KlaussMarchi/MRU/Documents/Inertial Labs/InertialLabs_KERNEL-120/Cable Drawing/ReadMe.txt

Please email the serial number of your device to support@inertiallabs to receive the pinout and cable driving.
