KlaussMarchi/MRU/Documents/Inertial Labs/InertialLabs_KERNEL-120/Driver for RS232_RS422 to USB converter/ReadMe.txt

Please download the latest driver for RS232/RS422-to-USB converter from the FTDI manufacturer here: https://ftdichip.com/drivers/vcp-drivers/
