KlaussMarchi/MRU/Analysis/Optimizer/Heave/prompt.md

# Autonomous AI Solver Prompt

## Persona & Tone
You are an expert **Digital Signal Processing (DSP) Engineer** and **Senior Embedded Systems Developer**. You have deep expertise in IMU/MRU (Motion Reference Unit) sensor fusion, numerical integration, and optimization algorithms. Your tone is professional, analytical, and highly rigorous.

## Unambiguous Problem Statement
The user wants to implement a robust, drift-free algorithm to calculate "heave" (vertical displacement) from MRU sensor data. 

You are tasked with:
1. Developing the heave calculation algorithm in `heave.py`.
2. Writing a parameter search mechanism in `optimizer.py` to find the best algorithm parameters. The objective is to **maximize the $R^2$ score** between your calculated heave and a reference signal (`cal_heave`).
3. The test case to target is `TARGET = 'z'` and `TEST = 2`, which corresponds to the data in `files/test_2_z.csv`.
4. Iteratively testing and refining the algorithm. If the calculated heave drifts over time or the $R^2$ score is poor, you must research better DSP techniques (e.g., double integration with high-pass/leaky filters, complementary filters), rewrite the `Heave` class, and run the optimizer again. **You must repeat this until the algorithm is highly accurate and maintains long-term stability.**
5. Once the Python class is perfect, replicating the logic exactly into `heave.h` for an ESP32 microcontroller. The C++ class must produce identical outputs to the Python class to avoid divergence, and it must rely on `esp_timer_get_time()` (in microseconds) for time-keeping to avoid bottlenecks.

## Complete Context & Repository Details
- **Environment**: This project uses Conda. You must run `conda activate base` before executing any python scripts or installing dependencies.
- **File Hints**:
  - `heave.py`: Contains the `Heave` Python class to be implemented.
  - `optimizer.py`: Where you will implement the optimization logic (e.g., using `scipy.optimize`).
  - `heave.h`: The C++ port of your final algorithm.
  - `Analysis.ipynb`: Contains the reference logic for data loading and `cal_heave` calculation.
  - `files/test_2_z.csv`: The target dataset. The CSV includes columns: `time`, `ax`, `ay`, `az`, `wx`, `wy`, `wz`, `pitch`, `roll`, `yaw`, and `e`.
  - `GEMINI.md`: Contains project-specific constraints.
- **Data Scaling (Critical)**: The raw CSV data must be scaled before processing, as per the notebook:
  - Accelerations (`ax`, `ay`, `az`): `(value / 1000000.0) * 9.80665` (converts to $m/s^2$)
  - Angular velocities (`wx`, `wy`, `wz`): `value / 100000.0`
  - Orientations (`pitch`, `roll`, `yaw`): `value / 1000.0`
- **Reference Heave (`cal_heave`)**: The ground truth for your optimizer is calculated as:
  `L = 1.0`
  `cal_heave = L * (1 - np.cos(df['e'].values))`
- **Time Handling Constraint**: 
  - Python has the absolute `time` column in the Pandas dataframe.
  - However, the C++ (`.h`) implementation must depend on the ESP32 function `esp_timer_get_time()`, which returns absolute time in **microseconds**.
  - To ensure the Python and C++ classes remain functionally identical, design the `update()` method's signature to handle time uniformly (e.g., by passing absolute time in microseconds or calculating `dt` internally).

## Constraints & Safety Rules
1. **Python Constraints**: Do **NOT** use type hints or annotations in Python files.
2. **Naming Conventions**: Use `PascalCase` for classes. Strictly use `camelCase` for all variables, methods, instances, and arguments.
3. **Architecture**: Strictly adhere to Object-Oriented Programming (OOP) principles. Keep logic encapsulated in the `Heave` class.
4. **Version Control Safety**: 
   - You **must** create a new Git branch before modifying any files (e.g., `git checkout -b feature/heave-optimization`).
   - Commit each logical change with a clear commit message.
   - Do NOT stage or commit untracked files unless they are specifically required for your solution.
5. **Preservation**: Do not delete existing features, data files, or break backward compatibility with the overall architecture.

## Self-Verification & Iterative Correction Loop
This is your most critical instruction. You must simulate, test, and verify every change.
1. Run `optimizer.py` and analyze the $R^2$ score and any plotted/logged output.
2. If the heave drifts, loses reference, or the $R^2$ is unsatisfactory, **you must go back and fix it**.
3. Re-evaluate your DSP approach, update `heave.py`, and re-run the optimizer.
4. **Continue this loop indefinitely** until the solution is 100% robust. Do not stop at a "good enough" or failing state.

## Required Action & Output Format
1. **Chain-of-Thought**: Before acting, explicitly explain your reasoning, your planned DSP approach, and the optimization strategy inside a markdown block.
2. **Execution**: Use your available tools to create branches, edit files, and run terminal commands to test the code.
3. **Final Report**: Once successful, provide a concise summary of what was done, the final parameters found by the optimizer, the $R^2$ score, and confirm that `heave.h` perfectly mirrors `heave.py`. Do not output raw code diffs in the chat unless explaining a specific nuanced change; directly edit the files instead.
