KlaussMarchi/MRU/Hardware/Embedded/Main/README.html

Ir para o conteúdo

M MRU Documentação técnica

Navegar pelas seções

Neste documento

Continue a leituraPipeline de calibração ↗

Firmware · processamento embarcado

# Firmware do MRU · ESP32-S3

Este firmware recebe as medições do Kernel-120, aplica os ajustes produzidos pela calibração e transmite orientação, aceleração, giro e movimento vertical por USB, RS232 ou RS422. O ponto de entrada é Main.ino, que identifica a versão atual como v1.0.7.

Imprimir / salvar PDF Abrir Markdown Pipeline de calibração ↗

O pipeline de calibração escolhe filtros e ajusta modelos no computador. Aqui, o ESP32 executa esses modelos sobre as novas amostras, usando os parâmetros compilados em config.h.

## Visão geral

Kernel-120 → UART1 → decodificação → escala → filtros → correção → atitude → heave → braço
                                                                                     │
                                                                                     ▼
                                                                          JSON · LIST · NMEA
                                                                                     │
                                                                                     ▼
                                                                            USB · RS232 · RS422

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

## Estrutura de arquivos

Main/
├── Main.ino                         ← setup() e loop() do Arduino
├── device/
│   ├── index.h                     ← reúne e inicializa os módulos
│   ├── settings/index.h            ← configurações persistentes
│   └── tasks/index.h               ← laços de processamento e comunicação
├── globals/
│   ├── constants.h                 ← números que identificam modos e protocolos
│   └── functions.h                 ← função de exemplo, sem papel na cadeia de medição
├── objects/
│   ├── sensors/
│   │   ├── index.h                 ← gerencia o sensor
│   │   └── Kernel/
│   │       ├── index.h             ← conexão, configuração e recepção do Kernel
│   │       ├── HR/index.h          ← pacote de alta resolução
│   │       ├── quat/index.h        ← pacote de quaternion
│   │       └── orient/index.h      ← pacote de orientação
│   ├── processing/
│   │   ├── index.h                 ← executa a sequência de cálculo
│   │   ├── filters/                ← passa-baixa de cada eixo
│   │   ├── correction/             ← matriz, viés e temperatura
│   │   ├── align/                  ← adapta a correção ao align atual
│   │   ├── attitude/
│   │   │   ├── config.h            ← seleciona o modelo compilado
│   │   │   ├── kalman/             ← fusão de acelerômetro e giroscópio
│   │   │   ├── linear/             ← correção linear dos ângulos do Kernel
│   │   │   └── machine/            ← regressão sobre uma janela de sensores
│   │   ├── heave/                  ← movimento vertical do sensor
│   │   └── lever/                  ← movimento vertical no ponto de interesse
│   ├── telemetry/
│   │   ├── index.h                 ← coordena comandos, respostas e transmissão
│   │   ├── serial/index.h          ← portas USB, RS232 e RS422
│   │   ├── protocol/index.h        ← interpretação dos comandos
│   │   └── streamer/index.h        ← formato e cadência das amostras transmitidas
│   ├── components/                 ← LEDs e encoder
│   └── updater/index.h             ← atualização do firmware pela serial
├── utils/                          ← texto, JSON, relógios e estruturas auxiliares
└── build/                          ← artefatos de compilação, quando gerados

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

## O que acontece ao ligar

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

## Como uma amostra atravessa o firmware

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

### 1 · Kernel — conexão, pacote e escala

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

O firmware também lê os três ângulos de Alignment_Angles. Para aplicar mudanças persistentes do Kernel, siga o procedimento de desligar e ligar o MRU descrito no guia geral; reiniciar somente o ESP32 não corta a alimentação do sensor.

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

### 2 · Filters — aplicar os filtros escolhidos na calibração

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

### 3 · Correction e Align — corrigir a leitura no referencial certo

correction/index.h aplica, separadamente ao acelerômetro e ao giroscópio:

x_corrigido = M·x + c + k·(T−T0)

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

### 4 · Attitude — o modelo escolhido em tempo de compilação

objects/processing/attitude/config.h inclui um modelo e define o apelido AttitudeModel. Na configuração atual, ele seleciona KalmanModel. Para trocar de estratégia, exporte a desejada no pipeline de calibração e recompile.

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

### 5 · Heave — aceleração vertical para deslocamento

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

### 6 · Lever — movimento no ponto de interesse

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

### 7 · Telemetria — origem, formato e frequência

Há três seleções independentes:

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

## Campos transmitidos

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

O formato chamado NMEA no código contém quatro campos:

$GPPASHR,pitch,roll,yaw,heave*checksum

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

## Portas, comandos e configurações

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

Comando | Efeito
$stream_start! / $stream_stop! | Inicia ou interrompe a transmissão.
$settings! | Mostra as configurações persistidas.
ID:chave$ | Consulta um valor salvo; resposta no formato $valor!.
CF:chave$valor! | Salva uma configuração e reinicia o ESP32.
$calibrate! | Informa o processamento ativo; não executa uma nova calibração.
$check_sensor! | Informa OK ou NOT WORKING, conforme o estado do driver.
$firmware! | Informa a versão.
$align:N! | Grava no Kernel o preset de montagem N e reinicia os estados do processamento.
MICRS | Reinicia o ESP32.
$ERASE! | Restaura configurações padrão e reinicia.
updt | Entra no recebimento de uma atualização de firmware.

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

O exemplo escolhe LIST a 10 Hz. Os comandos CF: alteram a operação; os coeficientes de calibração continuam vindo dos config.h.

## Montagem e presets de align

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

Escolha o preset correspondente à montagem física, desligue e ligue o MRU e confira a linha Kernel Align no boot. O guia de instalação descreve as posições e os sentidos dos eixos. A referência do ensaio deve estar registrada em Calibration/Dataset/testN/info.json antes de exportar Correction.

## Parâmetros que vêm da calibração

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

Uma nova exportação substitui esses arquivos. Recompile e grave o firmware para usar os novos parâmetros. Na instalação, confira principalmente HEAVE_PERIOD, KALMAN_LEVER e LEVER_POINT: os valores ajustados na mesa descrevem aquele ensaio e sua geometria.

## Compilação e gravação

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

No boot, confira modo do dispositivo, baud e modo do Kernel, align, modelo de processamento e modo do Streamer. O README geral reúne a configuração de placa e o procedimento operacional do projeto.

## Componentes, utilitários e atualização

Arquivo/pasta | Papel
components/leds/index.h | Controla os tempos ligado/desligado dos LEDs. LED 1 alterna a cada 0,5 s com Kernel funcionando; LED 2 alterna a cada 0,2 s com stream ativo.
components/encoder/ | Conta pulsos por interrupção e converte para ângulo. Está desabilitado no Main.ino; seus pinos 10/11 são usados pelo RS232.
utils/time/ e utils/listener/ | Fornecem relógios e verificações periódicas sem usar um atraso fixo em cada iteração.
utils/text/ | Buffers de texto usados na leitura e interpretação dos comandos.
utils/json/ | Serialização com ArduinoJson e persistência com Preferences.
utils/array/ | Vetor circular, estatísticas e persistência auxiliares. Não executa a filtragem principal.
utils/notes/ | Utilitário de arquivos em LittleFS, sem integração na cadeia ativa de Device.
objects/updater/index.h | Recebe o binário codificado em base64 pela porta ativa e o grava com a biblioteca Update.

O atualizador começa com updt, responde __STARTING_UPDATE__ e espera blocos no formato $base64!. Cada escrita produz __WRITTEN__; dez segundos sem dados encerram a recepção, e uma finalização bem-sucedida reinicia o ESP32. É uma transferência serial, sem etapa de download pela rede.

## Comportamentos importantes para interpretar os resultados

- As tarefas compartilham o estado mais recente. A implementação não possui uma fila de amostras entre recepção, processamento e transmissão. Se várias amostras chegarem antes do consumo, estados intermediários podem não ser processados ou enviados; aquisição não constitui garantia de gravação sem perdas.
- As lacunas recebem tratamentos diferentes. O Kalman limita o passo de propagação e aumenta a incerteza de inclinação quando o intervalo supera três períodos nominais; Heave e Lever reiniciam suas seções acima de 0,5 s.
- O estado working não é um teste de atualização contínua. O driver o altera ao decodificar pacotes, mas o silêncio da UART não o limpa por tempo de inatividade. $check_sensor! e LED 1 devem ser interpretados junto com a chegada de novas amostras.
- O código atual não inclui a etapa de relatório NORMAM do diagrama antigo. A cadeia entrega medições e movimento no ponto de interesse; a avaliação e o certificado descritos no pipeline ficam no computador.

MRU / Hardware/Embedded/Main Voltar ao início ↑
