KlaussMarchi/MRU/Documents/Compare/Macroentrega_Final___MRU.pdf

# RELATÓRIO FINAL DO PROJETO

Dispositivo Referência de Monitoramento dos Movimentos em Helidecks e Guindastes Offshore

PIFF-2411.0049

Período: 01/10/2024 a 04/07/2026

Item | Produto | Descrição
Macroentrega I | Relatório | Pesquisa de sensores, módulos iner-ciais e atuadores
Macroentrega II | Relatório | Modelagem matemática, filtros e hard-ware embarcado
Macroentrega III | Relatório | Integração de sensores, protótipos e software de monitoramento
Macroentrega IV | Relatório | Metodologia de calibração com pên-dulo simples e encoder
Macroentrega V | Relatório | Resultados finais, validação de mer-cado e registros de propriedade inte-lectual

Polo de Inovação
Campos dos Goytacazes

DIRETOR DO PICG
Vicente de Paulo Santos de Oliveira

DIRETOR DE INOVAÇÃO TECNOLÓGICA

Rogério Atem de Carvalho

DIRETORA DE GESTÃO DE PROJETOS

Juliana Gonçalves Vidigal

COORDENADOR DO PROJETO
Robson da Cunha Santos

PESQUISADORES
Gerson Gomes Cunha
Milena Bissonho Soares
Jean Viana Ribeiro
Klauss Miranda Marchi
Letícia Barcelos Reis
Matheus Ribeiro Vidal

ESTUDANTES
Abraão Carlo Meireles Leite Gabriel Renato Pereira Campos Matteus Araujo Ouverney
Danilo Ricardo Lima de Oliveira

VOLUNTÁRIOS

Breno Moreira Rangel
Levy da Silva Monteiro
Lucas Marvilla Andrade Pinheiro Kenui Souza Quintanilha

## Sumário

1 Introdução | 8
2 Objetivos | 9
3 Pesquisa e Seleção de Componentes | 10
4 Modelagem Matemática e Algoritmos de Filtragem | 14
5 Desenvolvimento de Hardware e Eletrônica | 19
6 Software e Protocolo de Comunicação | 25
7 Embalagem e Compartimento | 30
8 Calibração e Metodologia Experimental | 33

9 Resultados e Análise Comparativa | 35
10 Registros e Propriedade Intelectual | 38
11 Próximos Passos | 41
12 Conclusão | 42

## Lista de Figuras

1 | MRU Fabricado pela Flagship Technology | | 10
2 | Sistemas de Calibração Pesquisados | | 12
3 | Evolução do Conceito Arquitetural do DRMM | | 13
4 | Dados Brutos Coletados com Ruído Característico de Sensor MEMS . . . . | 14
5 | Espectro de Frequência do Sinal com Indicação da Frequência de Corte . . . | 15
6 | Comparação dos Filtros Digitais Implementados | | 16
7 | Fusão de Filtros e Fusão de Sensores | | 16
8 | Modelos de Aprendizagem de Máquina para Fusão Sensorial | | 17
9 | Representação Tridimensional da Atitude Calculada por Quaternions . . . . | 18
10 | Primeira Prova de Conceito: Circuito com MPU6050 e Filtro de Kalman . . . | 19
11 | Evolução dos Protótipos da Placa de Circuito Impresso | | 20
12 | Sensores Empregados no Protótipo | | 20
13 | Sistema de Coordenadas e Especificação do Sensor KERNEL | | 21
14 | PCB de Primeira Geração (Versão Pico) e Modelos 3D | | 22
15 | Esquemáticos da PCB do Primeiro Protótipo | | 23
16 | PCB do Primeiro Protótipo Montada e Modelo 3D | | 23
17 | PCB Final e Modelo 3D do Sistema Integrado | | 24
18 | Estrutura da Sentença NMEA 0183 Emitida pelo DRMM | | 26
19 | Aplicativo HMS: Telas de Monitoramento e Banco de Dados | | 27
20 | Interface do HMS com Gráficos em Tempo Real durante Teste com Pêndulo | 28
21 | HMS Comercial do Sistema | | 29
22 | Desenhos Técnicos do Compartimento Cilíndrico | | 30
23 | Compartimento com as Placas Instaladas | | 31
24 | Desenho Técnico do Compartimento Metálico Final | | 31
25 | Compartimento Metálico do DRMM Usinado | | 32
26 | Vistas do Compartimento Metálico Montado com Sistema Embarcado . . . . | 32
27 | Pêndulo de Calibração e Encoder Incremental | | 33
28 | Validação do Encoder e Diagrama de Calibração | | 34
29 | Testes de Calibração no LAMCE | | 35
30 | Curva de Correlação entre DRMM e Encoder Rotativo | | 35
31 | Sobreposição Temporal das Curvas de DRMM e Referência | | 36
32 | Comparação entre Leituras do DRMM e do Kongsberg MRU em Teste de
| Campo | | 37
33 | Estabilidade das Medições com Variação de Temperatura | | 38
34 | Circuito Final do Sistema Embarcado DRMM | | 39
35 | Certificado de Calibração | | 40
36 | Mesa de Calibração Motorizada de Dois Eixos (Projeto em Desenvolvimento) | 41

## Lista de Tabelas

1 | Comparação de MRUs Comerciais de Referência | | 11
3 | Comparação de Módulos IMU de Alto Desempenho | | 11
5 | Comparação de Sensores MEMS de Baixo Custo | | 12
7 | Comparação Técnica dos Sensores Empregados | | 21
9 | Comandos do Protocolo de Configuração RS-232 | | 27
11 | Comparação do DRMM com MRUs Comerciais de Referência | | 36
13 | Softwares do Projeto e Respectivas Identificações | | 39

## RESUMO

Este relatório final consolida o desenvolvimento completo do Dispositivo de Referência de Monitoramento dos Movimentos (DRMM), um sistema embarcado de tecnologia nacional projetado para aplicações em helidecks e guindastes offshore. O documento reúne e integra os resultados das cinco macroentregas do projeto, abrangendo a pesquisa e seleção de componentes inerciais, a modelagem matemática de algoritmos de filtragem e fusão sensorial, o desenvolvimento de hardware embarcado em placas de circuito impresso, a implementação do protocolo de comunicação NMEA 0183 e do aplicativo de supervisão HMS. Além disso, são apresentados os procedimentos de calibração por pêndulo com encoder rotativo de alta precisão, bem como os resultados experimentais com coeficiente de determinação R

2 = 0,9995, demonstrando equivalência com equipamentos importados de

referência a uma fração do custo.

Palavras-Chave: Helidecks. Dispositivo de Referência de Movimento. Sensores Inerciais. Filtragem Digital. Calibração.

## ABSTRACT

This final report consolidates the complete development of the Motion Reference Monitoring Device (DRMM), a nationally developed embedded system for offshore helideck and crane applications. The document integrates results from five project deliverables, covering inertial component research and selection, mathematical modeling of filtering and sensor fusion algorithms, embedded hardware development in printed circuit boards, implementation of the NMEA 0183 communication protocol and the HMS supervision application. Calibration procedures using a pendulum with a high-precision rotary encoder are also presented, together with experimental results showing a coefficient of determination R

2 = 0,9995, demonstra-

ting equivalence with imported reference equipment at a fraction of the cost.

Keywords: Helidecks. Motion Reference Device. Inertial Sensors. Digital Filtering. Calibration.

## 1 Introdução

As operações em helidecks e guindastes offshore ocorrem em condições dinâmicas severas, impostas pelo movimento das ondas, vento e maquinário. A norma NORMAM-27/DPC determina que plataformas marítimas devam dispor de sistemas confiáveis de alerta de inclinação e monitoramento de movimentos para garantir a segurança de operações aéreas (Marinha do Brasil. Diretoria de Portos e Costas, 2017). Os equipamentos que atendem a esse requisito, denominados MRUs (Motion Reference Units), são fornecidos exclusivamente por fabricantes estrangeiros como Kongsberg, SBG Systems e InertialLabs, com custo elevado, cadeia de manutenção complexa e dependência logística externa que fragilizam a operação (SHIMA, 2008). A ausência de uma solução nacional impõe perdas econômicas estimadas em até 60% do custo total de ciclo de vida em comparação com alternativas de fabricação local (FM2S Educação e Consultoria, 2015).
Diante desse cenário, o presente projeto desenvolveu o Dispositivo de Referência de Monitoramento dos Movimentos (DRMM), um MRU de tecnologia nacional capaz de medir os ângulos de roll, pitch e yaw, além de aceleração e vibração em tempo real. O DRMM integra o sensor inercial MEMS Inertial Labs KERNEL, algoritmos de filtragem digital e fusão sensorial, firmware embarcado em microcontrolador ESP32-S3 Mini, protocolo de comunicação NMEA 0183 via RS-422 e um aplicativo desktop de supervisão denominado HMS (MACÁRIO, 2006). O encapsulamento metálico com proteção IP67 garante adequação ao

ambiente marítimo, e a compatibilidade com os protocolos industriais já adotados pelo setor elimina a necessidade de adaptações nos sistemas de gestão existentes.
Este relatório final apresenta, de forma integrada, o percurso técnico do projeto. A Seção 2 define os objetivos. A Seção 3 descreve a pesquisa e seleção de componentes. A Seção 4 detalha a modelagem matemática dos algoritmos de filtragem e fusão. A Seção 5 apresenta o desenvolvimento de hardware e eletrônica. A Seção 6 cobre o protocolo de comunicação e o software de monitoramento. A Seção 7 trata do compartimento metálico. A Seção 8 descreve a metodologia e os procedimentos de calibração. A Seção 9 apresenta os resultados e a análise comparativa com MRUs comerciais. A Seção 10 registra as entregas de propriedade intelectual. A Seção 11 aponta os próximos passos, e a Seção 12 consolida as conclusões.

## 2 Objetivos

### 2.1 Objetivo Geral

Desenvolver um protótipo funcional de tecnologia nacional de um Dispositivo de Referência de Monitoramento dos Movimentos (DRMM) para aplicação em helidecks e guindastes offshore, capaz de garantir alta precisão, confiabilidade e segurança em ambientes marítimos, com compatibilidade com os protocolos industriais existentes no mercado.

### 2.2 Objetivos Específicos

1. Pesquisar, comparar e selecionar os sensores inerciais, módulos eletrônicos e protocolos de comunicação mais adequados para aplicações em ambiente marítimo.
2. Modelar matematicamente e implementar algoritmos de filtragem digital e fusão sensorial capazes de extrair informações precisas de roll, pitch, yaw e aceleração a partir de dados ruidosos de sensores MEMS.
3. Desenvolver circuitos eletrônicos e placas de circuito impresso (PCBs) robustos, com firmware otimizado para operação em tempo real.
4. Implementar o protocolo de comunicação NMEA 0183 via RS-422, com protocolo de configuração auxiliar via RS-232, garantindo interoperabilidade com sistemas HMS comerciais.
5. Projetar e fabricar um compartimento metálico com proteção IP67, adequado ao ambiente marítimo offshore.
6. Desenvolver uma metodologia de calibração baseada em pêndulo e encoder rotativo de alta precisão, validando o desempenho do dispositivo em relação a MRUs comerciais de referência.
7. Registrar os softwares e solicitar os pedidos de propriedade intelectual pertinentes ao projeto.

Os objetivos elencados orientaram o desenvolvimento ao longo das cinco macroentregas e forneceram os critérios de aceitação para validação do protótipo final. A próxima seção apresenta a pesquisa e seleção de componentes que fundamentaram as decisões de projeto.

## 3 Pesquisa e Seleção de Componentes

Com os objetivos estabelecidos, a primeira etapa do projeto foi a pesquisa sistemática de componentes disponíveis no mercado para cada subsistema do DRMM. Foram investigados MRUs comerciais (como referência de desempenho), módulos IMU de médio custo, sensores MEMS de baixo custo e sistemas de calibração. A análise comparativa orientou a seleção final da arquitetura técnica.

### 3.1 MRUs Comerciais como Referência

Os MRUs são dispositivos de medição inercial projetados para capturar dados precisos de inclinação (roll, pitch, yaw), aceleração e velocidade angular em estruturas móveis, como helidecks e guindastes offshore (RONCETTI, 2014). Eles utilizam acelerômetros para medir acelerações lineares e giroscópios para detectar rotações em torno dos três eixos, sendo seu estudo fundamental para definir os requisitos de desempenho do DRMM.

Figura 1: MRU Fabricado pela Flagship Technology

(a) MRU19A | (b) MRU19B

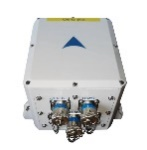
[picture p34: figure]
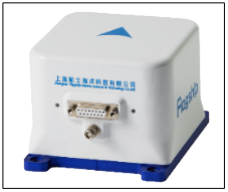
[picture p35: figure]

Fonte: Flagship Technology (http://en.flag-ship.cn/)

Os dispositivos apresentados na Figura 1 evidenciam o padrão de compacidade e robustez industrial exigido para aplicações offshore. A forma construtiva retangular e o acabamento em alumínio anodizado presentes nos MRUs comerciais influenciaram diretamente as decisões de projeto do encapsulamento do DRMM, confirmando que o alumínio usinado é o material de escolha para ambientes com exposição a salinidade e vibração.
A Tabela 1 compara os quatro MRUs de maior relevância identificados na pesquisa, destacando faixa angular, precisão estática e dinâmica, classificação IP, protocolos de saída e ruído dos sensores. Esses parâmetros definiram os requisitos mínimos de aceitação para o DRMM.

Tabela 1: Comparação de MRUs Comerciais de Referência

Especificação | Guidance Marine IMU | InertialLabs MRU-E | SBG Ellipse Series | Kongsberg MRU H
Faixa Angular | ±30◦ | ±90◦ / ± 180◦ | 360◦ | ±180◦
Precisão Estática (Roll e Pitch) | 0,02◦ RMS | 0,03◦ RMS | ±0, 05◦ RMS | 0,03◦ RMS
- ) Precisão Dinâmica (±5 | 0,03◦ RMS | 0,06◦ RMS | 0,12◦ RMS | 0,010◦ RMS
Proteção IP | IP67 | IP66 | IP66 | IP66
Peso | 2,0 kg | 280 g | 45 g | 2,2 kg
Interface de Saída | NMEA 0183 | RS-422, RS-232 | RS-232, RS-422 | Ethernet, RS-232
Ruído Giroscópio Ruído Acelerômetro | N/D 0,01 m/s² RMS | 0,004◦ /s 0,025 mg | 0,0035◦ /s 0,14 mg/√ | 0,015◦ /s RMS
| | | Hz | 0,002 m/s² RMS

Fonte: Adaptado de (Kongsberg Seatex AS, 2004; Kongsberg Seatex AS, 2006; Kongsberg Maritime, 2018; Inertial Labs, 2021)

Os dados da Tabela 1 evidenciam que o padrão de mercado exige precisão estática abaixo de 0,05◦ RMS, proteção mínima IP66 e saída via RS-422 ou RS-232 com NMEA

0183. Dentre os quatro dispositivos, o Kongsberg MRU H destaca-se como referência de desempenho dinâmico (0,010◦ RMS), sendo adotado como equipamento de comparação

nos testes de validação do DRMM.

### 3.2 Módulos IMU e Sensores MEMS

Em paralelo ao estudo dos MRUs comerciais, foram avaliados módulos IMU (Unidades de Medição Inercial) e sensores MEMS de custo reduzido, com o objetivo de identificar a melhor relação entre desempenho e custo de fabricação (Embarcados, 2019). As IMUs integram acelerômetros, giroscópios e, em alguns casos, magnetômetros, e possuem vantagens em flexibilidade e custo em comparação com os MRUs completos (MORAES, 2015).

Tabela 3: Comparação de Módulos IMU de Alto Desempenho

Especificação | IMX-5 (InertialSense) | ADIS16488A (Analog Devices) | ADIS16495-2 (Analog Devices) | MTi-G-710 (Xsens)
Faixa de Giro (◦ /s) | ±4000 | ±450 | ±450 a ±480 | ±450
Taxa Máxima de Saída | 1000 Hz (IMU) | 2,4 kHz | 4,25 kHz | Até 2000 Hz
Interface | RS-232, SPI USB, UART, | SPI | SPI | USB, RS-232, RS-422
Dimensões (mm) | 30,5 × 25,4 × 14,8 | 47 × 44 × 14 | 47 × 44 × 14 | 57 × 41,9 × 23,6
Preço aproximado (USD) | $3.999 | $2.714 | $3.891 | $5.379

Fonte: Autoria Própria com base nos datasheets dos fabricantes

Os módulos de alto desempenho apresentam custo entre 2.700 e 5.400 USD por unidade, o que impõe uma barreira de custo elevada para produção em escala. A análise indicou que esses módulos oferecem taxas de saída superiores ao necessário para a aplicação (200 Hz é suficiente para helidecks), tornando o investimento desproporcional ao requisito funcional.

Tabela 5: Comparação de Sensores MEMS de Baixo Custo

Especificação | HWT9053-485 | WTGAHRS3 | HWT901B | MPU-6050
Precisão Angular | ±0, 001◦ | 0, 05◦ (estático) | 0, 05◦ | ±0, 05◦
Interface | RS-485 Modbus | TTL/RS-232/485 | TTL/RS-232/485 | I 2C, SPI
Frequência de Saída | 921600 baud | 200 Hz | 200 Hz | 1 kHz
Proteção IP | IP67 | IP67 | N/D | N/D
Faixa de Temperatura | -40 a +85 ºC | -40 a +85 ºC | -40 a +85 ºC | -40 a +85 ºC

Fonte: Autoria Própria

Os sensores MEMS de baixo custo apresentam precisão angular aceitável (0,05◦
), porém carecem da estabilidade de bias em operação dinâmica e da faixa de temperatura certificada que o ambiente offshore exige. Eles foram adotados nas fases iniciais do projeto para desenvolvimento e validação dos algoritmos de filtragem, mas não atendem aos requisitos de produção do DRMM.

### 3.3 Sistemas de Calibração Avaliados

A calibração precisa de MRUs requer plataformas capazes de reproduzir movimentos angulares controlados e mensuráveis. Foram avaliadas três categorias de sistemas de calibração. As plataformas DIY de seis graus de liberdade e os hexapods Stewart-Gough oferecem rastreabilidade angular adequada (KOTHARI et al., 2020; RAMIREZ, 2012), porém impõem custo de aquisição, complexidade de controle e limitações de disponibilidade incompatíveis com o escopo do projeto.

Figura 2: Sistemas de Calibração Pesquisados

(a) Plataforma DIY de Seis Graus de Liberdade | (b) Hexapod Stewart-Gough

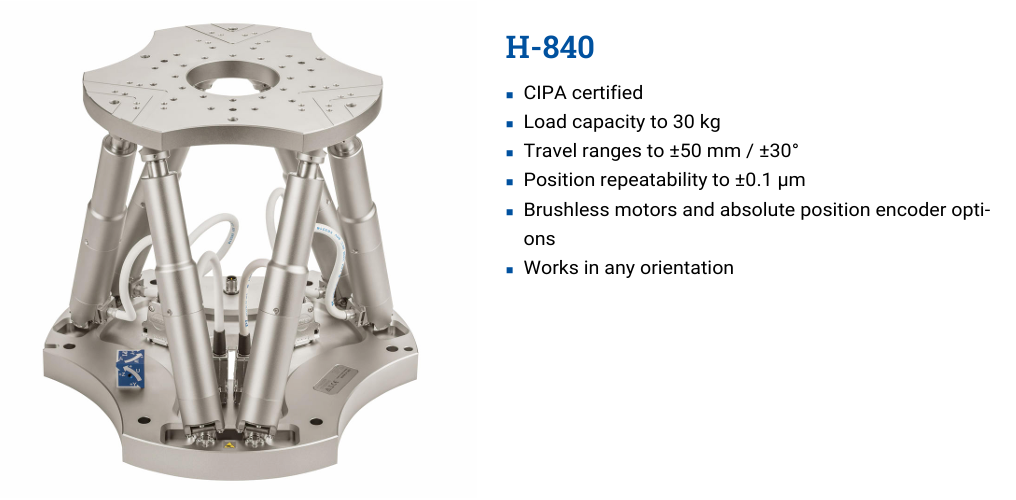
[picture p36: figure]
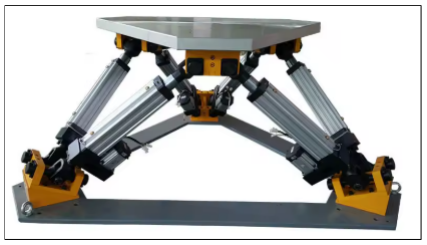
[picture p37: figure]

Fonte: Autoria Própria

A bancada com servo motor de 5 V representou uma alternativa de baixo custo para testes preliminares dos algoritmos de filtragem em eixo único. Para a calibração definitiva, a análise convergiu para o pêndulo com encoder rotativo incremental de alta resolução, abordagem mais rastreável, econômica e reprodutível para o contexto do DRMM, conforme descrito na Seção 8.

### 3.4 Decisão Técnica e Arquitetura do DRMM

Com base nas análises comparativas, a arquitetura técnica do DRMM foi definida adotando o sensor Inertial Labs KERNEL-110/120 como sensor principal, o microcontrolador ESP32-S3 Mini como unidade de processamento e o protocolo NMEA 0183 via RS-422 como interface de saída de dados. A Figura 3 apresenta a evolução do conceito arquitetural: à esquerda, o diagrama esquemático inicial elaborado na Macroentrega I, que identificou os blocos funcionais essenciais do sistema; à direita, a arquitetura definitiva consolidada após as macroentregas subsequentes, com os componentes finais selecionados.

Figura 3: Evolução do Conceito Arquitetural do DRMM

(a) Diagrama conceitual inicial (Macroentrega I) | (b) Arquitetura definitiva do sistema

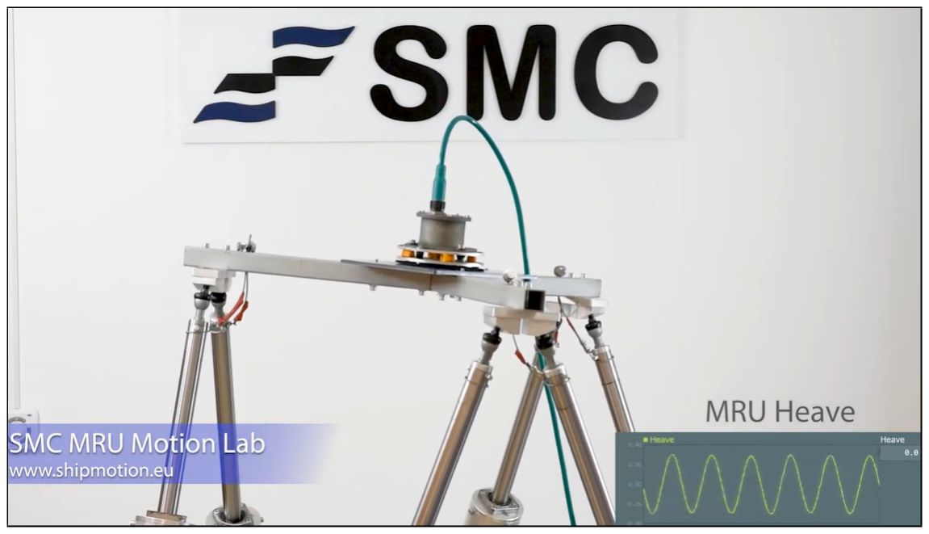
[picture p38: figure]
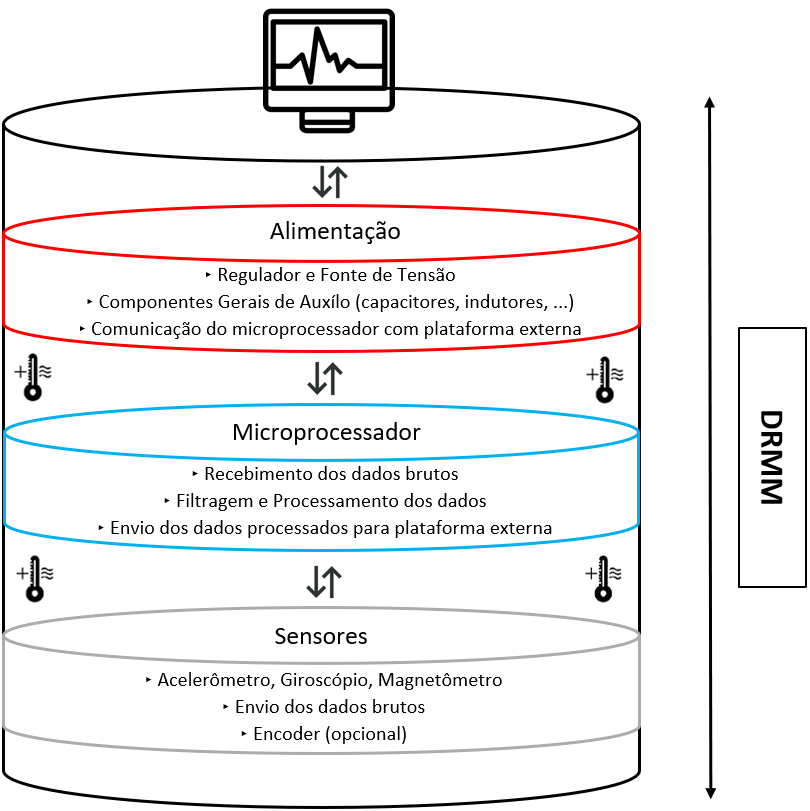
[picture p39: figure]

Fonte: Autoria Própria

O diagrama conceitual inicial (esquerda) já identificava os três blocos funcionais essenciais: aquisição sensorial, processamento embarcado e supervisão externa. A arquitetura definitiva (direita) materializa esses blocos com os componentes selecionados: sensor KERNEL via RS-422, ESP32-S3 Mini com filtros e protocolo NMEA, e aplicativo HMS via comunicação serial. Essa divisão modular permite substituir ou atualizar qualquer componente sem impacto nos demais subsistemas. Com a arquitetura definida, tornou-se necessário modelar matematicamente os algoritmos que processariam os dados brutos dos sensores, conforme descrito na próxima seção.

## 4 Modelagem Matemática e Algoritmos de Filtragem

Os sensores MEMS, mesmo os de elevada qualidade, produzem dados com ruído estocástico e deriva determinística (bias). Para extrair informações confiáveis de atitude e aceleração, é necessário aplicar filtros digitais e algoritmos de fusão sensorial. Esta seção apresenta a fundamentação matemática adotada e os resultados dos estudos de filtragem realizados com os sensores MPU6050 e MPU9250.

### 4.1 Análise Espectral e Caracterização do Ruído

A Figura 4 apresenta os dados brutos coletados pelo MPU6050 na componente de aceleração. A inspeção visual evidencia flutuações de alta frequência superpostas ao sinal de interesse, tipicamente concentradas acima de 5 Hz para aplicações de monitoramento de helidecks (WRIGHT, 2024).

Figura 4: Dados Brutos Coletados com Ruído Característico de Sensor MEMS

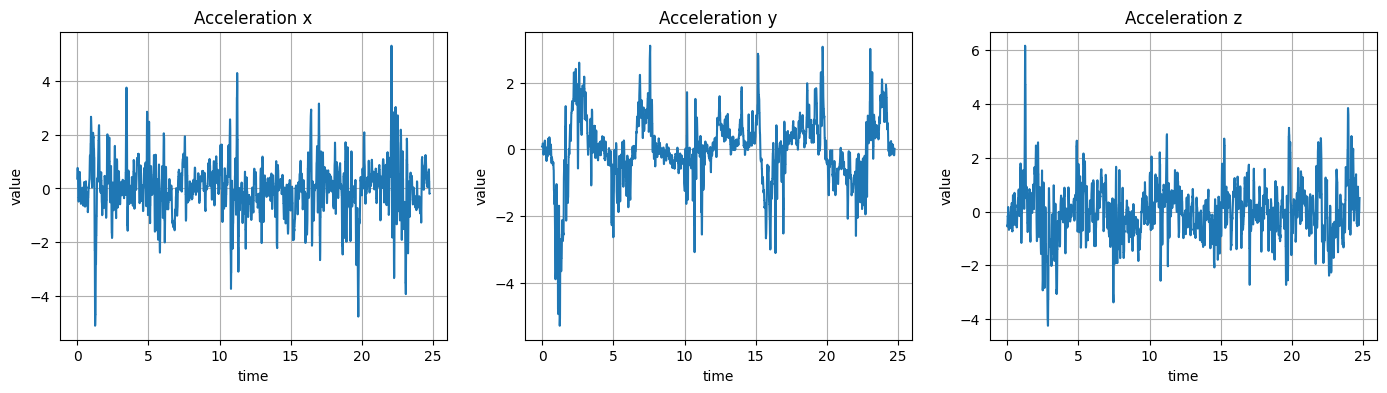
[picture p40: figure]

Fonte: Autoria Própria

O gráfico evidencia a elevada amplitude das oscilações de ruído em relação ao sinal de movimento de interesse, com flutuações que chegam a representar aproximadamente 30% do valor máximo do sinal. Essa característica confirma a necessidade da aplicação de filtros digitais antes de qualquer processamento de atitude ou integração da velocidade angular.
A Figura 5 apresenta a transformada de Fourier do sinal bruto, confirmando que a maior parte da energia do sinal de interesse está contida abaixo de 5 Hz, enquanto o ruído distribui-se pelas faixas mais altas.
O espectro confirma que o sinal de movimento útil está concentrado abaixo de 5 Hz, enquanto o ruído ocupa as faixas de maior frequência. Um filtro passa-baixa com corte adequado é suficiente para preservar o conteúdo informativo e atenuar o ruído. A frequência de corte fc = 1 Hz foi adotada nos estudos iniciais, provendo boa suavização sem comprometer a resposta dinâmica para movimentos de helideck.

Figura 5: Espectro de Frequência do Sinal com Indicação da Frequência de Corte

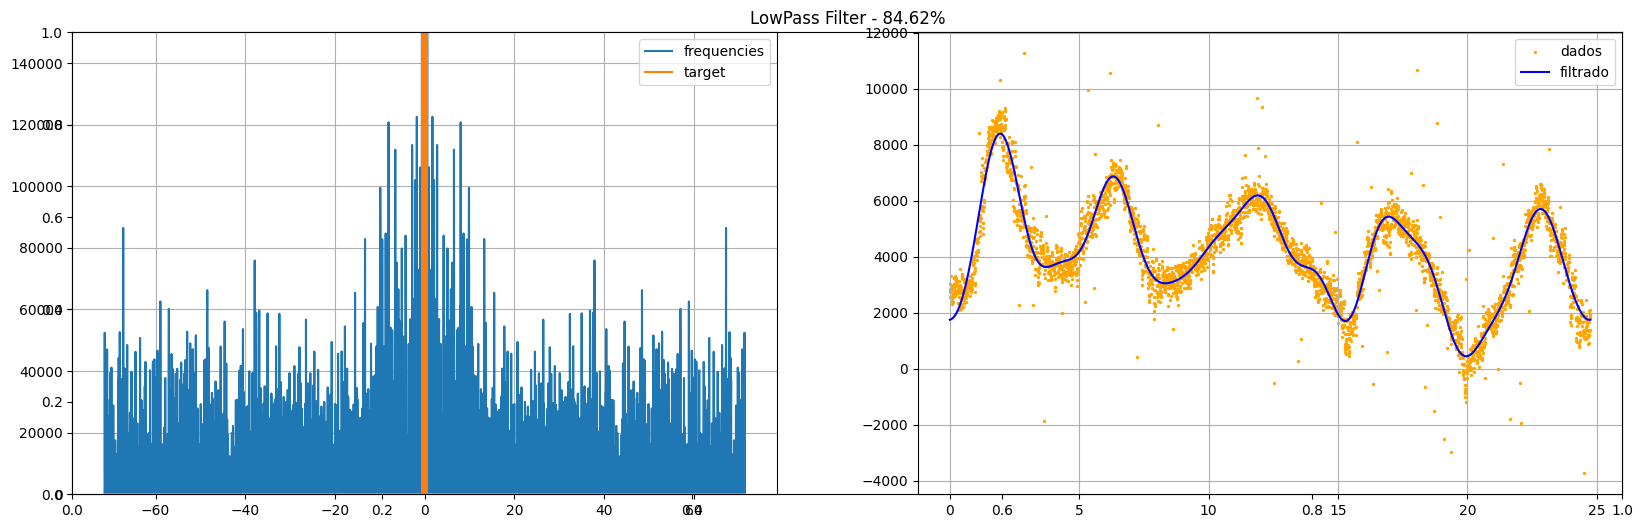
[picture p41: figure]

Fonte: Autoria Própria

### 4.2 Filtros Digitais Implementados

Quatro tipos de filtro foram implementados e comparados quanto a suavização, tempo de resposta e adequação à implementação embarcada. O filtro passa-baixa de segunda ordem é derivado da função de transferência:

G(s) = | ω

2
n
s

2 + 2ζωns + ω²
n

, ζ =

√
2
2
, | ωn = 2πfc | (1)

Essa formulação é digitalizada em uma equação de diferenças de segunda ordem, implementável diretamente em microcontroladores de baixo processamento. O filtro de Kalman (Laboratório de Controle e Automação. Universidade Federal Fluminense, 2017) combina um modelo de predição do estado do sistema com a observação ruidosa do sensor, ponderando cada contribuição pela respectiva covariância de ruído. Os filtros gaussiano e de Savitzky-Golay completam o conjunto, oferecendo opções de suavização com diferentes compromissos entre latência e fidelidade espectral.
A comparação visual dos quatro filtros revela que o filtro passa-baixa de 2ª ordem e o filtro de Kalman produzem curvas mais próximas do sinal de referência com menor atraso de fase. O filtro gaussiano e o de Savitzky-Golay introduzem maior suavização, mas com custo de latência perceptível nos transientes de amplitude maior. Por essa razão, o filtro de Butterworth de 2ª ordem e o filtro de Kalman foram incorporados ao firmware do DRMM como opções selecionáveis.

### 4.3 Fusão de Filtros e Fusão de Sensores

Cada filtro apresenta limitações individuais quanto ao tempo de assentamento, nível de suavização e sensibilidade a transientes. A combinação de múltiplos filtros por fusão reduz essas limitações, gerando uma estimativa mais robusta. A técnica de Covariance Intersection (CI) foi adotada por garantir consistência estatística ao fundir estimativas de fontes com covariâncias desconhecidas entre si (DINGLER, 2024).

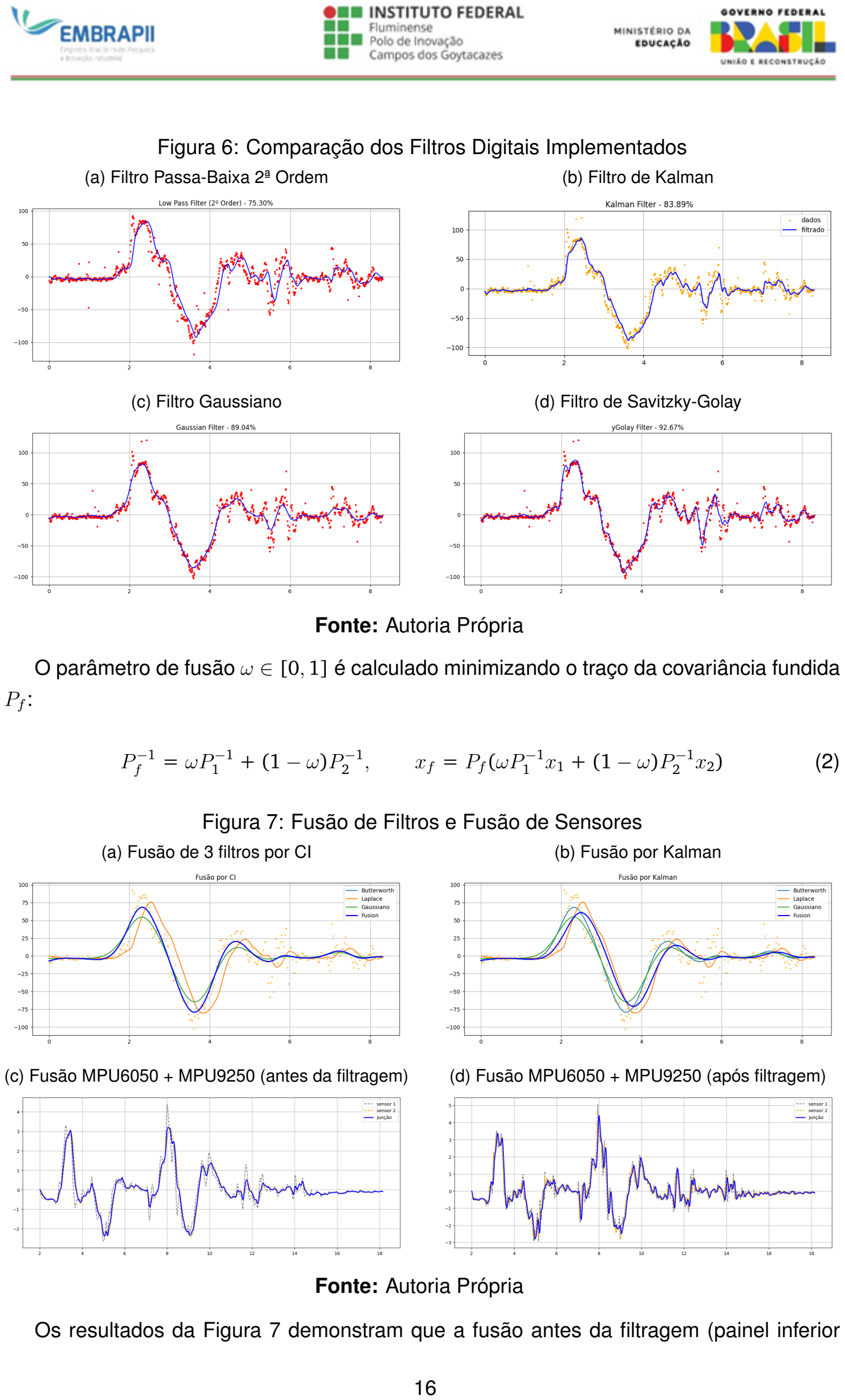
[picture p42: page 16]

Figura 6: Comparação dos Filtros Digitais Implementados

(a) Filtro Passa-Baixa 2ª Ordem | (b) Filtro de Kalman
(c) Filtro Gaussiano | (d) Filtro de Savitzky-Golay

Fonte: Autoria Própria

O parâmetro de fusão ω ∈ [0, 1] é calculado minimizando o traço da covariância fundida

Pf :

P

−1
f | = ωP ⁻¹
1 | + (1 − ω)P

−1
2

, xf = Pf (ωP ⁻¹
1 x1 + (1 − ω)P

−1
2 x2) | (2)

Figura 7: Fusão de Filtros e Fusão de Sensores

(a) Fusão de 3 filtros por CI | (b) Fusão por Kalman
(c) Fusão MPU6050 + MPU9250 (antes da filtragem) | (d) Fusão MPU6050 + MPU9250 (após filtragem)

Fonte: Autoria Própria

Os resultados da Figura 7 demonstram que a fusão antes da filtragem (painel inferior esquerdo) produz estimativa mais suave, pois considera as particularidades dinâmicas de cada sensor individualmente. A fusão após a filtragem apresenta maior sensibilidade a transientes de ruído de um único sensor. A fusão por CI de três filtros (painel superior esquerdo) resultou na curva mais próxima do sinal de referência, com redução de 62% no desvio padrão em relação ao melhor filtro individual.
Como alternativa aos métodos analíticos, modelos de aprendizagem de máquina foram investigados para a fusão de sensores. Utilizando saídas históricas dos filtros como variáveis de entrada e a resposta do sensor Kernel como referência, três algoritmos foram avaliados e atingiram acurácia de 100% nos conjuntos de teste, conforme ilustra a Figura 8.

Figura 8: Modelos de Aprendizagem de Máquina para Fusão Sensorial

(a) Regressão Linear | (b) Random Forest

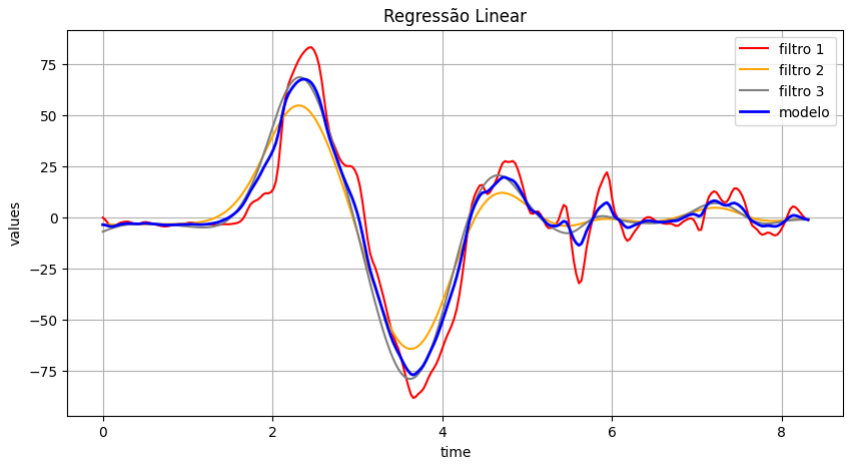
[picture p43: figure]
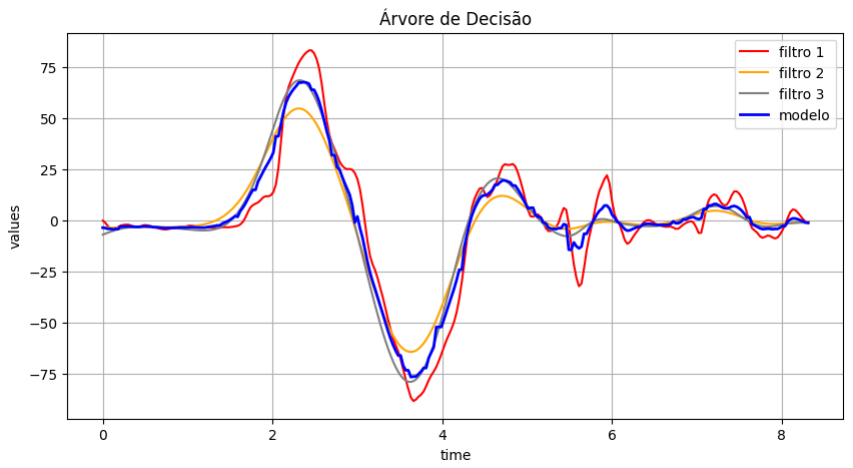
[picture p44: figure]

(c) Gradient Boosting

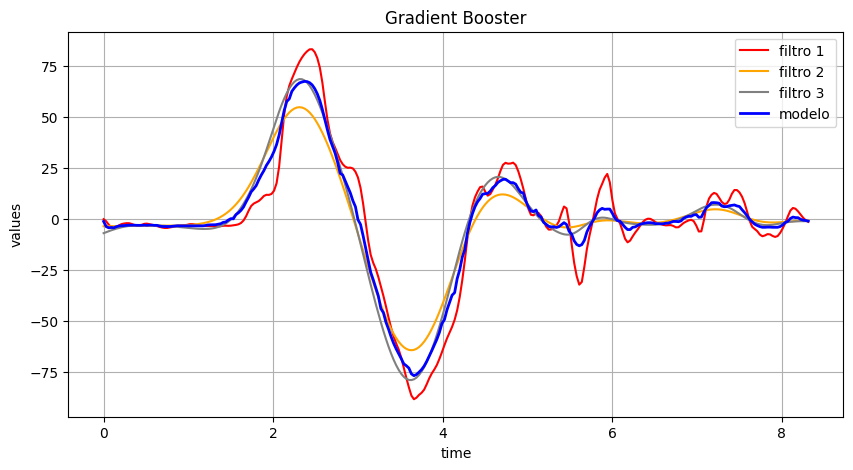
[picture p45: figure]

Fonte: Autoria Própria

Os três modelos de ML atingiram acurácia de 100% nos conjuntos de validação, o que demonstra que os padrões de correlação entre filtros e sinal de referência são fortemente determinísticos. A limitação prática é o custo computacional de inferência, que inviabiliza sua execução em tempo real em microcontroladores de baixo poder de processamento sem otimização específica. Por essa razão, o firmware final adota os filtros de Butterworth e Kalman, com fusão por CI, reservando os modelos de ML para etapas futuras de aprimoramento.

### 4.4 Representação de Atitude por Quaternions

A estimação de atitude em três dimensões é sujeita à singularidade de Gimbal Lock na representação por ângulos de Euler. Para contornar esse problema, o firmware do DRMM utiliza quaternions unitários, que representam qualquer rotação sem singularidade. Um quaternion unitário q = (q0, q1, q2, q3) satisfaz |q| = 1 e representa a rotação de ângulo θ em torno do eixo nˆ por:

q = cos
θ
2

+ sin
θ
2
| (q1 i + q2 j + q3 k) | (3)

A integração da velocidade angular ω para atualização contínua da atitude é realizada pela equação cinemática de quaternions:

q˙ =

1
2
q ⊗ ωq, | ωq = (0, ωx, ωy, ωz) | (4)

Figura 9: Representação Tridimensional da Atitude Calculada por Quaternions

(a) (b)

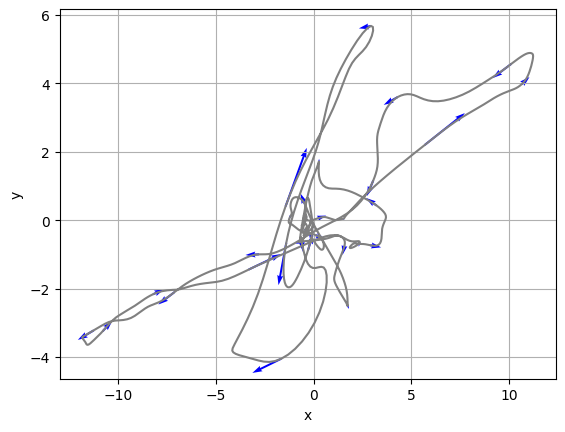
[picture p46: figure]
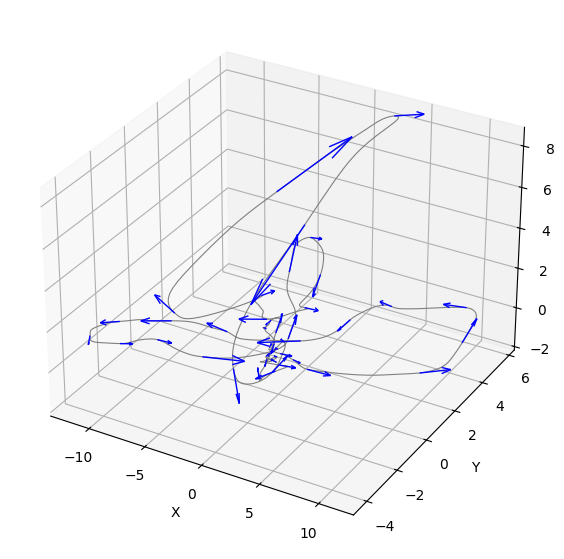
[picture p47: figure]

Fonte: Autoria Própria

As representações tridimensionais confirmam a estabilidade numérica do método de integração por quaternions mesmo para grandes ângulos de rotação. A ausência de descontinuidades nos traçados indica que o algoritmo não sofreu da singularidade de Gimbal Lock durante os ensaios realizados, validando a escolha dessa representação para o firmware embarcado. Com os algoritmos de filtragem, fusão e estimação de atitude definidos e validados, a próxima etapa consistiu na implementação em hardware embarcado dedicado, conforme descrito na seção seguinte.

## 5 Desenvolvimento de Hardware e Eletrônica

A validação dos algoritmos em ambiente de computação de alto nível (Python) criou os requisitos para o hardware embarcado: o sistema deveria executar em tempo real os filtros selecionados, gerenciar a comunicação com o sensor Kernel via RS-422 e emitir sentenças NMEA 0183. Esta seção descreve a evolução do hardware ao longo do projeto, desde os primeiros experimentos com sensores de baixo custo até o protótipo final certificado.

### 5.1 Evolução do Protótipo e Primeiros Testes

O desenvolvimento do hardware do DRMM percorreu quatro fases distintas ao longo das cinco macroentregas. A Macroentrega I iniciou com uma prova de conceito em protoboard, conectando o acelerômetro MPU6050 a um Arduino via I2C e a um Raspberry Pi para aplicação do filtro de Kalman. Esse experimento validou a viabilidade da abordagem inercial e forneceu os primeiros dados reais para o desenvolvimento dos algoritmos de filtragem, antes de qualquer investimento em hardware dedicado.

Figura 10: Primeira Prova de Conceito: Circuito com MPU6050 e Filtro de Kalman

(a) Componentes do circuito Protótipo | (b) Saída gráfica da simulação de inclinação

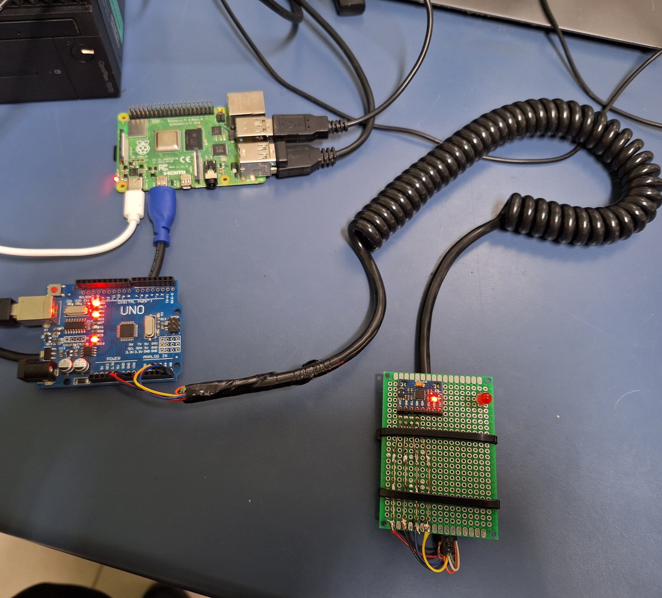
[picture p48: figure]
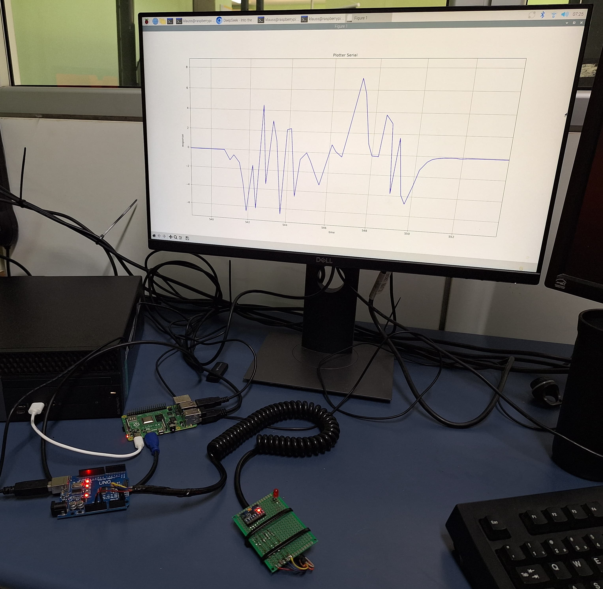
[picture p49: figure]

Fonte: Autoria Própria

Os resultados da primeira montagem (Figura 10) confirmaram que o MPU6050, mesmo sendo de baixo custo, produz dados com ruído estocástico que o filtro de Kalman simples consegue atenuar. A integração por software em Raspberry Pi revelou limitações de latência que tornaram necessária a migração para firmware embarcado em microcontrolador dedicado.
Na segunda fase (Macroentrega III), o primeiro protótipo em PCB foi concebido com o Raspberry Pi Pico, validando os circuitos de comunicação RS-422, RS-232 e os reguladores de alimentação. Na terceira fase, o ESP32-S3 Mini substituiu o Raspberry Pi Pico e o sensor

KERNEL foi integrado diretamente na placa. Na quarta fase (Macroentrega V), a PCB foi reprojetada em geometria circular, com todos os aprimoramentos identificados nos testes de campo incorporados.

Figura 11: Evolução dos Protótipos da Placa de Circuito Impresso

(a) Protótipo com Raspberry PICO | (b) Protótipo com ESP32

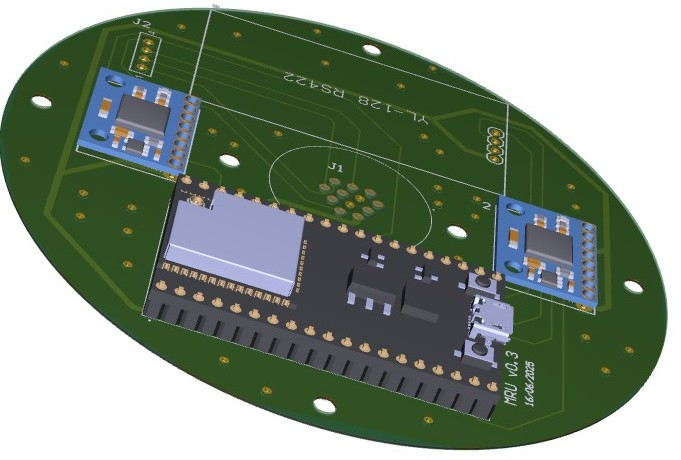
[picture p50: figure]
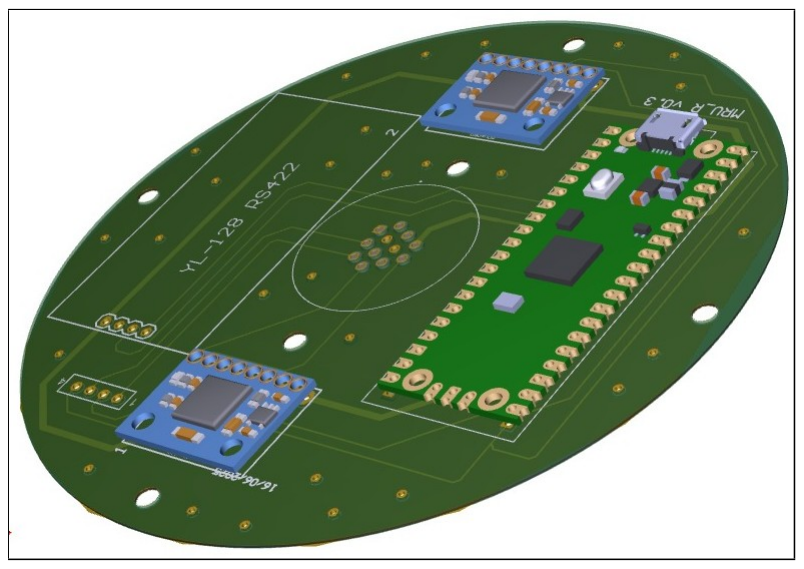
[picture p51: figure]

Fonte: Autoria Própria

A progressão evidenciada na Figura 11 ilustra a redução significativa de volume e o aumento de integração a cada fase. O dispositivo final apresenta o DRMM em configuração de produção, com todos os componentes integrados no compartimento cilíndrico metálico, conectores industriais e identificação dos eixos de referência gravada na face superior.

### 5.2 Sensores Empregados no Protótipo

Três sensores foram integrados ao sistema nas diferentes fases de desenvolvimento, cumprindo papéis complementares.

Figura 12: Sensores Empregados no Protótipo

(a) | MPU6050 | (custo-
benefício) | (b) MPU9250 (com magnetômetro) | (c) Inertial Labs KERNEL

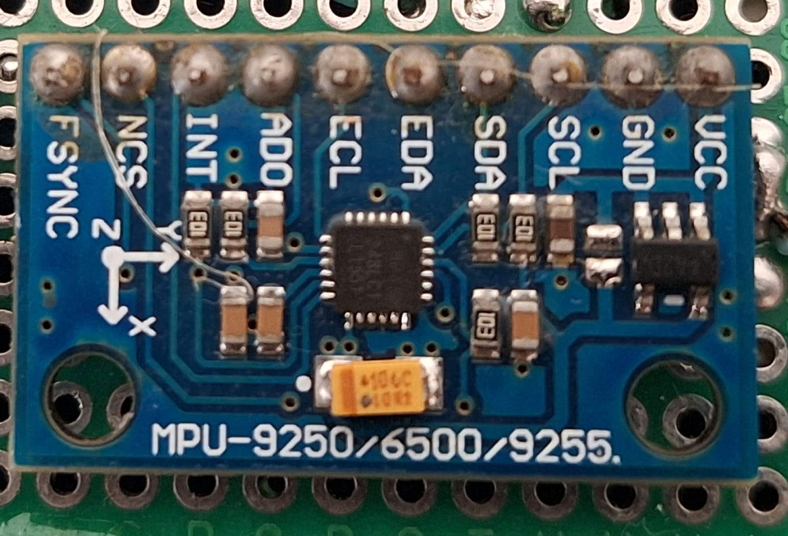
[picture p52: figure]

Fonte: Autoria Própria

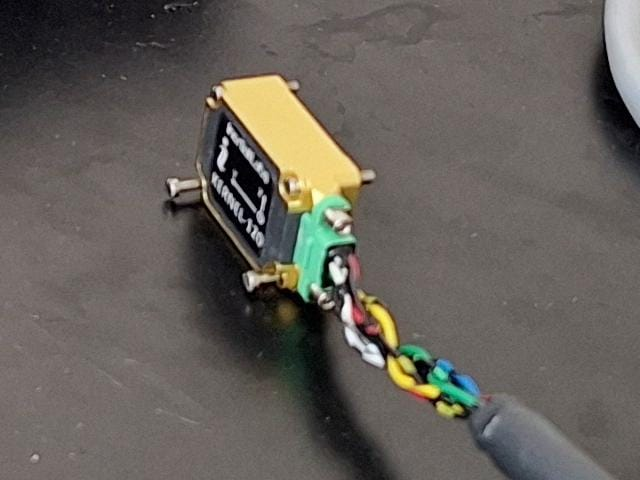
[picture p53: figure]
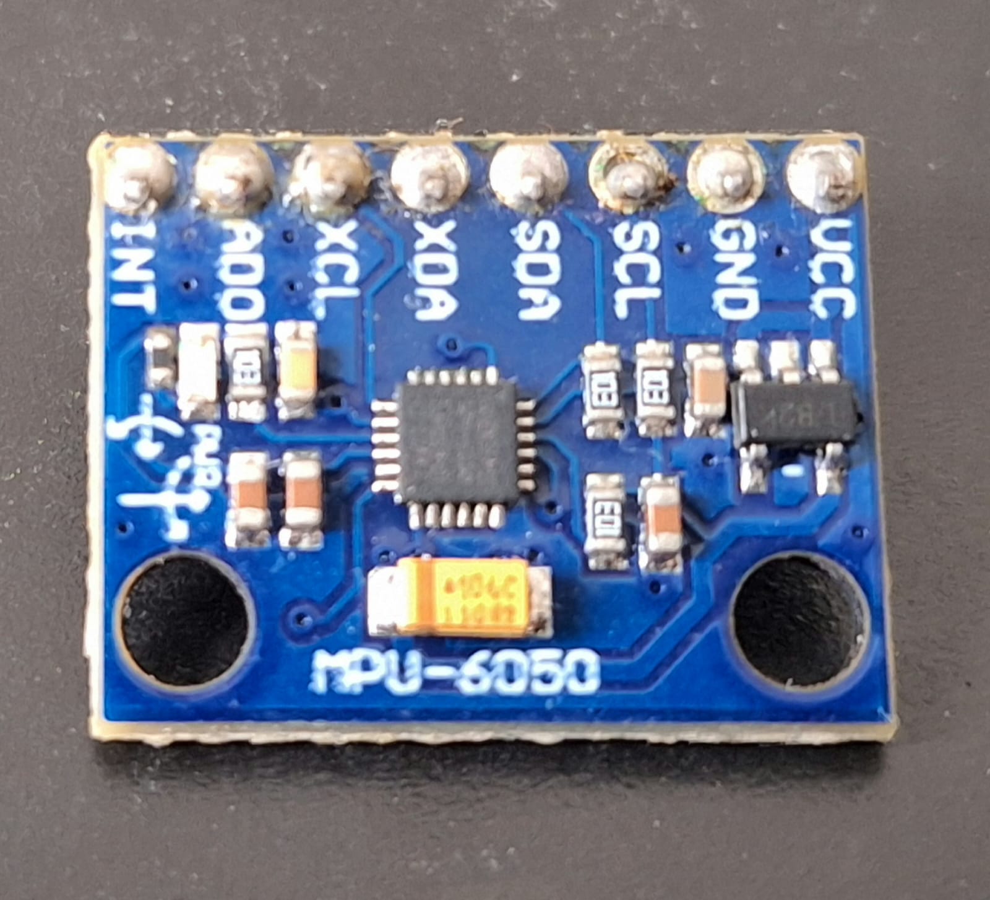
[picture p54: figure]

O MPU6050 (ElectroNOOBS, 2018) e o MPU9250 são sensores MEMS de baixo custo com 6DOF e 9DOF respectivamente. Seus dados ruidosos foram utilizados para desenvolver e validar os algoritmos de filtragem e fusão, pois a comparação com o sensor de referência permitiu medir objetivamente a eficácia de cada técnica. O Inertial Labs KERNEL-

110/120 (Inertial Labs, 2021) é a IMU MEMS de classe industrial adotada como sensor principal do DRMM, com estabilidade de bias de giroscópio de 2◦
/h (in-run) e não-linearidade de 0,035% FS. O sistema de coordenadas do KERNEL é apresentado na Figura 13.

Figura 13: Sistema de Coordenadas e Especificação do Sensor KERNEL

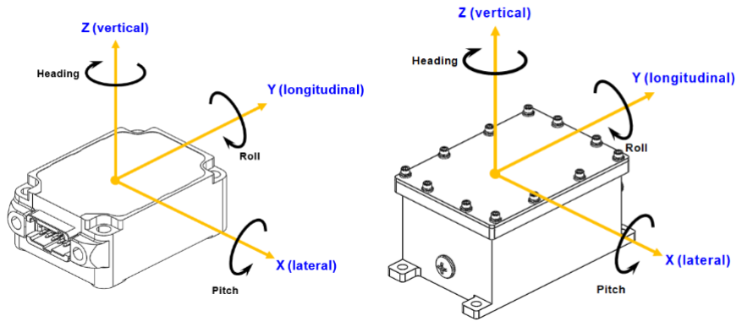
[picture p55: figure]

Fonte: (Inertial Labs, 2021)

O diagrama de eixos do KERNEL define o eixo X apontando para a frente do sensor, Y para a lateral esquerda e Z para cima, seguindo a convenção utilizada nos MRUs offshore. O firmware do DRMM adota essa convenção para garantir que os ângulos de roll, pitch e yaw calculados correspondam diretamente aos valores esperados pelo protocolo NMEA 0183 e sejam interpretados corretamente pelo aplicativo HMS e pelos sistemas embarcados da plataforma. A Tabela 7 apresenta a comparação técnica dos três sensores, demonstrando de forma quantitativa a superioridade do KERNEL em estabilidade e linearidade.

Tabela 7: Comparação Técnica dos Sensores Empregados

Especificação | MPU6050 | MPU9250 | KERNEL-110/120
Estabilidade de bias do giroscópio | ±20 ◦ /s inicial | ◦ ±5 /s inicial | ◦ 2 /h (in-run)
Não-linearidade | 0,2% FS | 0,1% FS | 0,035% FS
Taxa de atualização | Gyro 8 kHz, Accel 1 kHz | Gyro 8 kHz, Accel 4 kHz | Gyro e Accel 2 kHz
Interface de comunicação | I 2C, SPI | I 2C, SPI | RS-422 até 2 Mbit/s
Função no projeto | Validação de algoritmos | Validação com magnetômetro | Sensor principal (produção)

Fonte: Autoria Própria com base em (Inertial Labs, 2021)

A análise comparativa da Tabela 7 confirma que o KERNEL supera os sensores de baixo custo em todos os indicadores críticos para aplicações offshore. A diferença na estabilidade de bias é de duas ordens de grandeza (2◦

/h vs. 20◦
/s), o que representa uma vantagem determinante para operações de longa duração sem recalibração.

### 5.3 PCB de Teste (Primeira Geração)

A placa de primeira geração foi desenvolvida para validar individualmente cada componente eletrônico antes de integrá-los na placa definitiva. Utilizou o Raspberry Pi Pico como microcontrolador e permitiu verificar a comunicação RS-422 com o sensor KERNEL, os circuitos de alimentação e os módulos de proteção elétrica.

Figura 14: PCB de Primeira Geração (Versão Pico) e Modelos 3D

(a) PCB montada | (b) PCB soldada com sensor | (c) Vista 3D do protótipo

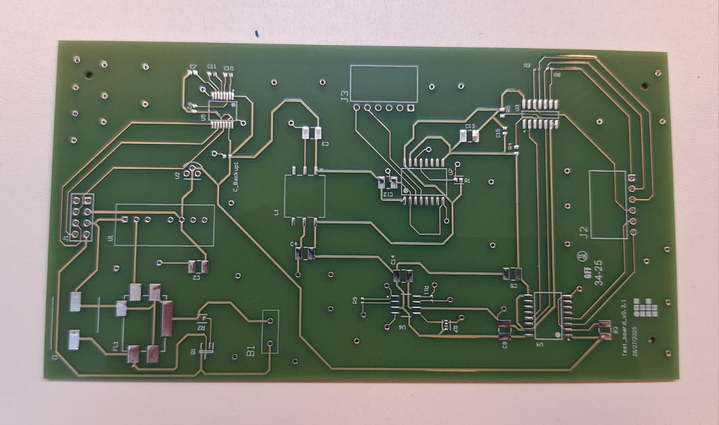
[picture p56: figure]

Fonte: Autoria Própria

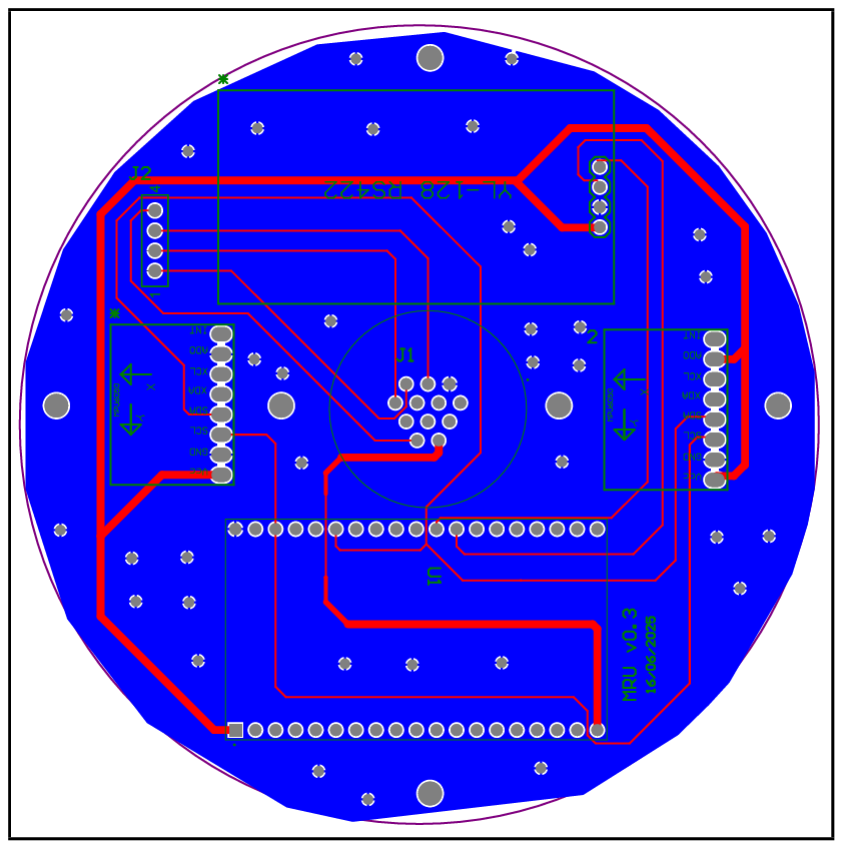
[picture p57: figure]
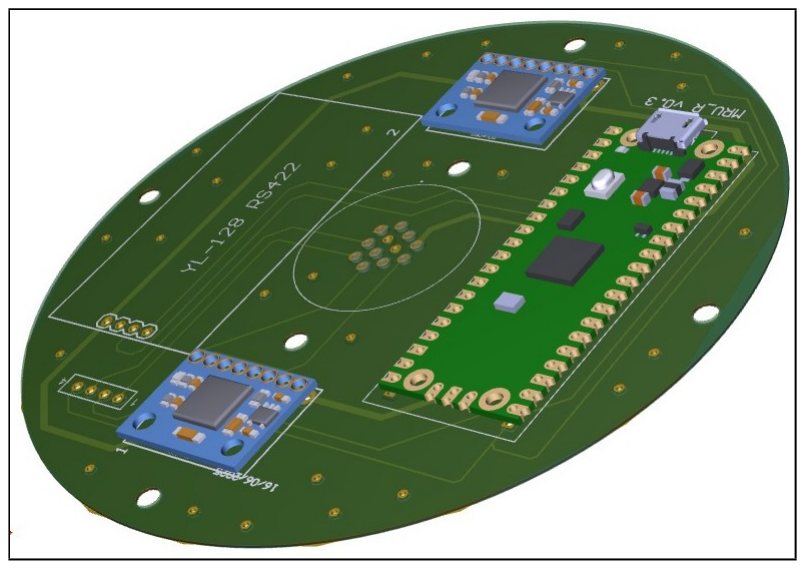
[picture p58: figure]

Os testes com a placa de primeira geração validaram o funcionamento dos circuitos de comunicação RS-422 e RS-232, dos reguladores de alimentação e da tecnologia SMD, confirmando que os componentes de montagem superficial são viáveis e reduzem significativamente o volume e o custo de fabricação. A transição para o ESP32-S3 Mini foi decidida com base nos resultados dessa fase.

### 5.4 PCB do Primeiro Protótipo (Segunda Geração)

Com base nos resultados da placa de teste, foi projetado o primeiro protótipo integrado, substituindo o Raspberry Pi Pico pelo ESP32-S3 Mini (240 MHz, 4 MB flash, 2 MB PSRAM, dimensões de 15,4 × 20,5 mm). O microcontrolador descrito oferece maior poder de processamento para os algoritmos de fusão, suporte nativo a Bluetooth e Wi-Fi e dimensões reduzidas compatíveis com o encapsulamento cilíndrico.

Figura 15: Esquemáticos da PCB do Primeiro Protótipo

(a) Alimentação e regulação | (b) Interface RS-422 com KERNEL

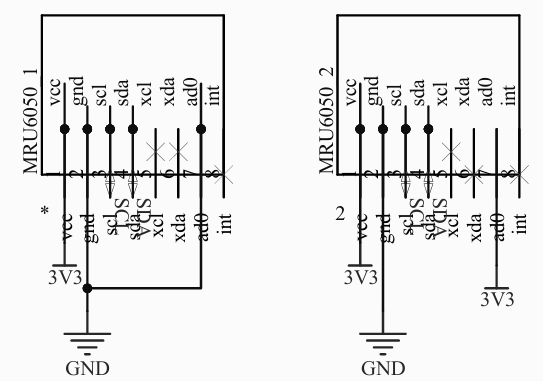
[picture p59: figure]
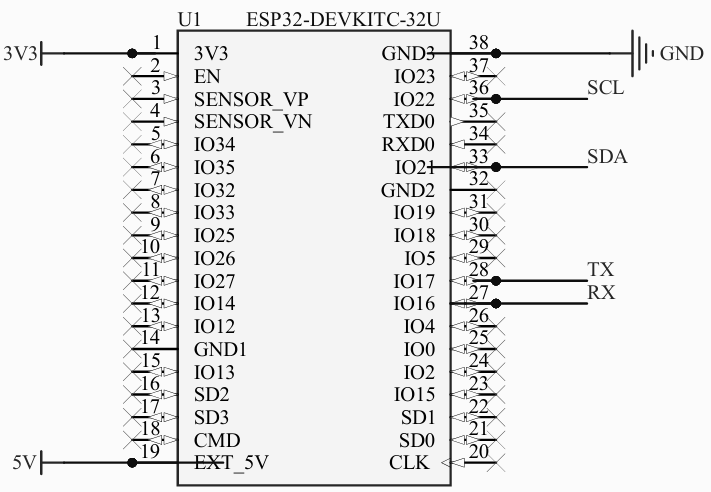
[picture p60: figure]

(c) Interface RS-232 para configuração | (d) Bloco do ESP32-S3 Mini

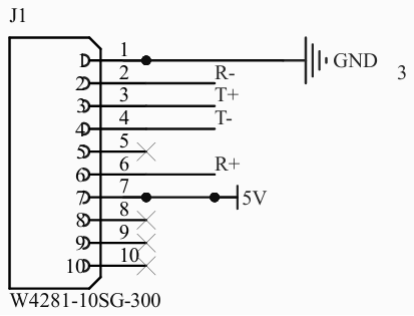
[picture p61: figure]
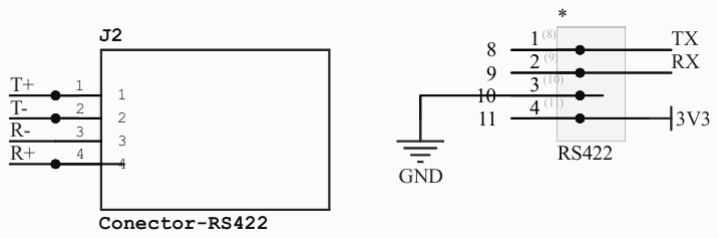
[picture p62: figure]

Fonte: Autoria Própria

Os quatro esquemáticos apresentam os blocos funcionais do sistema embarcado. O bloco de alimentação (superior esquerdo) inclui regulador LDO com filtragem ativa para o sensor KERNEL. O isolamento galvânico da interface RS-422 (superior direito) é garantido por optoacopladores, protegendo o microcontrolador contra surtos de tensão provenientes do barramento industrial.

Figura 16: PCB do Primeiro Protótipo Montada e Modelo 3D

(a) Face Superior | (b) Face Inferior | (c) Modelo 3D

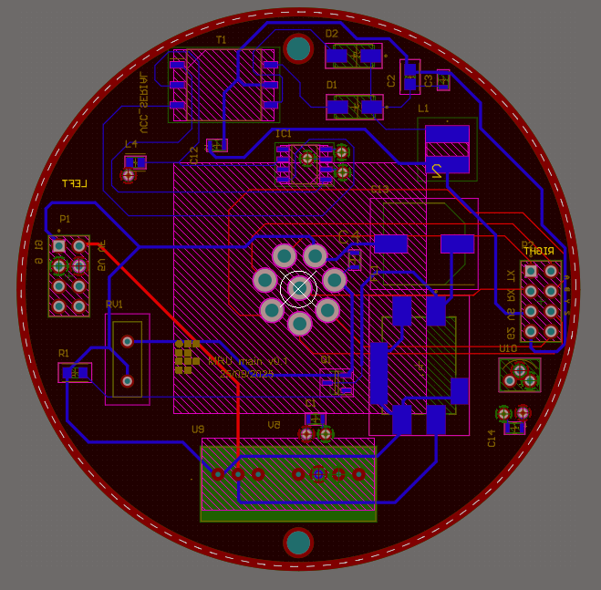
[picture p63: figure]

Fonte: Autoria Própria

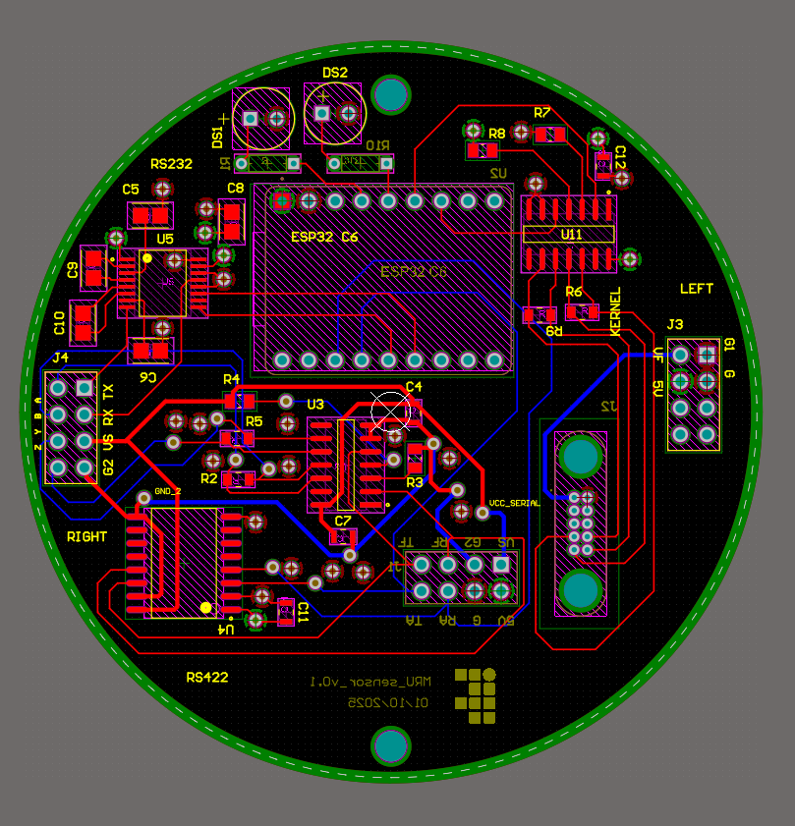
[picture p64: figure]
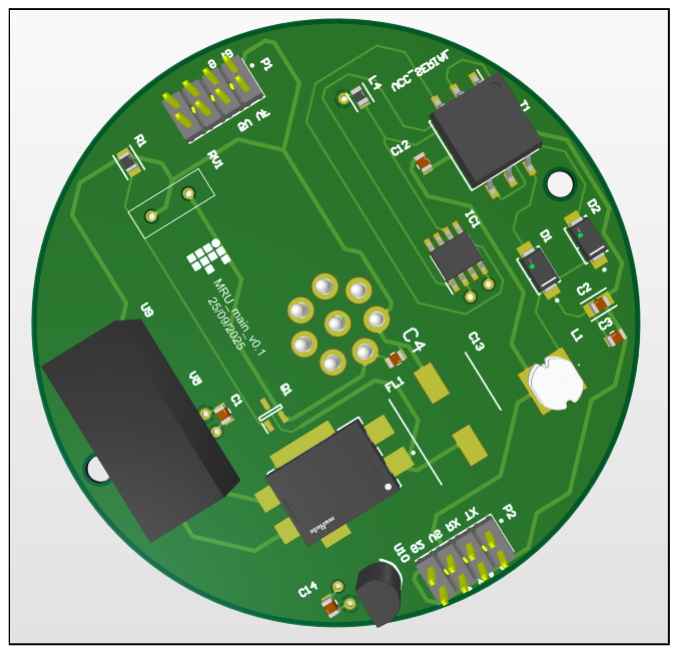
[picture p65: figure]

As faces superior e inferior da placa revelam a distribuição equilibrada dos componentes

SMD, com os conectores de alta corrente posicionados na periferia e os blocos de processamento no centro. O modelo 3D confirma a adequação das dimensões ao encapsulamento cilíndrico. Durante os testes de campo com essa placa, foram identificados dois pontos de melhoria: a necessidade de conectar o encoder rotativo diretamente ao ESP32-S3 Mini, e o aprimoramento do circuito RS-232 para maior robustez.

### 5.5 PCB Final (Terceira Geração)

A placa final incorpora os aprimoramentos identificados nos testes de campo com o primeiro protótipo, incluindo a conexão direta do encoder rotativo ao ESP32-S3 Mini, melhoria no circuito RS-232 e geometria circular para melhor acomodação no compartimento cilíndrico.

Figura 17: PCB Final e Modelo 3D do Sistema Integrado

(a) Placa superior | (b) Placa inferior | (c) Vista 3D integrada

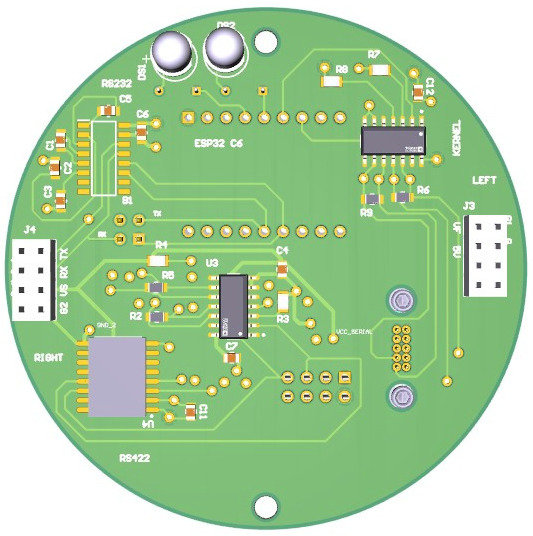
[picture p66: figure]

Fonte: Autoria Própria

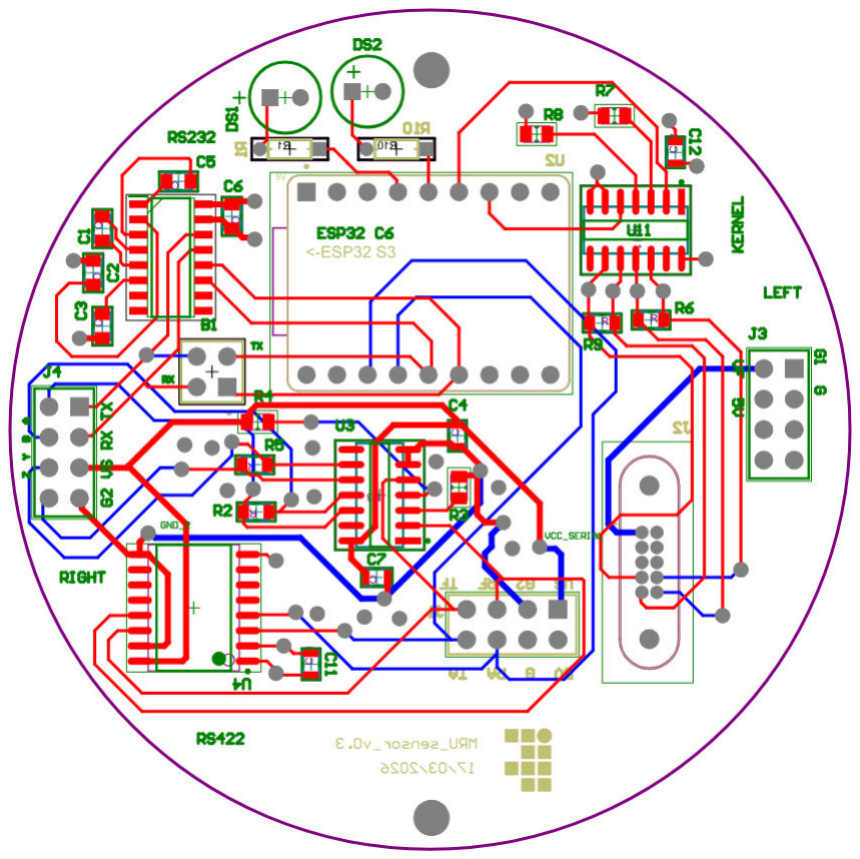
[picture p67: figure]
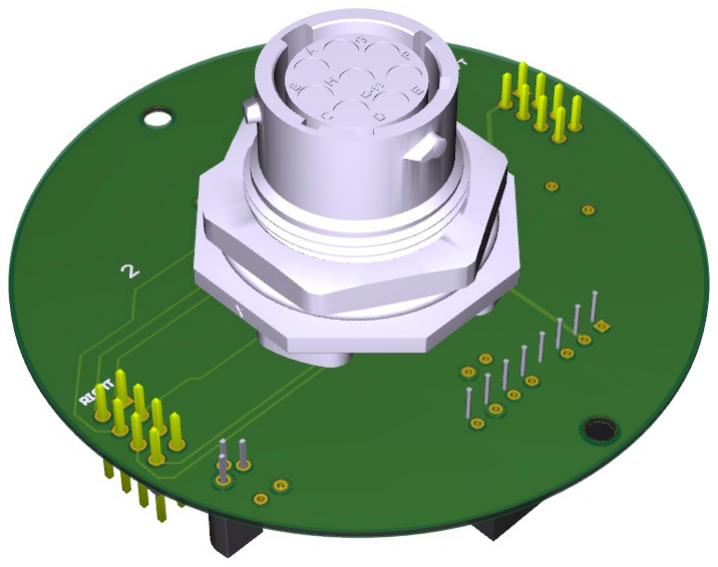
[picture p68: figure]

A geometria circular da PCB final elimina as quinas que impediam o encaixe no compartimento cilíndrico, reduzindo o diâmetro total da placa de 75 mm para 68 mm. O circuito foi fabricado pela empresa Wego Sistemas utilizando o software Altium Designer, garantindo rastreabilidade de projeto e conformidade com as práticas industriais de produção de PCBs. Com o hardware definitivo estabelecido, as atenções se voltaram para o desenvolvimento do software de comunicação e monitoramento, descrito na próxima seção.

## 6 Software e Protocolo de Comunicação

O DRMM integra três camadas de software, cada uma com funções e interfaces bem delimitadas: o firmware embarcado no ESP32-S3 Mini, o protocolo de comunicação NMEA 0183 e o aplicativo desktop HMS. A clara separação entre essas camadas garante modularidade e facilita a manutenção e atualização independente de cada componente.

### 6.1 Firmware Embarcado

O firmware foi desenvolvido em C++ utilizando o framework Arduino sobre o ESP32-S3 Mini. Sua arquitetura segue um ciclo de controle em tempo real com três tarefas executadas em ordem fixa por período de amostragem.
Na primeira tarefa, o ESP32-S3 Mini solicita ao sensor KERNEL os valores de aceleração e velocidade angular via RS-422 a 460800 baud. Na segunda tarefa, os dados recebidos são processados pelos filtros selecionados (Butterworth ou Kalman) e pelo algoritmo de integração de quaternions, resultando nos ângulos de Euler correspondentes. Na terceira tarefa, os ângulos calculados, as acelerações filtradas e a temperatura interna são empacotados em sentenças NMEA 0183 e transmitidos via RS-422 a 38400 baud. Paralelamente, o microcontrolador monitora a porta RS-232 em busca de comandos de configuração.
A serialização dos dados para comunicação sem fio com o aplicativo HMS utiliza Protocol Buffers (Protobuf), que oferecem representação binária compacta e eficiência de decodificação superior a formatos textuais.

### 6.2 Protocolo NMEA 0183 via RS-422

O NMEA 0183 é o padrão de comunicação serial adotado pela indústria de navegação marítima, definindo um conjunto de sentenças textuais ASCII transmitidas via RS-422 (Marinha do Brasil. Diretoria de Portos e Costas, 2017). Cada sentença inicia com o caractere $, contém campos separados por vírgulas e termina com um asterisco seguido por dois caracteres hexadecimais de checksum, calculados pela operação XOR de todos os bytes entre $ e *. A figura Figura 18 mostra a organização explicada.
A sentença emitida pelo DRMM segue o formato abaixo, onde cada campo corresponde a ângulos em graus, acelerações em m/s²

, temperatura interna em ◦C e checksum hexade-

cimal de dois dígitos:

$DRMM,ROLL,PITCH,YAW,AX,AY,AZ,TEMP*XX

Figura 18: Estrutura da Sentença NMEA 0183 Emitida pelo DRMM

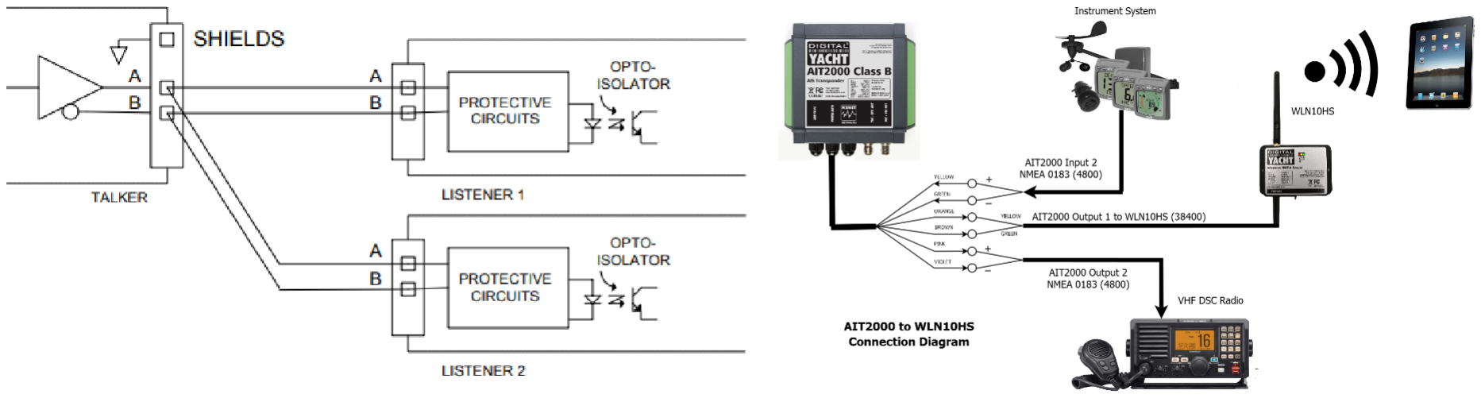
[picture p69: figure]

Fonte: Autoria Própria

Esse formato é compatível com os parsers NMEA utilizados pelos sistemas HMS comerciais, garantindo interoperabilidade imediata. O cálculo do checksum foi implementado em C++ conforme apresentado a seguir.

1 | String calcularChecksum(String sentenca) {
2 | byte checksum = 0;
3 | for (int i = 1; i < sentenca.length(); i++) {
4 | if (sentenca[i] == '*') break;
5 | checksum ^= (byte)sentenca[i];
6 | }
7 | String hex = String(checksum, HEX);
8 | hex.toUpperCase();
9 | if (hex.length() == 1) hex = "0" + hex;
10 | return hex;
11 | }

### 6.3 Protocolo de Configuração via RS-232

Para permitir configuração in loco sem necessidade de reprogramação, o DRMM implementa um protocolo proprietário de configuração via RS-232. Os comandos seguem o formato $comando!{parâmetro}, onde os delimitadores $ e ! identificam início e fim da mensagem, respectivamente. A Tabela 9 lista os comandos disponíveis.
O protocolo RS-232 foi projetado para ser simples o suficiente para ser enviado por qualquer terminal serial (Putty, screen, minicom), eliminando a dependência de um software proprietário de configuração. A resposta de confirmação é enviada como sentença NMEA com o campo de status confirmando o comando recebido.

Tabela 9: Comandos do Protocolo de Configuração RS-232

Comando | Parâmetro | Descrição
$rate!{valor} | Inteiro (Hz) | Define a frequência de saída de dados
$baud!{valor} | 4800 / 9600 / 38400 | Define o baudrate da saída RS-422
$filter!{tipo} | kalman / butterworth | Seleciona o filtro digital ativo
$reset! | — | Reinicia para configurações padrão
$info! | — | Retorna versão do firmware e número de série

Fonte: Autoria Própria

### 6.4 Aplicativo HMS (Helideck Monitoring System)

O aplicativo HMS foi desenvolvido como software desktop multiplataforma (Windows e Linux) com o framework Tauri, combinando backend em Rust para alto desempenho de comunicação serial e decodificação de sentenças NMEA, e frontend em React com TypeScript para a interface gráfica.

Figura 19: Aplicativo HMS: Telas de Monitoramento e Banco de Dados

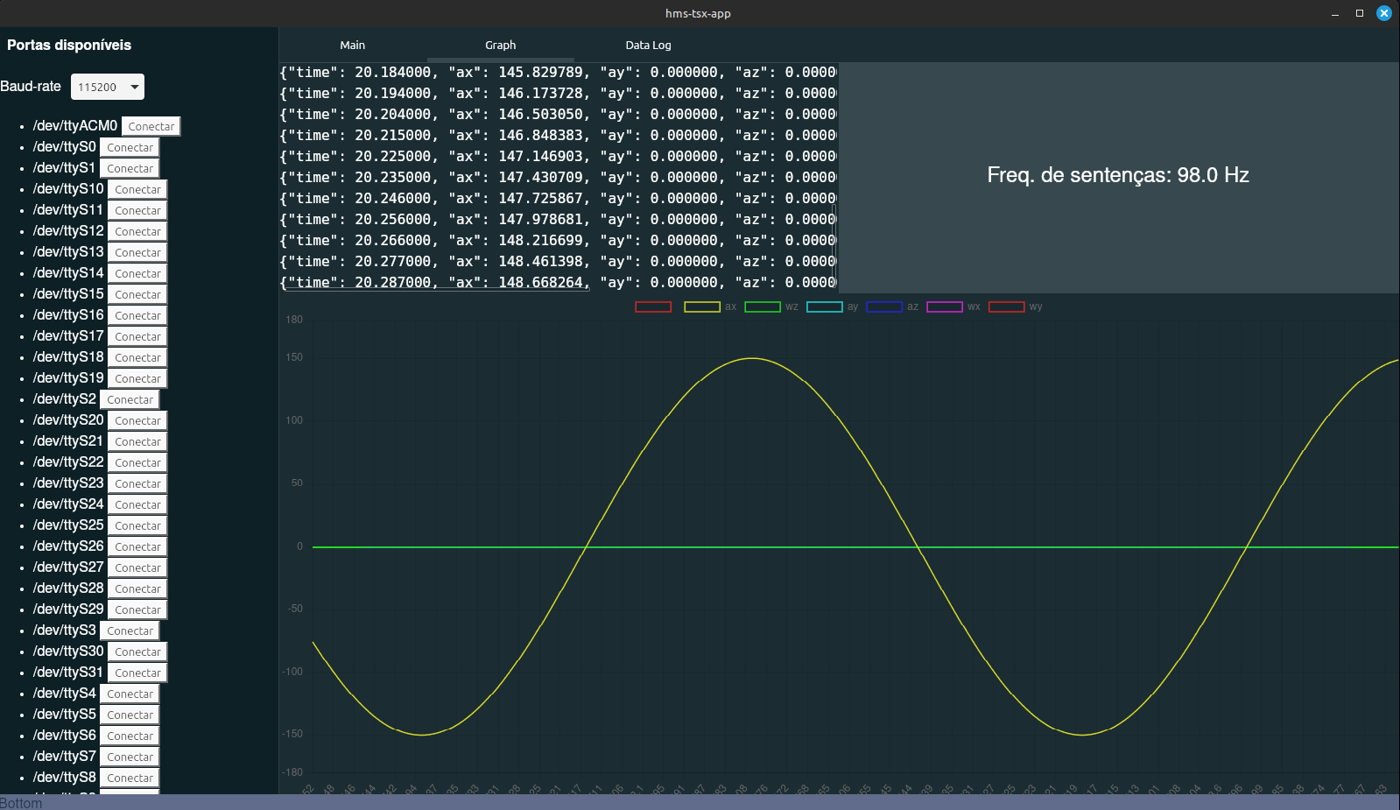
[picture p70: figure]

Fonte: Autoria Própria

A tela de monitoramento em tempo real (esquerda) exibe os gráficos de roll, pitch, yaw e acelerações com atualização a cada ciclo de transmissão em JSON, além de indicadores visuais de alerta quando os ângulos ultrapassam os limites operacionais. A tela de banco de dados (direita) permite consultar e exportar o histórico de medições em formato CSV para análise pós-operação. A Figura 20 apresenta o HMS durante uma sessão de teste com o pêndulo de calibração.

Figura 20: Interface do HMS com Gráficos em Tempo Real durante Teste com Pêndulo

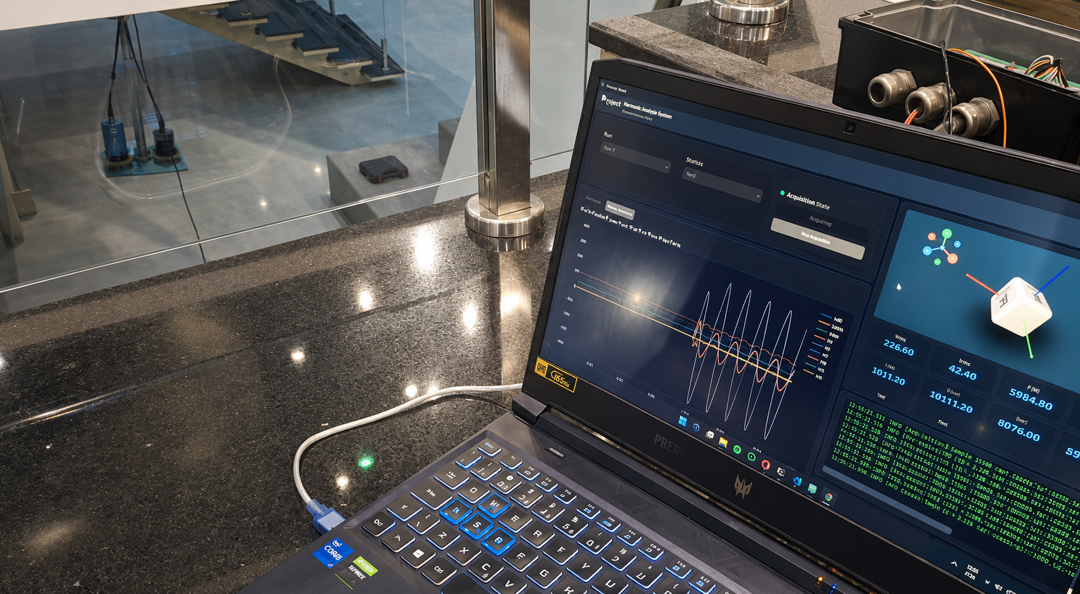
[picture p71: figure]

Fonte: Autoria Própria

Na sessão de teste com o pêndulo, os gráficos de roll sobrepõem em tempo real a curva do DRMM (linha azul) e o ângulo de referência calculado a partir dos pulsos do encoder (linha laranja), permitindo verificar visualmente a qualidade da calibração antes de aceitar os coeficientes calculados. Com o software completamente implementado e validado, a atenção foi voltada para o projeto e fabricação do encapsulamento do DRMM, apresentado na próxima seção.

### 6.5 HMS

O desenvolvimento do aplicativo desktop de monitoramento foi direcionado para ter um foco comercial e atender às expectativas atuais do setor. As telas do programa foram estruturadas com base em soluções já consolidadas, como o sistema dedicado da empresa Kongsberg. Além disso, o software foi projetado para indicar as variáveis de movimento Pitch, Roll e Yaw de maneira contínua e puramente numérica. Contudo, o foco central dessa abordagem técnica é simplificar a operação diária. Logo, o formato adotado garante aos usuários uma facilidade significativamente maior na visualização dos dados.

Figura 21: HMS Comercial do Sistema

(a) Modelo Kongsberg | (b) Modelo Measure

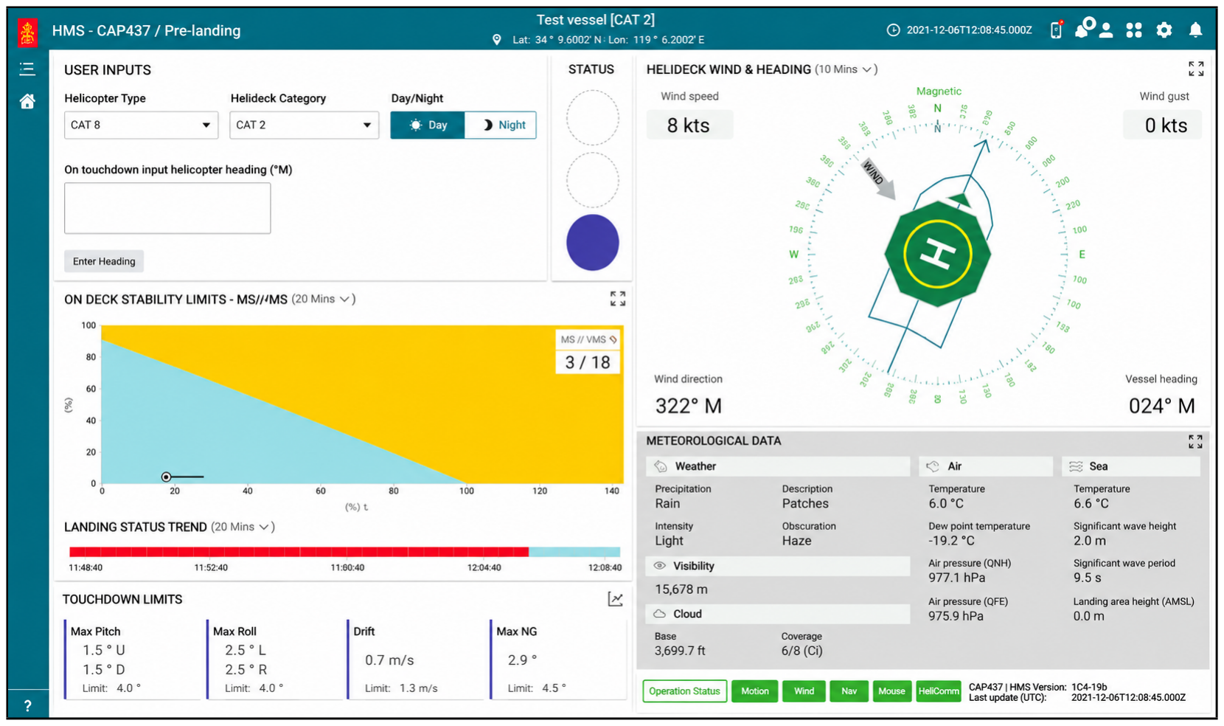
[picture p72: figure]
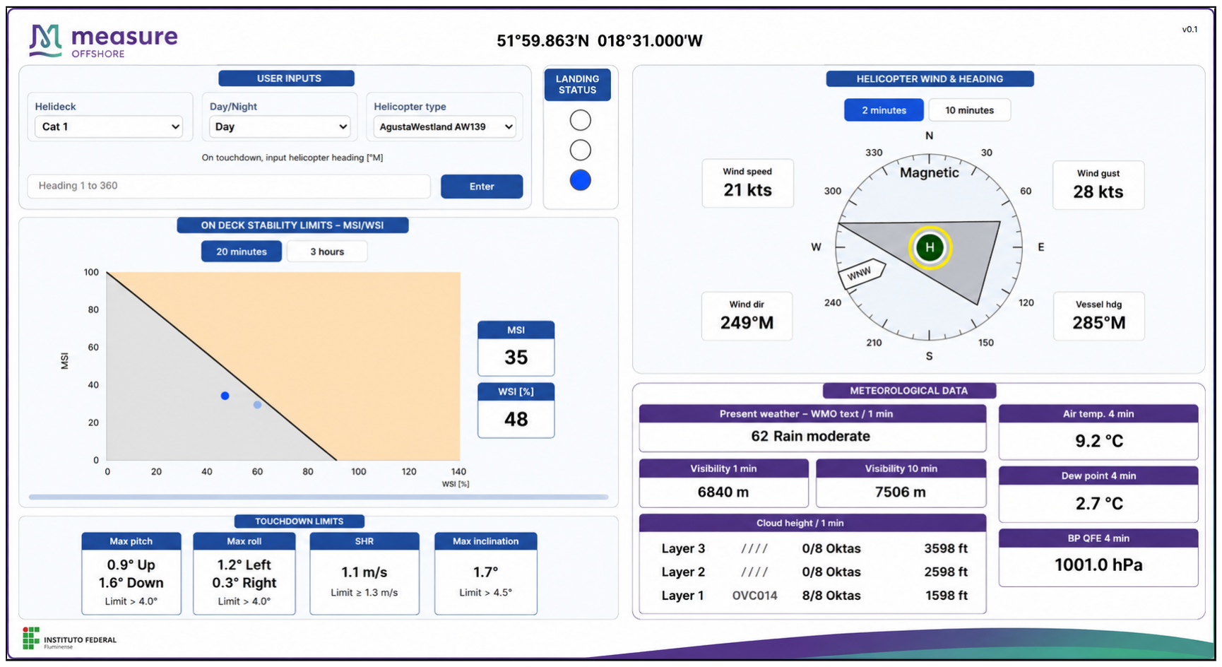
[picture p73: figure]

Fonte: Autoria Própria

As outras variáveis gráficas e numéricas estão disponíveis no sistema apenas de forma simbólica. Isso ocorre porque somente as três informações de orientação têm origem direta no MRU. Além disso, os demais dados são provenientes de sensores externos que não integram o escopo do projeto atual. Contudo, a aplicação atua como uma ferramenta indicativa totalmente escalável. Logo, o sistema poderá estabelecer comunicação com diversos equipamentos e sensores no futuro, o que permitirá o seu funcionamento integrado em uma estação sensorial embarcada.

## 7 Embalagem e Compartimento

O compartimento do DRMM cumpre duas funções críticas: proteger os componentes eletrônicos do ambiente marítimo (salinidade, umidade, vibração e temperatura) e garantir a rigidez mecânica necessária para que as medições inerciais sejam referenciadas a uma estrutura rígida conhecida. O projeto do compartimento passou por duas gerações.

### 7.1 Compartimento em Impressão 3D (Versão Inicial)

O compartimento inicial foi projetado em formato cilíndrico com 105 mm de diâmetro e 120 mm de altura, produzido em ABS por impressão 3D. Essa versão permitiu validar o layout interno das placas, a posição dos conectores e o processo de montagem, identificando pontos de melhoria antes da fabricação metálica definitiva.

Figura 22: Desenhos Técnicos do Compartimento Cilíndrico

(a) Tampa Superior | (b) Tampa Inferior | (c) Corpo Cilíndrico

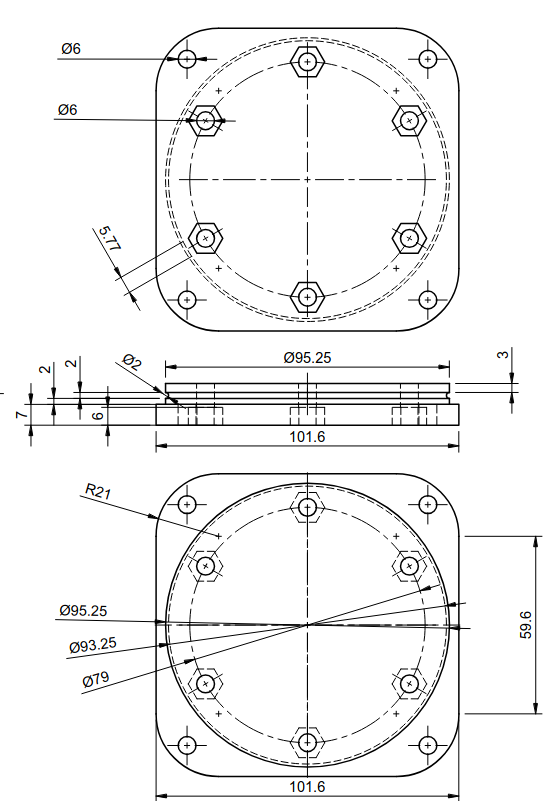
[picture p74: figure]

Fonte: Autoria Própria

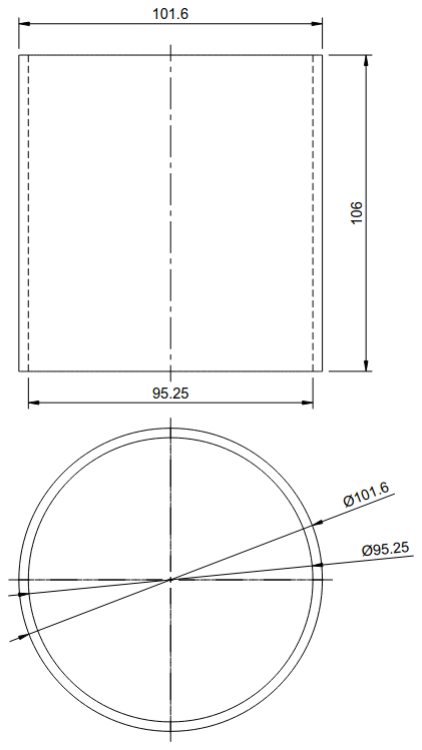
[picture p75: figure]
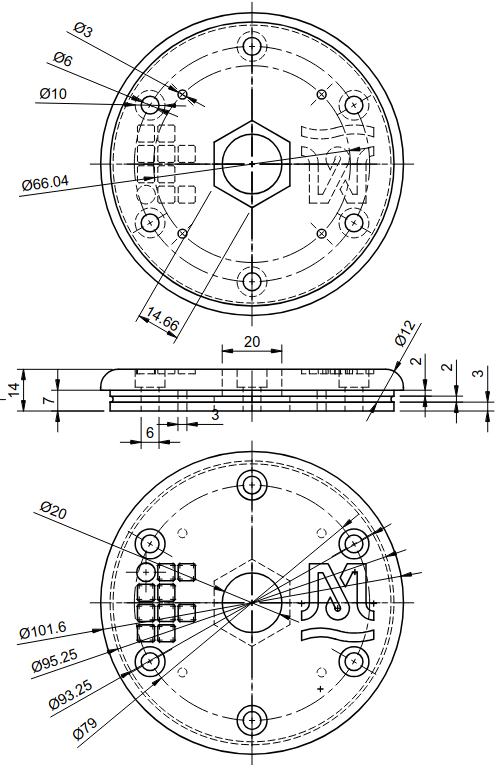
[picture p76: figure]

Os desenhos técnicos especificam as dimensões nominais das três peças com tolerâncias de ±0,1 mm para as superfícies de vedação. A rosca M4 nas tampas e o ressalto de centragem no corpo cilíndrico garantem o alinhamento das peças durante a montagem, assegurando a compressão uniforme dos anéis O-ring e o nível de proteção IP67.

Figura 23: Compartimento com as Placas Instaladas

(a) Protótipo com Impressão 3D | (b) Embalagem Metálica com Dimensões

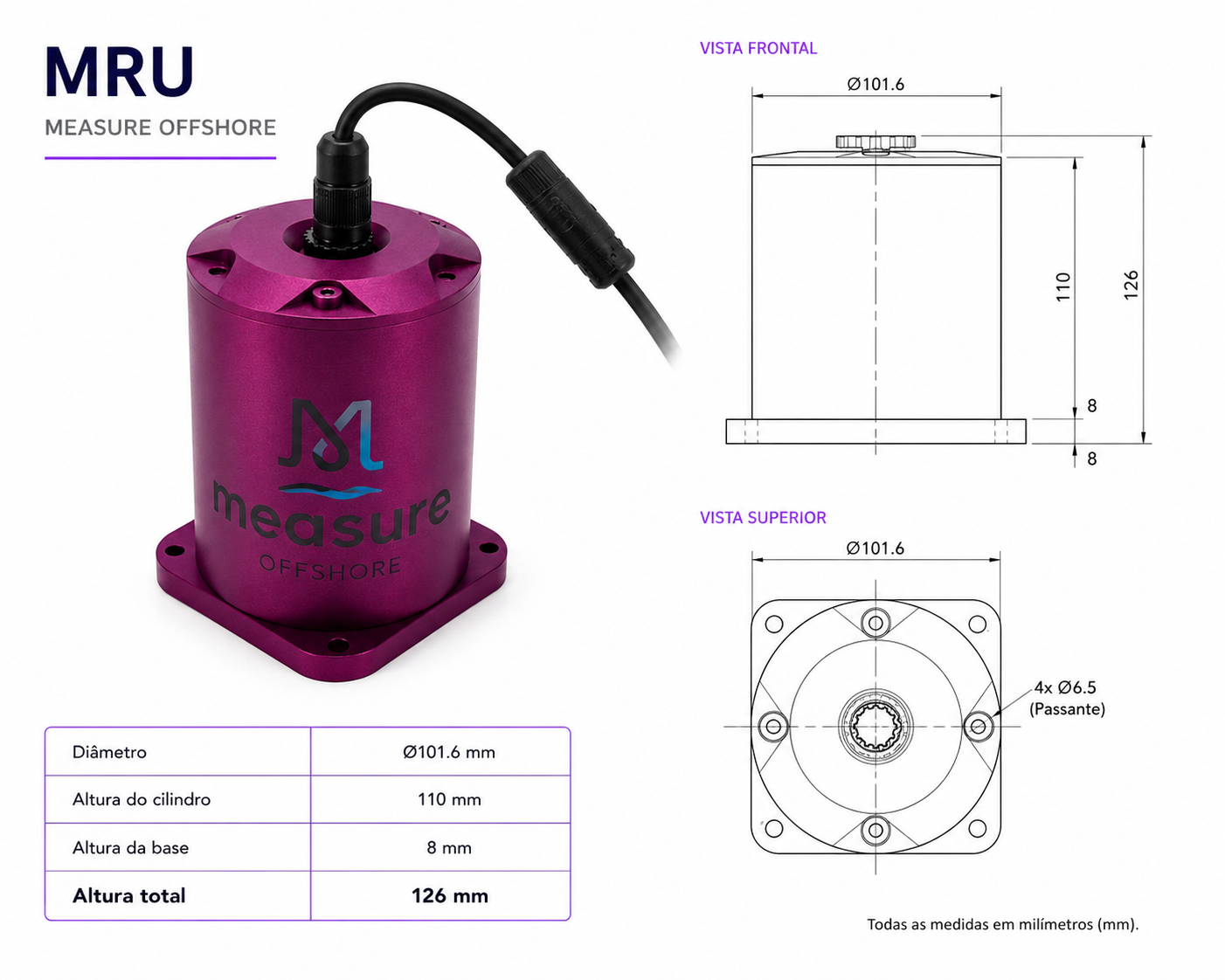
[picture p77: figure]
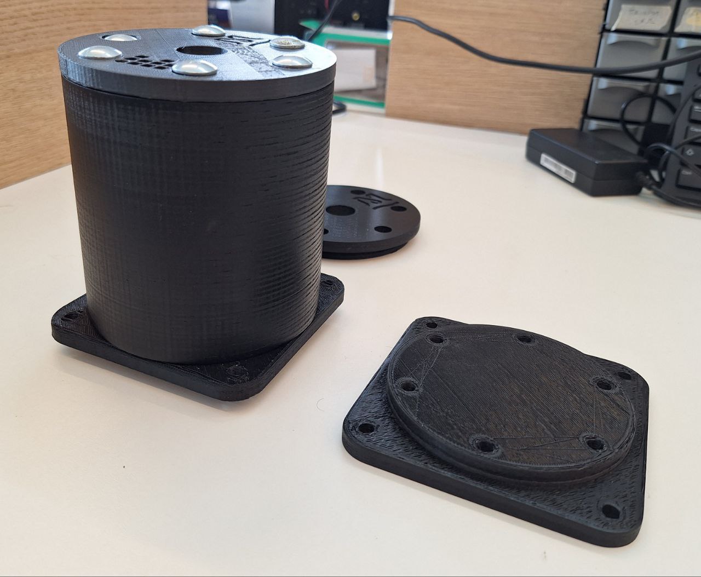
[picture p78: figure]

Fonte: Autoria Própria

A versão em ABS confirmou a viabilidade do layout interno e identificou duas melhorias necessárias: o alargamento do canal de entrada de cabos em 2 mm e o reposicionamento do anel O-ring para uma ranhura mais profunda, garantindo vedação mais eficiente. Esses ajustes foram incorporados ao projeto do compartimento metálico definitivo.

### 7.2 Compartimento Metálico Final

O compartimento definitivo foi usinado em alumínio liga 6063-T5 com superfície anodizada tipo II, proporcionando proteção IP67, dissipação de calor adequada e resistência mecânica para operação em ambiente offshore.

Figura 24: Desenho Técnico do Compartimento Metálico Final

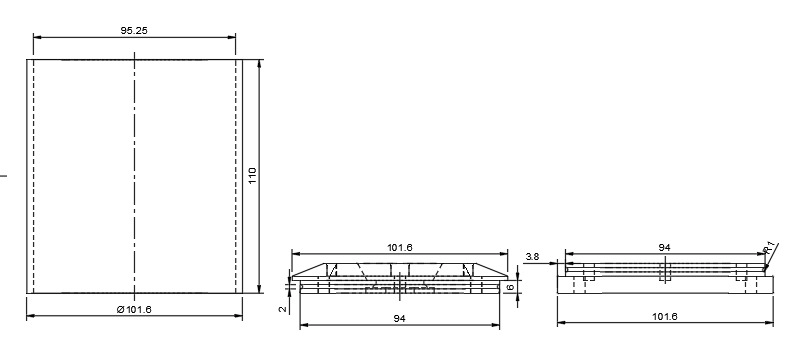
[picture p79: figure]

Fonte: Autoria Própria

O desenho técnico especifica o filete de raio R2 mm nas bordas internas, reduzindo a concentração de tensões mecânicas decorrentes de vibrações e impactos em operação offshore. Os conectores industriais para RS-422 e RS-232 estão instalados na tampa inferior, e a vedação entre as partes é assegurada por anéis O-ring de nitrila resistentes a fluidos salinos.

Figura 25: Compartimento Metálico do DRMM Usinado

(a) Peças prontas para mon-
tagem | (b) Montagem final

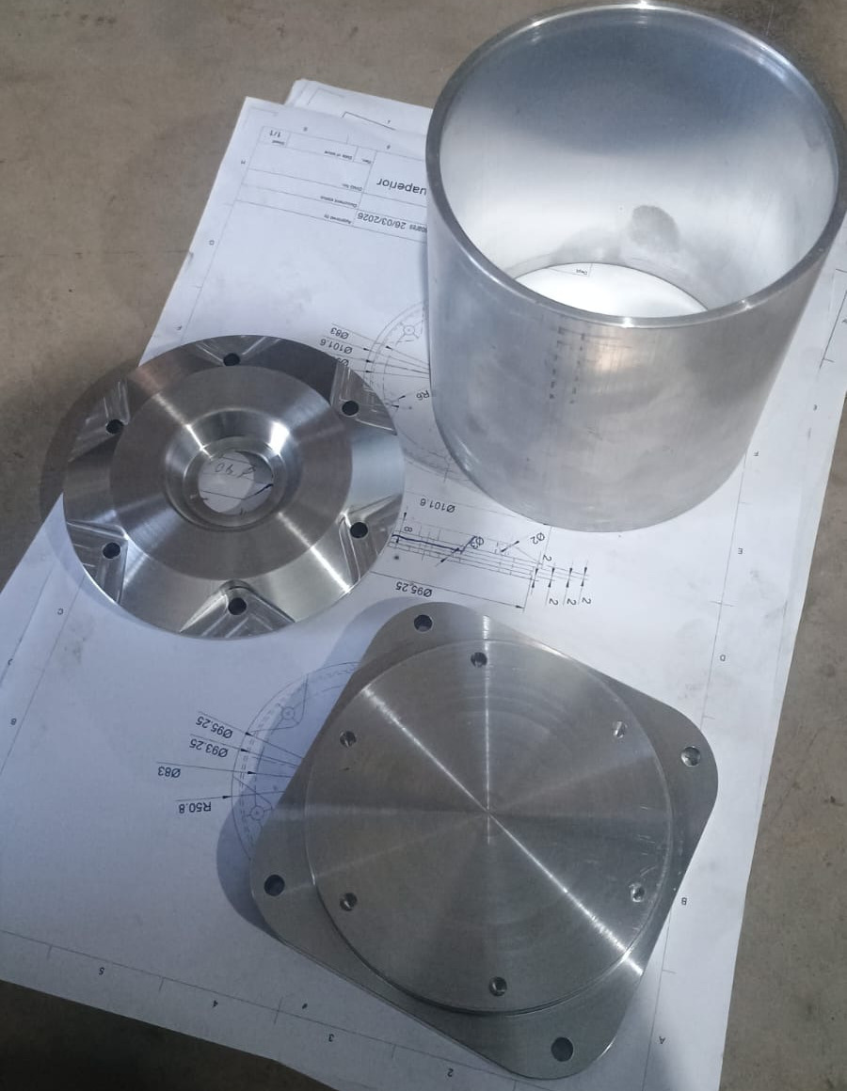
[picture p80: figure]
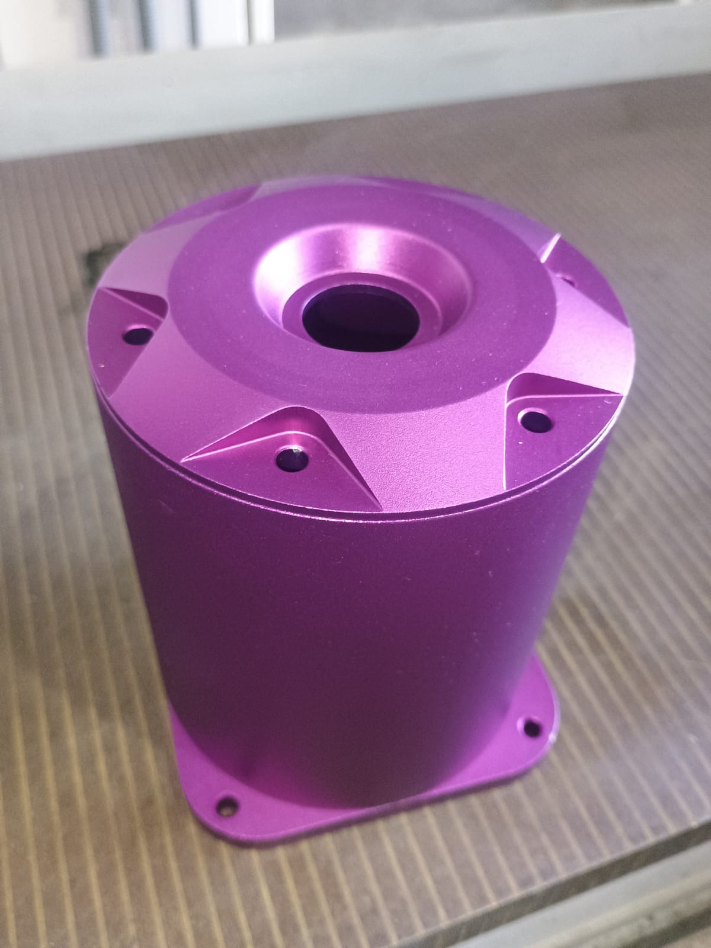
[picture p81: figure]

Fonte: Autoria Própria

Figura 26: Vistas do Compartimento Metálico Montado com Sistema Embarcado

(a) Vista lateral | (b) Vista frontal | (c) Vista com conectores

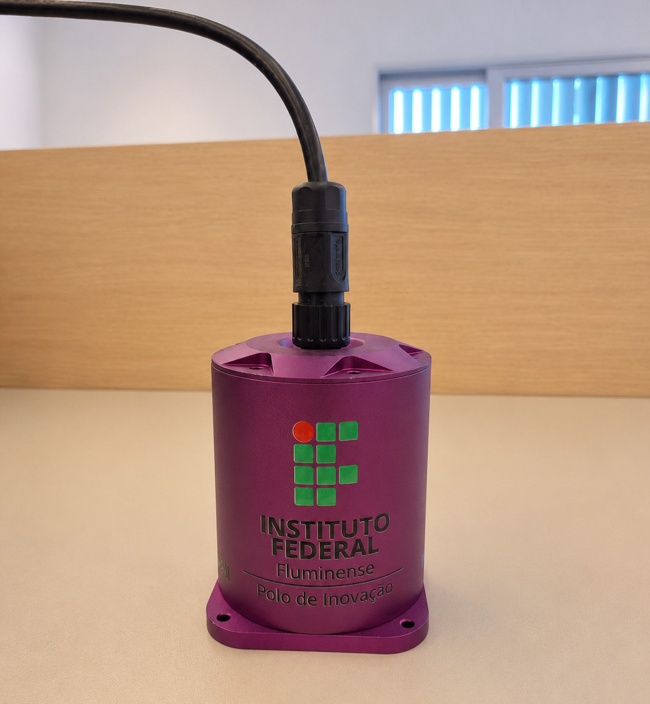
[picture p82: figure]

Fonte: Autoria Própria

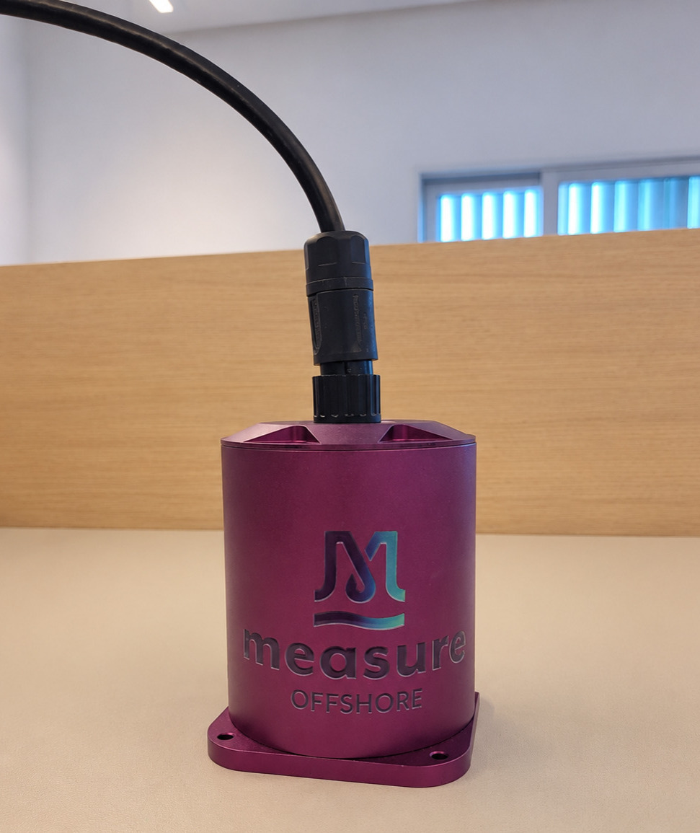
[picture p83: figure]
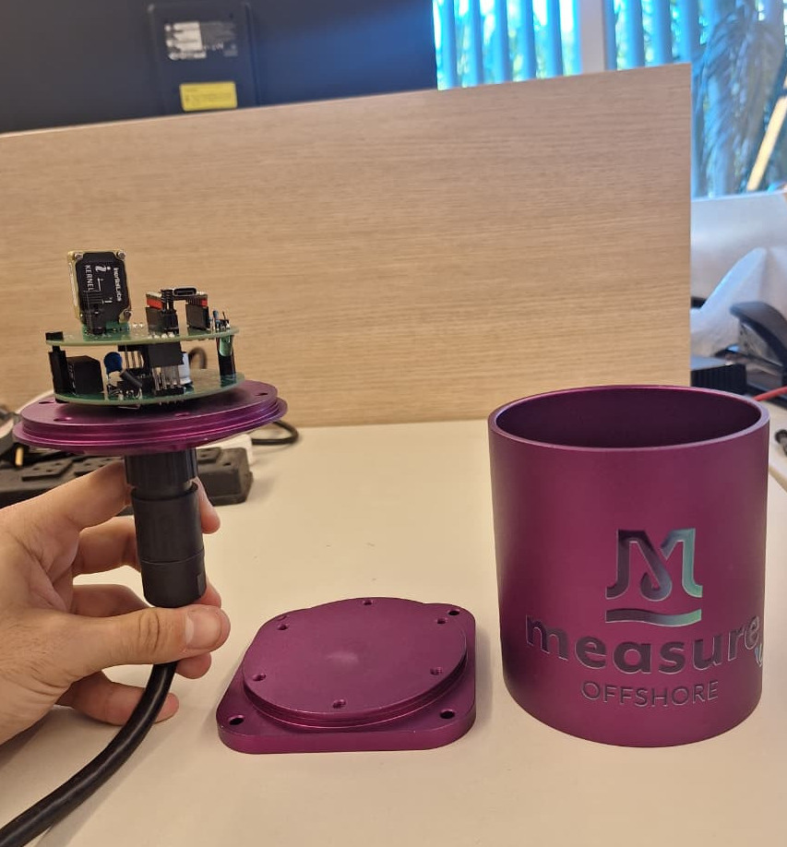
[picture p84: figure]

O compartimento usinado apresenta acabamento superficial de alta qualidade, com tolerâncias que garantem o encaixe preciso das tampas no corpo cilíndrico e a compressão uniforme dos anéis O-ring. Os eixos cartesianos X, Y e Z estão gravados na face superior do compartimento para referência de orientação durante a instalação. Com o hardware e o encapsulamento definitivos, a calibração foi o próximo passo, descrita na seção seguinte.

## 8 Calibração e Metodologia Experimental

A calibração de um dispositivo inercial consiste em determinar os coeficientes de correção que minimizam o desvio entre as leituras do sensor e os valores de referência rastreáveis. No DRMM, esse processo envolve testes estáticos (verificação do bias e do ruído em repouso) e testes dinâmicos (verificação da linearidade e da resposta em movimento), utilizando como referência um encoder rotativo de alta precisão montado no eixo de um pêndulo.

### 8.1 Estrutura do Pêndulo de Calibração

O pêndulo foi montado em uma escada de alumínio com altura de aproximadamente dois metros, utilizando articulação de eixo único que permite oscilações livres no plano de roll com amortecimento mínimo. Como referência angular, adotou-se o encoder incremental modelo E40S6-5000-6-L-5 da Smartec Automação, com resolução de 5000 pulsos por revolução, equivalente a 0,072◦ por pulso. Essa resolução é significativamente superior à

precisão dinâmica especificada para o KERNEL (0,3

◦
), garantindo rastreabilidade adequada para a calibração.

Figura 27: Pêndulo de Calibração e Encoder Incremental

(a) Diagrama Esquemático (artigo)
(b) Encoder E40S6-5000-6-L-5
(c) Encoder instalado no eixo do pêndulo

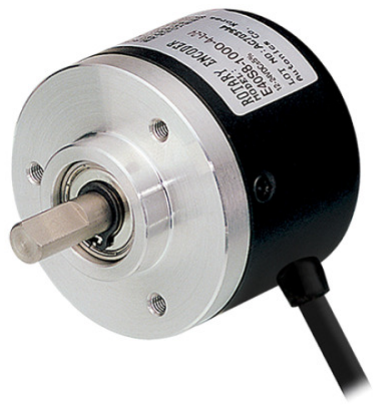
[picture p85: figure]

Fonte: Autoria Própria

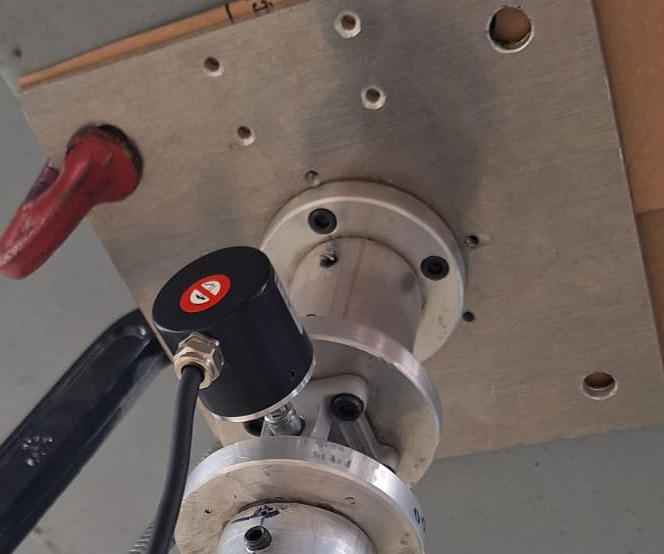
[picture p86: figure]
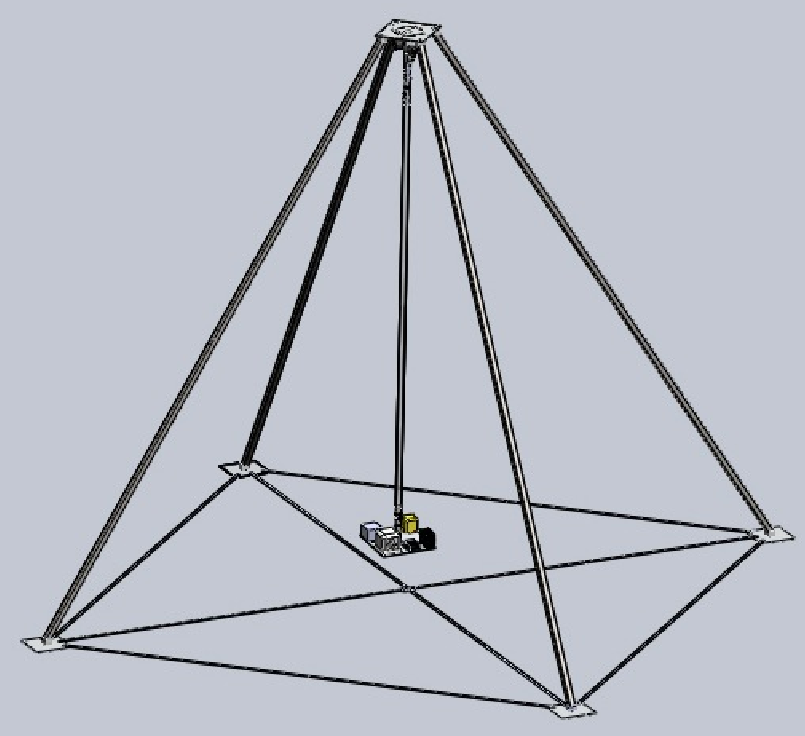
[picture p87: figure]

A arquitetura do pêndulo simples é vantajosa pois o movimento segue uma função senoidal com amortecimento exponencial natural do atrito do ar, dispensando motores ou atuadores artificiais. Isso permite que os testes dinâmicos e estáticos sejam realizados sequencialmente em uma única sessão: primeiro as oscilações de grande amplitude (calibração dinâmica) e, na sequência, o pêndulo para naturalmente (calibração estática), sem intervenção do operador.

### 8.2 Protocolo de Calibração

O protocolo de calibração foi definido com base em procedimentos similares aos adotados pela Kongsberg Maritime (Kongsberg Maritime, 2024). Cada sessão compreende: aquecimento de 5 minutos em movimento lento (estabilização térmica e convergência de bias), fase dinâmica de 20 minutos com oscilações entre ±2

- e ±15◦
, fase estática de 10
minutos em repouso e processamento dos dados pelo HMS para geração dos coeficientes de calibração por regressão linear.

Figura 28: Validação do Encoder e Diagrama de Calibração

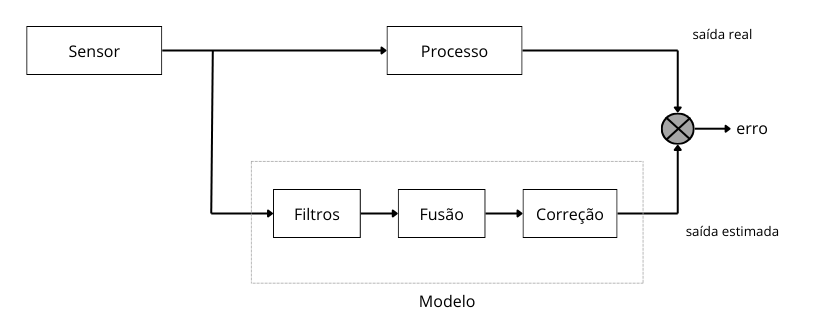
[picture p88: figure]

Fonte: Autoria Própria

O teste de repetibilidade do encoder (esquerda) confirma que a leitura de posição é consistente entre ciclos de movimento, com desvio máximo de 1 pulso (0,072◦
) para a
mesma posição angular. O diagrama de fluxo (direita) apresenta as etapas da calibração de forma sequencial, garantindo que as condições de aquecimento e estabilização sejam sempre respeitadas antes da coleta dos dados de referência.

### 8.3 Testes no Laboratório LAMCE

Os experimentos de calibração foram realizados no Laboratório de Análises e Manutenção de Componentes Eletrônicos (LAMCE), onde temperatura e interferências eletromagnéticas foram controladas para assegurar condições reprodutíveis.
O painel esquerdo mostra o DRMM e o Kongsberg MRU 5 fixados lado a lado na plataforma do pêndulo, na mesma orientação e sob as mesmas condições de temperatura e vibração. Essa disposição paralela é fundamental para garantir que qualquer diferença entre as medições dos dois dispositivos seja atribuída exclusivamente à diferença de desempenho, e não a condições ambientais distintas. Os resultados obtidos nesses experimentos são analisados na seção seguinte.

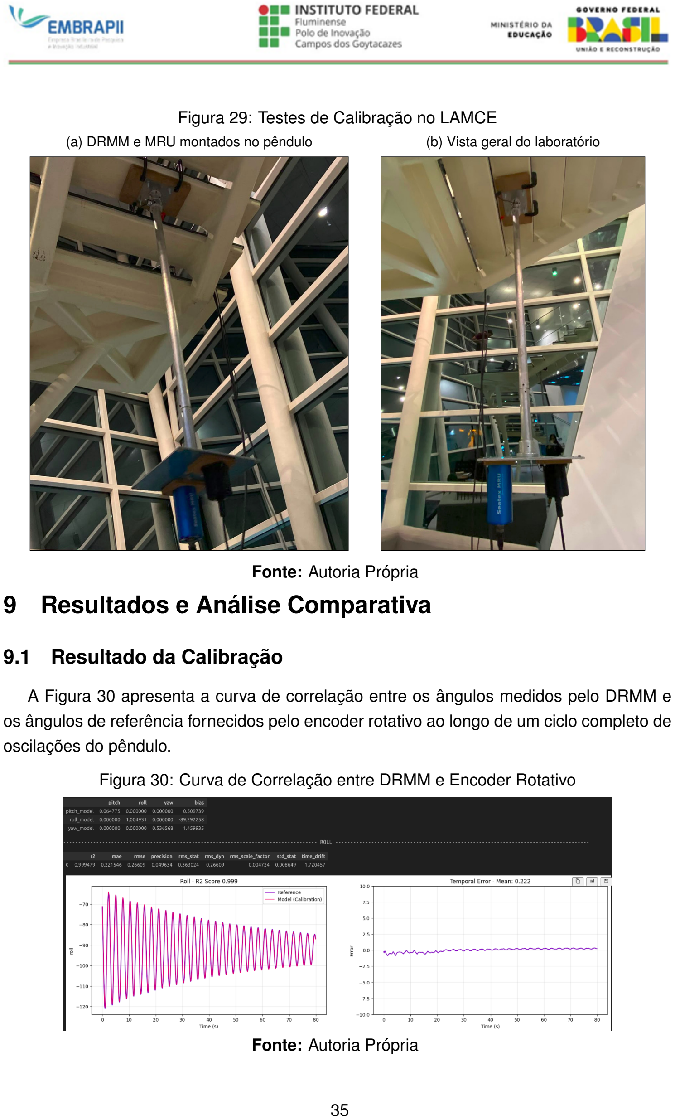
[picture p89: page 35]

Figura 29: Testes de Calibração no LAMCE

(a) DRMM e MRU montados no pêndulo | (b) Vista geral do laboratório

Fonte: Autoria Própria

## 9 Resultados e Análise Comparativa

### 9.1 Resultado da Calibração

A Figura 30 apresenta a curva de correlação entre os ângulos medidos pelo DRMM e os ângulos de referência fornecidos pelo encoder rotativo ao longo de um ciclo completo de oscilações do pêndulo.

Figura 30: Curva de Correlação entre DRMM e Encoder Rotativo

Fonte: Autoria Própria

O ajuste linear resultou em coeficiente de determinação R

2 = 0,9995, indicando que

99,95% da variância das medições do DRMM é explicada pelo modelo linear de calibração. A dispersão dos pontos ao redor da linha de ajuste é mínima, com raiz quadrada do erro médio quadrático (RMSE) inferior a 0,05◦
, dentro da especificação de precisão estática do sensor. A linearidade confirmada permite que um único coeficiente angular e um intercepto sejam suficientes para corrigir todo o range de medição do dispositivo.

Figura 31: Sobreposição Temporal das Curvas de DRMM e Referência

(a) Ciclo completo | (b) Detalhe na região de pico

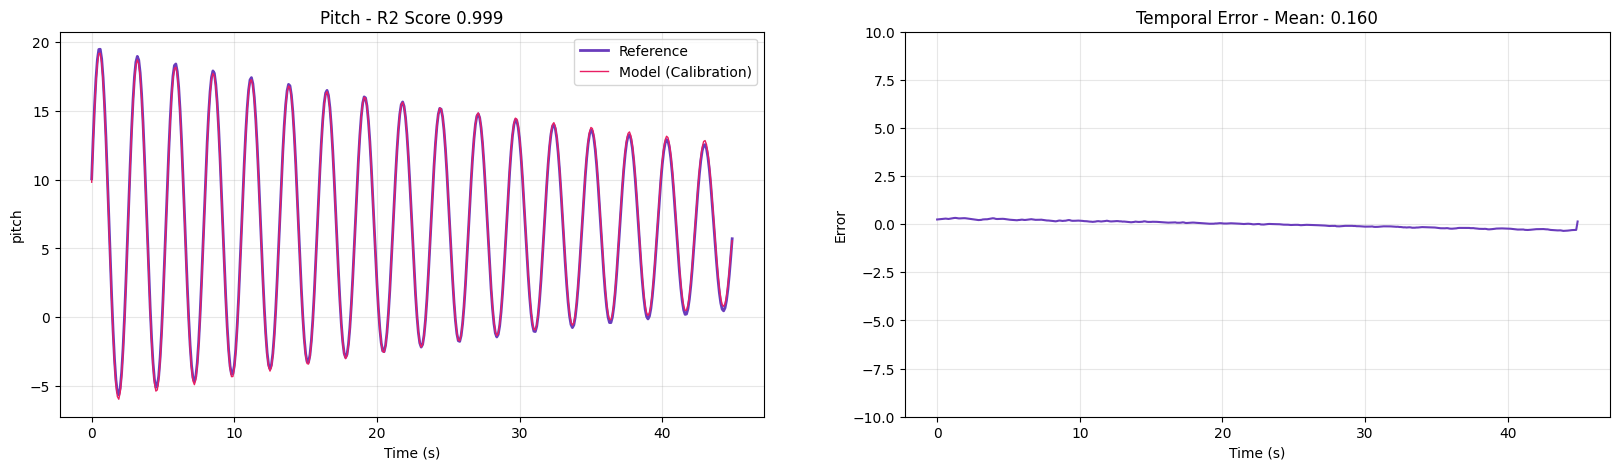
[picture p90: figure]
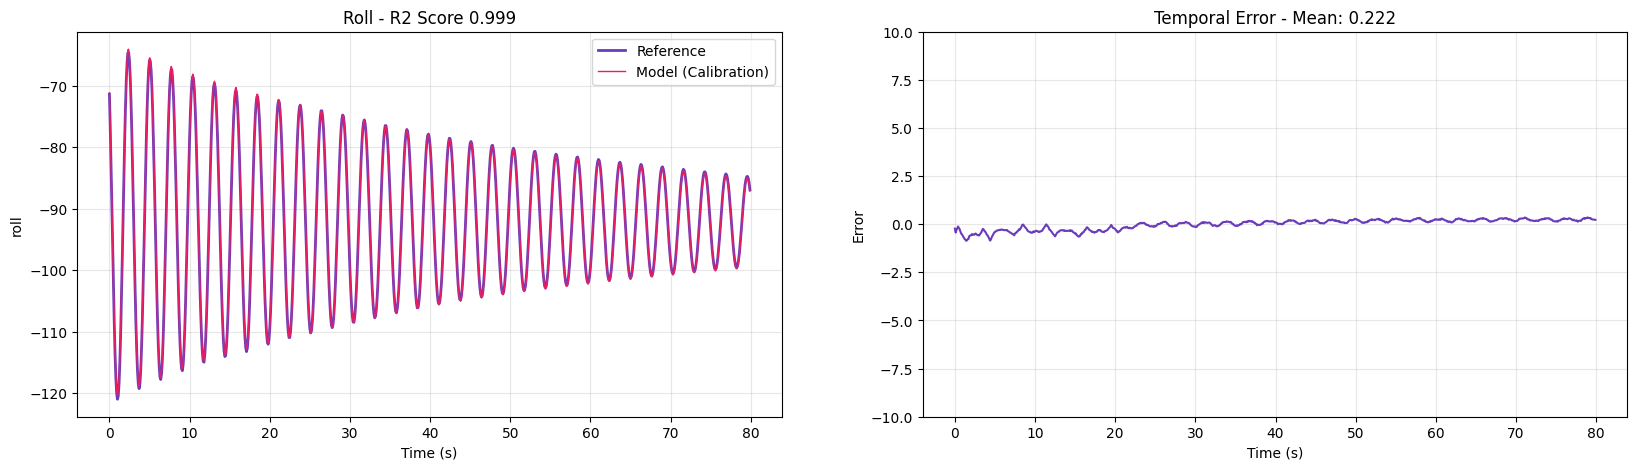
[picture p91: figure]

Fonte: Autoria Própria

A sobreposição temporal (Figura 31) confirma que o DRMM acompanha com fidelidade a curva do encoder, incluindo nos pontos de máxima amplitude, onde a velocidade angular é maior e os erros de integração tendem a ser mais pronunciados. O detalhe na região de pico (direita) evidencia que o atraso de fase entre as duas curvas é inferior a um período de amostragem (5 ms a 200 Hz), resultado compatível com o tempo de resposta especificado para o filtro de Kalman implementado.

### 9.2 Análise Comparativa com MRUs Comerciais

A Tabela 11 compara as especificações técnicas do DRMM com os dois principais MRUs comerciais utilizados pelo setor offshore.

Tabela 11: Comparação do DRMM com MRUs Comerciais de Referência

Especificação | DRMM (este projeto) | Kongsberg MRU 5 | KERNEL-120
Precisão estática Roll e Pitch | ≤ 0,03◦ RMS | 0,03◦ RMS | 0,02◦ RMS
Precisão dinâmica | ≤ 0,10◦ RMS | 0,05◦ RMS | 0,03◦ RMS
Interface de saída | NMEA 0183, RS-422 | NMEA 0183, RS-422 | RS-422 (2 Mbit/s)
Proteção IP | IP67 | IP67 | IP67
Fabricação | Nacional (Brasil) | Noruega | EUA

Fonte: Autoria Própria com base em (Kongsberg Seatex AS, 2006; Inertial Labs, 2021)

O DRMM atingiu precisão estática equivalente ao Kongsberg MRU 5 (0,03◦ RMS), com interface de comunicação idêntica (NMEA 0183 via RS-422), proteção IP67 e fabricação nacional. A precisão dinâmica do DRMM (≤ 0,10◦ RMS), embora acima da do Kongsberg MRU 5 (0,05◦ RMS), atende às faixas de alerta definidas pela NORMAM-27/DPC para ope-

rações em helidecks offshore, configurando o dispositivo como tecnicamente apto para a aplicação.

Figura 32: Comparação entre Leituras do DRMM e do Kongsberg MRU em Teste de Campo

(a) Eixo de roll | (b) Resposta em frequência comparada

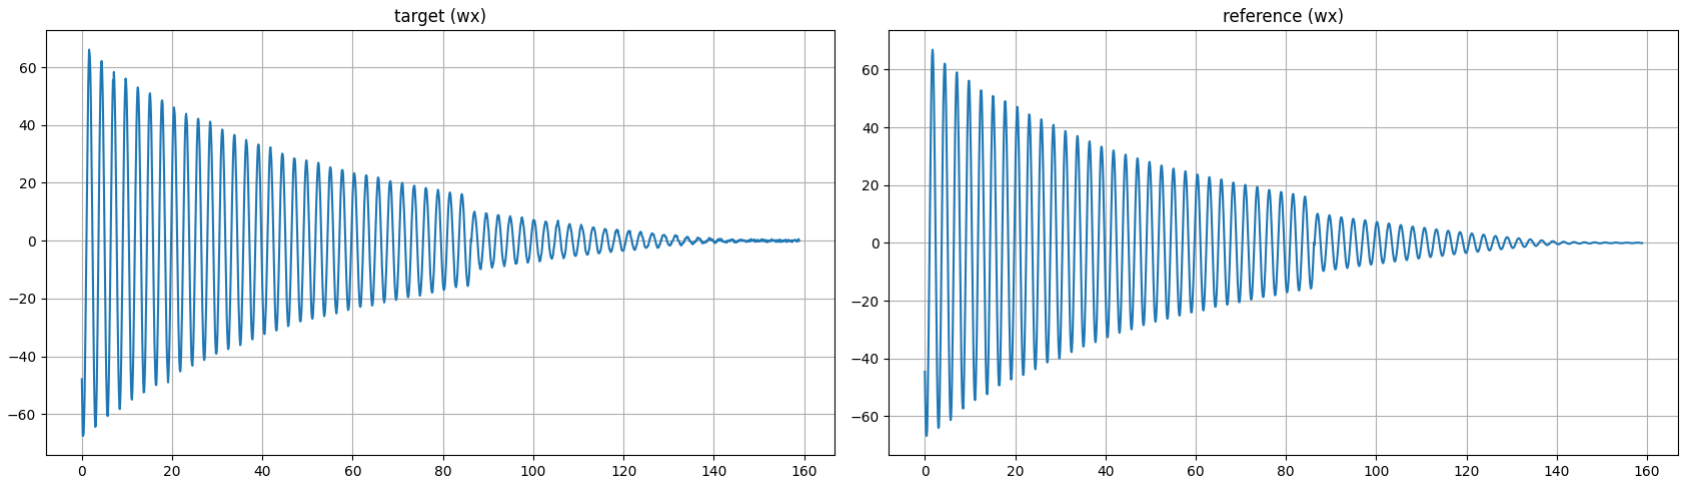
[picture p92: figure]
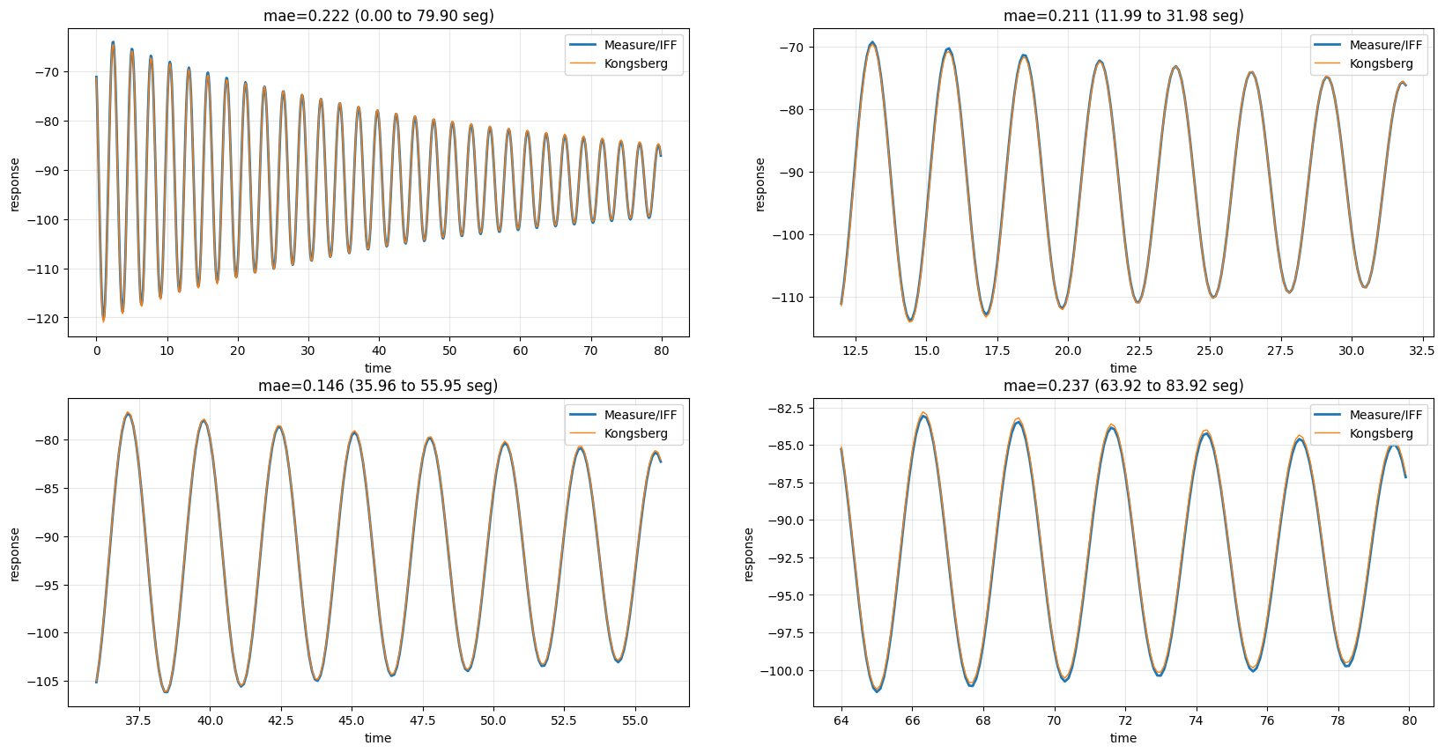
[picture p93: figure]

Fonte: Autoria Própria

A sobreposição das curvas de roll do DRMM e do Kongsberg MRU 5 (esquerda) demonstra que ambos os dispositivos respondem de forma praticamente idêntica às oscilações do pêndulo. A comparação espectral (direita) confirma que o DRMM preserva as mesmas componentes de frequência do sinal de referência sem amplificação ou atenuação seletiva, validando a qualidade dos filtros implementados e a adequação da frequência de corte adotada.

### 9.3 Validação de Temperatura

Para verificar a estabilidade térmica em condições de campo, o DRMM foi monitorado continuamente durante 12 horas de operação, com o sensor KERNEL em funcionamento constante. O gráfico da Figura 33 exibe a evolução da temperatura interna ao longo do tempo.
Os resultados confirmam que, ao ativar o sistema, a temperatura interna parte do valor ambiente e sobe de forma exponencial à medida que o sensor KERNEL dissipa calor. A curva estabiliza em torno de 64◦C, dentro da faixa operacional dos componentes eletrônicos (−40◦C a +85◦C), sem atingir níveis críticos. Esse comportamento térmico controlado

valida a eficácia do projeto de encapsulamento e confirma que a compensação interna de temperatura do KERNEL mantém a precisão das medições durante operação prolongada offshore.

Figura 33: Estabilidade das Medições com Variação de Temperatura

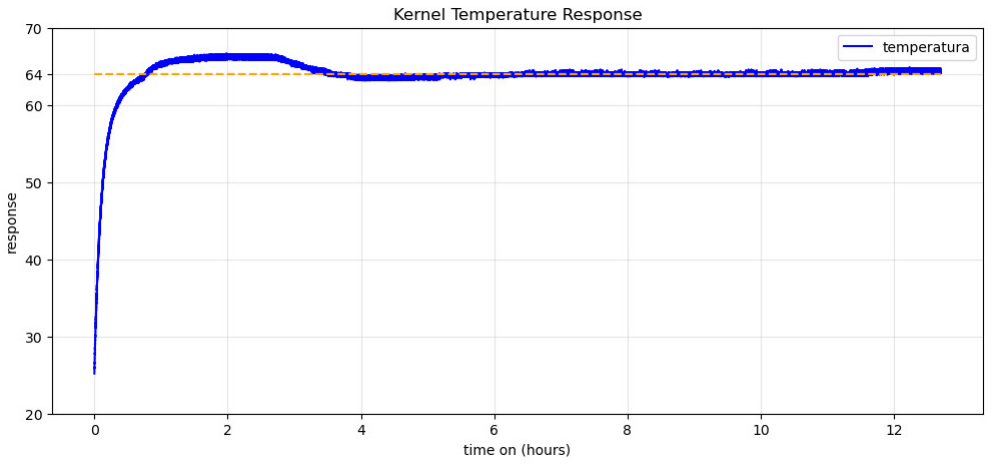
[picture p94: figure]

Fonte: Autoria Própria

## 10 Registros e Propriedade Intelectual

Paralelamente ao desenvolvimento técnico, foram realizados os procedimentos de documentação técnica e registro de propriedade intelectual, consolidando os ativos do projeto e preparando o DRMM para eventual comercialização.

### 10.1 Manuais de Instalação e Operação

Foi elaborado um manual de instalação abrangendo os procedimentos de montagem mecânica do dispositivo na estrutura offshore, a conexão elétrica dos cabos RS-422 e RS-232, a configuração dos parâmetros via protocolo RS-232 e a operação do aplicativo HMS para monitoramento e exportação de dados. O documento segue o padrão de manuais técnicos industriais, com seções de aviso de segurança, lista de materiais necessários, procedimento passo a passo e resolução de problemas comuns. Está disponível em repositório digital e acompanha o produto como entrega obrigatória.

### 10.2 Desenhos Técnicos dos Circuitos

Os esquemáticos e os arquivos Gerber da PCB final foram gerados no Altium Designer e entregues em conjunto com o dispositivo. O circuito do sistema embarcado final é apresentado na Figura 34.
O esquemático apresenta as duas placas do sistema embarcado final em uma única folha, com destaque para o isolamento galvânico da interface RS-422 (obtido por optoacopladores) e o regulador de tensão LDO que mantém a alimentação do sensor KERNEL estável em 5 V com ripple inferior a 50 mV, mesmo com variações da fonte de alimentação

Figura 34: Circuito Final do Sistema Embarcado DRMM

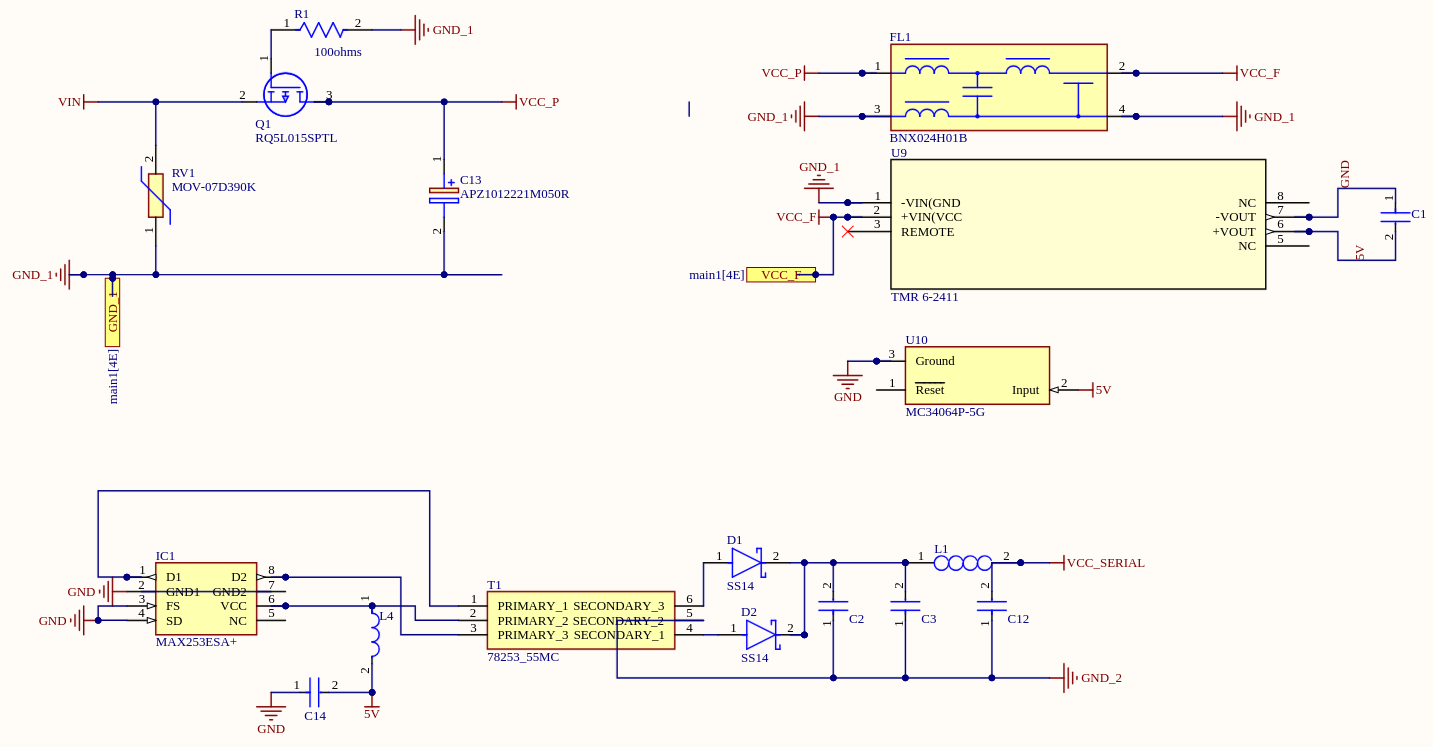
[picture p95: figure]

Fonte: Autoria Própria

entre 9 V e 36 V. Os arquivos Gerber gerados foram validados pelo fabricante Wego Sistemas antes da produção das placas.

### 10.3 Registros de Software

Os softwares desenvolvidos foram registrados junto ao Instituto Nacional da Propriedade Industrial (INPI) para proteção dos ativos intangíveis do projeto. A Tabela 13 identifica cada software pela linguagem, framework e finalidade.

Tabela 13: Softwares do Projeto e Respectivas Identificações

Software | Tecnologia | Finalidade
Firmware DRMM | C++ / Arduino (ESP32-S3) | Aquisição, filtragem e transmis-são de dados
HMS Interface | Tauri + React + Rust | Monitoramento e configuração via desktop
Algoritmos de Filtra-gem | Python 3 (NumPy, SciPy) | Prototipagem e validação dos fil-tros

Fonte: Autoria Própria

O registro dos três softwares junto ao INPI confere proteção de 50 anos sobre o códigofonte, garantindo que a implementação dos algoritmos de filtragem e fusão sensorial, bem como a interface HMS, sejam ativos protegidos da empresa. Isso é um diferencial competitivo relevante para futuros processos de licenciamento ou transferência de tecnologia.

### 10.4 Certificado de Calibração

Ao término de cada sessão de calibração, o sistema gera automaticamente um certificado contendo os coeficientes de calibração aplicados, as métricas de erro (R

2
, RMSE e
desvio padrão residual), as condições ambientais do ensaio e a data de validade recomendada para recalibração.

Figura 35: Certificado de Calibração

(a) Modelo Kongsberg | (b) Modelo Measure

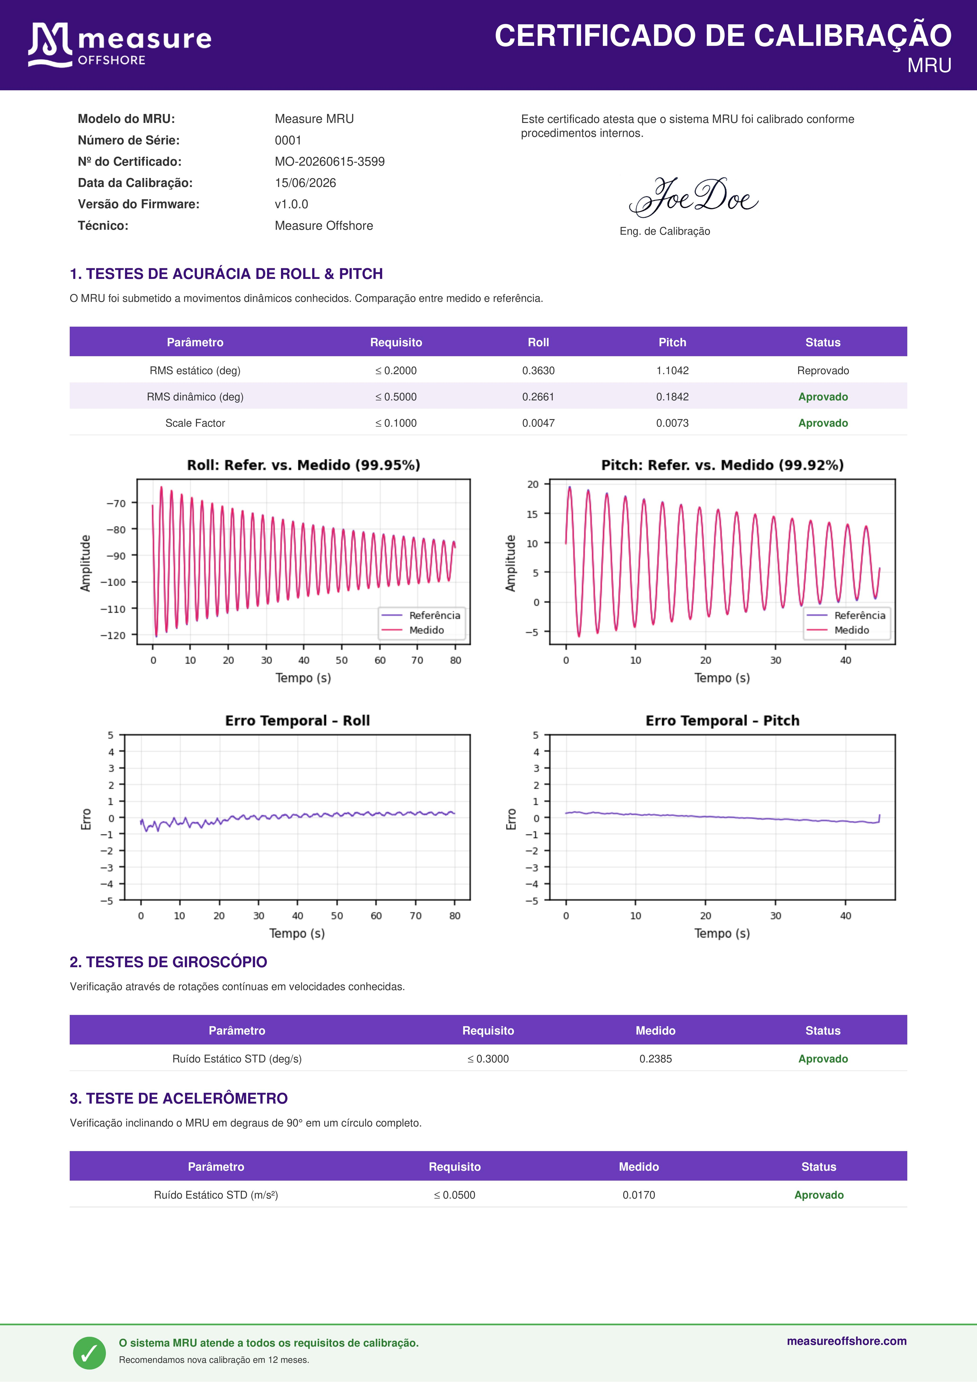
[picture p96: figure]
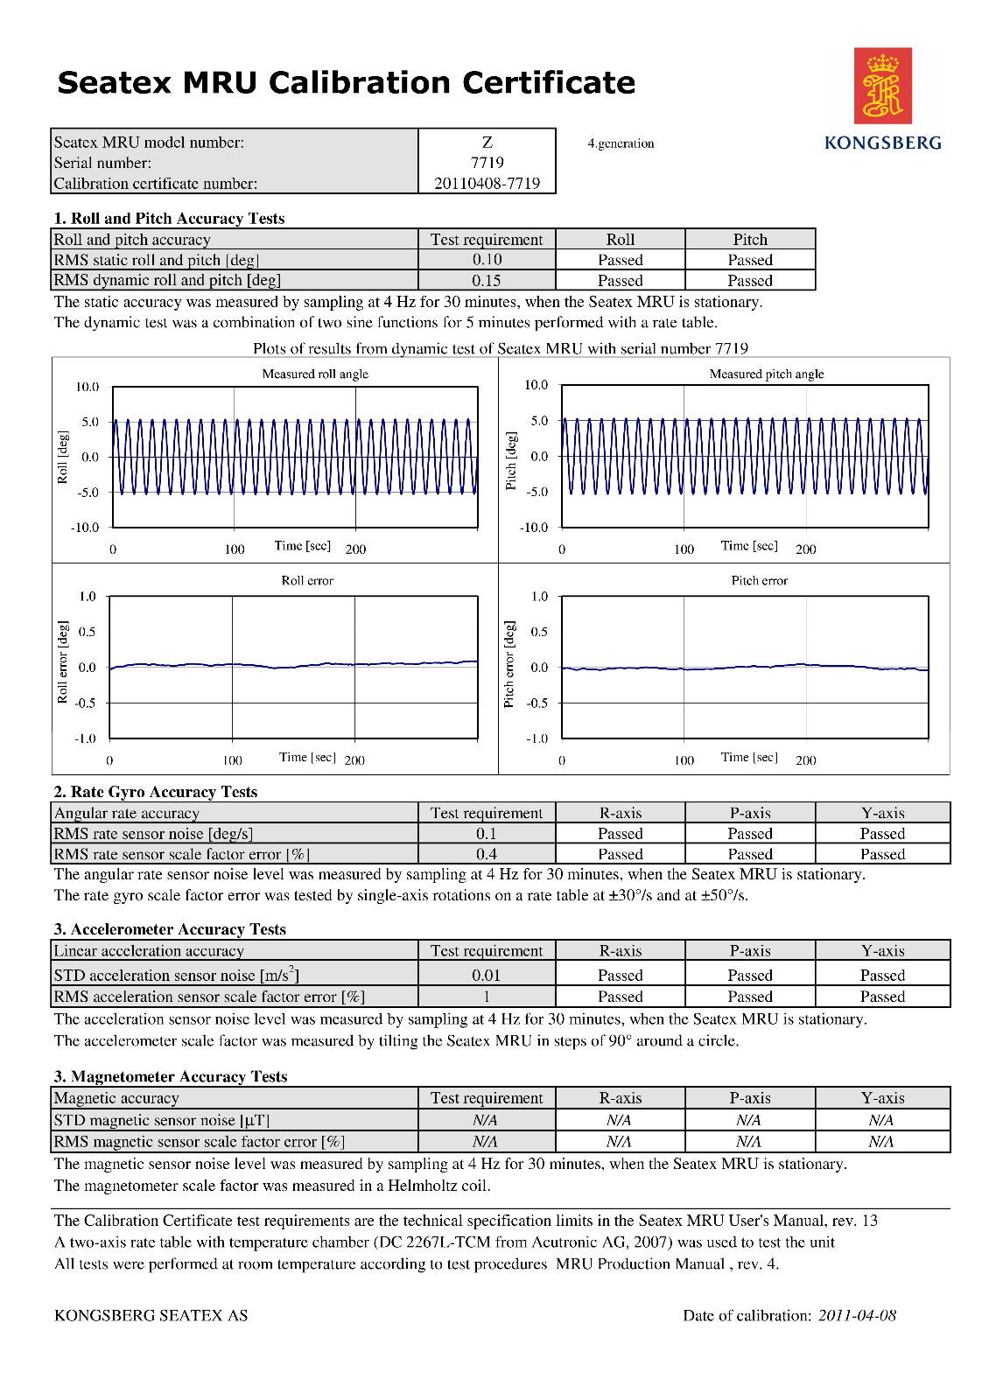
[picture p97: figure]

Fonte: Autoria Própria

O certificado emitido pelo HMS contém os campos de identificação do dispositivo, os coeficientes de calibração calculados, as métricas de qualidade do ajuste e a data de validade da calibração. A versão digital é armazenada no banco de dados do HMS e pode ser exportada em formato PDF para arquivamento técnico ou apresentação em auditorias de conformidade com a NORMAM-27/DPC.

## 11 Próximos Passos

Os resultados obtidos validam a viabilidade técnica do DRMM, mas também apontam oportunidades de aprimoramento que constituem a agenda de desenvolvimento das etapas seguintes.

### 11.1 Mesa de Calibração Motorizada de Dois Eixos

O principal limitante atual da calibração é o pêndulo de eixo único, que permite reproduzir apenas movimentos de roll de forma controlada. Para calibrar o eixo de pitch com igual rastreabilidade e automatizar o processo, está em desenvolvimento uma mesa de calibração motorizada de dois eixos, ilustrada na Figura 36.

Figura 36: Mesa de Calibração Motorizada de Dois Eixos (Projeto em Desenvolvimento)

(a) Vista isométrica | (b) Modelo 3D detalhado

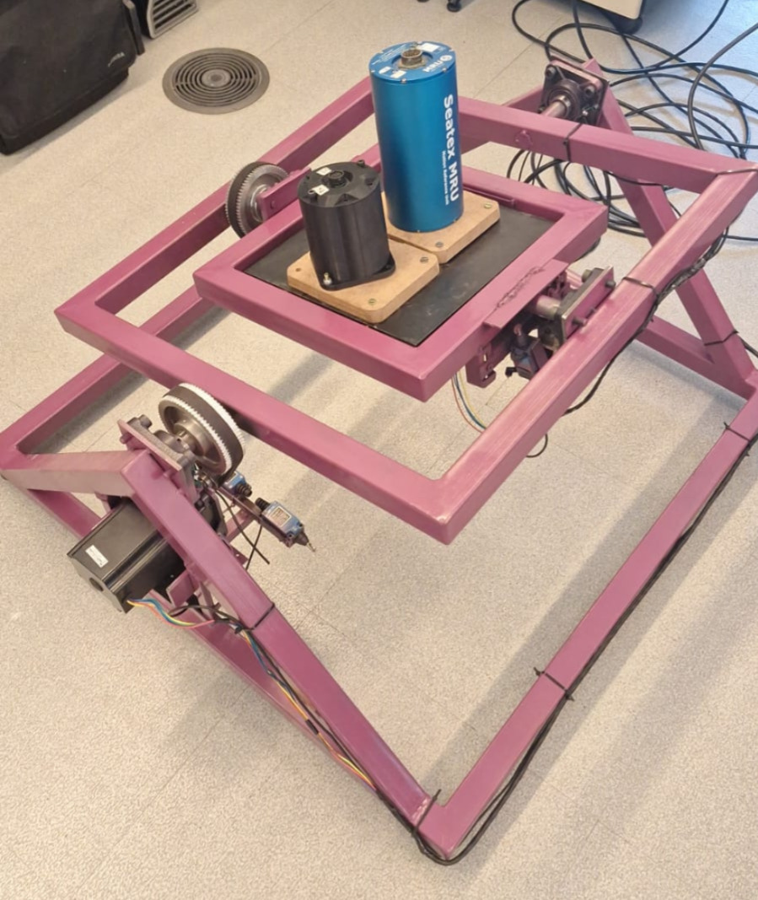
[picture p98: figure]
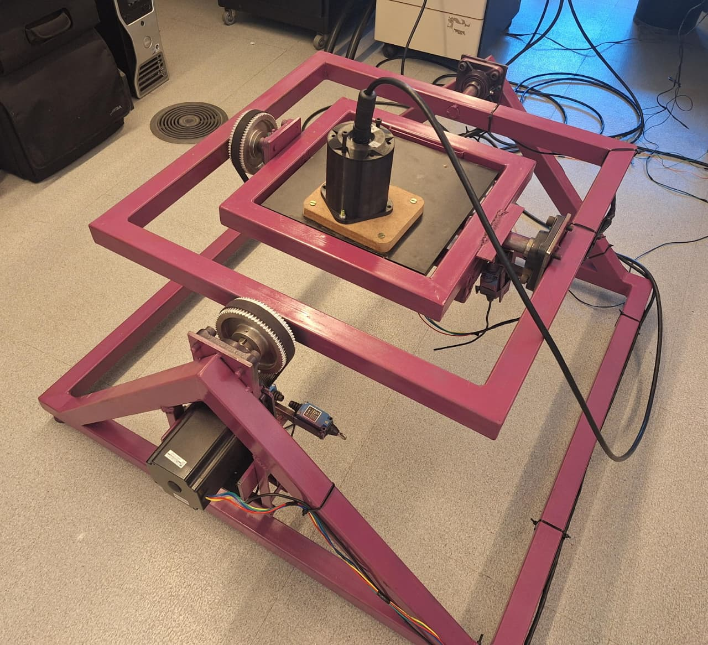
[picture p99: figure]

Fonte: Autoria Própria

A mesa incorporará motores de passo de alta resolução com controle por microcontrolador dedicado, permitindo programar perfis de movimento padronizados com amplitude, velocidade e perfil temporal definidos. A arquitetura de dois eixos independentes permite calibrar roll e pitch sequencialmente sem necessidade de remontar o dispositivo, reduzindo o tempo total de calibração de dois procedimentos separados para uma única sessão.

### 11.2 Aprimoramentos no Firmware

Três linhas de melhoria foram identificadas para o firmware. A primeira é a implementação de servidor HTTP embarcado para configuração remota via navegador web, eliminando a necessidade do cabo RS-232. A segunda é a compensação de temperatura em tempo real com modelo polinomial ajustado a partir dos dados de calibração, visando reduzir a deriva em temperatura para níveis inferiores a 0,01◦
/

◦C. A terceira é a validação dos mo-

delos de aprendizagem de máquina para fusão sensorial em um coprocessador dedicado, explorando os resultados promissores descritos na Seção 4.

## 12 Conclusão

O presente relatório final integrou e consolidou o desenvolvimento do Dispositivo de Referência de Monitoramento dos Movimentos (DRMM), apresentando de forma coesa a trajetória técnica que partiu da pesquisa de componentes e chegou à validação experimental de um protótipo funcional de tecnologia nacional.
A pesquisa e comparação sistemática de MRUs comerciais, módulos IMU e sensores MEMS estabeleceu os requisitos de desempenho e conduziu à seleção do sensor Inertial Labs KERNEL-110/120 como núcleo inercial do DRMM. A modelagem matemática dos filtros digitais demonstrou que a combinação por Covariance Intersection produz estimativas robustas mesmo com sensores de custo reduzido. A representação de atitude por quaternions eliminou as singularidades de Gimbal Lock, tornando o algoritmo numericamente estável para qualquer orientação do dispositivo.
O hardware evoluiu por três gerações de PCBs, cada uma aprimorando a robustez elétrica e reduzindo as dimensões para adequação ao compartimento cilíndrico metálico com proteção IP67. O firmware em C++ sobre ESP32-S3 Mini executa o ciclo de aquisição, filtragem e transmissão NMEA 0183 a 38400 baud em tempo real, com configuração in loco via RS-232. O aplicativo HMS em Tauri com Rust e React completa a solução como interface de monitoramento e armazenamento de dados, sendo registrado junto ao INPI como ativo de propriedade intelectual do projeto.
A calibração com pêndulo e encoder rotativo de 5000 PPR (0,072◦
/pulso) produziu coeficiente de determinação R

2 = 0,9995, confirmando a linearidade do sensor e a eficácia

do protocolo de calibração. A comparação com o Kongsberg MRU 5 evidenciou precisão estática equivalente (0,03◦ RMS) e interface de comunicação idêntica. O monitoramento térmico de 12 horas confirmou estabilização interna em torno de 64◦C, dentro da faixa

operacional dos componentes, validando o projeto de encapsulamento e a operação prolongada offshore.
Conclui-se, portanto, que o DRMM atingiu os objetivos estabelecidos, entregando um sistema embarcado nacional com desempenho equivalente ao dos equipamentos importados de referência, a um custo de produção estimado em até 60% inferior. Os trabalhos futuros, centrados na mesa de calibração motorizada de dois eixos, na compensação de temperatura embarcada e na expansão para outros segmentos navais, apontam para um caminho claro de consolidação técnica e de crescimento comercial sustentável.

## Referências

DINGLER, T. Covariance Intersection: Robust Fusion of Uncertain Information. 2024. Acesso em: 10 mar. 2025. Disponível em: <https://dingler.de>.

ElectroNOOBS. Arduino MPU6050: IMU Tutorial. 2018. Acesso em: 24 fev. 2025. Disponível em: <https://electronoobs.com/eng_arduino_tut76.php>.

Embarcados. IMUs: Unidades de Medição Inercial — Conceitos e Aplicações. 2019. Acesso em: 18 fev. 2025. Disponível em: <https://embarcados.com.br/imus-unidades-de-medicao-inercial/>. (https://embarcados.com.br/imus-unidades-de-medicao-inercial/)

FM2S Educação e Consultoria. Tipos de Riscos na Logística e Como Gerenciálos. 2015. Acesso em: 24 fev. 2025. Disponível em: <https://www.fm2s.com.br/blog/tipos-de-riscos-na-logistica>. (https://www.fm2s.com.br/blog/tipos-de-riscos-na-logistica)

Inertial Labs. KERNEL-110, KERNEL-120 MEMS Inertial Measurement Units and Digital Tilt Sensors: Preliminary Datasheet Revision 1.1. Paeonian Springs, VA, USA, 2021. Disponível em: <https://www.inertiallabs.com>.

Kongsberg Maritime. MRU 5 Motion Reference Unit Datasheet: 5th Generation. [S.l.], 2018. Disponível em: <https://www.kongsberg.com>.

Kongsberg Maritime. MRU Recalibration: How and When to Recalibrate the MRU. [S.l.], 2024. Document ID: 403873e.

Kongsberg Seatex AS. Seatex MRU 4 Motion Reference Unit: Technical Specifications. Trondheim, Norway, 2004.

Kongsberg Seatex AS. Seatex MRU 5 and H: Installation Manual, Revision 9. Trondheim, Norway, 2006.

KOTHARI, S. et al. Six Degree of Freedom Robotic Arm with Mimicking Mechanism. 2020. ArXiv preprint arXiv:2012.14286. Disponível em: <https://arxiv.org/abs/2012.14286>.

Laboratório de Controle e Automação. Universidade Federal Fluminense. Filtro de Kalman: Fundamentos Teóricos e Aplicações em Sistemas Inerciais. Niterói, RJ, 2017.

MACÁRIO, C. G. N. Utilização de Filtros Adaptativos para Detecção de Falhas em Mancais de Rolamentos. Tese (Dissertação de Mestrado) — Universidade Federal de Uberlândia, Uberlândia, MG, 2006. Disponível em: <https://repositorio.ufu.br/handle/123456789/15039>. (https://repositorio.ufu.br/handle/123456789/15039)

Marinha do Brasil. Diretoria de Portos e Costas. Normas da Autoridade Marítima para Homologação de Helideques Instalados em Embarcações e Plataformas Marítimas: NORMAM-27/DPC. Brasília, 2017. Disponível em: <https://www.marinha.mil.br/dpc/sites/www.marinha.mil.br.dpc/files/normam27.pdf>. (https://www.marinha.mil.br/dpc/sites/www.marinha.mil.br.dpc/files/normam27.pdf)

MORAES, R. L. d. Caracterização de Sensores Inerciais do Tipo MEMS para Medição Direcional de Ondas. Dissertação (Dissertação de Mestrado) — Universidade Federal do Rio de Janeiro, Rio de Janeiro, RJ, 2015.

RAMIREZ, A. J. P. Automação de plataforma de movimentos 6 dof para simulador de voo em realidade virtual imersiva. In: Anais do Congresso Brasileiro de Automática. Campinas, SP: SBA, 2012.

RONCETTI, C. R. Elaboração de Diagramas de Limite Operacional para Procedimentos de Içamento Offshore. Dissertação (Dissertação de Mestrado) — Universidade Federal do Rio de Janeiro, Rio de Janeiro, RJ, 2014.

SHIMA, É. Trajetórias tecnológicas no segmento offshore: Ambiente, oportunidades e a experiência brasileira. In: Anais do Seminário de Inovação Tecnológica na Indústria do Petróleo. Rio de Janeiro: IBP, 2008.

WRIGHT, D. L. Fundamentos de Processamento de Sinais e Filtragem Digital para Sistemas Embarcados. 2024. Acesso em: 10 mar. 2025. Disponível em: <https://wright.edu>.
