KlaussMarchi/MRU/KalmanFusion/Documents/Method and apparatus for active heave compensation.pdf

Note: Within nine months of the publication of the mention of the grant of the European patent in the European Patent Bulletin, any person may give notice to the European Patent Office of opposition to that patent, in accordance with the Implementing Regulations. Notice of opposition shall not be deemed to have been filed until the opposition fee has been paid. (Art. 99(1) European Patent Convention).

Printed by Jouve, 75001 PARIS (FR)

(19)

# EP 2 092 402 B1

# TEPZZ Z9 4Z B_T

# (11) EP 2 092 402 B1

## (12) EUROPEAN PATENT SPECIFICATION

(45) Date of publication and mention
of the grant of the patent:
05.08.2015 Bulletin 2015/32
(21) Application number: 06820656.4
(22) Date of filing: 06.12.2006
(51) Int Cl.:
E21B 19/09 ⁽²⁰⁰⁶.01) G05D 1/02 ⁽²⁰⁰⁶.01)
(86) International application number: PCT/GB2006/050430
(87) International publication number:
WO 2008/068445 (12.06.2008 Gazette 2008/24)
(54) METHOD AND APPARATUS FOR ACTIVE HEAVE COMPENSATION
VERFAHREN UND VORRICHTUNG FÜR AKTIVE SEEBEWEGUNGSKOMPENSATION PROCÉDÉ ET APPAREIL POUR LA COMPENSATION ACTIVE DU TANGAGE
(84) Designated Contracting States:
AT BE BG CH CY CZ DE DK EE ES FI FR GB GR
HU IE IS IT LI LT LU LV MC NL PL PT RO SE SI SK TR
(43) Date of publication of application:
26.08.2009 Bulletin 2009/35
(73) Proprietor: National Oilwell Varco, L.P. Houston, Texas 77036 (US)
(72) Inventor: KYLLINGSTAD, Age
4330 Algard (NO)
(74) Representative: Lucas, Brian Ronald Lucas & Co.
135 Westhall Road
Warlingham, Surrey CR6 9HJ (GB)
(56) References cited:
EP-A2- 0 261 731 | WO-A-2005/005874
GB-A- 2 215 468 | US-A- 4 104 608

EP 2 092 402 B1

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
Description

FIELD OF THE INVENTION

[0001] The present invention relates to methods and apparatus for actively compensating heave of a vessel, to a method of starting and stopping active heave compensation, to a measurement device for measuring heave of a vessel, to an apparatus for controlling the method, to a method of installing and configuring such apparatus, and to a computer program comprising computer executable instructions for performing the method.

BACKGROUND TO THE INVENTION

[0002] The operations of many floating vessels (e.g. semi-submersible drilling rigs, drill ships and pipe-laying ships) are impeded by sea swell. Sea waves impart an up and down motion to the vessel (known as ’heave’), the period of which can range from a few seconds to 25s or so, and can be of a few centimetres to 15m or more in amplitude. This up and down motion is imparted to a load attached to the vessel. In many circumstances the motion of the load is highly undesirable and even dangerous to equipment and personnel. For example when attempting to drill a wellbore in the sea bed, the motion can cause a corresponding motion of the drill string. The up and down movement of the drill bit is highly undesirable and severely restricts the operating window of the rig. For example, it is estimated that in the North Sea as much as 20% of rig operating time is lost ’waiting on weather’ i.e. waiting for better weather when the sea is calmer:
[0003] Heave compensation is concerned with reducing the effect of this up and down motion on a load attached to the vessel. So-called ’passive’ heave compensation methods are known which rely on the load being fixed at some other point (e.g. to the sea bed). Sea swell causes the vessel to move relative to the load and a passive compensator uses compressed air to provide a low frequency damping effect between the load and the vessel. There are several disad-vantages with passive heave compensation methods and apparatus, including that the weight (typically 100-150 tons) of the passive compensator must be suspended tens of metres above the rig floor, which affects the centre of gravity of the vessel, and that the use of passive compensation is limited to loads that are attached to some other point.
[0004] So-called active heave compensation methods have been deployed in the field in recent years. An active heave compensation method involves measuring the movement of the vessel using a measuring device (for example a Motion Reference Unit or MRU) and using a signal representing the motion of the vessel to control a drive for moving the connection device (e.g. travelling block, crane hook) relative to the vessel. In principle, if the connection device is moved in a manner equal but opposite to the motion of the vessel the heave can be substantially cancelled. A major advantage of active heave compensation is that it does not rely on movement of the load itself relative to the vessel before compensation can be applied.
[0005] The drive controlling motion of the connection device may comprise an AC drawworks for example. A drawworks is a powerful (e.g. 6MW) winch that is connected to the connection device by a cable that passes through a block and tackle arrangement. Reeling in and out of the cable causes the connection device to be raised and lowered relative to the vessel. An operator command (e.g. to raise or lower the load) is superimposed onto the heave compensation so that the desired motion of the load is achieved irrespective of the motion of the vessel.
[0006] However, it has been observed in the field that such active heave compensation has an error of about 10-20% of the heave amplitude. Thus for a heave amplitude of 1m, the load can be out of position by about 0.1-0.2m. Such an error is not acceptable, particularly if lowering a string of tubulars from the surface for connection to wellhead on the sea bed for example.
[0007] Another problem of active heave compensation is that as the amplitude of the motion of the vessel due to heave increases, the demands on the drive to achieve complete compensation increases accordingly. Sooner or later each parameter of the drive will reach its limitation: force limitations, power limitations, speed limitations, and/or acceleration limitations. In this situation it can be dangerous to keep the active heave compensation in operation since some part may fail and damage equipment and/or personnel; yet at the same time it is dangerous to switch off active heave compensation since the heave of the vessel may cause similar problems. The usual method for dealing with this problem has been to set a constant threshold for each of the parameters; if one of parameters exceeds the constant threshold active heave compensation is switched off. However, this does not really address the aforementioned problem.
[0008] A yet further problem of active heave compensation is caused in activating and de-activating the compensation. In particular, large torque fluctuations can result in the motors controlling the load when heave compensation is switched on or off.
[0009] Document US 4 104 608 discloses relevant prior art.

SUMMARY OF THE INVENTION

[0010] The invention is defined by claim 1.

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
[0011] A first aspect of the present invention is based on the discovery that there are errors introduced by the apparatus that performs active heave compensation, and that these errors can be substantially corrected whereby the accuracy of the heave compensation is greatly improved (in some cases the aforementioned error is reduced to approximately 1-2%). The errors can be broken down into three main areas:
(a) errors introduced by the vessel motion measurement device;
(b) errors introduced by the drive; and
(c) errors introduced by friction in the apparatus responsible for moving the connection device.
[0012] Correcting or reducing the errors of any one, or any combination, of (a) - (c) can improve the accuracy of the active heave compensation.
[0013] One of the errors in (a) is a lead phase distortion of a heave signal output from the measurement device. In one aspect the heave signal is a signal representing velocity of the heave, whereby the measured velocity is some time in front of the real velocity of the vessel. Surprisingly it was discovered that without any corrections for (a) the heave compensation can actually become unstable. The instabilities caused the amplitude of motion of the vessel relative to a load stiffly coupled to a fixed point (e.g. the sea bed) to actually increase exponentially with time. The applicant has discovered that such observed instabilities are caused by a combination of the lead phase shift errors from the vessel motion measurement device, a high mechanical stiffness of the coupling load (e.g. a marine riser which is fixed to the sea bed) and a high vessel mobility (which is explained in greater detail below). The lead phase shift introduces a negative damping mechanism that feeds energy into the oscillator system comprising the vessel and its hydrodynamic stiffness (which is proportional to the water plane area). The instability problem is most severe for semi-submersible rigs because they have a low hydrodynamic damping and a correspondingly high mobility at their natural period (typically around 20s). When the negative damping exceeds the natural hydrodynamic damping of the vessel, the instability will appear as a resonance rig oscillation with growing amplitude. Accordingly correction of (a) should be done carefully to ensure that the lead phase error at the natural heave period is substantially (and ideally completely) cancelled.
[0014] According to one aspect of the present invention there is provided a method of actively compensating heave of a vessel to which a load is attached, there being a connection device connecting said load to said vessel, which method comprises the steps of:
(a) measuring with a measurement device the heave of said vessel and outputting a heave signal representative thereof;
(b) using said heave signal to compensate for said heave by moving said connection device relative to said vessel as a function of said heave signal, whereby movement of said load due to said heave is reduced;

said heave signal comprising errors induced by said measurement device whereby accuracy of said compensation is reduced, characterised by the steps of:

(c) processing said heave signal so as to reduce said errors and outputting an adjusted heave signal; and
(d) using said adjusted heave signal to move said connection device to compensate for said heave.
[0015] Further steps of the method are set out in claims to 2 to 53 to which attention is hereby directed.

Drive Correction

[0016] According to another aspect of the present invention there is provided a method of actively compensating heave of a vessel to which a load is attached, there being a connection device connecting said load to said vessel, which method comprises the steps of:
(a) measuring with a measurement device the heave of said vessel and outputting a heave signal representative thereof;
(b) using said heave signal to control a drive apparatus for moving said connection device relative to said vessel whereby movement of said load due to said heave is reduced;

said drive apparatus introducing errors in said movement of said connection device whereby accuracy of said compensation is reduced, characterised by the steps of:

(c) adjusting the said heave signal so as to reduce errors introduced by said drive apparatus in effecting movement of said connection device; and

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
(d) using said adjusted heave signal to move said connection device to compensate for said heave.

Dynamic Friction Correction

[0017] According to yet another aspect of the present invention there is provided a method of actively compensating heave of a vessel to which a load is attached, there being a connection device connecting said load to said vessel, which method comprises the steps of:
(a) measuring with a measurement device the heave of said vessel and outputting a heave signal representative thereof;
(b) using said heave signal to control a drive apparatus for moving said connection device relative to said vessel whereby movement of said load due to said heave is reduced;

said drive apparatus introducing errors in said movement of said connection device whereby accuracy of said compensation is reduced, characterised by the steps of:

(c) adjusting the said heave signal to compensate for dynamic friction in said drive apparatus; and
(d) using said adjusted heave signal to move said connection device to compensate for said heave.

Delay Correction

[0018] A method of actively compensating heave of a vessel to which a load is attached, there being a connection device connecting said load to said vessel, which method comprises the steps of:
(a) measuring with a measurement device the heave of said vessel and outputting a heave signal representative thereof;
(b) using said heave signal to control a drive apparatus for moving said connection device relative to said vessel whereby movement of said load due to said heave is reduced;

said drive apparatus introducing a time delay in said movement of said connection device whereby accuracy of said compensation is reduced, characterised by the steps of:

(c) adjusting the said heave signal so as to reduce errors introduced by said time delay; and
(d) using said adjusted heave signal to move said connection device to compensate for said heave.

Soft Switch

[0019] According to another aspect of the present invention there is provided a method of starting or stopping active heave compensation on a vessel, which method comprises the steps of gradually increasing or decreasing over a predetermined time the amount of heave compensation applied following receipt of a signal to switch said active heave compensation on or off respectively.

Dynamic Limitation

[0020] According to yet another aspect of the present invention there is provided a method of actively compensating heave of a vessel to which a load is attached, there being a connection device connecting said load to said vessel, which method comprises the steps of:
(a) measuring with a measurement device the heave of said vessel and outputting a heave signal representative thereof;
(b) using said heave signal to compensate for said heave by moving said connection device relative to said vessel as a function of said heave signal, whereby movement of said load due to said heave is reduced; and
(c) applying a dynamic limit to the magnitude of said compensation.

Measurement Device

[0021] According to another aspect of the present invention there is provided a measurement device for measuring heave of a vessel, which measurement device comprises a memory storing computer executable instructions for per-

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
forming any of the heave signal adjustment steps as set out above or herein. The measurement device may be a Motion Reference Unit comprising sensor(s) for measuring motion (e.g. acceleration) of the vessel. The output from the or each sensor may be processed by the MRU and sent to an electronic controller of a drawworks for example.
[0022] According to another aspect of the present invention there is provided an apparatus for controlling active heave compensation, which apparatus comprises a memory storing computer executable instructions for performing the any of the method steps above. The apparatus may comprise a computing device, such as a PLC, for installation on a vessel to control the drive apparatus (e.g. drawworks) to implement the invention. The apparatus may further comprise one or more measurement device for, in use, measuring the motion of the vessel. According to another aspect of the invention there is also provided a method of installing on a vessel the aforesaid apparatus. This method may also comprise the step of configuring the apparatus for that particular vessel.
[0023] Certain embodiments of this invention are not limited to any particular individual feature disclosed here, but include combinations of them distinguished from the prior art in their structures; functions, and/or results achieved. Features of the invention have been broadly described so that the detailed descriptions that follow may be better un-derstood, and in order that the contributions of this invention to the arts may be better appreciated. There are, of course, additional aspects of the invention described below and which may be included in the subject matter of the claims to this invention. Those skilled in the art who have the benefit of this invention, its teachings, and suggestions will appreciate that the conceptions of this disclosure may be used as a creative basis for designing other structures, methods and systems for carrying out and practicing the present invention. The claims of this invention are to be read to include any legally equivalent devices or methods which do not depart from the spirit and scope of the present invention.
[0024] The present invention recognizes and addresses the previously mentioned problems and long felt needs and provides a solution to those problems and a satisfactory meeting of those needs in its various possible embodiments and equivalents thereof. To one of skill in this art who has the benefits of this invention’s realizations, teachings, disclo-sures, and suggestions, other purposes and advantages will be appreciated from the following description of certain preferred embodiments, given for the purpose of disclosure, when taken in conjunction with the accompanying drawings.

BRIEF DESCRIPTION OF THE FIGURES

[0025] A more particular description of embodiments of the invention briefly summarized above may be had by reference to the embodiments which are shown in the drawings which form a part of this specification. These drawings illustrate certain preferred embodiments and are not to be used to improperly limit the scope of the invention which may have other equally effective or legally equivalent embodiments. Accordingly for a better understanding of the present invention reference will now be made by way of example only to accompanying drawings, in which:

Fig. 1 is a schematic side view of a drill ship according to the present invention;
Fig. 2 is a schematic block diagram of a drawworks according to the present invention in use with the derrick of the drilling rig of Fig. 1;
Fig. 3 is a schematic block diagram of the control apparatus of the drawworks in Fig. 2;
Fig. 4a is graph of the probability density of function and wave height as a function of wave period;
Fig. 4b is a graph showing rig response versus wave period;
Fig. 5 is a schematic control diagram for controlling a drive apparatus to provide heave compensation;
Fig. 6 is a schematic control diagram of the drive apparatus of Fig. 5;
Fig. 7 is a set of graphs showing the frequency response of the drive apparatus of Fig. 6 for different heave periods; Fig. 8 is a graph showing the step response of the drive apparatus of Fig. 5;
Fig. 9 is a graph of heave period versus phase and magnitude respectively for the velocity and position signals output from a measurement device;
Fig. 10 is a graph of magnitude and phase versus heave period for the transfer functions of the measurement device, drive and error;
Fig. 11 is a control diagram of an active heave compensation method according to the present invention;
Fig. 12 is a graph of heave period versus magnitude of the error function showing with compensation according to the invention and without compensation;
Fig. 12a is a graph of set speed and block position versus time showing how clipping of the set speed results in a gradual translation of the travelling block;
Fig. 13 is a set of graphs showing the magnitude of the rig heave and acceleration versus time, and the frequency spectrum of the acceleration of a drill ship;
Fig. 14 is a set of graphs showing rig heave and rig velocity signals from two different measurement devices; Figs. 15 to 24 show simulation results of implementing different corrections according to the invention;
Fig. 25 is a schematic side view of an apparatus employing a second embodiment of a method according to the invention; and

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
Fig, 26 is a schematic control diagram for controlling the apparatus of Fig. 26 in accordance with the second embodiment.

DETAILED DECRIPTION OF THE PREFERRED EMBODIMENTS

[0026] Referring to Fig. 1 a floating drilling rig generally identified by reference numeral 10 comprises a drill ship having a rig floor 12 supported on a hull 14. In this way the drilling rig floats at the surface with the rig floor supported some 15-30m thereabove. The floating drilling rig 10 may be any type of vessel or floating rig, including a semi-submersible. The drill floor of a semi-submersible is supported on columns that in turn are supported by pontoons. The pontoons are flooded with sea water such that the pontoons are submerged to a predetermined depth below the surface of the sea.
[0027] The rig floor 12 supports a derrick 16 that comprises a crown block 18 (fixed relative to the derrick), and a travelling block 20 (moveable up and down the height of the derrick). A hook 22 is suspended from the travelling block 20 for picking up loads such as a drill string 24 via a top drive 25. The travelling block 20 and hook 22 perform the function of a connection device for connecting the load to the drill ship 10. Each of the crown block 18 and travelling block 20 comprise a number of sheaves (not shown) through which is threaded a steel rope 26 (sometimes known in the art as a drill line) of 25-50mm diameter to provide a block and tackle type function. To one side of the derrick 16 the steel rope 26 is fixed to an anchor 28 on the rig floor 12, whereas to the other side of the derrick 16 the steel rope 26 is stored on a drum 29 (see Fig. 2) in a drawworks 30 located on the rig floor 12. The drawworks 30 has dimensions of about 9.22m width by 3.91m depth by 4.65m high, weighs about 84,285kg (84.3 metric tons), and can provide about 6MW of power.
[0028] In use electrical motors 31 (see Fig. 2) in the drawworks 30 turn the drum 29 so as to reel the steel rope 26 in or out. Assuming that the drilling rig 10 is not in motion itself, reeling the steel rope 26 out results in lowering of the travelling block (and anything attached thereto) toward the rig floor 12, whereas reeling the steel rope 26 in results in raising of the travelling block 20 away from the rig floor 12. In this way the drawworks 30 can be used to move objects into and out of the wellbore, and to perform other functions. The electrical motors 31 may be of any type including AC motors, DC motors or permanent magnet motors for example.
[0029] Referring to Fig. 2 the drawworks 30 comprises an electric drive 32 controlling a number (e.g. four or six) electrical motors 31 for turning the drum 29 via a gear and pinion arrangement 34. All of the electrical motors 31 are permanently engaged with the drum 29, although the number that are in operation at any one time is controlled by the electric drive 32 according to speed and braking requirements. Hydraulic disc brakes 36 provide a "parking" function, emergency braking and load lowering in the event of a power cut.
[0030] Referring also to Fig. 3 a drawworks controller 38 comprising a programmable logic controller (PLC) provides speed commands via a speed controller 39 to the electric drive 32 based inter alia on motor speed and torque data fed back to the controller 38 from a pulse encoder (not shown) on each electrical motor 31 , and on inputs from a driller control apparatus 40. The driller control apparatus 40 may comprise a joystick (not shown) in a driller’s cabin on the drilling rig 10; the driller’s cabin comprises equipment for computer control of operations on the drilling rig 10. Movement of the joystick by the driller provides an output signal that causes the travelling block 22, via the drawworks 30, to raise or lower the load on the hook 22 at a speed (also controllable via the joystick).
[0031] The drawworks controller 38 also receives inputs from three Motion Reference Units (MRU) 44, each mounted in a cabinet 45. The output from each MRU 44 is input to the drawworks controller 38 that processes the signals to provide one output representing the heave acceleration, velocity and position of the drilling rig 10 as a result of ocean swell or heave.
[0032] The drilling rig 10 will oscillate in response to sea swell or waves with a complex motion comprising three translation modes (known as surge, sway and heave) and three angular modes (known as roll, pitch and yaw). Referring to Fig. 4a the typical range of frequencies of heave (i.e. vertical motion) is usually about 0.06Hz to 0.2Hz corresponding to a wave period of between about 16s and 5s respectively. The significant wave height (peak-to-peak) can vary from zero to several meters, even exceeding 10m during severe storm conditions. The sea state can vary much from time to time, from season to season and from location to location around the world. Fig. 4b shows how a semi-submersible drilling rig responds to the different sea states. It will be noted that the relative rig heave response drops steeply as the period decreases from 18s, and therefore the rig acts as an effective smoothing or low pass filter. As sea swell is a function of bad weather, many floating drilling vessels must wait on the weather. In the North Sea for example, waiting on weather can account for over 20% of the total time the rig is deployed.
[0033] In contrast to the angular motion, the magnitudes of the translation modes vary with position on the vessel. Often they are given for or measured at the centre of gravity of the vessel where they have minimum amplitudes, but they can also be measured in a location away from the centre of gravity. In many floating drilling rigs the well centre is not located at the centre of gravity, and it is the motion of the well centre that requires compensation. Because of the difficult access and moving parts near the well centre, devices for measuring heave of the vessel are often positioned some distance from the well centre. When the MRU is located off well centre, the effective heave at the well centre can be extrapolated from the MRU position by adding the heave components from roll and pitch motions. This extrapolation,

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
which is called "lever arm" compensation, is normally performed by processing electronics inside the MRU but it can also be performed externally of the MRU in the control software (e.g. in the drawworks controller 38).
[0034] Measuring movement of the drilling rig 10 can be accomplished with a measurement device known as a Motion Reference Unit (MRU). An MRU is a device comprising linear motion sensors and gyroscopes for measuring rotational motion. The MRU used in this particular embodiment is an MRU-5 available from Kongsberg Maritime AS that measures and outputs inter alia signals representing roll, pitch, yaw and heave (any one or combination of which is herein called a ’heave signal’). The MRU-5 comprises three linear accelerometers and three Coriolis gyros for measuring linear accelerations and angular rates respectively about the three spatial axes. Other MRUs could be used however, such as the Tritech Intelligent Gyro Compass. It is also possible to construct a purpose built sensor that would measure heave acceleration, speed and acceleration only. Thus it is not essential to use an MRU-5 or similar. However, the additional sensors of such measurement devices do help improve accuracy, make for straightforward installation (the MRU-5 finds the vertical direction automatically even the MRU axis is not perfectly aligned to the vessel heave axis), and lever arm compensation.
[0035] The signals from the linear accelerometers are time integrated in the MRU to provide a velocity signal and then time integrated again in the MRU to provide a position signal. The signals from the gyros are used to make lever arm corrections if the MRU is placed some distance from the measurement point (MP). On a drilling rig it is normally desirable to measure the movement of the rig at the well centre since this most accurately reflects how the motion of the rig will affect the drill string 24 or other equipment attached to the rig 10. However, it is impractical to position the MRU at or near the well centre and therefore it is usually positioned some distance away. MRUs are usually configurable with: dimensions of the rig and its centre of gravity; X, Y and Z co-ordinates of the lever arms of the MRU and the measurement point; and with the mounting angles of the MRU in terms of roll, pitch and yaw. Appendix A to this specification shows an example of an MRU configuration report from which these configuration parameters can be seen under the headings of "VESSEL" and "SENSOR". By using these parameters and the signals from the gyroscopes the MRU can translate the outputs from the linear accelerometers into signals representing motion of the measurement point e.g. the well centre. However, it is possible to eliminate or reduce the need for lever arm compensation by using interpolation of two or more vertical accelerometers placed on different sides of the well centre or other point where the motion is desired to be measured.
[0036] Referring again to Fig. 3 three MRUs 44 are mounted in a cabinet 45 with the aforementioned MRU controller 42 that comprises a PLC with access to a memory 43 for processing the outputs from the MRUs 44 as described in more detail below.
[0037] Although advanced MRUs (such as the MRU-5 mentioned above) are able to extrapolate heave motion at the well centre from any vessel position, the relatively high noise from the gyro sensors and the lever arm compensations favours MRU locations as close to the well centre as possible in practice.
[0038] There are one hundred and eighty nine data output variables from each MRU-5. The final output signals used from the MRUs are as follows (first word is name presently given in MRU-5 manual):
(1) AccMruGY; acceleration of the rig at the measurement point in the vertical (y-axis), with positive acceleration in a downward sense;
(2) LA PosMonD; position of the rig at the measurement point, with distance increasing in a downward sense; and
(3) LA VelMonD; velocity of the rig at the measurement point, with positive velocity indicating a downward speed.
[0039] Referring to Fig. 5 a control diagram 50 shows how the signals from the MRUs 44 are used to provide active heave compensation when the rig moves with sea swell. Input signal 51 is the true rig vertical velocity vrig which is input to each MRU 44 (only one shown in Fig. 5). This is measured by the MRU 44 that provides an output vmru which is the true velocity vrig multiplied by a linear but frequency dependent transfer function G. It is to be noted that as used herein vmru and vrig are defined positive upwards while the MRU-5 defines motion positive downwards. Input signal 52 is the desired operator velocity vop which is the speed that the driller wishes to move travelling block 20 (and attached load e.g. drill string 24) up or down the derrick 16. The output vmru is subtracted in the drawworks controller 38 from the input vop to generate a set velocity vset of the travelling block 20. The set velocity vset may either be higher or lower than the desired operator velocity vop depending on whether the operator velocity vop is in the same direction as vrig at that point in time.
[0040] The set velocity vset signal is input to speed controller in the drawworks controller 38. The function of the speed controller 39 is to control the drawworks 30 to produce a travelling block motion that is close to the set velocity vset. In applying the set velocity vset it necessary to rely on the entire electrical and mechanical systems of the drawworks 30, including the speed controller, motor power electronics, electrical motors 31, gears, drum 29 and steel rope 26, as well as the crown block 18 and travelling block 20. In Fig. 4 all of these items are referred to collectively as drive 54 which has a transfer function H. Ideally the transfer function H would be close to unity, but because of limitations in the speed controller 39 and mechanical inertia, the drive transfer function H often differs substantially from unity.

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
[0041] The output from the drive 54 is an actual travelling block velocity v measured relative to the derrick 16 by sensors (not shown). If both of the transfer functions G and H are unity, v would either be zero or vop independent of vrig.
[0042] The true rig velocity vrig and the actual travelling block velocity v are summed to produce a global velocity vglobal which indicates the travelling block velocity in a fixed frame of reference, for example the sea bed. If the operator velocity vop is zero then the global velocity vglobal represents the compensation error verr in the actual travelling block velocity v introduced by the transfer functions G and H. From Fig. 4 it is possible to express verr as:

and therefore the relative compensation error E when vop is zero as:

[0043] The relative compensation error will only reduce to zero when the product GH is unity. Since neither the drive response H nor the MRU response G are perfectly equal to unity, there will always be a finite compensation error meaning that the vertical motion of the drilling rig 16 will not be completely cancelled by the movement of the travelling block 20.
[0044] It is possible to feedback a signal that is a function of the actual travelling block velocity v, position or hook load although in the applicant’s experience this does not reduce the compensation error sufficiently. In particular, one problem with such feedback is that there is no simple way to measure the error or the global motion of the travelling block 20 accurately. If the string is fixed to bottom the variable hook load represents an indirect measurement of the global travelling block position. This can be used in a slow outer feedback loop, but will not help to improve short time compensation error significantly.
[0045] In tackling the problem of further reducing this compensation error the applicant realised that it is possible to compensate for the imperfect transfer functions of the MRU 53 and drive 54, despite the complexity of this problem. A brief summary of the applicant’s analysis of the drive response and MRU response is given below.

Drive Response

[0046] Referring to Fig. 6 a control diagram 60 shows how the transfer function H of the drive 54 can be analysed. The speed controller 39 represents the electronic parts of the drive (motor speed regulator, axis conversions from the linear block axis to the angular motor axis, and the motor power electronics with current and torque controllers) and the other components represent the mechanical parts. As mentioned above the set velocity vset is input to the speed controller 39; the actual travelling block speed v is fed back to the speed controller 39. On the basis of these two inputs the speed controller 39 determines a pulling force Fpull required to implement the set velocity vset. Forces acting against Fpull include friction forces Ff
(in all mechanical parts) and external forces Fext due to the inertia of all of the moving parts, but particularly the load on the hook 22, motor inertia, drum inertia, and inertia of the steel rope 26 and sheaves. Accordingly the summation circle represents the subtraction of Fext and Ff
from Fpull yielding a resultant force applied to the load under the travelling block 20. By dividing the resultant force by the sum of inertial mass M of the motor, drum 29, steel rope 26, sheaves, travelling block 20 and load 24, the travelling block acceleration and speed v is set
[0047] Before presenting the equation of motion in rotation axis coordinates it is worth mentioning that transformation from the motor axis to the linear load axis (and vice versa) is straightforward when using the transmission radius r

Here rdrum is the radius of drum 29, nlines is the number of lines and ngear is the motor to drum gear ratio (usually >>1). Linear load velocity v to angular motor speed Ω conversion is calculated by v = r · Ω, pull force F to motor torque conversion T by T = r · F and inertia mass M to moment of inertia Jm conversion by J = r² · M. The torque and inertia moment represent all synchronously running motors. The transmission radius is dynamic and changes in small steps when the steel rope 26 shifts from one drum layer to another.
[0048] The equation of motion for each electrical motor 31 of the drawworks 30 is:

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
[0049] where Jm is the effective moment of inertia of the motor (including gear, drum, lines, sheaves and load, Ω is the motor speed (in rad/s) and the Tm and Text denote motor torque and motor load respectively. The speed controller 39 is assumed to be a standard PI controller. The motor torque can be modelled as:

where P is the PI controller gain, Ωset is the set point angular speed of the motor speed, and ti is the integral time of the PI controller. The Laplace transformed equation of motion is

[0050] By substituting a motor time constant t m = Jm / P the drive transfer function can be written as
[0051] Recalling that E = 1-GH, this expression for H implies that if the relative compensation error E is to be as small as possible, the integration time constant t
i

should be as low as possible, whereas the gain P of the PI controller should be as high as possible. In practice however, such speed control can lead to large torque fluctuations and even instabilities in the drawworks 30.
[0052] It is important for effective heave compensation correction that the drive constants tm and t
i

are determined
accurately. The latter can either found directly from the drive configuration file or it can be found experimentally, for instance by locking the motors while sending a small step speed command Ωstep to the speed controller. According to the equation of motion above torque response will be a linearly increasing torque represented by
[0053] The integration time constant is the time after which the resultant torque has reached twice the initial step value, that is T(t
i

) = 2PΩstep and the P-factor of the controller is simply the ratio of the torque step to the speed step: P = T(0)/Ωstep. Finally, the controller or motor time constant can be found from t
m = P/M where the denominator represents the total effective inertia mass of the travelling block 20 with line, sheaves, drum and motors. The mass is normally dynamic and varies with travelling block position and the amount of steel rope 26 reeled onto the drum 29. If one or more inertia terms are uncertain a test can be run to tune the inertia model. Such a test aims at measuring the ratio of motor torque to angular acceleration. This ratio is by definition equal to the effective motor inertia, which can be transformed to effective linear inertia, as explained above.
[0054] Fig. 7 shows graphs of the effect of the transfer function H on the amplitude, phase and delay of the set velocity signal vset against heave (or wave) period. Two cases are illustrated: firstly when ti
= 2s and tm = 0.73s, and secondly when ti

= 1s and tm = 0.25s. The first case represents relatively "soft" speed control i.e. where the speed controller responds comparatively slowly to the relative compensation error E. The second case represents relatively "stiff" speed control i.e. where the speed controller responds comparatively quickly to the relative compensation error E. It will be seen in the first case that for the typical range of heave period i.e. between about 5s and 16s, soft speed control results in large delay and phase shift in vset at low heave periods. The stiff speed control results in a reduced delay and phase shift for longer heave periods, but at the expense of greater amplitude change and phase shift at shorter heave periods.
[0055] Fig. 8 shows the response of the drive 54 to an input unit step function. In both cases of soft and stiff speed control, there is an overshoot 71 and 72 in the response function, although the stiffer speed control returns to the correct level nearly three times more quickly than the soft control.

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
Measurement Device Response

[0056] As described above the MRU has between one and three accelerometers for measuring the vertical acceleration of the drilling rig 10. Optionally, angular gyros and magnetometers can be used to measure pitch, roll and yaw motion of the vessel. Electronics in each MRU subtracts the static acceleration of gravity, following which the dynamic vertical acceleration is integrated once and twice to obtain dynamic velocity and position respectively of the drilling rig 10. However, because of imperfections in the raw accelerometer signal, such as offset errors and low frequency noise, each integration step must be combined with a high pass filter for removing or damping the low frequency components. Accordingly a second order tuneable high pass filter is applied at each integration step. The MRU-5 supplied by Kongsberg-Seatex uses a standard second order Butterworth filter (called General Purpose (GP) filter) for the first integration step. For the second step (from velocity to position) there are two options: the GP filter and a so-called Hydrographic Survey (HS) filter. The Laplace representation of the two filters is:

and

where ωc = 2π/(10Th) represents the selectable cut-off frequency of the filter and ε is the damping factor. The so-called heave period Th is a configuration parameter that can be selected and set by the user to between 2s and 25s. This is adjusted according to the dominant heave period either measured or expected for a particular rig in a particular location. Referring to Fig. 9 the transfer functions (magnitude and phase) for the velocity filter (G) and the combined position filter (GGPGHS) are shown versus the wave period (T = 2πi/s, where i=√-1) for the case when Th=10s and ε=0.7. From this figure it is seen that the GP filter has very small amplitude distortion but a significant lead phase shift for medium-long heave periods (one to three times the filter setting period). In contrast, the HS option of the position filter has a very small phase shift but a significant amplitude distortion in the same frequency band.
[0057] The main drawbacks of this lead phase error of the velocity signal are poor compensation accuracy and risk of instabilities. Instability means that the vessel starts to oscillate with growing amplitude at one of its natural frequencies. This phenomenon has been observed with a semi-submersible rig having the derrick and well centre between the aft rig legs, thus some distance from the centre of gravity. Growing oscillations have been observed both in the heave mode (natural period ∼19s) and in the pitch mode (natural period ∼45s). The applicant has discovered that the observed instabilities are caused by a combination of a significant lead phase error in the MRU velocity signal, high mechanical stiffness of the coupling load (e.g. a heavy fixed-to-bottom riser) and high vessel mobility. The lead phase error introduces a negative damping mechanism that feeds energy into the oscillator system comprising the vessel and its hydrodynamic stiffness. When the negative damping exceeds the natural hydrodynamic damping of the vessel, a small amplitude will start to grow exponentially. Semi-submersible rigs are more susceptible to this problem than drill ships because of the relatively small water plane area, the low hydrodynamic damping and the correspondingly high mobility at the natural periods. Pitch or roll instabilities can occur only on rigs having the well centre far away from the centre of gravity.
[0058] It is to be noted that the observed instabilities were substantially reduced when the lead phase errors were corrected as described below. Accordingly correction of errors introduced by the vessel motion measurement device should be done carefully to ensure that the lead phase error at the natural rig period is substantially (and ideally completely) cancelled.
[0059] In addition to the high-pass filters, the MRU-5 applies various types of low-pass filters for reducing high frequency noise in the signals (e.g. from vessel structure vibration, etc.). One of these filters is a tuneable vibration filter, which is a second order Butterworth low-pass filter. It is applied to the acceleration signals and to the angular gyroscope signals and the same kind of filter is applied to both. The upper cut-off frequency f
vib is 3Hz for the acceleration signal filter, while it is 10Hz for the gyroscope signal filter. The vibration filter is not applied to the velocity signal, which is processed from the raw acceleration signal.
[0060] Independently of the vibration filter settings, the angular rate signals from the gyros are also by filtered by a moving average filter over a fixed window. This filter represents a delay time of typically 0.05s and a correspondingly small lag phase distortion of the velocity components derived from the roll and pitch signals. Unless the MRU is placed

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
far away from the well centre, these components are relatively small; consequently, the vibration filters will not have any practical influence on stability.

Error Function

[0061] Knowing the two transfer functions H and G, it is possible evaluate the relative compensation error E = 1-HG as a function of heave period. Reference is made to Fig. 10 showing magnitude and phase versus heave period for all three functions. In this particular case the drive time constants are set as t
i

= 0.5s and tm = 0.25s (i.e. a relatively stiff speed controller), and ε = 0.7 and Th = 10s for the MRU filter. The magnitude of the error function has a minimum of -18 dB at a period of 8s and it increases as the period diverges from this value. Even at the minimum value, which corresponds to an error of 13%, the compensation is not particularly good. The correction methods described below will dramatically improve the compensation accuracy.

Corrected Heave Compensation

[0062] Referring to Fig. 11 a control diagram 130 shows how a correction transfer function C can be applied at correction block 131 to compensate for the errors introduced by the MRU 53 and drive 54. Applying the correction transfer function results in the relative compensation error becoming:

and therefore that E = 0 when

[0063] Substituting the expressions for G and H derived above leads to a very complicated function that can be difficult to implement in practice. However, the function can be simplified as explained below.

MR U Filter Correction

[0064] Assuming that G is equal to the second order Butterworth high pass filter discussed above, the MRU correction filter can be approximated as:
[0065] This approximation is valid when ωc <<|s|, that is when the actual heave period of the vessel is much lower than the filter cut-off period 2π/ωc. Since the inverse Laplace variable 1 / s represents integration from velocity to position in the time domain, the velocity correction term vG required to reduce the lead phase error of the MRU signal is:

where pmru is the position signal. The position signal to be used in this correction formula should preferably be the hydrographic survey signal estimated within the MRU-5, but it could also be calculated from the speed signal. In the latter case the time integration must be combined with a high pass filter.

Drive Correction

[0066] Regarding the transfer function for the drive 54 and making the assumptions above, its inverse can be written as:

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
where the term, t
i

s /(1 + t
i
s) represents a first order high pass filter with time constant t
i

or, equivalently, with an angular cut-off frequency equal to 1/t
i

. Because the s factor represents differentiation in the time domain, the speed correction term vH needed to eliminate the effect of a non-perfect drive response is:

where Fhp{amru} denotes the first order high-pass filtered value of the acceleration measured by the MRU. In contrast to the relative magnitude of vG which increases proportionally to the heave period (T=2π/|s|), the drive correction term vH decreases rapidly with increasing heave period. The latter is therefore most important for short heave periods (typically T<<10s) when the inertia forces are high and the drive fails to follow the set speed accurately. The importance of the drive correction vH is also greater for soft speed controllers (having long time constant ti
) than for stiff ones.
[0067] The effect of applying both MRU and drive corrections is shown in Fig. 12. In this case the combined compensation function is approximately

This formula represents an approximation of the ideal correction function, because both the second order MRU correction term and the cross terms arising when multiplying out the product of 1/G and 1/H have been neglected. However, the omitted terms are much smaller than the leading correction terms and can therefore be neglected. The MRU position filter function Gp= GGPGHS and the vibration filter Hvib (with 3Hz cut-off frequency) are included in the respective correction terms to account for the fact that MRU position and acceleration signal are filtered versions of the true variables. As already mentioned, the MRU-5 acceleration signal is a low pass filtered version of the raw acceleration. Hvib here represents a 2nd order Butterworth filter with damping ε=0.7 and a selectable cut-off frequency. An explicit expression for the transfer function of this vibration filter is Hvib = 1/(1+1.4· s/(2πfvib) + s²/(2πfvib)²) where the cut-off vibration frequency f
vib = 3Hz. The same parameters as used above are used in this example. It is to be noted that the error function is very much reduced over a wide range of wave periods, meaning that the proposed compensation methods have excellent potential for improving heave compensation accuracy.

Friction

[0068] So far friction has been neglected. In practice there are substantial friction losses, especially in the gear and in the sheaves. This friction is not purely linear and it can therefore not be accurately represented as an extra term in the drive response function.
[0069] A fairly simple but general model for the total friction force Ff
consists of a Coulomb friction term (that is constant but changes sign on change in direction of travelling block 20) and a linear term being proportional to the travelling block speed. The mathematical formulation for such a friction model is:

where η is the total efficiency including losses in gear transmission and in the reeving system (sheaves), Fhl is the hook load force and d is a damping coefficient (with a default value of zero) and sign(v) is the signum function (1 for positive arguments, 0 if the argument is zero and -1 for negative arguments). These friction parameters can be determined theoretically or experimentally from dedicated tests (see below).
[0070] By substituting friction acceleration af
= Ff

/M, where M is the total mass of the parts producing the friction force, the friction correction speed vF for reducing errors due to friction is:

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
where Fhp{af
} is a first order high-pass filter with filter time constant equal to the speed controller integration time constant ti
in order to produce a motor pull force matching the extra load from friction losses.
[0071] As mentioned above the drawworks efficiency η can be determined experimentally by hoisting and lowering a hook load and measuring the corresponding motor torque values. The efficiency can then be found from

where Tm↓ and Tm↑ represent the motor torque measured during slack-off and hoisting, respectively.
[0072] The expected value for the drawworks efficiency depends on the number of lines 26 and also on the line to sheave diameter ratio. A typical value with 14 lines is η = 0.89 (from a single sheave efficiency of 0.99 and a gear efficiency of 0.97). However, the measured efficiency tends to be lower at low hook loads because some of the friction losses are constant and independent of load. Therefore, the test should be carried out with some weight in the hook, typically about 100 tons.
[0073] Alternatively the drawworks efficiency can be calculated theoretically from gear efficiency ηgear, single sheave efficiency ηs and the number of lines n, by
[0074] This efficiency is relatively insensitive to the number of lines, meaning that the error by using the same drawworks efficiency for twelve and fourteen lines is roughly 1%, and therefore not a great concern.
[0075] The drive and friction corrections presented above represent an indirect method where the set value for the speed controller 39 is adjusted to compensate for the expected motion these forces (Ma + Ff
) will impose on the travelling block 20. An alternative method is to calculate the equivalent motor torque components of the forces and add these components directly to the normal output (torque) of the speed controller 39. However, this feed-forward method is only possible for speed controllers prepared for this kind of additional torque control (which are commercially available). The advantage of this feed-forward is that it does not rely on accurate estimation of the drive constants. The main disadvantage is complexity through sending an extra signal to the speed controller.

Delay

[0076] Although the delay τ had been assumed to be zero for the purposes of the drive and MRU corrections, exper-imentation by the applicant has revealed that there is a significant time delay (∼0.1s) in drive response due to signal transfer time delay rather than from softness of the speed controller 39. To correct for this delay a delay velocity correction vdelay should be added to the MRU signal, determined as follows

where t

delay is the transfer time delay of signals in the drive (default value is 0.1s) and HP{arig} is a first order high pass filter. The high pass filter has two functions: firstly it removes any residual DC component in the acceleration signal, and secondly it creates a desirable phase shift that substantially removes the phase lag from the MRU vibration filter. As mentioned above the vibration filter is a second order low pass Butterworth filter with a damping factor of ε=0.7. Therefore the optimal time constant for the high pass filter is:

where Tc is the most dominant rig heave period in the deployment location of the vessel 10 (a typical value is Th=10s).
[0077] In summary, the correction block 131 adjusts the original MRU speed signal vmru to generate a corrected version vmruCorr as follows:

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
[0078] The corrected velocity vmruCorr is then integrated in the MRU controller 42 to output a motion control signal for the travelling block 20 that substantially compensates for the actual vessel heave and makes the true global travelling block position follow the speed command from the operator more closely.

Position Correction

[0079] When the corrected MRU velocity signal (plus optional corrections) is integrated numerically in the MRU controller 42, the resulting position signal pcorr can be subtracted from the raw position signal pmru from the MRUs 44 in a feedback loop. Experience has shown that this difference will generally not go to zero but drift slowly or approach an arbitrary position. It is believed that this is caused by rounding errors and finite computing accuracies, both in the MRU and in the PLC. This means that when the drilling rig 10 returns to a previous position, the travelling block 20 may not be in the same position on the derrick 16 as it was when the rig was at that position previously. To avoid this problem, the raw velocity signal from the MRUs 44 can be corrected by a position velocity correction signal vpos which is the low pass filtered value of the difference between the velocity of the rig determined from the position signal, i.e. pmru and the corrected velocity vmruCorr as determined above, i.e.
[0080] Here the low pass filter is very slow with a time constant of several minutes, because
[0081] This correction will inhibit drift and cause the position of the travelling block 20 to oscillate around the mean value of the MRU position. It is recommended to use the output "LAPosMonD" (i.e. the lever arm corrected position signal in the vertical axis) for the rig position signal, because this contains that static component of roll and pitch.
[0082] The position correction velocity vpos is added to vmruCorr, although it is important that this correction is applied after all the preceding corrections as the drift problem can arise from the correction terms themselves.

Switch Module

[0083] Referring again to Fig. 11 a software switch 132 is used to switch heave compensation on and off, preferably in a smooth fashion to avoid abrupt transient motions. The applicant has tried a method of multiplying the MRU speed signal by a factor varying linearly from zero to unity (fade-in) or vice versa (fade-out). The drawback with this method is that the mean position of the travelling block 20 on the derrick 16 will not remain constant but be shifted by an amount depending on the start time (relative to the maximum heave position of the vessel) and on fade-in time interval. This is undesirable as is can result in a translation of the entire drill string 24 for example.
[0084] The aim is to fade-in or fade-out the heave compensation so that the travelling block position hahc follows the MRU heave position signal in a gradually increasing amount, that is

where S is a time dependent soft switch function varying between zero (no compensation) to unity (full compensation), and pmru is the position signal output from the MRU. The general active heave compensation signal to be added to the operator speed during fade-in and fade-out is, in terms of velocity

where S denotes the time derivative of S. One advantage of providing a velocity correction in this way is that there will be substantially no translation of the travelling block 20 away from its mean position during fade-in and fade-out. One example of a suitable soft switch function is

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
where x is a linearly varying coupling parameter limited between zero and unity. Explicitly,

where t

fade is the fade-in and fade-out time and σ = 1 for fade-in and σ = -1 for fade-out. This soft switch function has the following features: 1) it varies continuously, 2) its time derivative also varies continuously without steps and 3) the time derivative vanishes at the end points, that is when x approaches zero or unity.
[0085] There are many soft switch functions satisfying the above features. Another example is S = 1/2 + (2x - 1)·(1 -|x -1/2|) where x is as defined above. Such soft-switch functions are valid not only during fade-in and fade out, but also whilst the active heave compensation is fully on or off. Therefore the function can be applied continuously.

Limiting Module

[0086] Referring to Fig. 11 a limiting module 133 follows the subtraction of the active heave compensation signal vahc from the operator set velocity vop. As the motion of the drilling rig 10 due to heave increases, the demands on the drive 54 to achieve complete compensation increases accordingly. Sooner or later the drive 54 will reach one of its limitations: force, power, speed, and/or acceleration.
[0087] The most common force limitation is brake margin limitation. Brake margin is defined as the difference between maximum motor pull force and external load. If this margin becomes too small the drawworks 30 cannot stop a downwards motion within the maximum allowable stopping distance (e.g. 3m), for example when lowering a load toward the seabed, or lowering a drill string into a well bore. For safety reasons, it is therefore important to limit the downwards speed to safe level.
[0088] Electrical power limitations, be it in the drive 54 or externally in the drilling rig generators or grid system, also causes limitations in the mechanical power available i.e. the product of force and velocity. Power limitations can be positive or negative. The latter, which denotes limitations in the generative power flowing from the electrical motors 31 back to the drive controller, affects safety because it causes the brake margin to drop quickly with increasing downwards speeds. Power limitations can therefore be regarded as a dynamic speed or force limitation because the force limit drops with increasing speed. If the downward velocity exceeds the critical value at which motor pull capacity balances the external load (zero brake margin) the power limitation will make the brake margin negative and cause an unstable, free fall situation, which is extremely dangerous.
[0089] The speed limitation means that the travelling block speed cannot exceed speed limits defined by the rated motor speed (typically 2300rpm for electrical motors) or other external speed limitations, such as drum speed limitation or load velocity limitation. For example, if the load is a drill string in an open well, too high a string speed can cause dynamic pressures that can cause damage to the well bore.
[0090] Both mechanical force and electrical power limitations indirectly limit the maximum or minimum acceleration of the drive 54. In addition, slack in steel rope 26 can impose a negative acceleration limit (i.e. downwards acceleration or deceleration of upward motion) which can cause the line near the drum 29 to lose tension resulting in tangling of the spooled line. This phenomenon, which is often called "bird nesting", must be avoided because it can block further spooling and cause serious damage to the drill string 24. The line slack acceleration limit is proportional to the external hook load and can be expressed by aslack = -Fext /Msl where Msl represents the inertia mass of the lines and sheave. It can either be calculated theoretically or (more easily) experimentally as the ratio -Fext /aslack for which the fast line almost looses tension. The theoretical inertia mass can be found from the energy equation 0.5Mslv² = Σj
0.5Ji

Ωi

2 + Σj
0.5mlj

vj

2 where
Ji

, Ωi
and 0.5Ji

Ωi
2 are respectively inertia moment, angular speed and rotation energy of the ith sheave; and m, l
j

, vj
a
nd 0.5mlj

vj

2 represent mass per unit length, length, speed and translation energy of the jth segment of the drill line 26, respectively. The entire effective inertia mass M can then be found by adding also the rotational energy for the drum and motors and using the transmission radius defined above: M = Msl + (Jmotors + Jdrum/ngear

2)/r².
[0091] These acceleration limits impose restrictions in two ways. Firstly, they limit the speed indirectly so that the load or travelling block 20 can stop safely within constant or dynamic position limits. Secondly, they place limits on the speed increments of the signal sent to the drive controller.
[0092] The torque, power and acceleration limitations above can be treated as a common speed limitation ensuring that the stop length does not exceed the available or specified maximum value. Because the motor pull force varies with speed, it is not possible to give explicit expression for this speed limit. Instead, the limits (both negative and positive can

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
be calculated as described in the algorithm described in appendix D. For simplicity, the algorithm is written for the case when the block/load is moving downwards. A similar but slightly different algorithm applies when the block is hoisted; the main differences are that 1) the speed is stepped in positive direction to find the stopping length upwards and 2) the external load acts in the opposite direction to the block motion. SI units are assumed for all variables in the algorithm.
[0093] It is important to apply the limiting module 133 after summation of the operator and active heave compensation speeds, because it is the resulting set speed vset that must be limited to avoid the aforementioned hazardous situations. When the limiting module 133 is active, the speed signal vset is reduced or clipped some portion of time. Very often it clips the signal asymmetrically. For instance, high loads and/or low regenerative power limits will causes the negative speed peaks to be clipped, not the positive ones. However, this asymmetric clipping causes the mean position of the travelling block 20 to move upwards along the derrick 16 by a distance proportional to the amount of clipping. This motion is normally very undesirable. To overcome this problem the limiting module 133 has a clipping compensation function. It has been found that a simple but effective function is able to solve this problem. In particular, the following position error feed-back function is used to determine a corrective speed vp to be added to the input speed (vset) of the limiting module 133:

where ωpf is a small feed-back constant (typically 0.1s⁻¹ or less), vset is the input set speed and vout is the clipped output value from the limitation module. As an example, if the downwards speed is clipped, the integrand and vp become negative, meaning that the net upwards motion due to clipping is stopped and stabilized. Figure 12a shows a simulation example where the downwards acceleration is actively limited. This limitation causes the sinusoidal speed to be clipped, mostly on the negative side of the speed curve. If this clipping error is not compensated for, the travelling block 20 will start to move upwards as visualised by the dashed position curve in the lower graph. With a clipping compensation this motion is limited.
[0094] A major advantage of the limiting module 133 is that it does not turn off the active heave compensation as some prior systems do if one or more of the limitations are reached or exceeded. Heave compensation is often applied when the string is attached to a fixed point to the sea bed. It is therefore much better to temporarily skip the accuracy goals and obtain a partial compensation, than turning off the heave compensation completely.

Algorithms

[0095] Referring to Appendices B, C and D algorithms are shown for implementing the various corrections described above. The algorithms are designed to be implemented entirely in software and stored as a set of computer executable instructions in the memory 43 accessible by the PLC of the drawworks controller 38. In this way the PLC may act on the input signals from the MRUs 44 and from the operator to provide the final corrected velocity vset for the drive 54 that will achieve the desired travelling block velocity v. It is to be noted that the symbol " = " used in the formulae in Appendices B, C and D means assignment. When the same variable appears on both sides of an assignment, the right hand parameter represents the previous value while the left hand parameter represents the updated one.

Correction Module

[0096] At step BS1 the drawworks controller 38 reads, sets or calculates the list parameters and variables shown and holds them in memory. At step BS2 the speed correction term vG is determined using the heave signal from the MRU 44 and the result stored in memory. As explained above three MRUs are used to provide redundancy and to check for errors. Each raw signal from each MRU (acceleration, velocity and position) is sampled by the PLC every clock cycle (time Δt). The values are compared and are averaged if within an acceptable tolerance (typically 60.05 m/s for the velocity signal). If one of the signals is outside the tolerance it is discarded and not used in the average calculation.
[0097] At step BS3 the corrections for the drive response are applied to the raw signals from the MRUs.
[0098] The raw acceleration signal amru is passed through a low-pass filter with a time constant of t
i

i.e. the speed
controller integration time constant. In order to obtain the high-pass filtered value of the acceleration signal as required by vH = t
mFhp{amru} the low-pass filtered signal is subtracted from the raw acceleration signal representing movement of the drilling rig 10. The speed correction term vH is then calculated by multiplication with the motor time constant tm of the speed controller 39 and the result stored in memory.
[0099] At step BS4 the friction correction speed vF is determined using the formula described above. The friction acceleration is then determined:

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
where M is the total inertial mass in kilograms of the drive 54. The function af
therefore varies with measured travelling block speed v and measured hook load Fext. If the drilling rig 10 is in motion as a result of sea swell, the acceleration function af
is an oscillatory function similar to a square wave.
[0100] The acceleration function value is passed through a low pass filter with a time constant t
i

i.e. the integration
time constant of the PI controller. The filtered value is then subtracted from the original value to provide a high pass filtered value af,hp which is used to determine the friction correction speed vf

and the result stored in memory.
[0101] At step BS5 the delay correction speed vdelay is determined by filtering the raw acceleration value from the MRUs 44 with a low-pass filter with time constant of t
hp,
delay and the resulting value subtracted from the raw acceleration value to generate a high-pass filtered acceleration value ahp. This value is then used to determine the delay correction speed vdelay
[0102] Having calculated all of the velocity corrections, the PLC is able to apply them to the average of the raw velocity signals vmru from the MRUs at step BS6. Firstly the AHC velocity vahc is set in memory to the vmru value. The operator is able to select which of the various corrections for the MRUs, drive, friction and delay are applied (although usually all corrections are applied). Accordingly a check is made by the PLC before applying each velocity correction value calculated above. Assuming all are applied the new corrected velocity vmruCorr is calculated as

and the result stored in memory. Optional position correction at step BS7 ensures that the integral of corrected heave compensation speed vmruCorr matches the mean value of the MRU position signal, as explained above.

Soft Switch Module

[0103] Referring to Appendix C the algorithm for the soft switch module is shown. At step CS1 the drawworks controller 38 reads, sets or calculates the list parameters and variables shown and holds them in memory.
[0104] At step CS2 the switch module 132 determines if active heave compensation (AHC) is on or off. There are four possibilities:
(1) AHC is on and is past the fade-in period;
(2) AHC is on and in the fade-in period;
(3) AHC is off and past the fade-out period; or
(4) AHC is off and in the fade-out period.
[0105] Whether or not AHC is on or off is determined by a signal from the operator. If AHC is on a direction parameter s is set s = 1, whereas if AHC is off s is set s = -1. The direction parameter determines which of the four states above is current. A soft switch parameter x is set initially as x =0 and is subsequently determined as:

where Δt is the PLC clock frequency (usually between about 20ms and 50ms) and t fade is the desired fade-in/out time (default is 10s). Thus x either increases or decreases in increments of Δt/t
fade depending on the value of s. The clipping

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
function x = max(0, min(x,1)) means that if x goes below 0 it is reset to 0, whilst if it goes above 1 it is reset to 1.
[0106] The suggested trigonometric soft switch factor S = (1- cos πx)/2 is then determined and its time derivative Sdot is determined from numerical time differentiation of S.
[0107] The resulting active heave speed signal is then determined as:
[0108] The soft switch function is always applied to the velocity signal for the travelling block 20. One advantage of this is that full, partial (fade-in or fade-out) or zero active heave compensation is achieved simply by controlling the direction parameter s.
[0109] The algorithm above is repeated every clock cycle of the PLC (usually about every 20-50ms) so that vset is substantially continuously adjusted while active heave compensation is on.

Limiting Module

[0110] Referring to Appendix D the algorithm for the limiting module 133 is shown. It will be recalled that this algorithm applies to downwards motion of the travelling block 20 only (remembering that downwards motion is defined as negative herein). At step DS1 the drawworks controller 38 reads, sets or calculates the parameters and variables shown and holds them in memory. The input parameters are determined as follows:
- aramp = Ωmax*r/tramp where Ωmax is maximum motor speed (in rad/s), r is the transmission radius (defined earlier) and tramp is the ramp time, typically 2s or longer.
- FmMax = nm*TmMax/r where nm is the number of active motors and TmMax is maximum torque per motor.
- hmin = max(hmin0, h-Lstop) where hmin0 is an absolute minimum block position (typical 0.5m) and Lstop is a maximum stop length (typically 3m).
- M and Msl are either constants determined experimentally or they are calculated theoretically as explained earlier.
- Pmin and Pmax are either constants (matching the setup of the drives) or they are read externally from the vessel power management system
- vmMin = -Ωmax*r.
- Δvstd is set to a constant, typically 0.1m/s or lower. Low values favour accuracy but increase computing time.
- Δt is the cycle time of the PLC program, dependent on the total computing load of the PLC. Typical values are in the range of 0.01 to 0.1 s.
- ωclip is a constant typically set to 0.1s⁻¹.
[0111] At step DS2 three integration variables are initialised as shown: speed vold, accumulated stop length Lacc and speed increment Δv (typically 0.1ms⁻¹).
[0112] The purpose of steps DS3 and DS4 is to determine a minimum speed (i.e. maximum in a downwards sense) for the travelling block 20 at which the pull force available from the drawworks exceeds the force Fext exerted by the hook load. At step DS3 the minimum speed limit vmin is set as Vold - Δv. At step DS4 the maximum motor pull Fmax is selected as the minimum of the motor pull force limit FmMax and the force available from the regenerative power limit Pmin and the current minimum speed limit vmin. If the net pull margin (defined as Fmax - Fext) is less than zero the speed increment is halved and the algorithm returns to step DS3. In this way minimum speed is gradually increased toward zero (i.e. downward velocity is reduced) until the net pull margin is greater than zero to ensure that there is some margin for stopping movement of the load. Only when the pull margin is greater than zero does the algorithm proceed to the next step.
[0113] At step DS5 the acceleration capacity of the motors is calculated and the maximum acceleration amax set to the minimum of the motor capacity and the acceleration limit aramp imposed by the operator or set by the drive. At step DS6 the incremental change ΔL in the stop length caused by the change in vmin is determined. The total stop length is then adjusted by adding ΔL to the stop length Lacc and the new value compared to the distance between the travelling block 20 and a lower stop position. If the total stop length is not greater than this distance then the velocity vold is set to vmin and the algorithm returns to step DS3 where vmin is incremented by Δv and the algorithm repeated until the total available stop length is reached; when this occurs the algorithm proceeds to the next step.
[0114] In this way the magnitude of vmin is gradually increased until the available stop length is reached. At that point there are two values: a first value (e.g. -1.4ms⁻¹ where the stop length is not reached and a second value (e.g. -1.5ms⁻¹) where the available stop length has been exceeded. It is then necessary to interpolate between these two values to find the speed closest to the available stop length. This is performed in step DS7 where the vmin is gradually increased from

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
the first value until the available stop length is reached.
[0115] At step DS8 vmin is selected as the maximum (i.e. closest to zero and therefore smallest magnitude) of the current value of vmin and the rated velocity of the drive vrated. At step DS9 the minimum (i.e. greatest magnitude) motor force is selected from the motor push force limit FmMin and the force available dependent on the motoring power limit Pmax and the current value of vmin. The net downwards push force Fmin is then determined from the selected value and the force exerted by the load Fext.
[0116] A motor based acceleration limit amotors is then determined at step DS10 using Fmin and the total inertia mass
M. A line slack acceleration limit as/ack is determined in the next step using the force exerted by the hook load Fext and the inertial mass of the drill line and sheaves. The most restrictive value of these acceleration limits and aramp is then selected and set as amin to ensure that none of these acceleration limits are exceeded.
[0117] At step DS 11 a range for the set speed vset is then determined on the basis of the maximum and minimum acceleration capacities of the drive and the current value of vmin The set speed vset is then adjusted for clipping (described in greater detail below). Finally the limited speed vlim that the drawworks 30 is instructed to use is selected by comparing the set speed firstly with the maximum allowable speed (determined from the maximum acceleration capacity), and selecting the lower value, and then comparing the result with the minimum allowable speed (determined from the minimum acceleration capacity) and selecting the maximum value. In this way the limited speed is set to vset if it falls within the allowable range, otherwise it is set to either the maximum or minimum allowable speed. In this way a safety limit is put on the operation of the drawworks 30 however controlled by the operator and/or active heave compensation.
[0118] Since the limiting module 133 may clip the operator set speed, which is a combination of the operator speed and the heave compensation speed, this will result in a position error of the travelling block 20. At step DS12 the position error is determined based on the difference between the set speed and the limited speed, and a clip correction velo city vclip is determined as a fraction of the position error. This clipped velocity is used in the next iteration of the algorithm at step DS11 to compensate the set speed. The set speed must still remain within the limits as described above however.
[0119] It is to be noted that each of the algorithms can be used independently of the others. For example, equipment may be provided that incorporates the functionality of any one of the algorithms.

Measurements

[0120] Referring to Fig. 13 a graph 140 shows rig heave and rig acceleration versus time, whereas another graph 141 shows the frequency spectrum of the acceleration signal in graph 140. The data was recorded on the drillship Deepwater Frontier on 10th October 2001. The rig acceleration 142 and the rig heave 143 are the outputs PosMonD and AccMonD from an MRU-5, i.e. position and acceleration signals in the vertical axis respectively (positive acceleration upwards). It will be noted that the acceleration signal 142 has a frequency of about 0.1Hz and that noise is superimposed on the trace. Furthermore it can be seen from graph 141 that noise in the acceleration signal is almost constant from about 1Hz up to 4.5Hz (which is the Nyquist frequency for these measurements). This indicates that the cut-off frequency in the MRU vibration filter is set too high. Furthermore the low frequency noise (<0.03Hz) could be an aliasing effect from the sampling frequency of 9Hz.
[0121] Referring to Fig. 14 a graph 160 shows how rig heave varies over a two minute period, and a graph 161 shows how heave velocity varies over the same time. The graphs 160 and 161 were generated using to MRU-5s (configured in the same way) and therefore each graph has two traces. It is clear from the two traces on each graph that the outputs from each MRU are not identical.

Simulation Results

[0122] A Simulink model was created to study the drawworks dynamics and the effects of the heave compensation corrections suggested above. The model has the following features:
- The rig motion is modelled by a pure sinusoidal motion or by real recorded rig heave data.
- The rig mobility, which describes how much the rig responds to hook load variations, is neglected in this model.
- The MRU is modelled with the filters described above (when recorded MRU signals are used as inputs the simulations, inverse filters are applied for estimating the real rig motion).
- The motor speed controller is a PI-controller with anti-windup. The small delay in the current (torque) controller is neglected. Different values for the gain P and the integration time constant t
i

are used.
- The motor torque limit is speed dependent and closely follows the torque limits given by the motor manufacturer (General Electric).
- The gear is assumed to be infinitely stiff so that motors and drum are regarded as one lumped inertia element. The transmission loss in the gear(s) is included in the model.
- The effective drum inertia is dynamic and takes into account the variable length of line wrapped onto it.

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
- The drum radius is also a variable function that varies stepwise (with a climbing transition angle of 0.5 rad).
- The line and sheaves are modelled as a series of mass and springs where the inertia and elasticity of the line are variable functions of the distance between the blocks.
- The sheave friction for each individual sheave is modelled by a speed dependent efficiency factor
where η0 = 1 - 0.35dline /Dsheave and v0 is a small transition speed.
- The block is modelled as a lumped mass while the string can either be modelled as a lumped mass or as a transmission line (with a distributed series of mass and springs). In this study of heave compensation, the former and simpler option is selected.
[0123] Simulation results with and without error corrections are shown for various wave periods in Figs. 15 to 24. All simulations, except the last two, are carried out without clipping feedback. The following data are used for the simulations
- MRU AC filter: General purpose, period = 20 s, damping = 0.7
- MRU vibration filter: cut-off frequency = 3 Hz, damping = 0.7
- Soft (slow) speed controller: Integration time = 0.7s, motor time constant = 0.66s
- Stiff (quick) speed controller: Integration time = 0.5s, motor time constant = 0.15s
- Drawworks linear damping = 0
[0124] The configuration of the simulation is shown in Table 1 below.
[0125] It is clear from these Figures that speed corrections to compensate for MRU filters, drive response and friction dramatically improves accuracy. This is especially true for the slow speed controller case where the compensation error is reduced by a factor of 10 or more.
[0126] The compensation error is smallest at a wave period corresponding to the center frequency of the MRU filters (at approximately 10s) and it increases rapidly for shorter wave periods.
[0127] The friction compensation has a large effect on the reduction of the position error from 4.7% to 1% in 10s period and 500 tons load. The effect of friction compensation increases proportionally with the load.
[0128] Stiffening of the speed controller (by reducing motor and integration time constants) improves the compensation

Table 1
Figure | Configuration
Fig. 15 | Simulation of active heave compensation (period = 10 s, amplitude = 1.5 m) with a slow speed controller and with no corrections
Fig. 16 | Simulation of active heave compensation (period = 10 s, amplitude = 1.5 m) with a slow speed controller and with corrections for MRU filters, drive response and friction
Fig. 17 | Simulation of active heave compensation (period = 10 s, amplitude = 1.5 m) with a slow speed controller and with corrections for MRU filters and drive response, but not for friction
Fig. 18 | Simulation of active heave compensation (period = 6 s, amplitude = 0.75 m) with a slow speed controller and no speed corrections.
Fig. 19 | Simulation of active heave compensation (period = 6 s, amplitude = 0.75 m) with a slow speed controller and with corrections for MRU filters and drive response
Fig. 20 | Simulation of active heave compensation (period = 15 s, amplitude = 2.6 m) with a slow speed controller and with corrections for MRU filters, drive response and friction.
Fig. 21 | Simulation of active heave compensation (period = 10 s, amplitude = 1.5 m) with a fast speed controller and with no corrections.
Fig. 22 | Simulation of active heave compensation (period = 10 s, amplitude = 1.5 m) with a fast speed controller and with corrections for MRU filters, drive response and friction
Fig. 23 | Simulation of active heave compensation (period = 10 s, amplitude = 1.5 m) with a slow speed controller, with position feedback only (ωclip = 1.71/s)
Fig. 24 | Simulation of active heave compensation (period = 10 s, amplitude = 1.5 m) with a slow speed controller, with corrections for MRU filters, drive response and friction, and with position feedback (ωclip = 1.71/s)

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
accuracy significantly, especially when speed corrections for MRU, drive and friction compensation are not applied.

Dual Drawworks

[0129] Referring to Fig. 25 an apparatus for implementing a second embodiment of the method according to the invention is generally identified by reference numeral 200. The apparatus 200 is generally similar to the first embodiment except that the dead line and anchor 28 have been replaced by a drawworks similar to the drawworks 30. The apparatus therefore has two drawworks 201, 202 (known as ’dual drawworks), one on either side of the derrick (not shown in Fig. 25); although it is possible to stack the drawworks on top of one another on one side of the derrick. Each drawworks 201, 202 has its own power supply. Each end of the steel rope 226 (or drill line) is attached to a respective one of the drawworks and the intermediate cable passes through the crown block 218 and travelling block 220. In this way the travelling block 220 can be raised and lowered by reeling cable 228 on and off either one of the drawworks 201, 202, (so-called ’single mode’) or both drawworks simultaneously (so-called ’dual mode’). The dual mode can either be run at the same speed (synchronous mode), or run at different speeds (asynchronous mode).
[0130] In synchronous mode the drawworks 201, 202 are each run with the same speed and the centre sheave of the crown block 218 is non-rotating. Whilst the line speed magnitude increases towards the ends spooled in or out of the drum, the relatively low line speed in the synchronous mode has many advantages, such as 1) lower inertia of the line and sheave system, 2) higher acceleration limits for line slack and 3) less wear and bending induced fatigue load of the cable 226. There are also some advantages if the speed ratio of the drawworks is changed from the synchronous 50/50 ratio to 40/60 or 60/40 ratio, for example. This will distribute the line wear more evenly along line and thereby extend the line life as compared with a constant 50/50 ratio.
[0131] One of the major benefits of employing dual drawworks is redundancy. If one unit fails, the other can still be operated and move the travelling block 220, like a conventional single drawworks. This is especially important in critical operations when heave compensating while the string is fixed to bottom for example. If the heave compensation stops, the tension forces from the heaving vessel could damage the string and even cause blowouts or other hazard situations. With one dual drawworks unit intact, the compensation can continue. Even though the speed and heave compensation capabilities in the single mode are reduced to roughly 50% of the dual mode, it offers full redundancy unless the weather conditions are extremely rough and the vessel heave exceed the single mode capacity limits.
[0132] In order to minimise the transient errors when the failed unit stops, the remaining unit should take into account the motion of the failed unit during the short but finite stopping time.
[0133] Referring to Appendix E an algorithm is shown for splitting the travelling block set speed vset into to two components, one for each drawworks 201, 202. This speed splitting software can be implemented in one single PLC (e.g. a drawworks controller like the drawworks controller 38) to control both drawworks 201, 202.
[0134] At step ES1 the PLC sets or calculates the parameters and variables shown and holds them in memory. The speed factor s1 is set by the operator between 0 and 1. Typically s1 is set at 0.5 resulting in a 50/50 split of the speed command received from the limiting module 133. The optimal values for time delay td, the position control parameter fp and the feed-back constant ωp must be determined by trial and error during commissioning. The motion components, acceleration, speed and position for each unit are basically determined from motor encoders in the same way as they are for conventional single drawworks. However, instead of one transmission radius discussed earlier for a conventional single drawworks) there are now two radii, one for each drawworks. They differ from each other when the drums have different number of layers.
[0135] At step ES2 the controller checks to see if one or other of the drawworks is disabled (for whatever reason). If so, the algorithm jumps to step ES5. Otherwise at step ES3 the speed split is between the two drawworks 201, 202 using the speed factor s1.
[0136] As the drawworks 201, 202 do not work perfectly there will be an error between the actual position of the travelling block 220 and the position that it should be in according to the speed commands. Step ES4 is intended to compensate for this error. Firstly, the actual total block height is obtained from angular position encoders on each drawworks. Firstly, the actual total block height h is obtained from the position values for each drawworks 201, 202. The height error herr is then determined by comparing the actual block height component h1 with the proportion of the total block height h according to the speed factor s1. To correct for this error, which is normally small but can become large when the speed factor is changed, a corrective balancing speed vbal is calculated. It is first set proportionally with the position error by multiplying the position error by a feedback constant ωp, but to avoid motion when there is no set speed for the travelling block, the feedback speed is clipped to limits defined by 6f
p|vset|. The resulting balancing speed is then subtracted from and added to the set speeds for drawworks 201 and 202, respectively. In this way the position balancing speed will cause a cross spooling of the drill line between the two units but no net motion of the travelling block 220.
[0137] Step ES5 is calculated only if one of the units is disabled, typically as a consequence of a failure. Disabling of a unit can occur abruptly when the unit is in full motion. In such cases operator set speed factor is overridden and the remaining unit provides all of the set speed. However, even when the disabled unit stops by means of its emergency

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
brakes, it will not stop instantly. To make the transition from dual mode to single mode as smooth as possible, the transient, measured speed of the disabled drawworks is subtracted from the set speed of the remaining active unit. The time delay correction based on the acceleration of the disabled unit is added for minimising the compensation errors during the transition time interval. When the disabled unit has come to a complete stop, these terms automatically reduce to zero and have no effect.
[0138] Referring to Fig. 26 a control diagram 250 is generally similar to the control diagram 130 with like reference numerals indicating like parts. Following the limiting module 133 the adjusted heave compensation signal is passed to a splitter module 252. The splitter module 252 comprises computer executable instructions stored in the memory of the drawworks controller 38 and is functions to determine the set speed of each drawworks 201, 202 (including any position correction). Each set speed is sent to a respective drive 254, 256 of the drawworks 201, 202 which controls the speed accordingly. The output speeds of the two drawworks are summed to control the velocity of the travelling block 220. The motion of the drilling rig is superimposed on this output speed; assuming accurate heave compensation the final movement vglobal of the travelling block 220 will be substantially equal to the input by the operator vop.
[0139] Advantages of this algorithm include:
a) synchronous as well asynchronous motion of two drawworks; the speed ratio selectable by the operator.
b) position balancing ensures that the position component from each unit approaches the specified speed ratio. The position balancing function is a cross spooling that does not affect the position of the travelling block. The balance correction speed is limited to a fraction of the set speed and is therefore frozen when the travelling block is stopped.
c) if one unit fails and stops, the other unit takes over the entire heave compensation task. This unit also compensates for the transient motion of the failed unit, in order to make the transition from dual to single mode as smooth as possible.
[0140] One alternative is for an MRU to store computer executable instructions for making any number of the speed corrections (MRU, drive, friction and/or delay) internally. Another alternative is for the functionality provided by the invention to be provided in a separate PLC (i.e. not part of a drawworks controller).
[0141] Although the invention brings about particular benefits in the field of oil and gas extraction at sea (e.g. drilling operations, well service operations including coil tubing, wireline operations, etc.), the use of the invention is not limited to this field. Other fields of use are envisaged such as any hoisting equipment (e.g. cranes and winches) for use on vessels where the effects of heave need to be reduced, for example pipe and cable laying vessels.
[0142] Although the embodiments of the invention described with reference to the drawings comprises computer apparatus and methods performed in computer apparatus, the invention also extends to computer programs, particularly computer programs on or in a carrier, adapted for putting the invention into practice. The program may be in the form of source code, object code, a code intermediate source and object code such as in partially compiled form, or in any other form suitable for use in the implementation of the methods according to the invention. The carrier may be any entity or device capable of carrying the program. For example, the carrier may comprise a storage medium, such as a ROM, for example a CD ROM or a semiconductor ROM, or a magnetic recording medium, for example a floppy disc or hard disk. Further, the carrier may be a transmissible carrier such as an electrical or optical signal that may be conveyed via electrical or optical cable or by radio or other means.
[0143] When the program is embodied in a signal that may be conveyed directly by a cable or other device or means, the carrier may be constituted by such cable or other device or means. Alternatively, the carrier may be an integrated circuit in which the program is embedded, the integrated circuit being adapted for performing, or for use in the performance of, the relevant methods.
[0144] In conclusion, therefore, it is seen that the present invention and the embodiments disclosed herein and those covered by the appended claims are well adapted to carry out the objectives and obtain the ends set forth.

Appendix A

MRU Configuration Report

[0145] This is a summary of all the parameters configured in the MRU.
S/N: | 1971
Unit: | MRU-5.e
System program: | MRU_3.20 02-01-11
Config annotation: SEDCO ENERGY MRU 2, token 11
Calibration: | MRU 5,sn 1971 calibrated 2002-06-21
System Mode: | Normal

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
Vessel

Geometry

[0146]

Description

[0147]

Vessel description:

"Sedco Energy"

User annotation:

"SEDCO ENERGY MRU 2, token 11"

Sensor

Geometry

[0148]

Data Interface

Digital

[0149]

(continued)
MRC Version: 4.0.0 <Standard>

Vessel dimensions:
Length: 100.00 | Width: | 100.00 | Height | 25.00 [m]
Center Of Gravity (CG) location:
CGX: -50.00 | CG-Y: | 0.00 | CG-Z: | 0.00 [m]

Lever arm MRU:
X: | 15.22 | Y: | 0.00 | Z: | 2191[m]
Lever arm MP:
X: | -11.73 Y: | 0.00 | Z: | 1.20 [m]
Mounting angles:
Roll: | -0.21 | Pitch: | 1.14 | Yaw: | 0.00 [°]
Heave Config
Filter mode:
Hydrographic survey
Filter parameters:
Damping: | | 0.70 | Periode: | 25.00 [s]

System Port:
Port Setup: | sys 19200 n 81
Verbose level: | Silent
XIN gate control: | Not used

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
Special options

Filters

[0150]

Limitation

[0151]

(continued)
XOUT gate control: | High
Digital Data:
Token: | 11
Channels: | 3
Interval: | 10
DATA out protocol:MRU normal
Channel list:
SourceID, Name, | Unit, Format
64, Pitch, [ang]. FFLOAT
105. PosMonD, [m], FFLOAT
115. VelMonD, [m/s]. FFLOAT
Auxilary
Serial Input - AUX1: | Disabled - aux 1 9600 n 8 1
Serial Input - AUX2: | Disabled aux2 9600 n 8 1
Logical Input - AUX3: | Not used
External heading age: | 20 [s]
Analog
Ouput enabled: no
Analog channels:
Ch# . SourceID. Name, Unit , Gain . Offset. Limits
0, 63, Roll. [ang], +28.649, +0.000, -10.0.+10.0 V
1, 64, Pitch, [ang], +28.649, +0.000, -10.0.+10.0 V
2 , 105, PosMonD, [m], +1.000, +0.000, -10.0..+10.0 V 3, 112, VelMonD, [m/s], +1.000, +0.000, -10.0..+10.0 V

Surge Filter:
Filter mode:
General purpose
Filter parameters:
Damping: | 0.60 | Periode: | 2.50
Sway Filter:
Filter mode:
General purpose
Filter parameters:
Damping: | 0.60 | Periode: | 2.50
Vibration:
Lowpass: 3.00 [Hz]

Velocity:
Maximum: 10.00 [m/s]
Position:

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
Emulation

[0152] Emulate MRU type:

Off

[0153] Magnetic Conditions

Advanced

[0154] Magnetic Model Matrix

PRO.bperm_b[0] = 0
PRO.bperm_b[1] = 0
PRO.bperm_b[2] = 0
PRO.M_sb[0] = 1
PRO.M_sb[1] = 0
PRO.M_sb[2] = 0
PRO.M_sb[3] = 0
PRO.M_sb[4] = 1
PRO.M_sb[5] = 0
PRO.M_sb[6] = 0
PRO.M_sb[7]=0
PRO.M_sb[8] = 1

Appendix B

Algorithm for Correction Module

[0155]
BS1. Read, set or calculate input parameters/variables:

(continued)
Maximum: | 10.00 [m]
Latitude: | 0.00°
Magnetic deviation 0.00°
Fluxgate usage: | Disabled
amru | MRU acceleration
vmru | MRU velocity
pmru | MRU position
ε | damping parameter of MRU filter
ωc | angular cut-off frequency of MRU filter
t

i integration time constant of speed controller t

m | motor time constant of speed controller
td | delay time
Δt | time increment
Fext | external load (hook load)
ηdw | drawworks efficiency
ddw | liner damping coefficient of drawworks
V | travelling block speed
M | total effective inertia mass

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
BS2. MRU correction

BS3. Drive corrections

BS4. Friction corrections

BS5. Delay correction

BS6. Apply corrections
vmru = vmru + vG + vH + vF + Vdelay corrected heave compensation speed BS7. Position correction

Appendix C

Algorithm for the Soft Switch Module

[0156]
CS1. Read, set or calculate input parameters/variables:

CS2. Determine fade direction

VG=2ε*ωc*pmru | drive correction
alp = alp + (amru - alp)*Δt/ti | low pass filtered acceleration
ahp = amru - alp | high pass filter acceleration
VH = tm*ahp | drive correction term

Ff

= (ηdwsign(v) - 1)*Fext - ddw*v friction force estimate
af

= Ff

/M | corresponding acceleration
af,lp = af,lp + (af
- af,lp)*Δt/ti low pass filtered acceleration
af,hp = af
- af,lp | high pass filter acceleration
vf
= tm*af,hp | friction correction term
alp,d = alp,d + (amru - alp,d)*Δt/td | low pass filtered acceleration
ahp,d = amru - alp,d | high pass filtered mru acceleration
Vdelay = td*ahp | delay correction term

If not posCorrectionOn
end | skip the optional position correction
vpos = (pmru -pmruOld)/Δt | MRU position based speed
pmruOld = pmru | keep for next cycle
vdiff = vmru - vpos | speed difference
tfilter = 100 | use 100s as filter time constant
vp = vp + (vdiff - vp)*Δt/tfilter | low pass filtered value of vdiff
vmruCorr = vmruCorr + vp | apply position correction
AHC_On | flag for heave compensatio
vmruCorr | MRU velocity (after correction)
pmru | MRU position
tfade | fade time (typical 5 s)
Δt | time increment

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
CS3. Integrate and clip fade variable

CS4. Calculate switch factor and its time derivative

CS5. Application of the soft switch

Appendix D

Algorithm for the Limiting Module

[0157]
DS1. Read, set or calculate input parameters/variables:

DS2. Initialise integration variables

DS3. Increment speed limit

IF AHC_On | if heave compensation turned on
s=1 | fade-in or fully on
ELSE
s=-1 | fade-out or fully off
x = x + s*Δt/tfade | integrate
x = max(0, min(x, 1)) clip if limits are violated
S = (1-cos(x*π))/2 | soft switch factor
Sdot = (S-Sold)/Δt | time derivative of S
Sold = S | keep for next time cycle
vahc = S*vmruCorr + Sdot*pmru | heave compensation velocity component
vset = vset - vahc | subract this from the operator set speed
aramp | acceleration limit from drive or operator
FmMax | motor pull force limit (at low speed)
h | actual block position
hmin | minimum position (lower stop target)
M | total effective inertia mass
Msl | inertial mass of line and sheaves
Pmin | regenerative power limit
Pmax | motoring power limit (<0)
vmMin | motor based speed limit (< 0)
Δvstd | standard speed increment
Δt | time increment
ωclip | factor for clipping error compensation
vold = 0 | speed
Lacc = 0 | accumulated stop length
Lstop = h - hmm | available stop length
Δv = Δvstd | start with standard speed increment
vmin = vold -Δv | minimum speed

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
DS4. Calculate speed dependent pull force

DS5. Calculate acceleration capacities

DS6. Update and check accumulated stop length

DS7. Interpolation to find stop length based speed limit

DS8. Check against rated speed limit

DS9. Motor push force limit

DS10. Downwards acceleration limits

DS11. Apply speed and acceleration limits to set speed (when v < 0)

Fmax = min (FmMax, Pmin/vmin) maximum motor pull
Fnet = Fmax - Fext | net pull margin
IF Fnet ≤ 0 | if pull margin is not positive
Δv = Δv/2 | reduce speed step
jump to 3 | and repeat margin check
amotors = Fnet/M | acceleration capacity from motors
amax = min(amotors, aramp) select the most restricted acceleration

ΔL = (vmin

2 - vold

2)/(2amax) stop length increment (>0)
Lacc = Lacc + ΔL | accumulated stop length
IF Lacc < Lstop | if available stop length not reached
vold = vmin | keep speed for next iteration
jump to 3 | continue with one more speed step

f = (Lacc - Lstop) /ΔL fraction of last stop length increment exceeding stop length vmin = vmin - f* Δv linearly interpolated speed limit

vmin = max(vmin, -vrated) select the most restrictive speed limit

Fmin = min(-FmMax, Pmax/vlim) minimum motor force
Fnet = Fmin - Fext | net (downwards) push force
amotors = Fnet/M | motor based acceleration limit (< 0)
aslack = -Fext/Msl) | line slack acceleration limit
amin = max(amotors, -aramp, aslack) selectmost restricted acceleration (< 0)
vlimLo = vlimOld+aminΔt | lowest speed based on previous output
vlimHi = vlimOld+aminΔt | highest speed based on previous output
vminLo = max(vmin, vlimLo) | minimum value from limiter module
vminHi = min(vmin, vlimHi) | maximum value from limiter module
vset = vset + vclip | add correction speed for clipping error
vlim = max(vminLo, min(vset, vminHi)) output speed from limiting module
vlimOld = vlim | keep output speed for next time cycle

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
DS12. Update clipping error feed-back

Appendix E

Algorithm for the Speed Splitting of Dual Drawworks

[0158]
ES1. Read, set or calculate input parameters/variables:

ES2. Check if both units are running

ES3. Normal speed splitting

ES4. Position balancing control (ensures that position ratio matches the speed ratio)

ES5. Special speed splitting if one unit is disabled pclip = pclip + (vset - vlim)*Δt position error from clipping
Vclip = ωclip*pclip | corresponding feedback speed
vset | set speed (desired block speed)
s1 | speed factor for drawworks unit 1
h1 | block height from unit 1
h2 | block height from unit 2
v1 | block speed from unit 1
v2 | block speed from unit 2
a1 | block acceleration from unit 1
a2 | block acceleration from unit 2
td | time delay (signal & response delay)
f
p | parameter for position control (0 < fp ≤ 1)
ωbal | position balancing constant (∼0.1 s⁻¹)
unit 1 Disabled flag for failed/disabled unit 1 unit2Disabled flag for failed/disabled unit 1

IF uni1lDisabled or unit2Disabled if one of the units is disabled
jump to ES5 | skip normal speed splitting
vset1 = s1*vset | set speed for unit 1
vset2 = (1-s1)*vset | set speed for unit 2
h = h1+h2 | total block height
herr = h1 - s1*h | position error
vbal = ωp*herr | corrective speed for position error
vbalMax = fp*abs(vset) | upper corrective speed limit
vbalMin = - vbalMax | lower corrective speed limit
vbal = max(vbalMin, min(vbal, vbalMax)) clip corrective speed if limits are exceeded
vset1 = vset1 - vbal | apply position control to unit 1
vset2 = vset2 + vbal | apply position control to unit 2

IF unit1 Disabled
vset1 = 0 | use zero set speed for the failed unit
vset2 = vset | compensate 100% with the other unit
vset2=vset2-v1 | add transient motion of failed unit

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
Claims

1. A method of actively compensating heave of a vessel to which a load is attached, there being a connection device connecting said load to said vessel, which method comprises the steps of:
(a) measuring with a measurement device the heave of said vessel and outputting a heave signal representative thereof, which heave signal comprises a velocity signal representing velocity of said vessel in response to said heave;
(b) using said heave signal to compensate for said heave by moving said connection device relative to said vessel as a function of said heave signal, whereby movement of said load due to said heave is reduced;

said heave signal comprising errors induced by said measurement device whereby accuracy of said compensation is reduced, characterised by the steps of:

(c) processing said heave signal by determining a velocity correction (vG) and adjusting said velocity signal by said velocity correction so as to reduce said errors and outputting an adjusted heave signal; and
(d) using said adjusted heave signal to move said connection device to compensate for said heave.
2. A method according to claim 1, wherein said step (c) comprises reducing a lead phase error in said velocity signal by adding said velocity correction (vG) to said velocity signal, which velocity correction is proportional to a position signal representing the position of said vessel relative to a fixed point.
3. A method according to any preceding claim, wherein said vessel comprises drive apparatus for effecting movement of said connection device as a function of said heave signal, the method further comprising the step of further adjusting said heave signal to reduce errors introduced by inertia and/or friction effects of said drive apparatus in effecting movement of said connection device.
4. A method according to claim 3, wherein said further adjustment is proportional to (a) a drive time constant being the quotient of a moment of inertia (J) of said drive apparatus divided by a gain (P) of a proportional integral (PI) speed controller of an electronic control system of a drive of said drive apparatus, and (b) an acceleration signal representing a filtered value of the acceleration of said vessel in response to said heave, whereby said heave signal is adjusted to compensate inertia errors introduced by said drive apparatus.
5. A method according to claim 4, wherein said further adjustment is proportional to (a) said drive time constant, and
(b) an acceleration signal representing a filtered value of the friction acceleration being the quotient of a friction force (Ff
) experienced by said drive apparatus divided by a total inertial mass (M) of said drive apparatus, whereby said heave signal is adjusted to compensate friction errors introduced by said drive apparatus.
6. A method according to claim 4 or 5, wherein said acceleration signal has been filtered by an acceleration filter that comprises a first order high pass filter having a time constant substantially equal to an integration time constant (t
i

)
of said proportional integral (PI) speed controller.
7. A method according to any preceding claim, further comprising the step of applying dynamic limits to the magnitude of said heave compensation, wherein said limits are set as a function of the acceleration capabilities of a drive apparatus or said connection device.

(continued)
IF unit1 Disabled
vset2 = vset2 - a1*td correct also for time delays
IF unit2Disabled
vset2 = 0 | set zero speed for the failed unit
vset1 = vset | compensate 100% with the other unit
vset1 = vset1 - v2 | add transient motion of failed unit
vset1 = vset1 - a2*td | correct also for time delays

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
8. A method according to claim 7, further comprising the step of determining a maximum and minimum allowable acceleration of said connection device, defining said dynamic limits as an upper limit and a lower limit on the basis thereof, and limiting movement of said connection device based on said upper and lower limits.
9. A method according to claim 7 or 8, further comprising the step of determining a maximum and minimum speed limit from the present position of said connection device such that said load can be stopped within a constant or dynamic position limit.
10. A method according to claim 7, 8 or 9, wherein application of said dynamic limits causes asymmetric clipping of said adjusted heave signal whereby a mean position of said connection device moves with time, the method further comprising the step of compensating said adjusted heave signal for said asymmetric clipping to reduce movement of said mean position.
11. A method according to claim 10, wherein said compensation step comprises feeding back said adjusted heave signal following clipping, determining a clipping compensation signal and adding said clipping compensation signal to said adjusted heave signal.
12. A method according to any preceding claim, wherein there are two drawworks for controlling the position of said connection device, said two drawworks having a cable therebetween that passes through said connection device, the method further comprising the steps of splitting said adjusted heave compensation signal between said two drawworks so that each applies a fraction thereof to control the position of said connection device.
13. A method according to claim 12, further comprising the step of splitting said adjusted heave compensation signal
(a) substantially equally or (b) unevenly between said two drawworks.
14. A method according to claim 12 or 13, further comprising the step of instructing one of said two drawworks to provide all of said heave compensation when the other of said two drawworks is disabled.
15. A method as claimed in any preceding claim, wherein said vessel is a floating drilling rig, said connection device comprises a travelling block, and step (b) comprises moving said travelling block with a drawworks to compensate for said heave.

Patentansprüche

1. Verfahren zur aktiven Kompensation des Seegangs von einem Gefäß, an dem eine Last befestigt ist, wobei eine Verbindungsvorrichtung vorliegt, die die Last mit dem Gefäß verbindet, wobei das Verfahren die Schritte umfasst:
(a) Messen des Seegangs von dem Gefäß mit einer Messvorrichtung und Ausgeben von einem Seegangssignal, das dafür repräsentativ ist, wobei das Seegangssignal ein Geschwindinkeitssignal umfasst das die Geschwin-digkeit von dem Gefäß in Reaktion auf den Seegang repräsentiert;
(b) Verwenden des Seegangssignals, um den Seegang zu kompensieren, indem die Verbindungsvorrichtung relativ zu dem Gefäß als eine Funktion des Seeganssignals bewegt wird, wodurch die Bewegung von der Last auf Grund des Seegangs verringert wird;

wobei das Seegangsignal Fehler umfasst, die durch die Messvorrichtung induziert sind, wodurch die Genauigkeit von der Kompensation verringert wird, gekennzeichnet durch die folgenden Schritte:

(c) Verarbeiten des Seegangssignals durch das Bestimmen von einer Geschwindigkeitskorrektur (vG) und durch das Anpassen von dem Geschwindigkeitssignal mittels der Geschwindigkeitskorrektur, um so die Fehler zu verringern, und Ausgeben von einem angepassten Seegangssignai; und
(d) Verwenden von dem angepassten Seegangssignal, um die Verbindungsvorrichtung zu bewegen, um den Seegang zu kompensieren.
2. Verfahren nach Anspruch 1, wobei der Schritt (c) das Verringern von einem Leitungsphasenfehler [Engl.: Lead-Phase-Error] in dem Geschwindigkeitssignal durch das Hinzufügen der Geschwindigkeitskorrektur (vG) zu dem Geschwindigkeitssignal umfasst, wobei die Geschwindigkeitskorrektur proportional zu einem Positionssignal ist, welches die Position von dem Gefäß in Bezug auf einen Festpunkt repräsentiert.

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
3. Verfahren nach einem der vorhergehenden Ansprüche, wobei das Gefäß einen Antriebsapparat zum Bewirken von einer Bewegung von der Verbindungvorrichtung als eine Funktion von dem Seegangssignal umfasst, wobei das Verfahren ferner den Schritt des weiteren Anpassens von dem Seegangssignal umfasst, um Fehler zu verringern, die durch Trägheits- und/oder Reibungseffekte von dem Antriebsapparat beim Bewirken von der Bewegung von der Verbindungsvorrichtung eingeführt werden.
4. Verfahren nach Anspruch 3, wobei das weitere Anpassen proportional zu (a) einer Antriebszeitkonstante, die der Quotient aus einem Trägheitsmoment (J) von dem Antriebapparat geteilt durch eine Verstärkung (P) von einem Proportional-Integral (PI) Geschwindigkeitsregler von einem elektronischen Reglersystem von einem Antrieb von dem Antriebapparat ist, und (b) einem Beschleunigungssignal ist, das einen gefilterten Wert für die Beschleunigung von dem Gefäß in Reaktion auf den Seegang repräsentiert, wodurch das Seegangsignal angepasst wird, um Trägheitsfehler, die durch den Antriebsapparat eingeführt werden, zu kompensieren.
5. Verfahren nach Anspruch 4, wobei das weitere Anpassen proportional zu (a) einer Antriebszeitkonstante und (b) einem Beschleunigungssignal ist, das ein gefilterter Wert von der Reibungsbeschleunigung ist, die der Quotient aus einer Reibungskraft (Ff
), die von dem Antriebsapparat erfahren wird, geteilt durch eine Trägheitsgesamtmasse (M) von dem Antriebapparat ist, wodurch das Seegangsignal angepasst wird, um Trägheitsfehler, die durch den Antriebsapparat eingeführt werden, zu kompensieren.
6. Verfahren nach einem der Ansprüche 4 oder 5, wobei das Beschleunigungssignal mit einem Beschleunigungsfilter gefiltert wurde, der einen Hochpass erster Ordnung umfasst, der eine Zeitkonstante hat, die im Wesentlichen gleich mit einer Integrationszeitkonstante (ti) von dem Proportional-Integral (PI) Geschwindigkeitsregler ist.
7. Verfahren nach einem der vorhergehenden Ansprüche, ferner umfassend den Schritt des Anlegens von dynamischen Begrenzungen für das Ausmaß der Seegangskompensation, wobei die Begrenzungen als eine Funktion der Beschleunigungsleistungsfähigkeiten von einem Antriebsapparat oder der Verbindungvorrichtung erfasst sind.
8. Verfahren nach Anspruch 7, ferner umfassend den Schritt des Bestimmens von einer maximalen und minimalen zulässigen Beschleunigung von der Verbindungsvorrichtung, welche die dynamischen Begrenzungen als eine obere Begrenzung und eine untere Begrenzung auf der Basis davon definiert, und das Begrenzen von der Bewegung der Verbindungsvorrichtung, basierend auf den oberen und unteren Begrenzungen.
9. Verfahren nach Anspruch 7 oder 8, ferner umfassend den Schritt des Bestimmens von einer maximalen und einer minimalen Geschwindigkeitsbegrenzung aus der gegenwärtigen Position von der Verbindungsvorrichtung, sodass die Last innerhalb einer konstanten oder dynamischen Positionsbegrenzung angehalten werden kann.
10. Verfahren nach Anspruch 7, 8 oder 9, wobei das Anlegen von dynamischen Begrenzungen ein asymmetrisches Abschneiden [Engl.: clipping] von dem angepassten Seegangssignal verursacht, wodurch sich eine mittlere Position von der Verbindungsvorrichtung mit der Zeit bewegt, wobei das Verfahren ferner den Schritt des Kompensierens von dem angepassten Seegangssignal für das asymmetrische Abschneiden umfasst, um die Bewegung der mittleren Position zu verringern.
11. Verfahren nach Anspruch 10, wobei der Kompensationsschritt das Rückführen von dem angepassten Seegangssignal im Anschluss an das Abschneiden, das Bestimmen von einem Abschneidekompensationssianal und das Hinzufügen des Abschneidekompensationssignals zu dem angepassten Seegangssignal umfasst.
12. Verfahren nach einem der vorhergehenden Ansprüche, wobei es zwei Hebewerke zum Steuern der Position von der Verbindungsvorrichtung gibt, wobei zwischen den zwei Hebewerke ein Kabel vorliegt, dass sich durch die Verbindungsvorrichtung erstreckt, wobei das Verfahren ferner die Schritte des Aufteilens von dem angepassten Seegangskompensationssignal zwischen den zwei Hebewerken umfasst, so dass jedes einen Teil davon anwendet, um die Position von der Verbindungsvorrichtung zu steuern.
13. Verfahren nach Anspruch 12, ferner umfassend den Schritt des Aufteilens von dem angepassten Seegangskompensationssignal zwischen den zwei Hebewerken und zwar (a) im Wesentlichen gleich oder (b) ungleich.
14. Verfahren nach Anspruch 12 oder 13, ferner umfassend den Schritt des Anweisens von einem von den zwei Hebewerken die gesamte Seegangskompensation bereitzustellen, wenn das andere von den zwei Hebewerken deak-tiviert ist.

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
15. Verfahren nach einem der vorhergehenden Ansprüche, wobei das Gesäß eine schwimmende Bohranlage ist, wobei die Verbindungsvorrichtung einen Laufblock umfasst, und Schritt (b) das Bewegen des Laufblocks mit Hebewerken umfasst, um den Seegang zu kompensieren.

Revendications

1. Procédé de compensation active du tangage d’un navire auquel une charge est fixée, un dispositif de raccordement raccordant ladite charge audit navire, lequel procédé comprend les étapes de :
(a) mesure, grâce à un dispositif de mesure, du tangage dudit navire et fourniture en sortie d’un signal de tangage représentatif de celui-ci, lequel signal de tangage comprend un signal de vitesse représentant la vitesse dudit navire en réponse audit tangage;
(b) utilisation dudit signal de tangage pour compenser ledit tangage en déplaçant ledit dispositif de raccordement par rapport audit navire en fonction dudit signal de tangage, moyennant quoi le déplacement de ladite charge dû audit tangage est réduit ;

ledit signal de tangage comprenant des erreurs induites par ledit dispositif de mesure moyennant quoi la précision de ladite compensation est réduite, caractérisé par les étapes de :

(c) traitement dudit signal de tangage en déterminant une correction de vitesse (vG) et ajustement dudit signal de vitesse par ladite correction de vitesse de façon à réduire lesdites erreurs et fourniture en sortie d’un signal de tangage ajusté ; et
(d) utilisation dudit signal de tangage ajusté pour déplacer ledit dispositif de raccordement afin de compenser ledit tangage.
2. Procédé selon la revendication 1, dans lequel ladite étape (c) comprend une réduction d’une erreur de phase d’avance dans ledit signal de vitesse en ajoutant ladite correction de vitesse (vG) audit signal de vitesse, laquelle correction de vitesse est proportionnelle à un signal de position représentant la position dudit navire par rapport à un point fixe.
3. Procédé selon l’une quelconque des revendications précédentes, dans lequel ledit navire comprend un appareil d’entraînement destiné à réaliser un déplacement dudit dispositif de raccordement en fonction dudit signal de tangage, le procédé comprenant en outre l’étape d’ajustement supplémentaire dudit signal de tangage afin de réduire les erreurs introduites par des effets d’inertie et/ou de frottement dudit appareil d’entraînement dans la réalisation du déplacement dudit dispositif de raccordement.
4. Procédé selon la revendication 3, dans lequel ledit ajustement supplémentaire est proportionnel à (a) une constante de temps d’entraînement qui est le quotient d’un moment d’inertie (J) dudit appareil d’entraînement divisé par un gain (P) d’un régulateur de vitesse proportionnel intégral (PI) d’un système de commande électronique d’un entraînement dudit appareil d’entraînement, et (b) un signal d’accélération représentant une valeur filtrée de l’accélération dudit navire en réponse audit tangage, moyennant quoi ledit signal de tangage est ajusté pour compenser les erreurs d’inertie introduites par ledit appareil d’entraînement.
5. Procédé selon la revendication 4, dans lequel ledit ajustement supplémentaire est proportionnel à (a) ladite constante de temps d’entraînement, et (b) un signal d’accélération représentant une valeur filtrée de l’accélération de frottement qui est le quotient d’une force de frottement (Ff
) subie par ledit appareil d’entraînement divisé par une masse inertielle totale (M) dudit appareil d’entraînement, moyennant quoi ledit signal de tangage est ajusté pour compenser les erreurs de frottement introduites par ledit appareil d’entraînement.
6. Procédé selon la revendication 4 ou 5, dans lequel ledit signal d’accélération a été filtré par un filtre d’accélération qui comprend un filtre passe-haut de premier ordre ayant une constante de temps sensiblement égale à une constante de temps d’intégration (t
i

) dudit régulateur de vitesse proportionnel intégral (PI).

7. Procédé selon l’une quelconque des revendications précédentes, comprenant en outre l’étape d’application de limites dynamiques à la grandeur de ladite compensation de tangage, dans lequel lesdites limites sont établies en fonction des capacités d’accélération d’un appareil d’entraînement ou dudit dispositif de raccordement.

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
8. Procédé selon la revendication 7, comprenant en outre l’étape de détermination d’une accélération maximale et minimale admissible dudit dispositif de raccordement, définissant lesdites limites dynamiques comme une limite supérieure et une limite inférieure sur la base de celle-ci, et limitant le déplacement dudit dispositif de raccordement en se basant sur lesdites limites supérieure et inférieure.
9. Procédé selon la revendication 7 ou 8, comprenant en outre l’étape de détermination d’une limite de vitesse maximale et minimale à partir de la position actuelle dudit dispositif de raccordement de sorte que ladite charge puisse être arrêtée au sein d’une limite de position constante ou dynamique.
10. Procédé selon la revendication 7, 8 ou 9, dans lequel l’application desdites limites dynamiques provoque un écrêtage asymétrique dudit signal de tangage ajusté moyennant quoi une position moyenne dudit dispositif de raccordement se déplace dans le temps, le procédé comprenant en outre l’étape de compensation dudit signal de tangage ajusté pour que ledit écrêtage asymétrique réduise le déplacement de ladite position moyenne.
11. Procédé selon la revendication 10, dans lequel ladite étape de compensation comprend le renvoi dudit signal de tangage ajusté à la suite dudit écrêtage, la détermination d’un signal de compensation d’écrêtage et l’ajout dudit signal de compensation d’écrêtage audit signal de tangage ajusté.
12. Procédé selon l’une quelconque des revendications précédentes, dans lequel il y a deux treuils de forage destinés à commander la position dudit dispositif de raccordement, lesdits deux treuils de forage ayant un câble entre eux qui traverse ledit dispositif de raccordement, le procédé comprenant en outre les étapes de division dudit signal de compensation de tangage ajusté entre lesdits deux treuils de forage de sorte que chacun applique une fraction de celui-ci pour commander la position dudit dispositif de raccordement.
13. Procédé selon la revendication 12, comprenant en outre l’étape de division dudit signal de compensation de tangage ajusté de façon (a) sensiblement égale ou (b) inégale entre lesdits deux treuils de forage.
14. Procédé selon la revendication 12 ou 13, comprenant en outre l’étape consistant à donner l’ordre à l’un desdits deux treuils de forage de fournir la totalité de ladite compensation de tangage lorsque l’autre desdits deux treuils de forage est désactivé.
15. Procédé selon l’une quelconque des revendications précédentes, dans lequel ledit navire est un appareil de forage flottant, ledit dispositif de raccordement comprend une moufle mobile, et l’étape (b) comprend le déplacement de ladite moufle mobile avec un treuil de forage pour compenser ledit tangage.

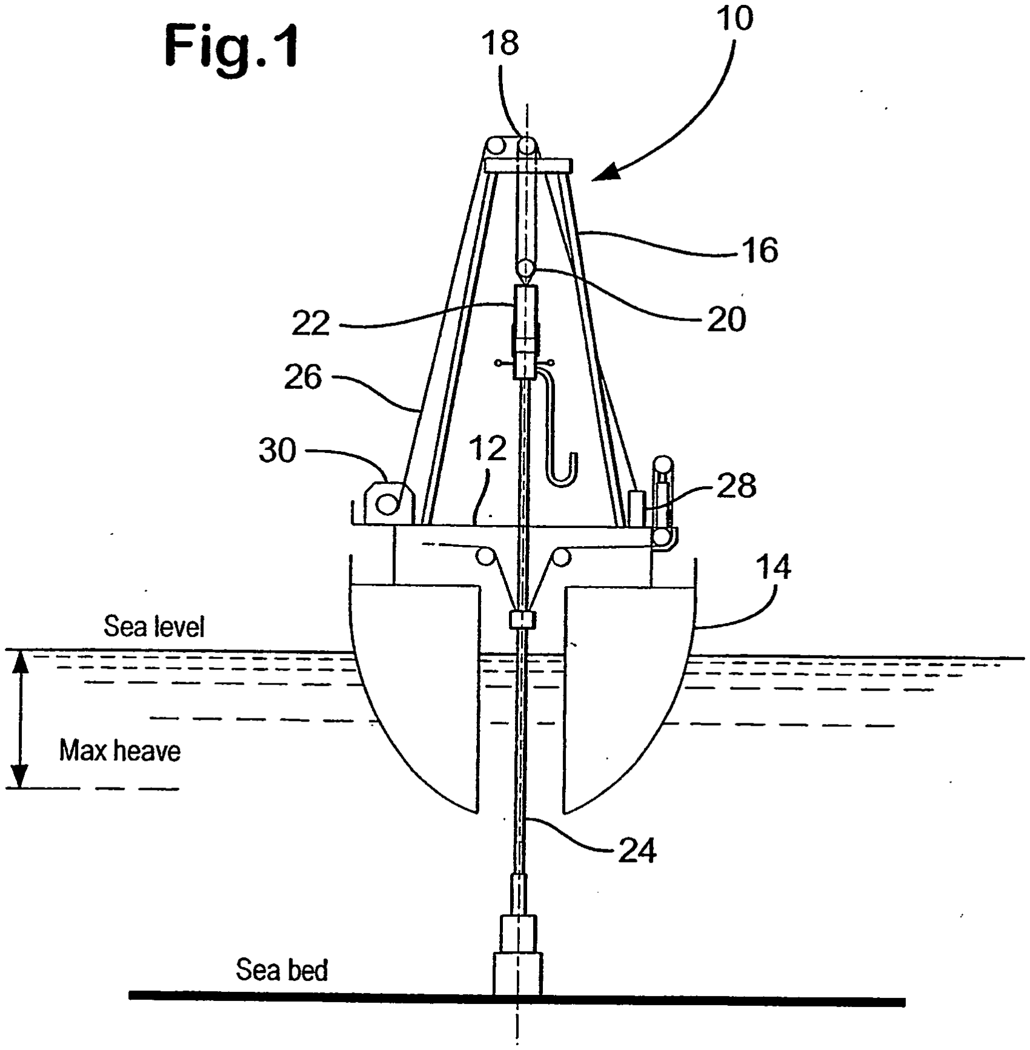
[picture p100: figure]

35

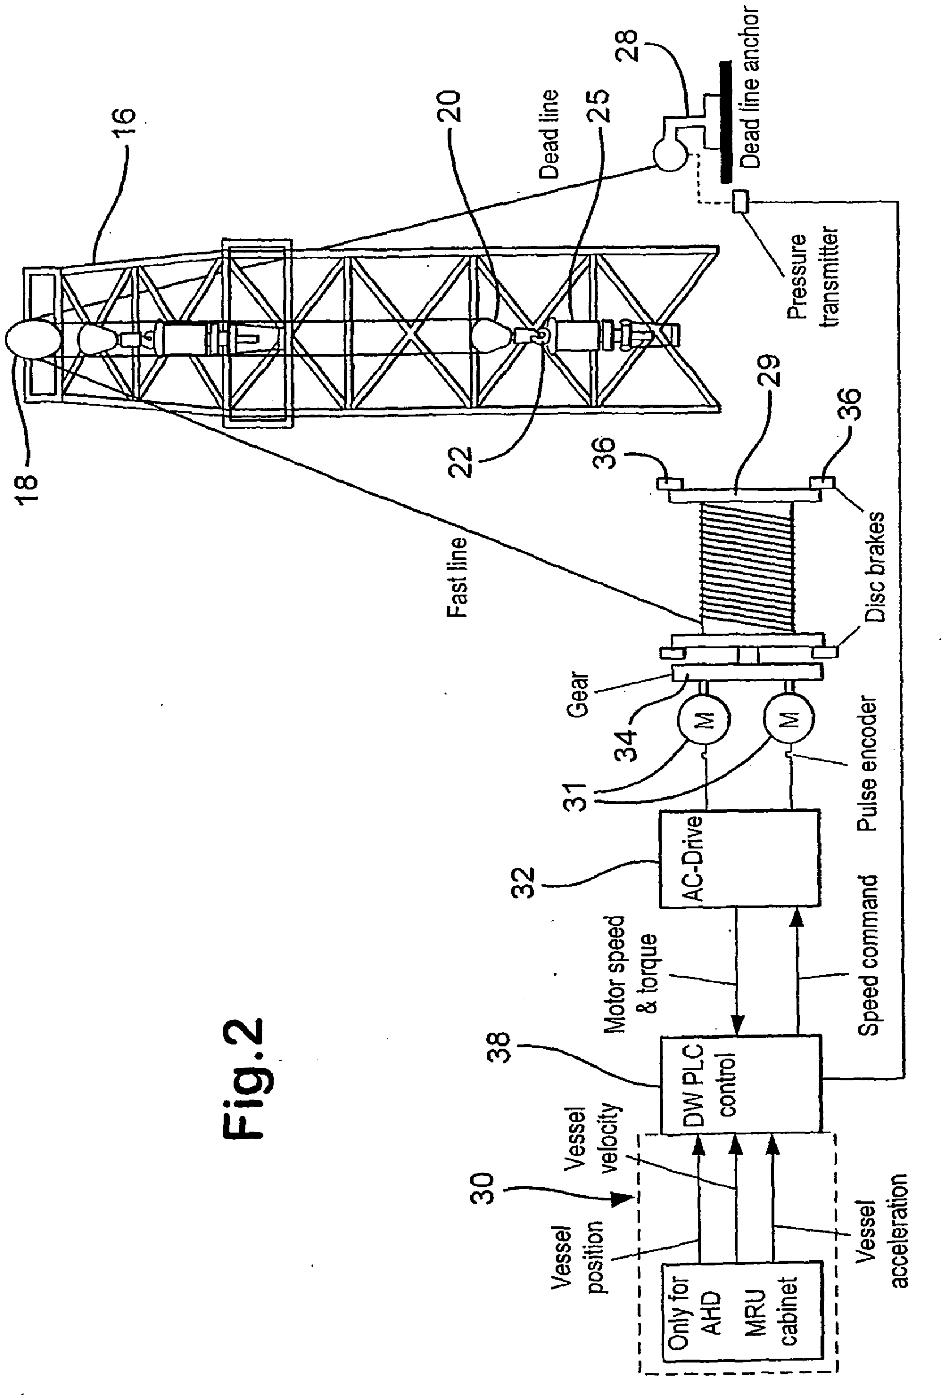
[picture p101: figure]

36

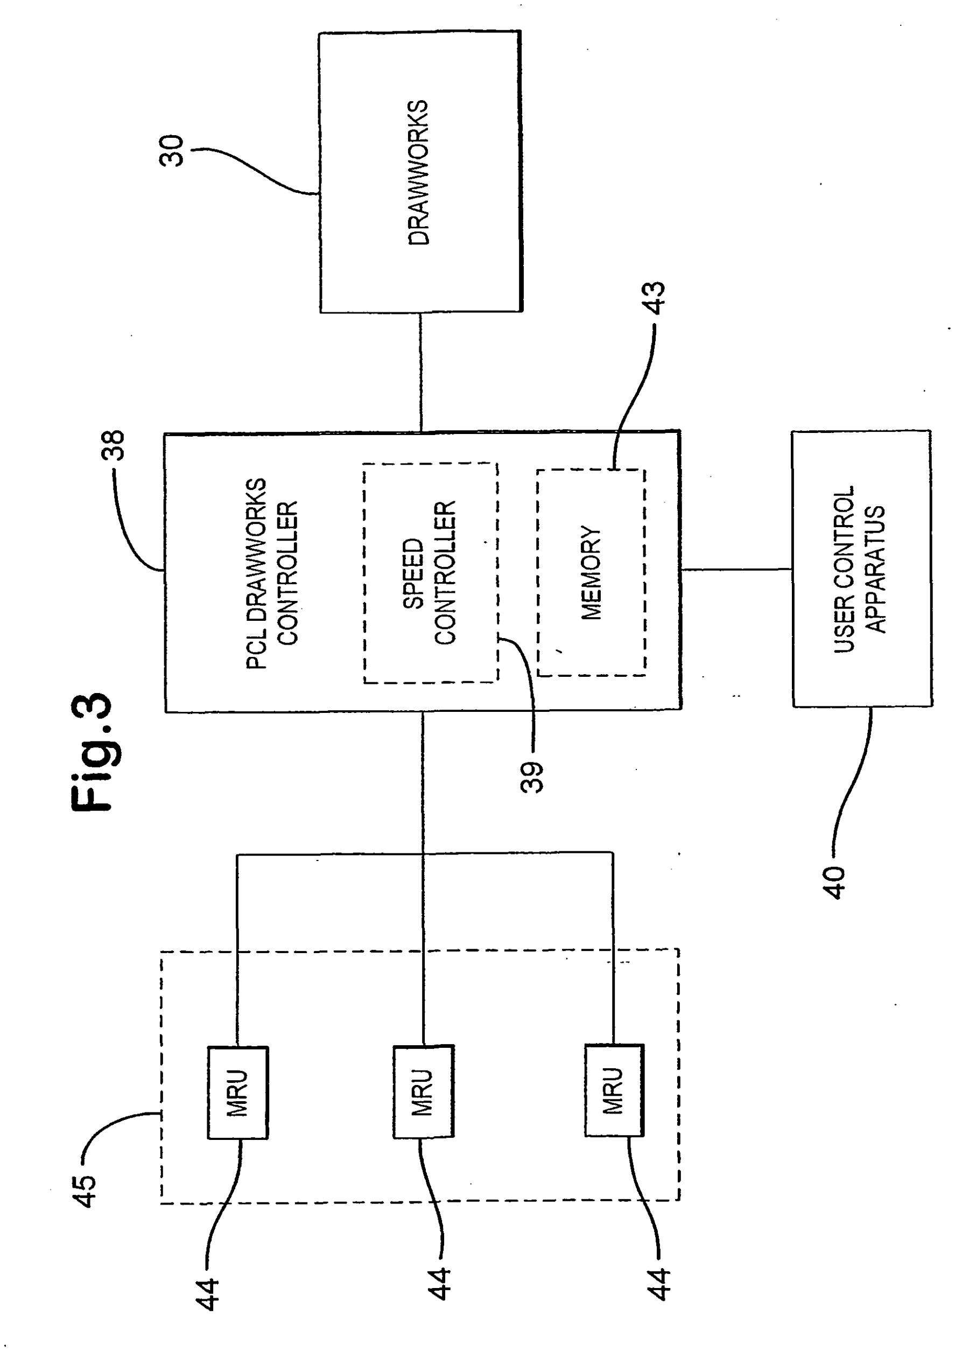
[picture p102: figure]

37

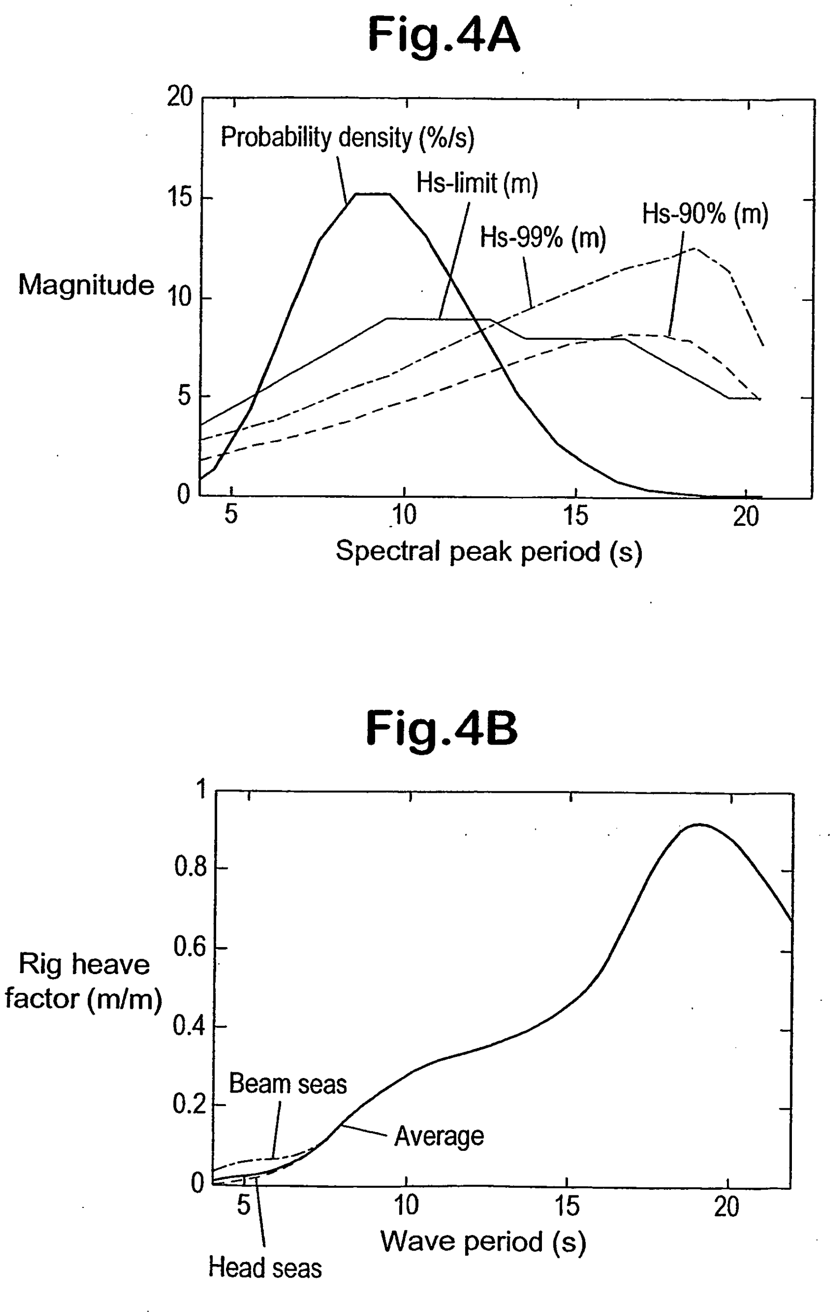
[picture p103: figure]

38

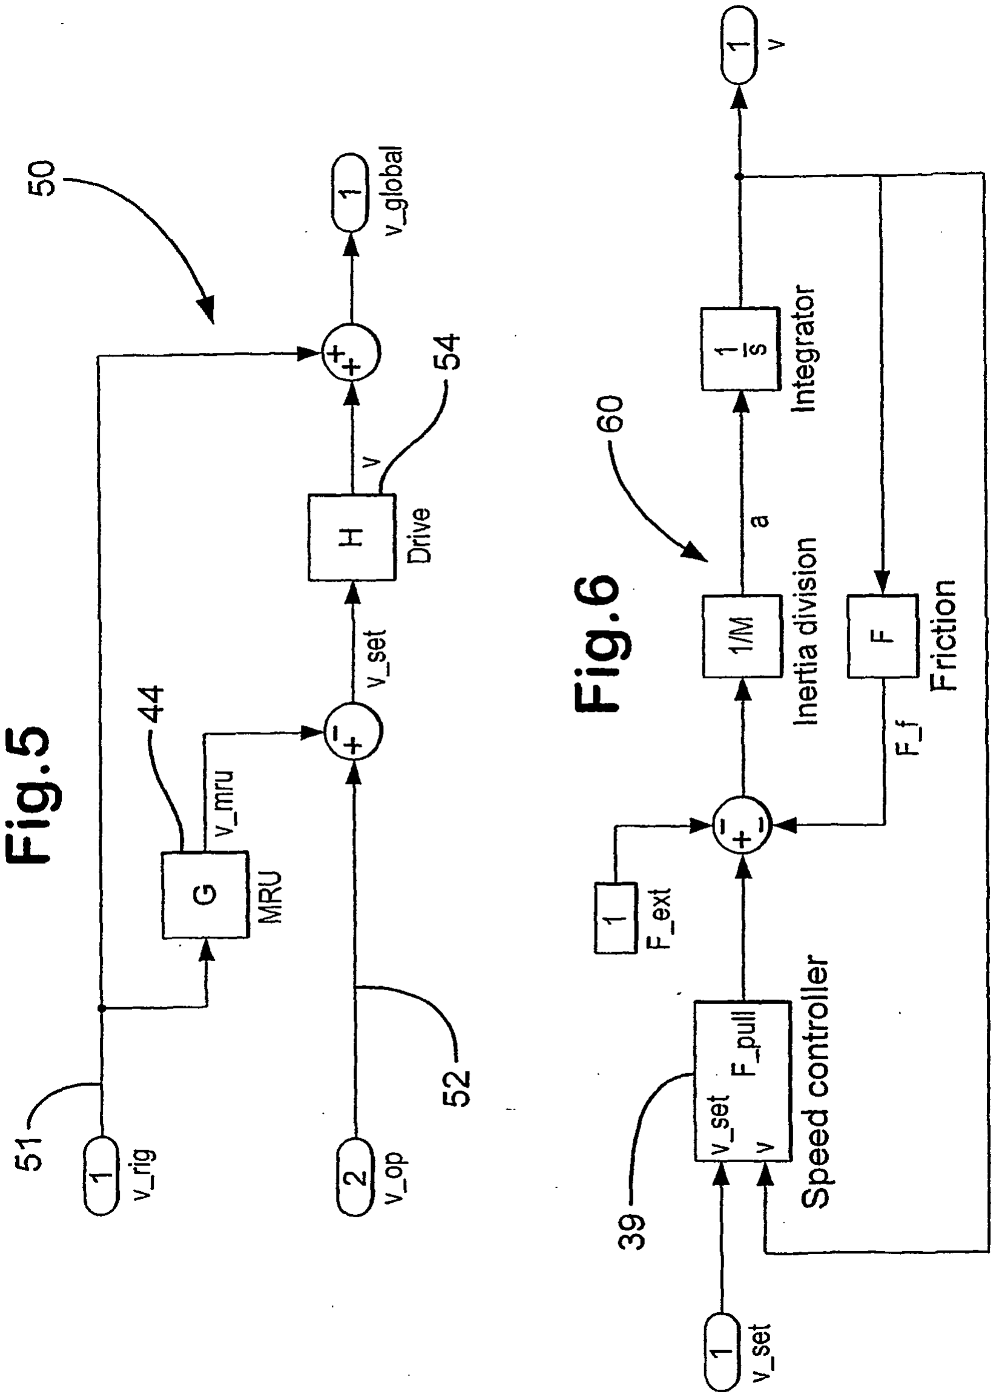
[picture p104: figure]

39

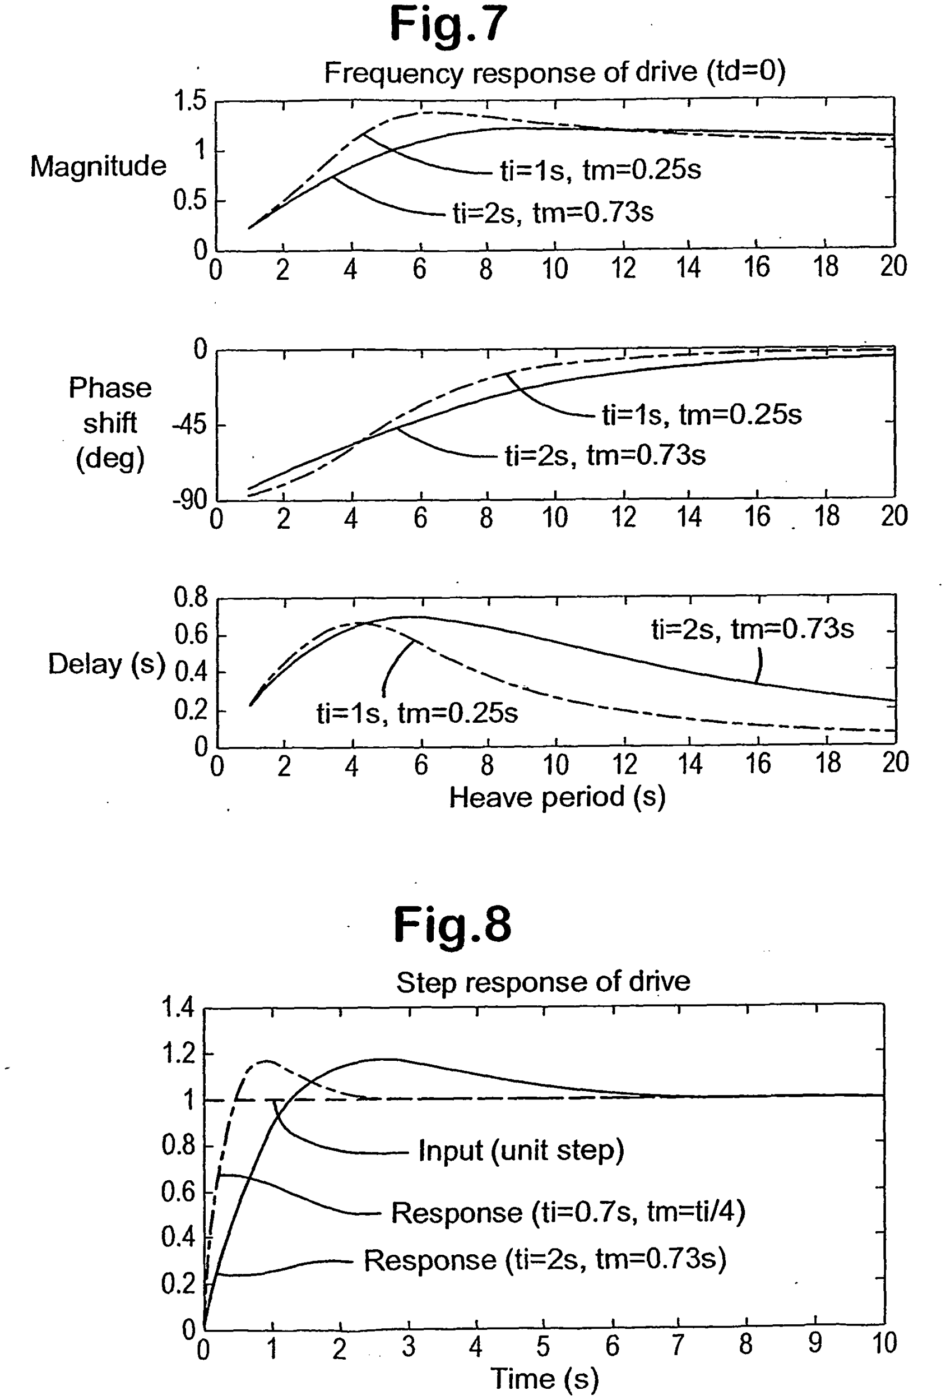
[picture p105: figure]

40

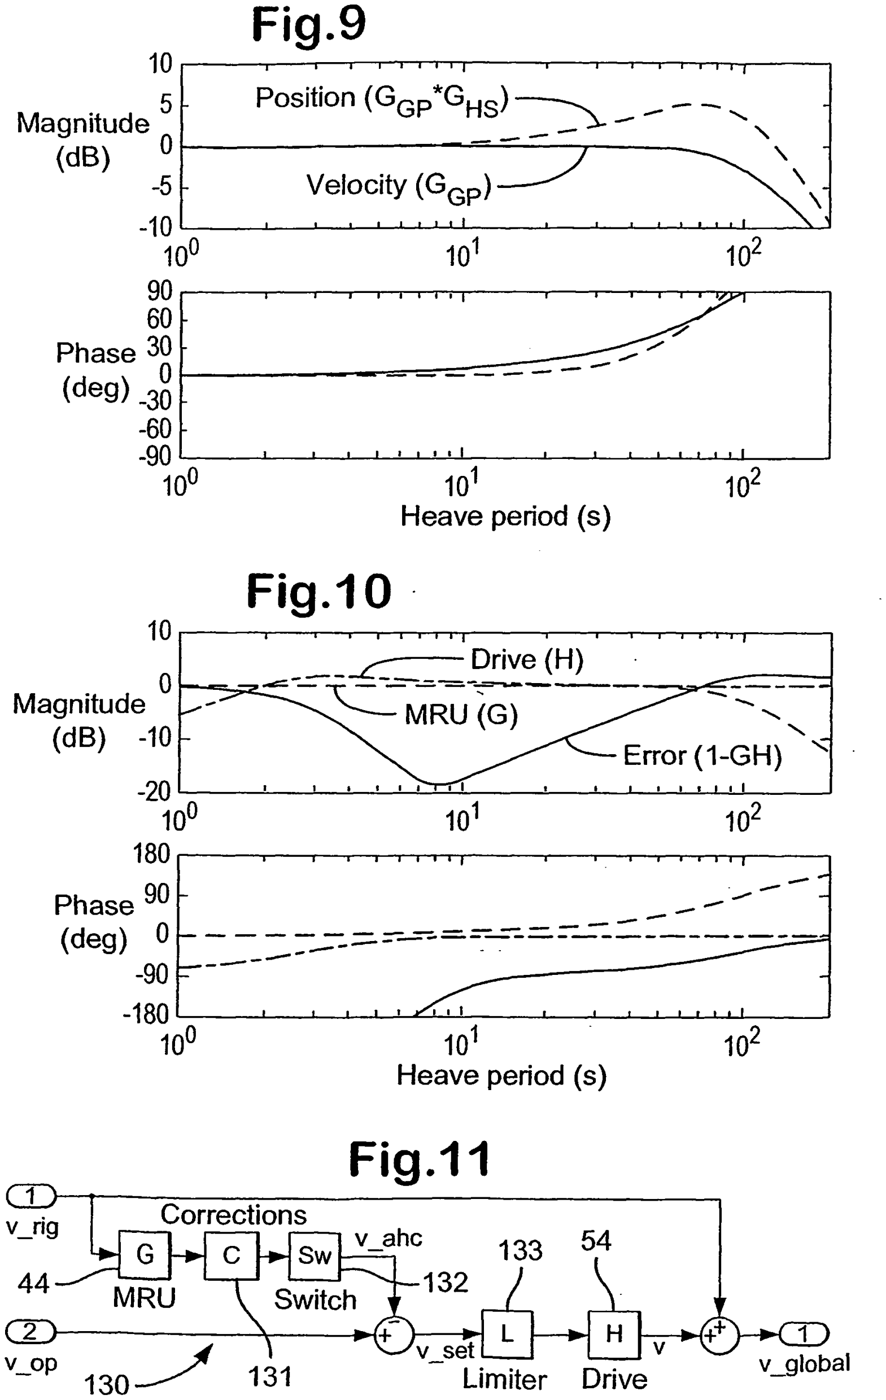
[picture p106: figure]

41

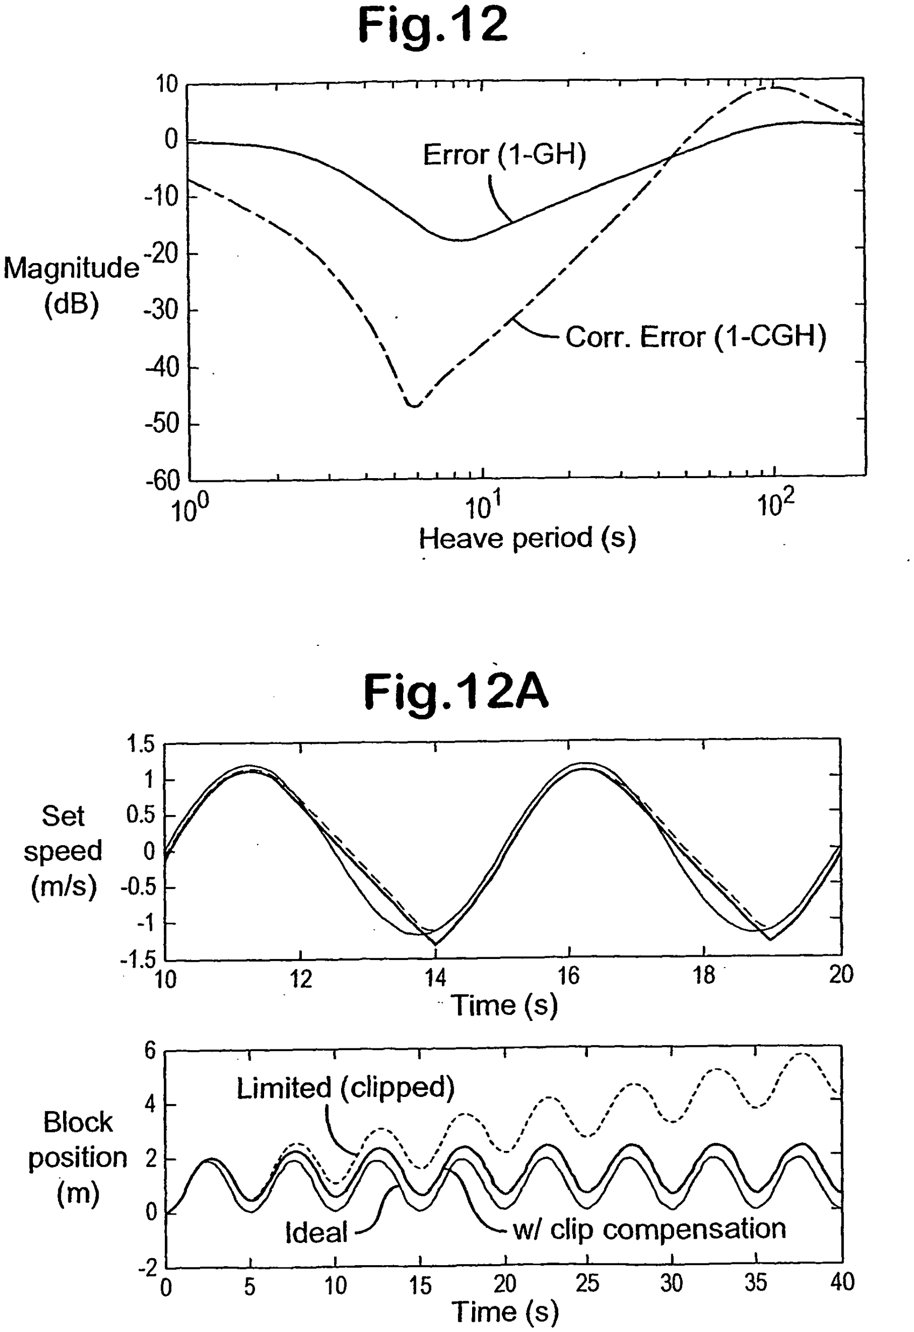
[picture p107: figure]

42

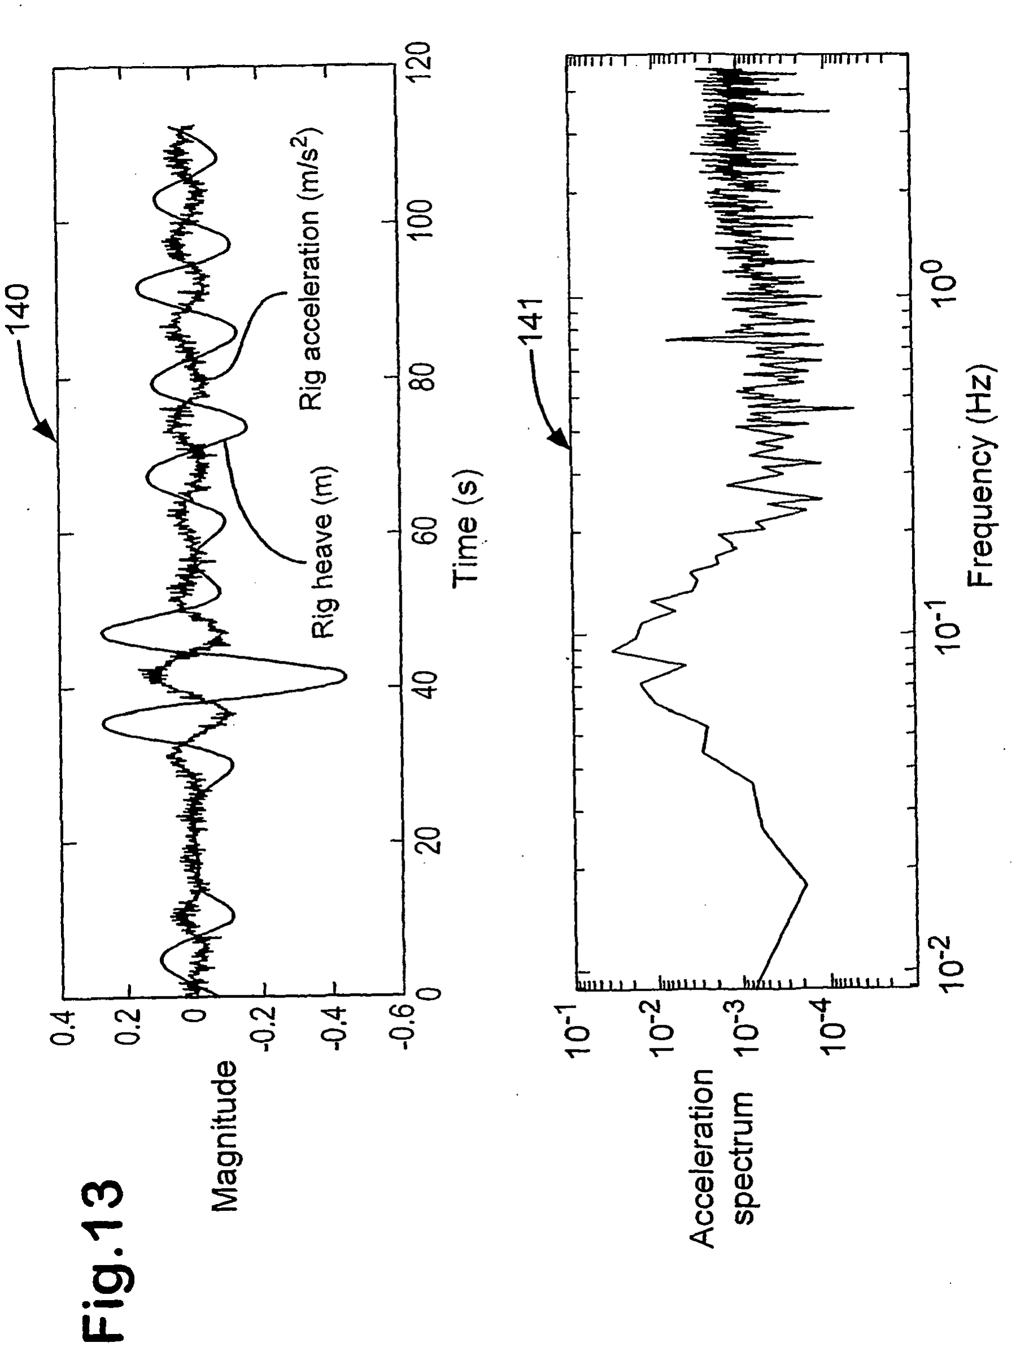
[picture p108: figure]

43

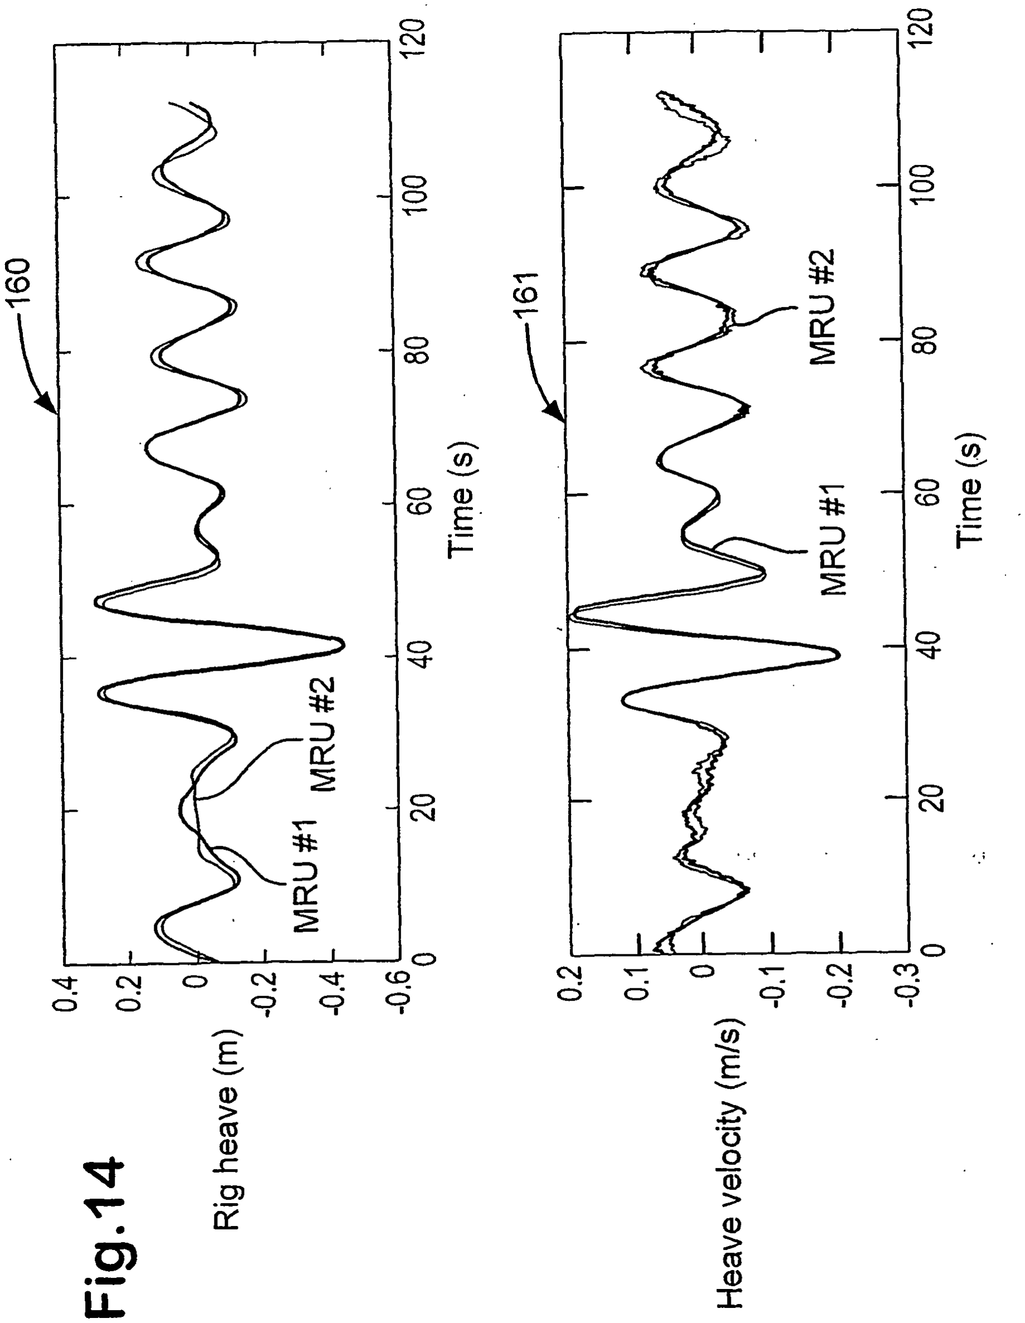
[picture p109: figure]

44

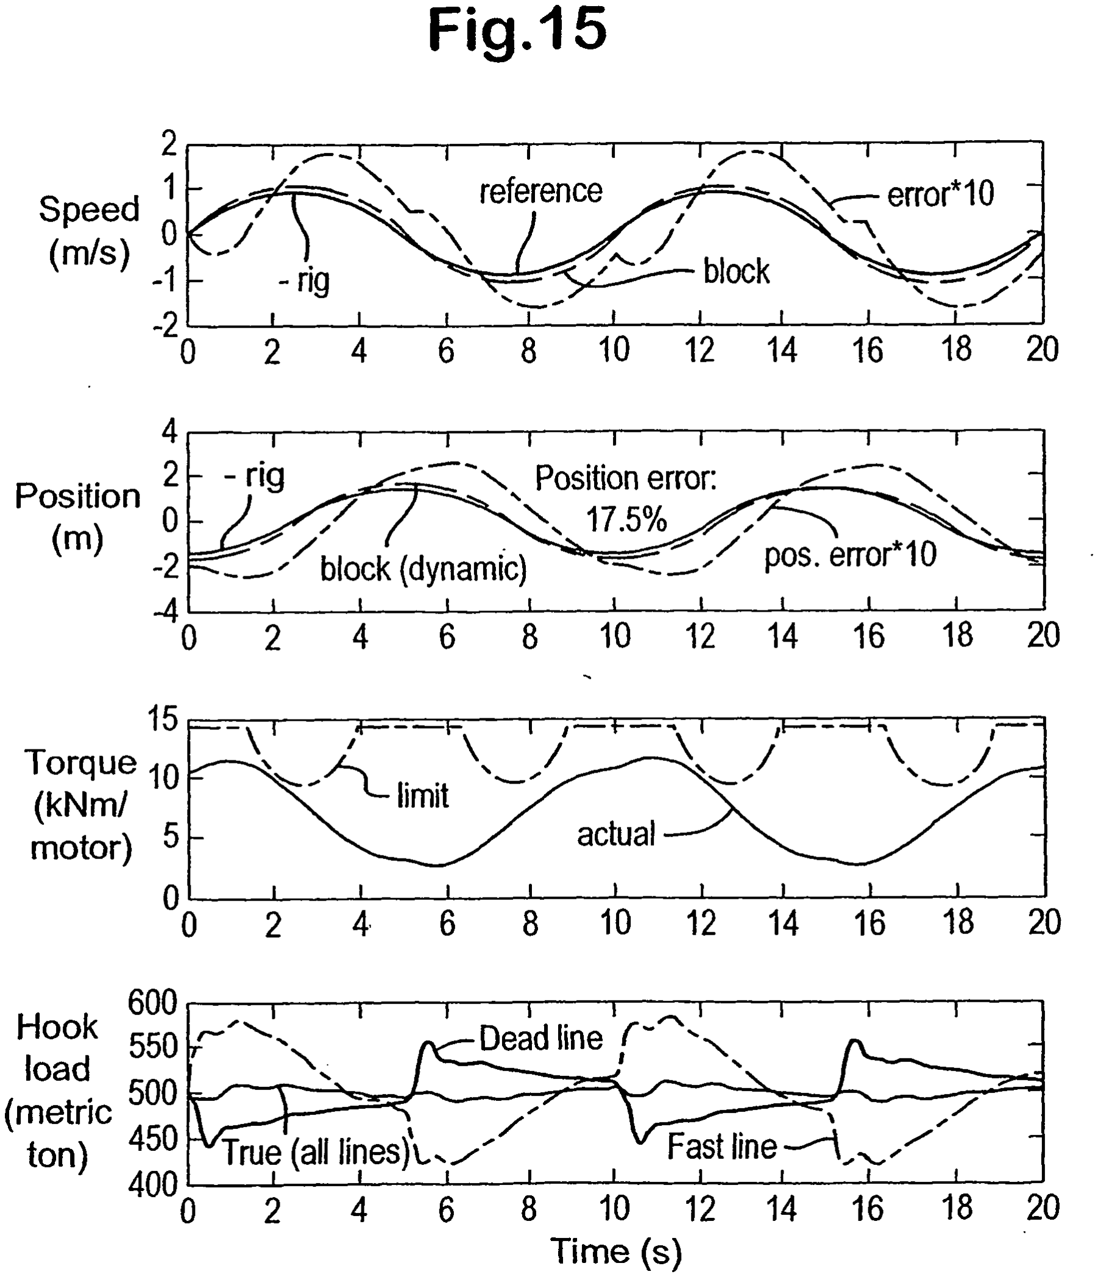
[picture p110: figure]

45

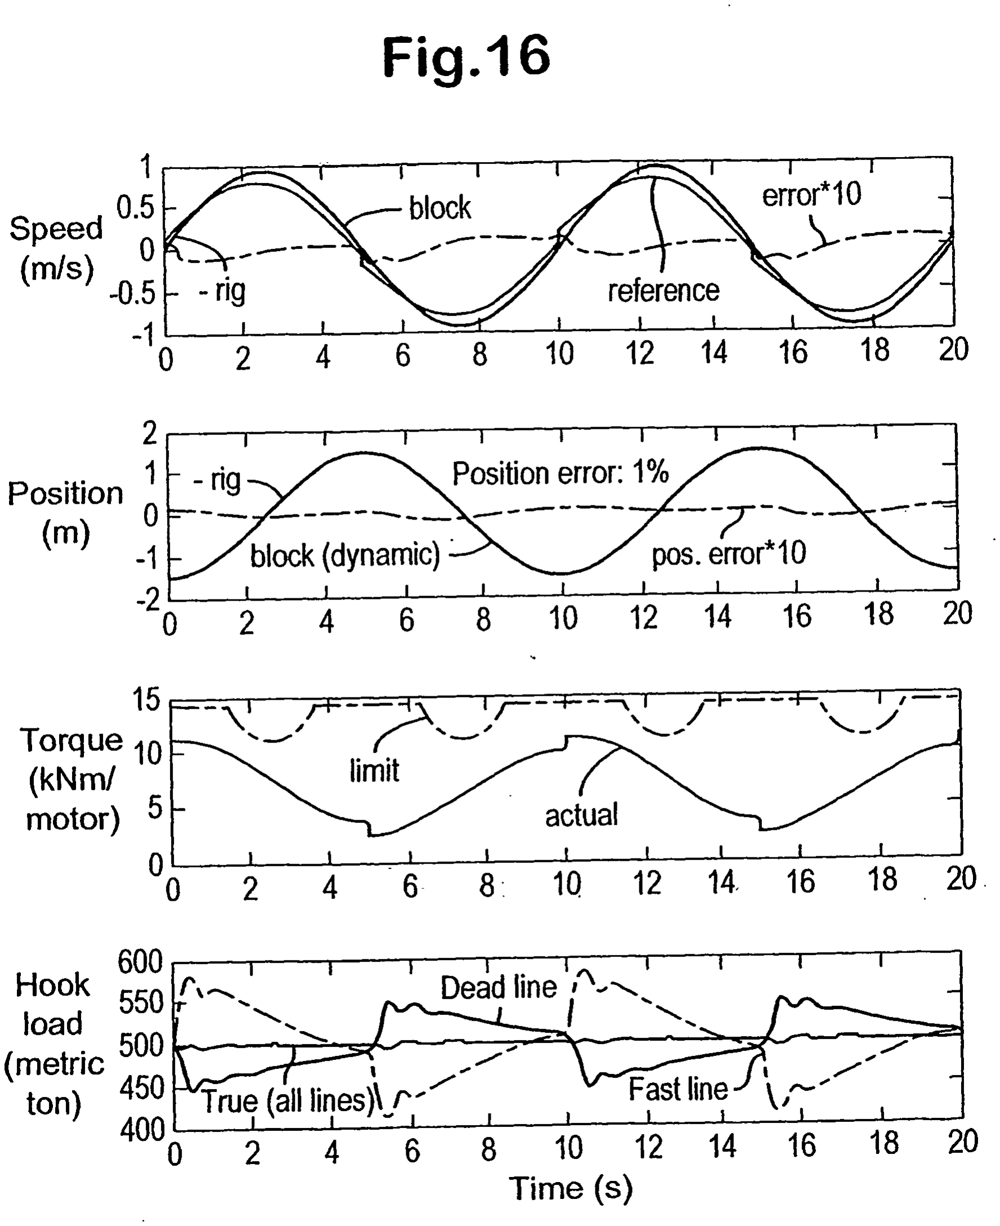
[picture p111: figure]

46

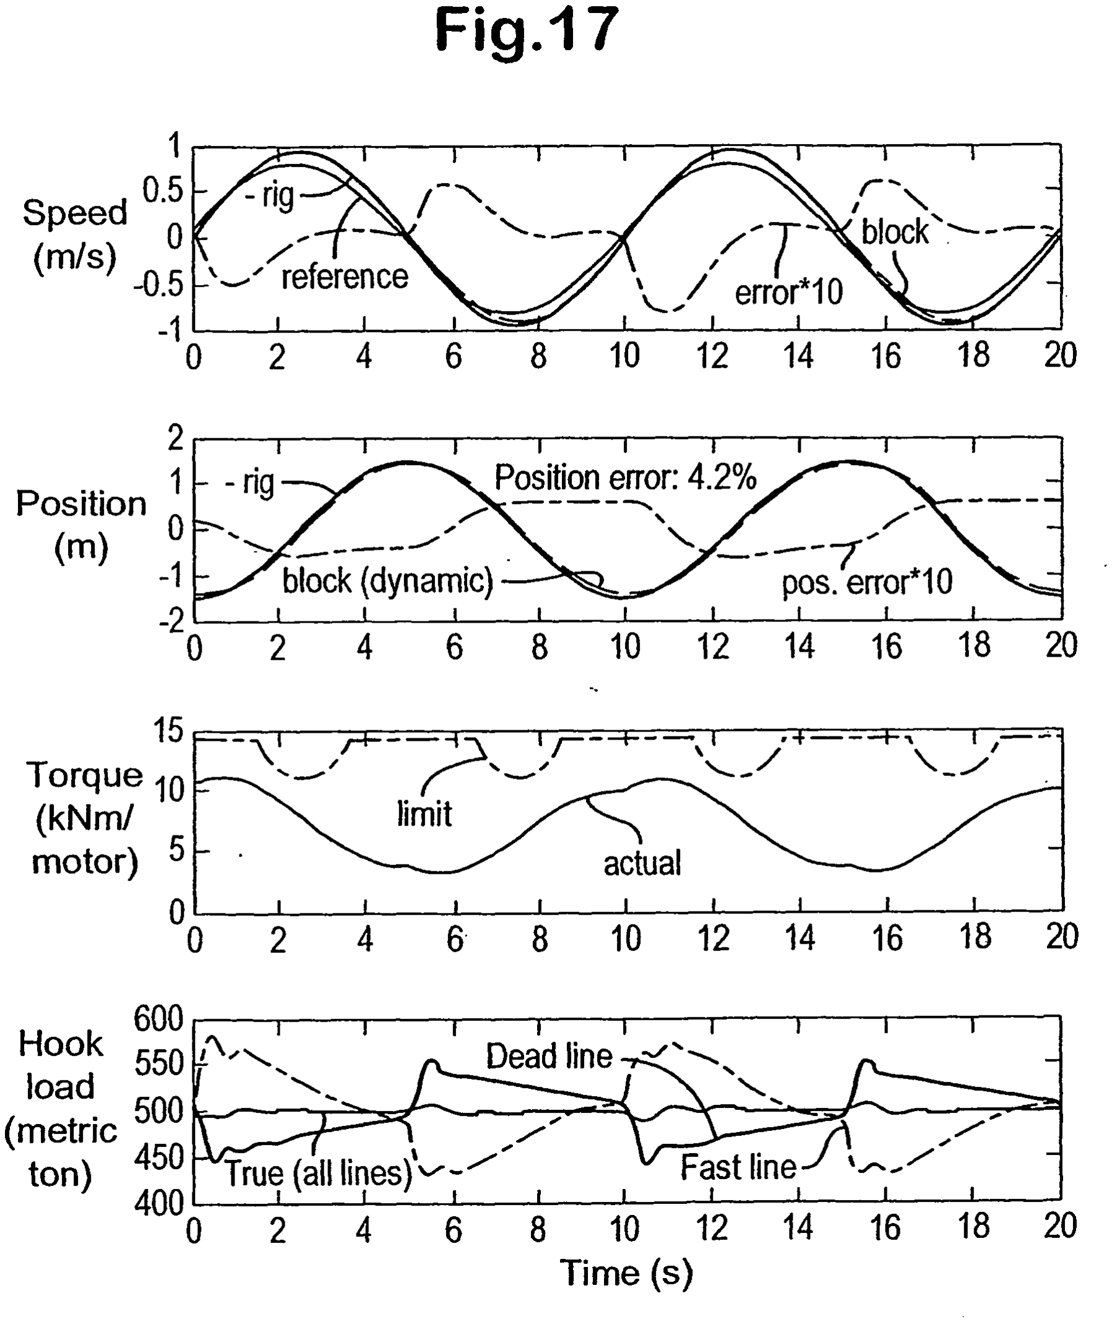
[picture p112: figure]

47

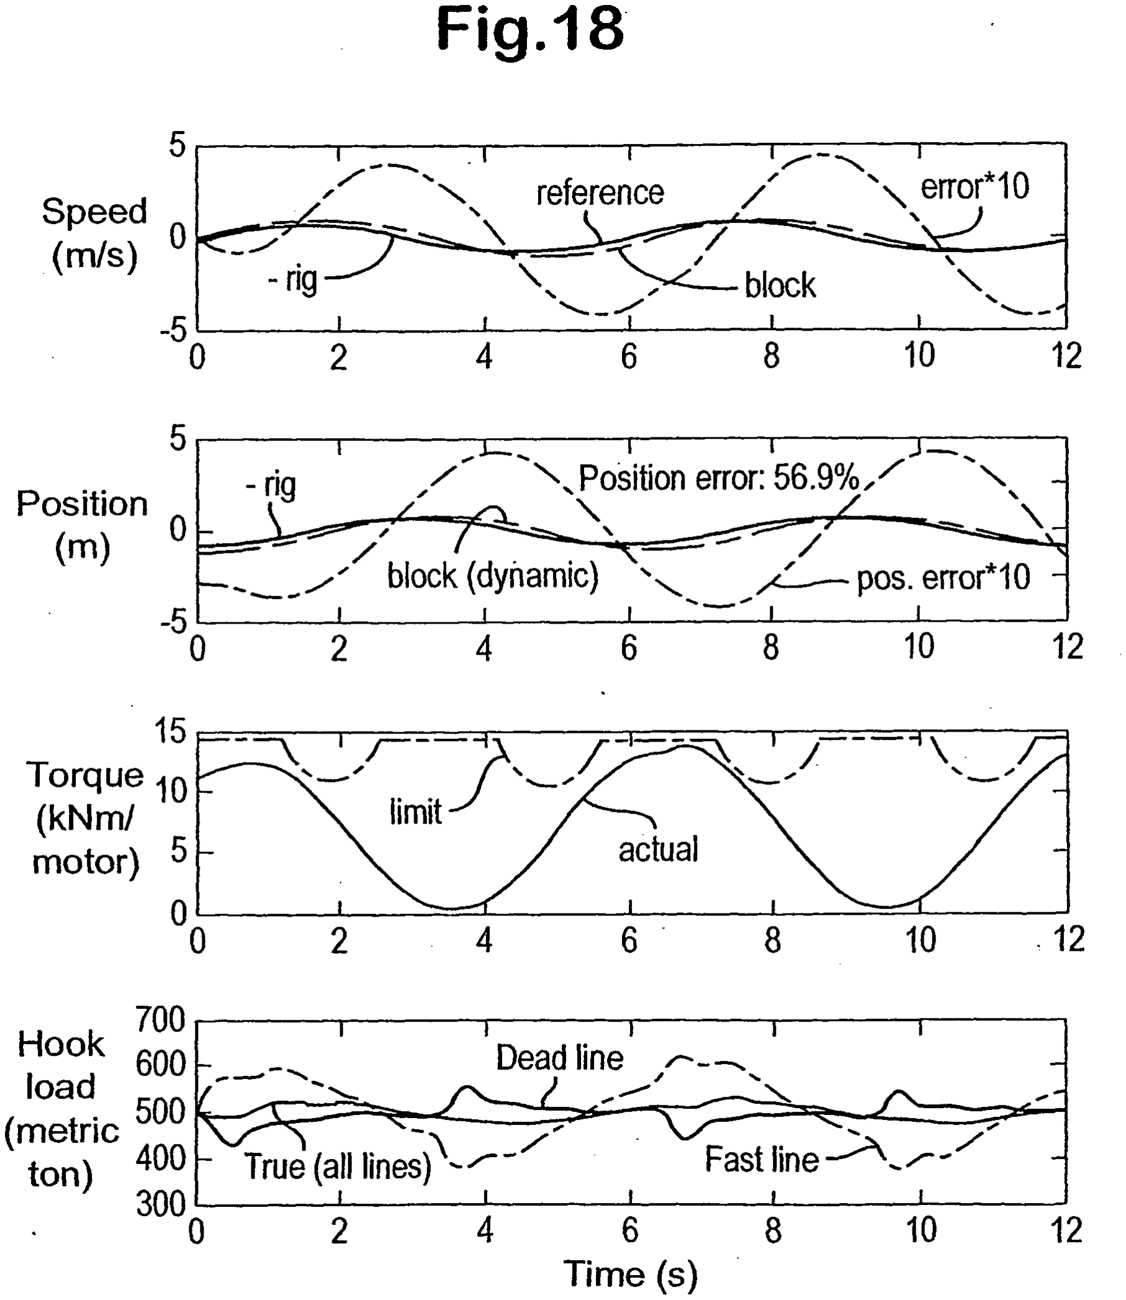
[picture p113: figure]

48

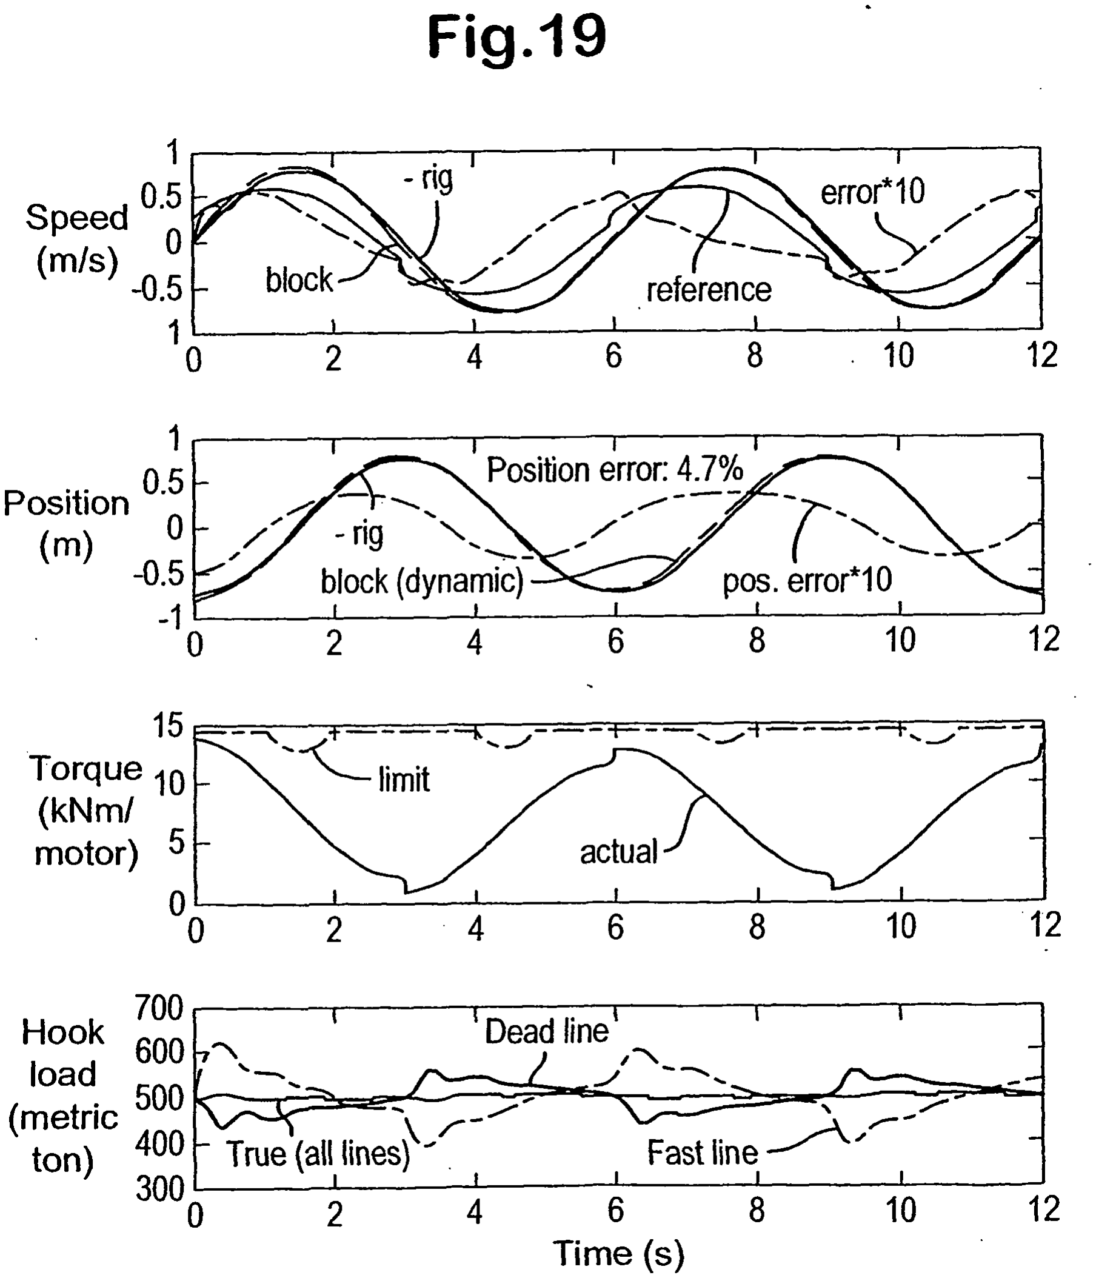
[picture p114: figure]

49

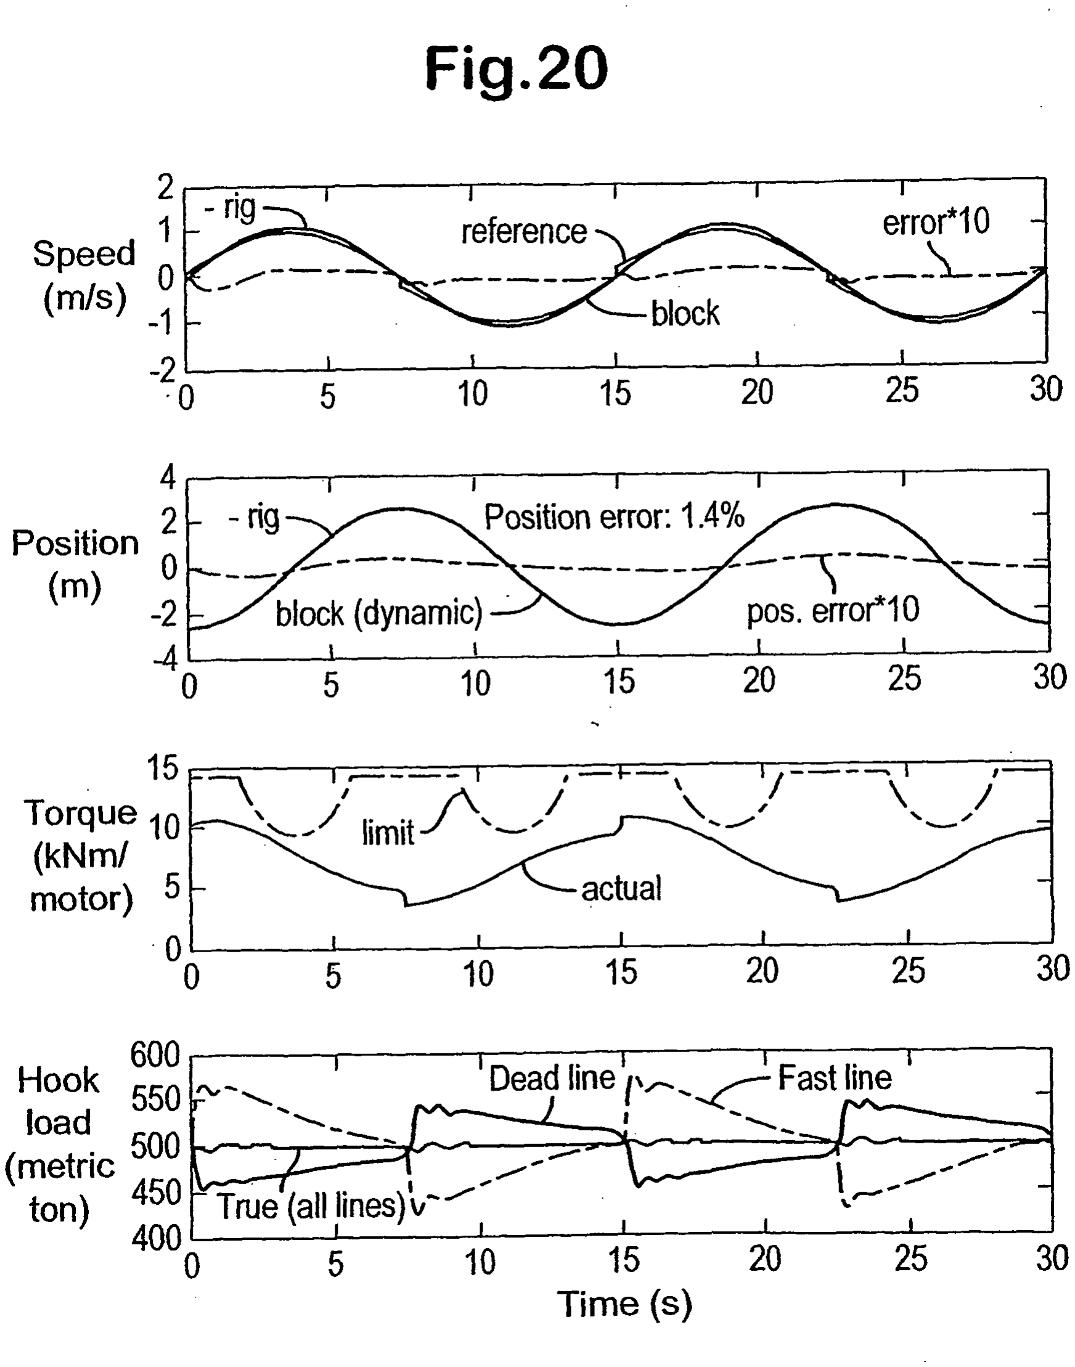
[picture p115: figure]

50

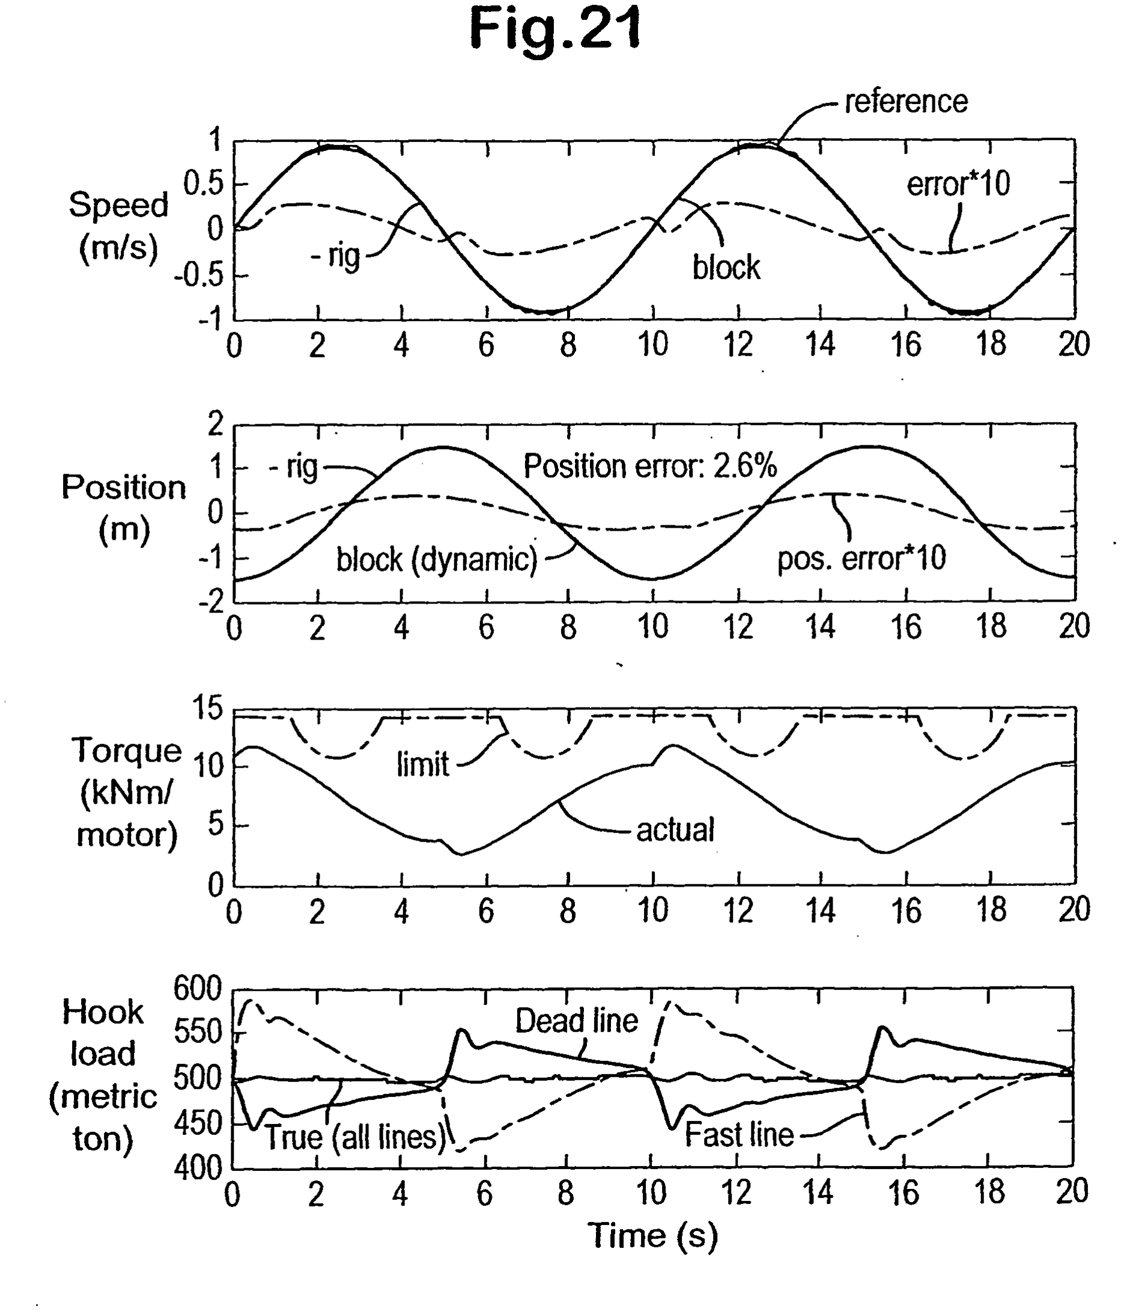
[picture p116: figure]

51

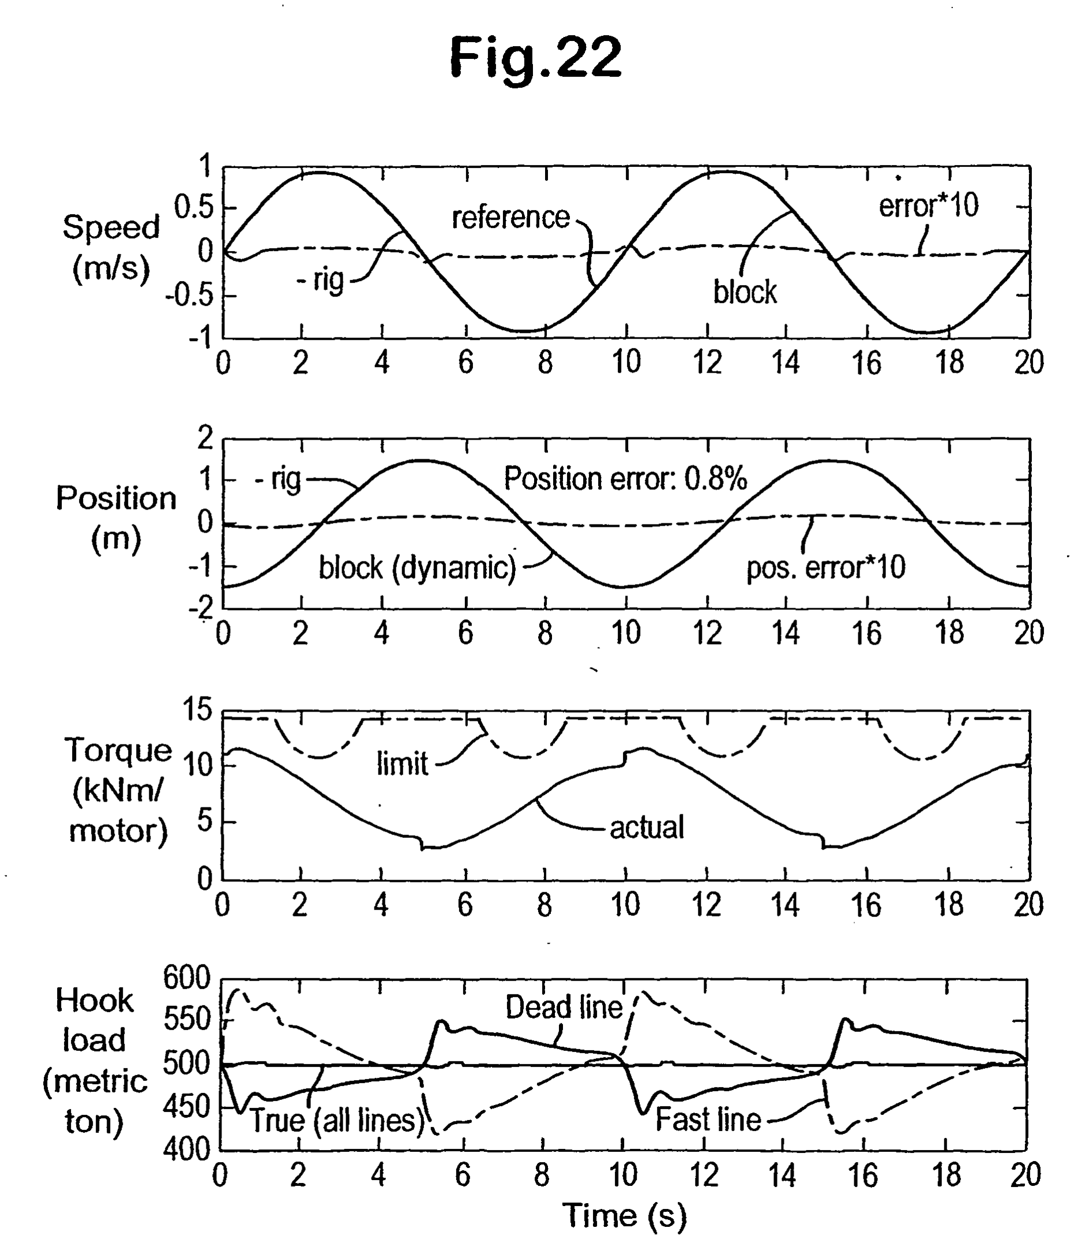
[picture p117: figure]

52

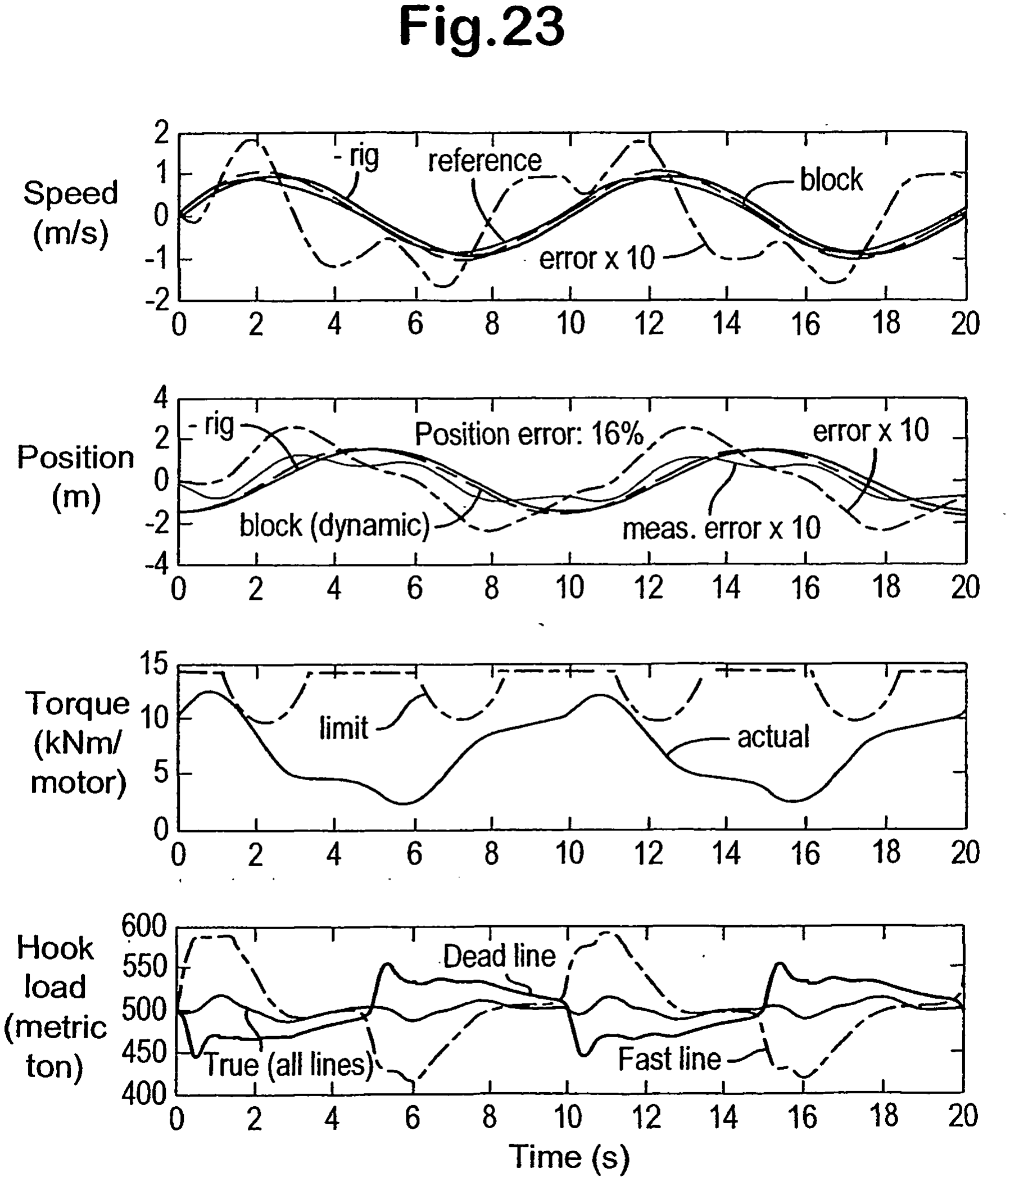
[picture p118: figure]

53

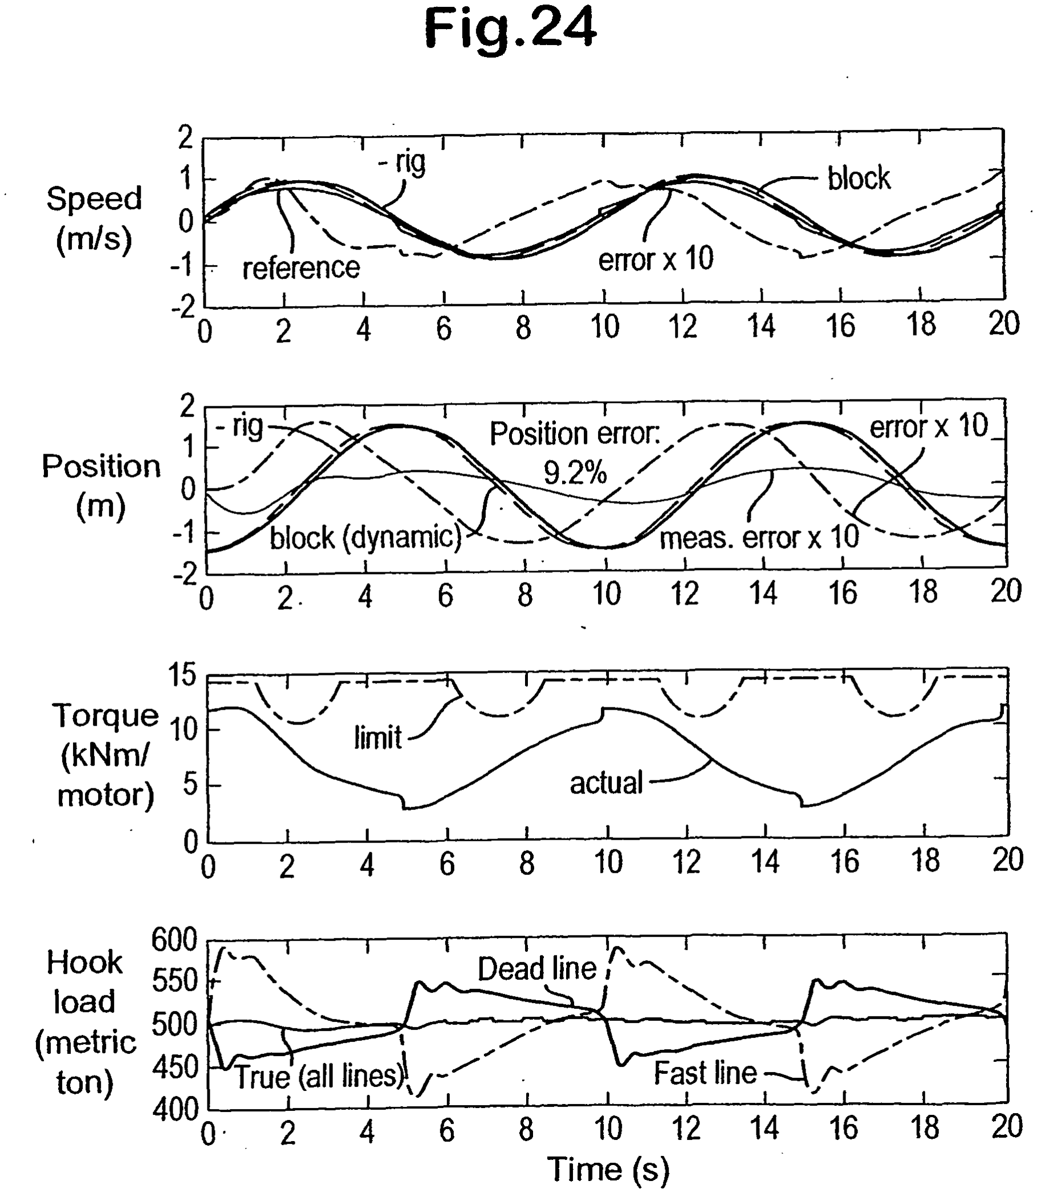
[picture p119: figure]

54

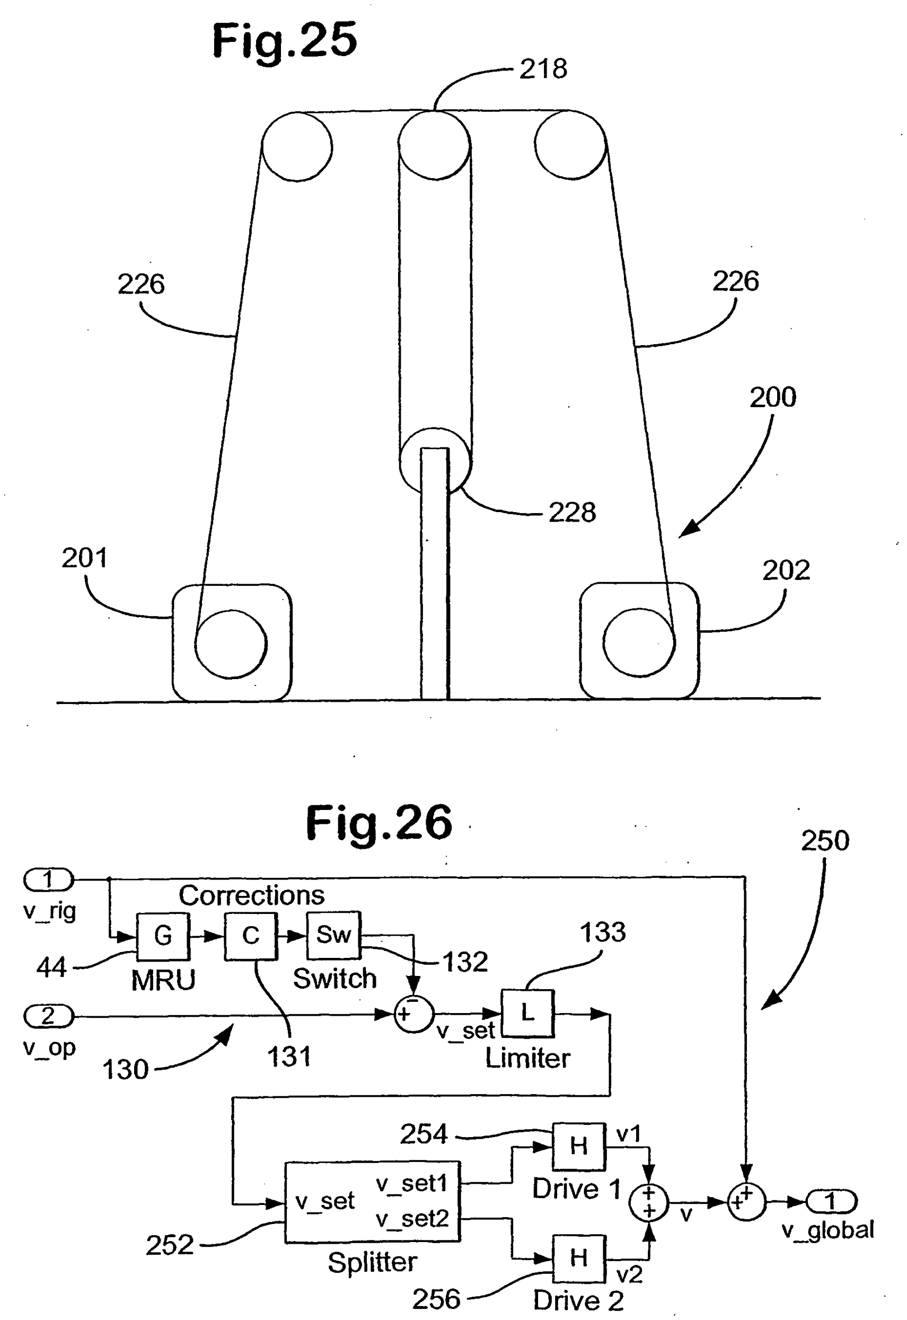
[picture p120: figure]

55

56

REFERENCES CITED IN THE DESCRIPTION

This list of references cited by the applicant is for the reader’s convenience only. It does not form part of the European patent document. Even though great care has been taken in compiling the references, errors or omissions cannot be excluded and the EPO disclaims all liability in this regard.

Patent documents cited in the description

- US 4104608 A [0009]

Non-patent literature cited in the description

- The data was recorded on the drillship Deepwater Frontier, 10 October 2001 [0120]
