KlaussMarchi/MRU/Analysis/Optimizer/Heave/docs/Macroentrega_IV___MRU.pdf

# RELATÓRIO DE MACROENTREGA 4

Dispositivo Referência de Monitoramento dos Movimentos em Helidecks e Guindastes Offshore

PIFF-2411.0049

Período: 04/11/2025 a 04/03/2026

Item | Produto | Critérios de Aceitação
8.1 Testes de Bancada | Relatório | Relatório contendo informações refe-rentes aos resultados dos testes de bancada e o correto funcionamento de acordo com o proposto.
8.2 Testes Estáticos e Dinâ-micos com DRMM | Relatório | Relatório contendo informações refe-rentes aos resultados dos testes esta-tísticos e dinâmicos
8.3 Ajustes e aprimoramen-tos | Relatório | Relatório contendo informações refe-rentes aos ajustes e aprimoramentos realizados após os testes

Polo de Inovação
Campos dos Goytacazes

DIRETOR DO PICG
Vicente de Paulo Santos de Oliveira

DIRETOR DE INOVAÇÃO TECNOLÓGICA

Rogério Atem de Carvalho

DIRETORA DE GESTÃO DE PROJETOS

Juliana Gonçalves Vidigal

COORDENADOR DO PROJETO
Robson da Cunha Santos

PESQUISADORES
Gerson Gomes Cunha
Milena Bissonho Soares
Jean Viana Ribeiro
Klauss Miranda Marchi
Letícia Barcelos Reis
Matheus Ribeiro Vidal

ESTUDANTES
Abraão Carlo Meireles Leite Gabriel Renato Pereira Campos Matteus Araujo Ouverney
Danilo Ricardo Lima de Oliveira

VOLUNTÁRIOS

Breno Moreira Rangel
Levy da Silva Monteiro
Lucas Marvilla Andrade Pinheiro Kenui Souza Quintanilha

## Sumário

1 Introdução | 6
2 Metodologia | 7
3 Desenvolvimento | 14
4 Considerações Finais | 20

## Lista de Figuras

1 | Diagrama do Sistema | | 7
2 | Esquematização do Pêndulo de Calibração | | 8
3 | Desenho Técnico do Pêndulo de Calibração | | 9
4 | Chapa Superior do Pêndulo | | 9
5 | Orientação dos Eixos na Plataforma | | 10
6 | Encoder Anexado no Pêndulo | | 11
7 | Orientação Utilizada | | 11
8 | Representação 2D para Calibração | | 12
9 | Extração de Dados em Bancada | | 14
10 | Dispositivo na Embalagem 1.0 | | 15
11 | Dispositivo na Embalagem 2.0 | | 16
12 | Dispositivo Pesado em uma Balança de Precisão | | 16
13 | Pêndulo Montado em Testes de Bancada | | 17
14 | Orientação Gráfica de Todas as Variáveis do Sensor Kernel | | 18
15 | Comparação do Encoder com o DRMM | | 19
16 | Comparação do Encoder com o DRMM (Ajuste Linear) | | 19

## RESUMO

Este relatório apresenta os estudos e as implementações relativos à quarta macroentrega do projeto, cujo objetivo é desenvolver um sistema embarcado capaz de competir com equipamentos de monitoramento de movimentos em helidecks e guindastes instalados em ambiente marítimo. O escopo abrange a avaliação de novas placas de prototipagem, a realização de testes de campo com os sensores atualmente disponíveis e a consolidação de algoritmos de filtragem e de fusão de dados com base nos resultados registrados em macroentregas anteriores, como produto desta etapa, pretende-se disponibilizar os elementos necessários para a transição dos protótipos existentes para um equipamento apto a ensaios em campo, incluindo as placas de circuito impresso, os procedimentos de calibração, os protocolos de comunicação validados e uma interface gráfica do usuário implementada pela equipe do projeto, preparada para a troca de dados em fluxo contínuo, com exibição de velocidade e aceleração em frequência específica e configurável, e concluindo o software de monitoramento.

Palavras-Chave: Helidecks; Dispositivos de Referência de Movimento; Sensores; Microcontroladores.

## 1 Introdução

A calibração adequada dos dispositivos de referência de movimento constitui um requisito fundamental para garantir a precisão e exatidão nas medições de variáveis dinâmicas, como aceleração linear, velocidade angular e ângulos de orientação (CUI et al., 2024). Dado que os protótipos iniciais já foram desenvolvidos e submetidos a testes preliminares controlados por códigos dedicados a sistemas embarcados, é essencial estabelecer um procedimento padronizado de calibração.
Um procedimento de calibração e fusão de dados de sensores em tempo real pode contribuir para a confiabilidade dos dados coletados e o funcionamento adequado do equipamento final em condições reais (NEMEC et al., 2016). Neste documento, detalham-se os testes executados para verificação das variáveis monitoradas, definindo-se a metodologia de calibração que confronta valores teóricos ideais com leituras brutas dos sensores.
A análise das discrepâncias entre dados reais e esperados permite quantificar erros e aplicar rotinas de correção via software, aproximando as medições ao comportamento padrão do sistema (ŠOMPLáK et al., 2018). Para minimizar divergências e elevar a robustez

do dispositivo, utilizam-se filtros digitais, algoritmos de fusão de dados e técnicas de aprendizado de máquina, permitindo compensação automática de variações indesejadas e alta confiabilidade das informações processadas (VERTZBERGER; KLEIN, 2022). Esses recursos já foram apresentados nos relatórios anteriores e serão implementados no protótipo final devidamente calibrado e testado.

## 2 Metodologia

O projeto conta com uma estrutura dedicada à calibração do dispositivo, que será apresentada junto aos principais passos do procedimento. Assim, o sistema embarcado, que constitui o processador principal juntamente com o sensor e está envolto em um compartimento dedicado, envia os dados de orientação a um computador, que, por sua vez, os armazena para análises futuras.

### 2.1 Modelagem

O diagrama apresentado na Figura 1 ilustra de forma coerente o princípio fundamental do processo de calibração. A estrutura representa a comparação entre um valor de referência, denominado "saída real", e o valor estimado pelo sistema de medição, denominado "saída estimada" (DAMASCENO; COUTO, 2018).

Figura 1: Diagrama do Sistema

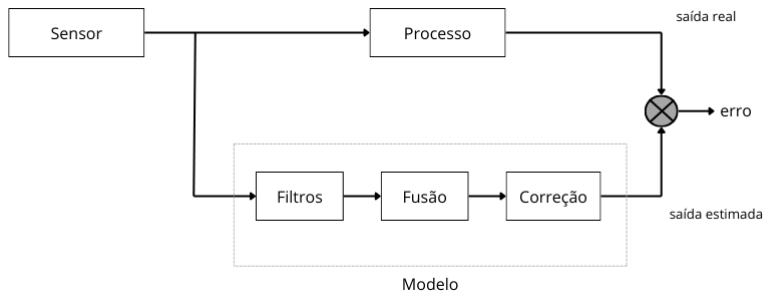
[picture p139: figure]

Fonte: Autoria Própria

O caminho superior, identificado como "Processo", simula a geração do valor verdadeiro da grandeza física, atuando como o padrão de referência contra o qual o sistema será comparado. O caminho inferior, englobado pelo bloco "Modelo", representa a cadeia de processamento do sistema de medição. Este recebe o sinal bruto do "Sensor" e aplica etapas de tratamento, incluindo "Filtros", "Fusão" de dados e, crucialmente, a "Correção". A etapa de "Correção" é o ponto onde os coeficientes de calibração, determinados pela análise do "erro" resultante da comparação, são aplicados para ajustar a saída do sistema. Portanto, o objetivo da calibração é minimizar o "Erro" indicado na saída do comparador, ajustando os parâmetros do bloco de "Correção" para que a "Saída Artificial" se aproxime ao máximo da "Saída Ideal".
Diante do exposto, a metodologia descrita, que fundamenta a minimização do erro através do ajuste dos parâmetros de correção, será aplicada experimentalmente utilizando um pêndulo simples como padrão de referência para gerar os valores teóricos esperados. Essa escolha de referência justifica-se pela possibilidade de prever teoricamente o comportamento oscilatório do sistema, permitindo a comparação direta entre os valores medidos pelos sensores e os esperados pelas equações do movimento (TEPE; YAVAN, 2021).

### 2.2 Pêndulo Simples

O instrumento que se utilizará para calibrar o sensor será um pêndulo simples, inspirado no aparato de testes desenvolvido por House 2010, no qual um pêndulo de 4 metros de comprimento (Figura 2), com junta universal de dois graus de liberdade acoplada a encoders angulares e suportado por uma estrutura de quatro pernas similar a um tripé, permitiu a comparação simultânea e direta do desempenho de oito unidades de medição inercial fixadas em uma plataforma balanceada na extremidade inferior do braço. Esse arranjo fornece um movimento oscilatório controlado e matematicamente previsível, no qual o sensor é fixado à massa móvel de modo a registrar as variações contínuas de aceleração e velocidade angular durante os ciclos de oscilação, enquanto as equações fundamentais da física clássica fornecem os valores de referência teóricos para o mesmo intervalo de tempo.

Figura 2: Esquematização do Pêndulo de Calibração

(a) Diagrama de Corpo Livre | (b) Ilustração com Dispositivo

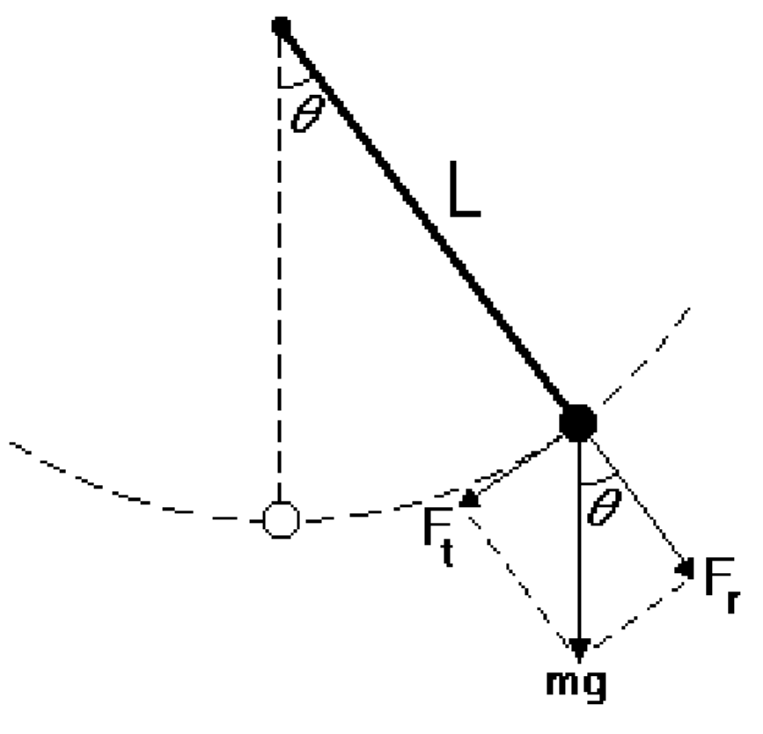
[picture p140: figure]

Fonte: House, Thomas. (https://nrc-publications.canada.ca/eng/view/object/?id=2b49dae2-b5b7-403b-93ba-6b03a40a230b)

O procedimento de calibração pode ser realizado por um método matemático puro ou com instrumentação auxiliar, como encoders discretos de posição angular. Na abordagem matemática, modela-se um pêndulo simples com atrito, decompondo o movimento nos eixos vertical e horizontal. A dinâmica do sistema baseia-se na variação do deslocamento angular θ, cujo coeficiente de atrito α é determinado experimentalmente a partir das oscilações observadas. No entanto, estimativas imprecisas de α podem comprometer a acurácia global do procedimento (NALISKO et al., 2019). Além disso, esse método apresenta um risco de dependência circular, uma vez que o decaimento das oscilações é medido pelo próprio sensor em calibração (TRYON; WILLIAMS, 1996).

Diante dos desafios previamente destacados, optou-se pela utilização exclusiva do pêndulo simples equipado com encoder, o qual fornecerá o ângulo de rotação θ para comparação direta com os dados do sensor. Assim, o dispositivo poderá ser devidamente calibrado ao ser fixado na extremidade inferior do pêndulo e submetido a oscilações em angulações conhecidas. O encoder angular, instalado no eixo de rotação, proporciona a posição exata do braço, viabilizando a comparação entre a leitura de referência e os dados de orientação obtidos pelo sensor inercial (HOUSE, 2010).
A estrutura do pêndulo, conforme mostrado na Figura 3, foi confeccionada utilizando liga de alumínio 6063-T5, material selecionado por sua relação entre resistência e leveza. A plataforma base, projetada para a fixação dos sensores, é constituída por chapas sobrepostas com dimensões de 400mm x 400mm e 3mm de espessura, integradas a uma estrutura tubular (com diâmetros variando entre 1½” e 2”) que confere robustez ao conjunto. O sistema conta ainda com uma articulação traseira macho e fêmea projetada para acoplamento a um cilindro pneumático (ISO Ø 32mm), assegurando a repetibilidade dos movimentos oscilatórios, e uma chapa superior de dimensões 6,35mm x 200mm x 200mm que permite que o aparato seja fixado, para a realização dos testes.

Figura 3: Desenho Técnico do Pêndulo de Calibração

(a) (b)

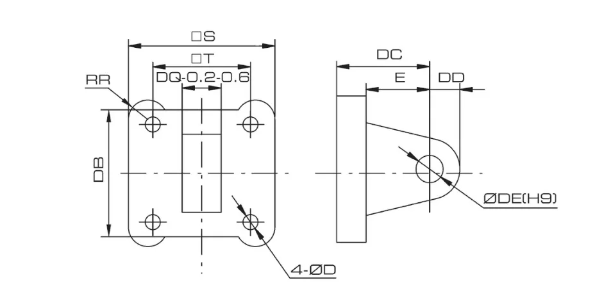
[picture p141: figure]
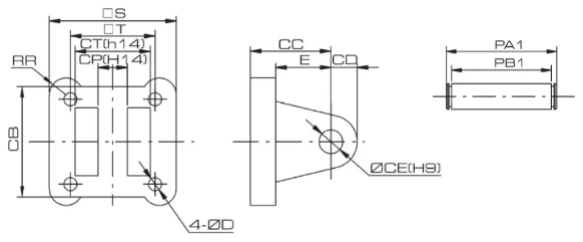
[picture p142: figure]

Fonte: Autoria Própria

A Figura abaixo apresenta a parte superior do aparato, composta por uma chapa superior, tubulação e articulação.

Figura 4: Chapa Superior do Pêndulo

(a) (b)

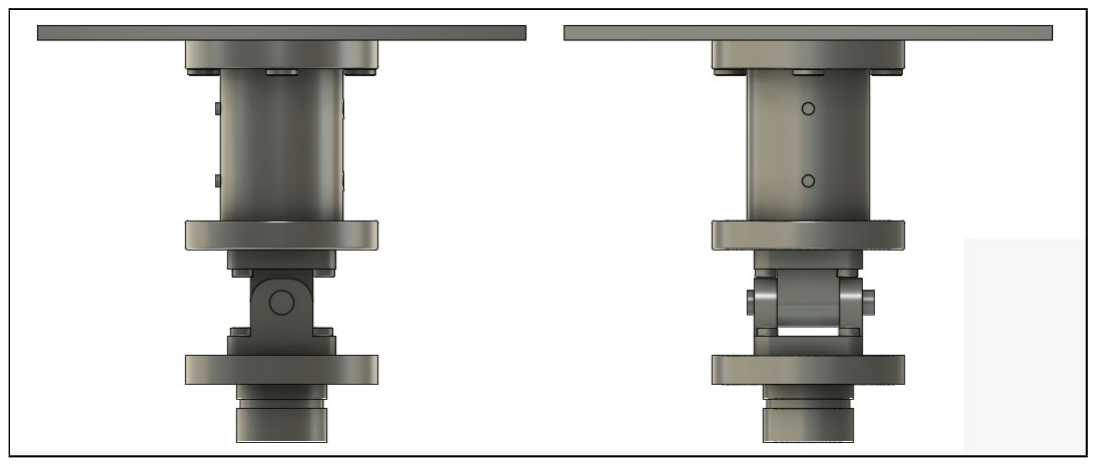
[picture p143: figure]
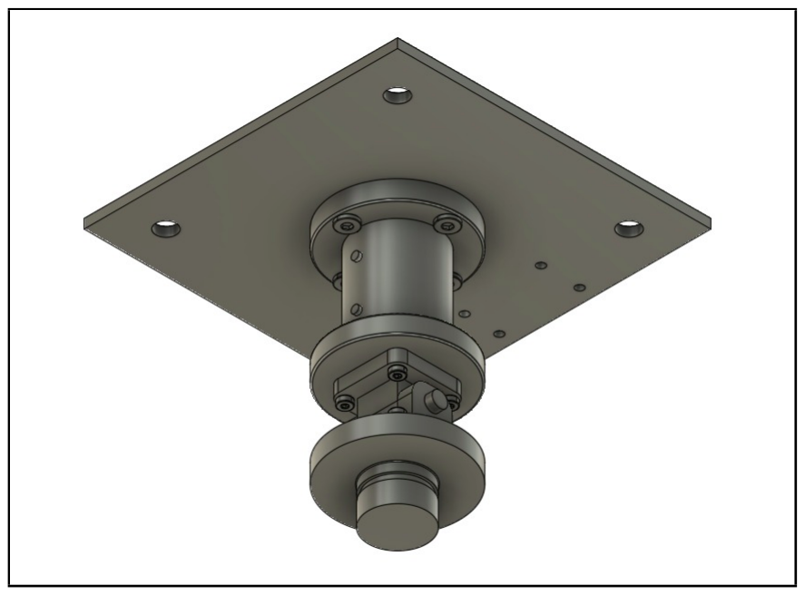
[picture p144: figure]

Fonte: Autoria Própria

No que diz respeito à funcionalidade, o Dispositivo de Referência de Movimento (DDRM) permite a rotação da base de fixação, possibilitando a simulação de movimentos tanto no eixo X quanto no eixo Z sem alteração das propriedades físicas do sistema, mantendo a equivalência do período do pêndulo em ambas as orientações. A Figura 6 mostra a orientação descrita devidamente.

Figura 5: Orientação dos Eixos na Plataforma

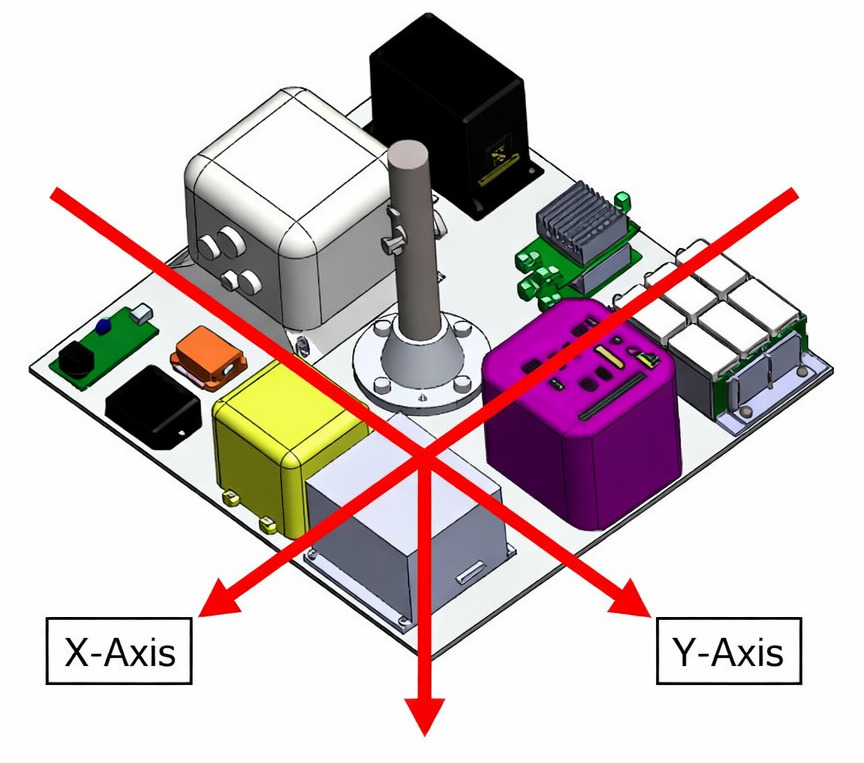
[picture p145: figure]

Fonte: Fabricante JP MAGNATA

A validação do equipamento e a calibração dos sensores são realizadas através de duas etapas: testes estáticos, destinados à identificação de desvios constantes e estabilidade do sinal; e testes dinâmicos, que avaliam a resposta dos sensores a variações de aceleração e velocidade angular sob diferentes amplitudes de oscilação.

### 2.3 Encoder

O encoder é um dispositivo eletromecânico que converte a posição angular de um eixo em pulsos digitais, fornecendo uma medida precisa de referência para calibração de sensores inerciais (TEPE; YAVAN, 2021). Neste projeto, utiliza-se preliminarmente um modelo comercial E40S6 com resolução de 1024 pulsos por revolução (ppr), equivalente a uma precisão angular de aproximadamente 0, 35◦

(360◦
/1024), selecionado por sua disponibilidade imediata e adequação comprovada em testes experimentais similares com pêndulos. A figura abaixo mostra o encoder que acoplado ao eixo de rotação do pêndulo.

Figura 6: Encoder Anexado no Pêndulo

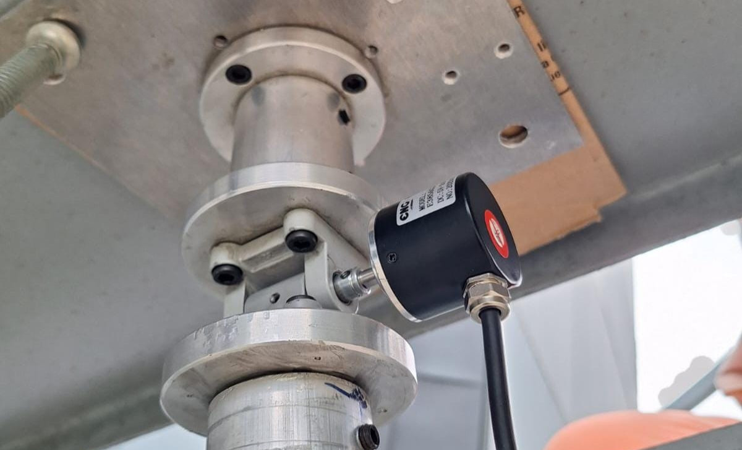
[picture p146: figure]

Fonte: Fabricante JP MAGNATA

Ao rotacionar o pêndulo, o encoder retornará um valor proporcional ao ângulo de rotação, que será comprarado, onde análises comparativas demonstrarão as limitações relativas desse encoder inicial em relação às medições refinadas do sensor Kernel após calibração, destacando a necessidade de um upgrade no dispositivo.

### 2.4 Calibração

O pêndulo integra uma estrutura tridimensional que possibilita oscilações em ambos os eixos, viabilizando a calibração do sensor inercial. A figura subsequente apresenta o plano cartesiano 3D adotado como referência para o cálculo dos movimentos, derivados do ângulo ϕ mensurado pelo encoder, os quais serão comparados aos dados registrados pelo sensor do dispositivo. Assim, o gráfico apresentado na 7 ilustra a conversão de coordenadas esféricas para retangulares ao localizar um ponto no espaço 3D (STEWART et al., 2013).

Figura 7: Orientação Utilizada

(a) Orientação Cartesiana 3D | (b) Orientação do Sensor Kernel | (c) Orientação do Sensor Kernel

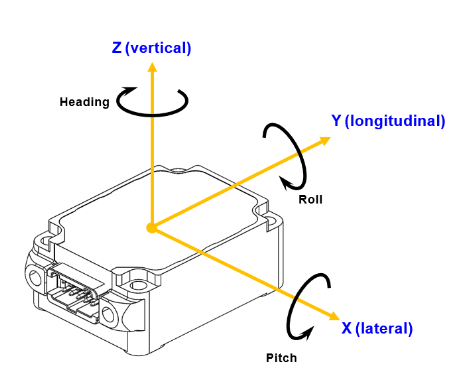
[picture p147: figure]

Fonte: Autoria Própria

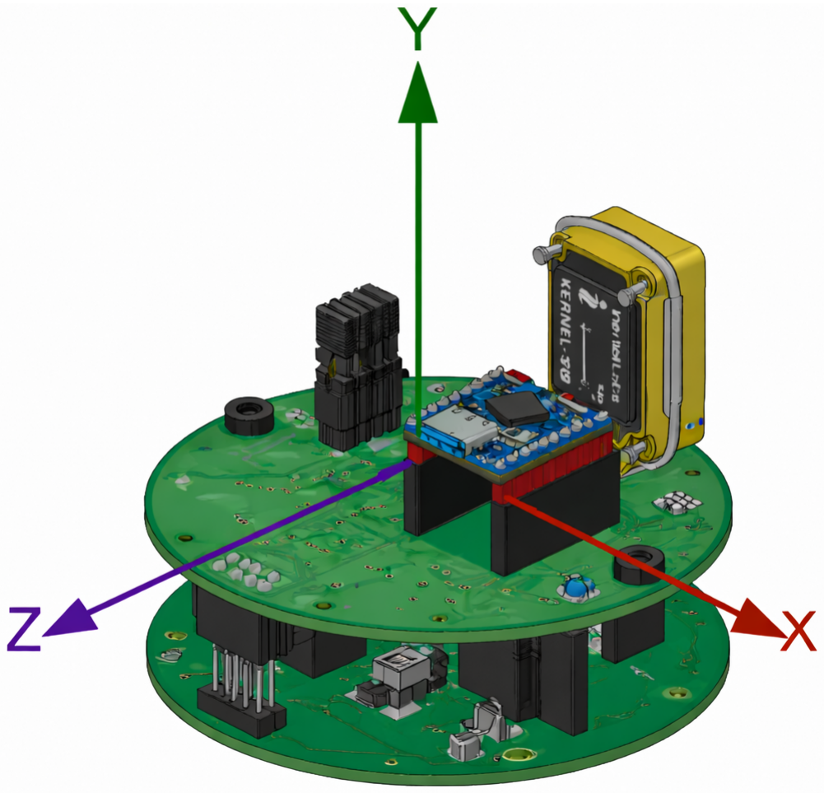
[picture p148: figure]
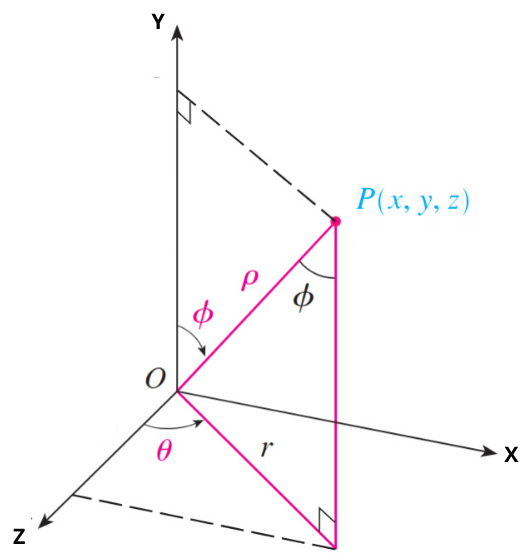
[picture p149: figure]

Nesse sistema de coordenadas, ρ representa a distância da origem, ϕ é o ângulo a partir do eixo vertical y, e θ é o ângulo de rotação no plano horizontal xz. A calibração será feita inferindo a partir de ϕ(t) as variáveis que serão comparadas com os dados brutos obtidos a partir do acelerômetro e do giroscópio.

### 2.4.1 Giroscópio

Para fins de exemplificação, ao posicionar o pêndulo variando somente o eixo x, é possível calibrar a velocidade angular referente ao eixo x, uma vez que o eixo y não sofrerá variação. Portanto, o ângulo θ será constante em 0º permitindo tratar a calibração de maneira bidimensional, como mostrado na Figura 8.

Figura 8: Representação 2D para Calibração

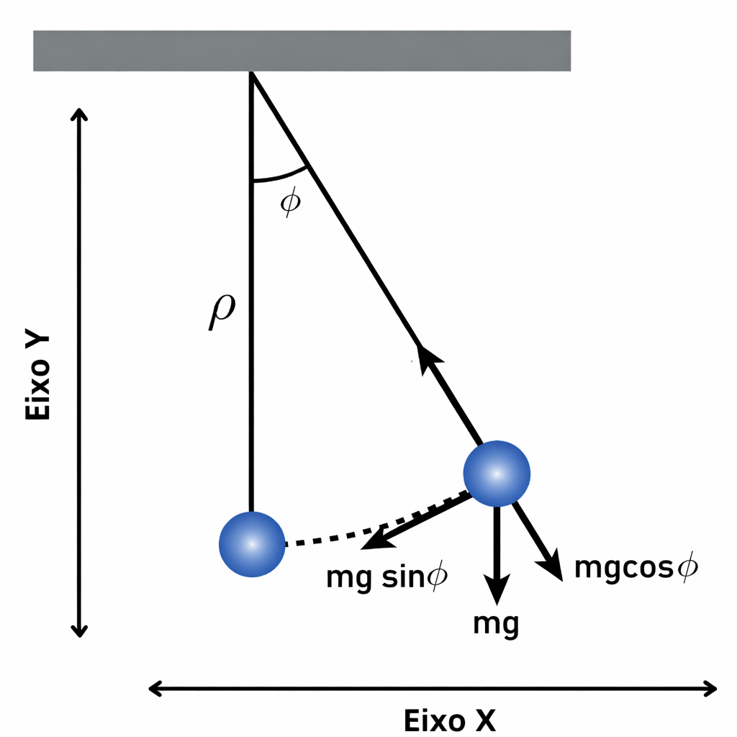
[picture p150: figure]

Fonte: Autoria Própria

A velocidade angular pode ser encontrada a partir de derivação simples do ângulo ϕ, conforme a Equação 1.

ϕ

′
x
(t) = dϕ
dt | (1)

Dessa forma, o ângulo de referência ϕ(t) deve ser sincronizado no tempo com os dados brutos do giroscópio e acelerômetro do sensor ϕs(t) e as(t), onde o eixo a ser variado será calibrado e ajustado por meio de uma função linear simples, dada por:

ϕ(t) = A · ϕs(t) + B | e | ϕ

′
(t) = C · ϕ

′
s
(t) + D | (2)

Através do método dos Mínimos Quadrados Ordinários (OLS), o algoritmo extrai os parâmetros intrínsecos do hardware. Os fatores de escala B e D, corrigem a sensibilidade proporcional do sensor, e o viés (Bias), que compensa o erro de deslocamento do sinal quando o dispositivo se encontra em repouso. A eficácia desse ajuste é posteriormente avaliada por métricas de erro absoluto, como o RMSE (Root Mean Square Error).

### 2.4.2 Acelerômetro

Diferentemente do giroscópio, a aferição do acelerômetro acoplado à extremidade do pêndulo é governada por uma dinâmica altamente não-linear. O sensor registra a força específica no referencial local da sua carcaça (solidário ao movimento), o que significa que ele sofre a influência simultânea da aceleração tangencial, da aceleração centrípeta e da decomposição vetorial contínua da gravidade em seus eixos devido à inclinação variante. Assim, é possível inferir tais variáveis a partir do encoder com ângulo ϕ(t) a partir das equações:

ax(t) = ρ · ϕ

′′ + g · sin(ϕ) | e | ay(t) = ρ · ϕ
| | ′2 + g · cos(ϕ) | (3)

Na equação do eixo x, o termo ρ · ϕ

′′ isola a componente tangencial do movimento,

enquanto g · sin(ϕ) rastreia a projeção variante da gravidade. De forma análoga, no eixo z, a não-linearidade é capturada pelo comportamento quadrático da força centrípeta ρ · ϕ

| | | ′2 e

pelo cosseno da gravidade. A calibração é feita de forma identica ao giroscópio comparando linearmente a variável de referência à variável do sensor, como mostrado na Equação 4.

ax(t) = A · axs(t) + B | e | ay(t) = C · ays(t) + D | (4)

Da mesma forma como seria a calibrção variando o eixo x, a calibração do eixo z consistiriam nas mesmas fórmulas, finalizando assim a metodologia.

## 3 Desenvolvimento

O dispositivo desenvolvido é equipado com um processador ESP32-S3 Mini de alto desempenho, dual-core Xtensa LX7 com clock de até 240 MHz e suporte nativo a WiFi e Bluetooth, integrado a uma placa de circuito impresso personalizada, juntamente com o sensor de orientação Kernel Motion Sensor AHRS (6/9 graus de liberdade), que proporciona medições precisas de aceleração linear, velocidade angular e orientação com ruído mínimo e filtragem embarcada. Todo o sistema embarcado é abrigado em uma embalagem protetora projetada em CAD e manufaturada por impressão 3D em material ABS de alta resistência mecânica, assegurando proteção ambiental, ergonomia para fixação no pêndulo de calibração e massa otimizada (451,6 g), inferior à de equipamentos comerciais equivalentes.

### 3.1 Testes de Bancada

O protótipo do dispositivo de monitoramento, evidenciado nas figuras subsequentes, mostra-se preparado para análises e testes experimentais. Conforme detalhado na metodologia, seus dados serão coletados por um computador e separados para futura análise. O microcontrolador alcança a frequência de amostragem de 100 Hz enviando dados de orientação em tempo real ao respectivo receptor através da comunicação estabelecida. A Figura 9 mostra o processo de captura e o armazenamento local dos dados do sensor pelo computador.

Figura 9: Extração de Dados em Bancada

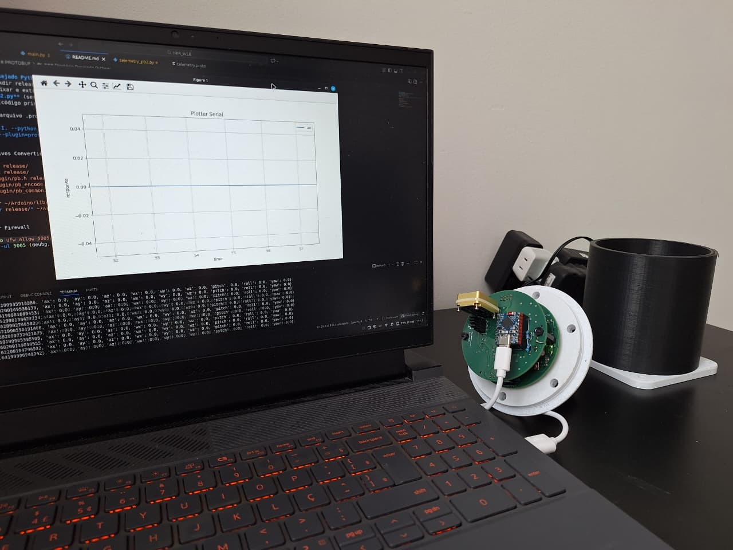
[picture p151: figure]

Fonte: Autoria Própria

A transmissão dessas informações pode ocorrer tanto por conexão física, via porta USB ou cabo RS422 com conversor, quanto remotamente, por meio de rede Wi-Fi. Na modalidade sem fio, utiliza-se o Protocol Buffers, tecnologia desenvolvida pela Google para serialização eficiente de dados estruturados em formato binário compacto (JACKSON; CUM-MINGS; KHAN, 2024), que otimiza o envio contínuo de informações, garantindo alta velocidade de comunicação e maior praticidade ao eliminar a necessidade de cabos durante os testes. Ambas as modalidades asseguram a integridade da coleta de dados e operam em frequências configuráveis de até 100 Hz.
Com o funcionamento do protótipo validado na placa de circuito impresso, a etapa seguinte consistiu na integração do sistema embarcado ao compartimento projetado na plataforma Fusion 360 e manufaturado via impressão 3D. A versão preliminar da caixa (Figura 10), objetiva a análise dimensional e ergonômica, permitindo verificar o acoplamento dos componentes, a necessidade de ajustes na altura dos pinos de fixação e a adequação dos orifícios para os parafusos responsáveis pelo fechamento do conjunto. A caixa contém o logotipo do Instituto Federal Fluminense (IFF) na tampa superior, conforme detalhado na modelagem tridimensional da macroentrega anterior, sendo a vedação do estojo garantida pela aplicação de seis parafusos com porcas para fixação.

Figura 10: Dispositivo na Embalagem 1.0

(a) Partes Desmontadas | (b) Tampa Superior | (c) Sistema Embarcado

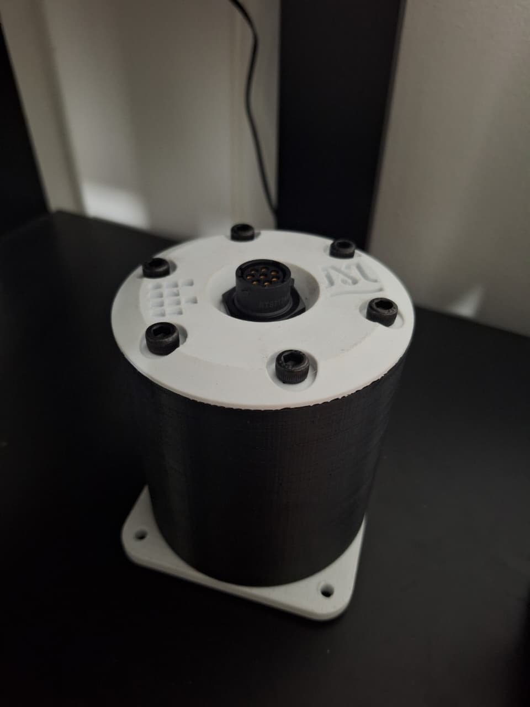
[picture p152: figure]
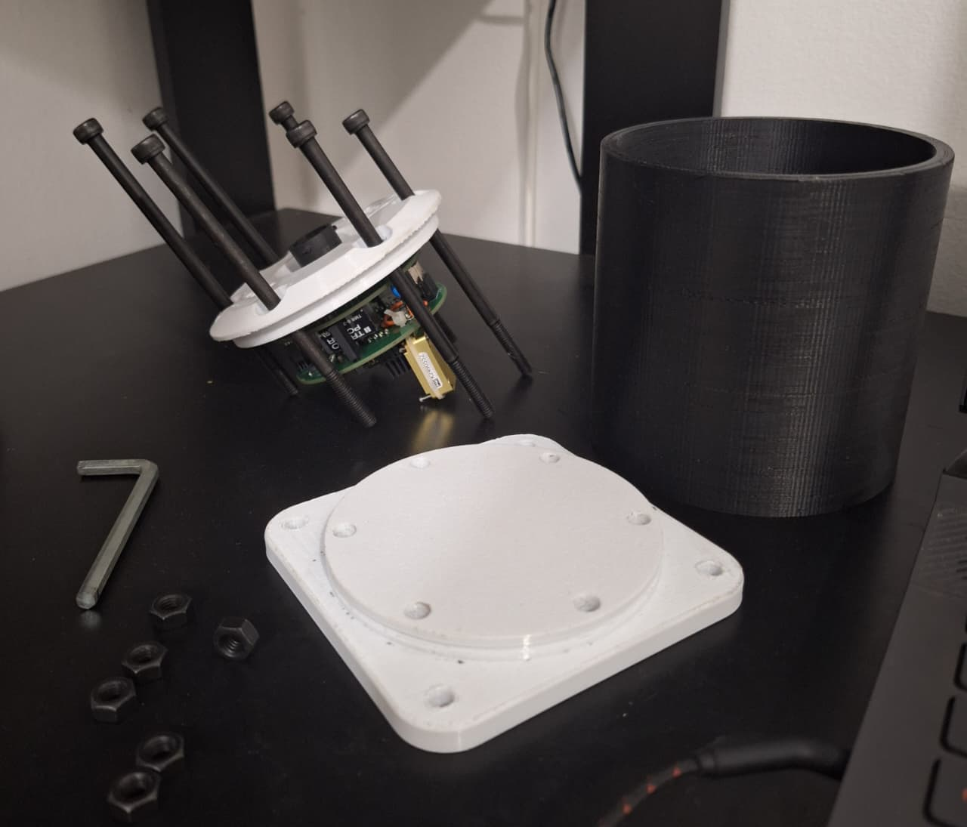
[picture p153: figure]

Fonte: Autoria Própria

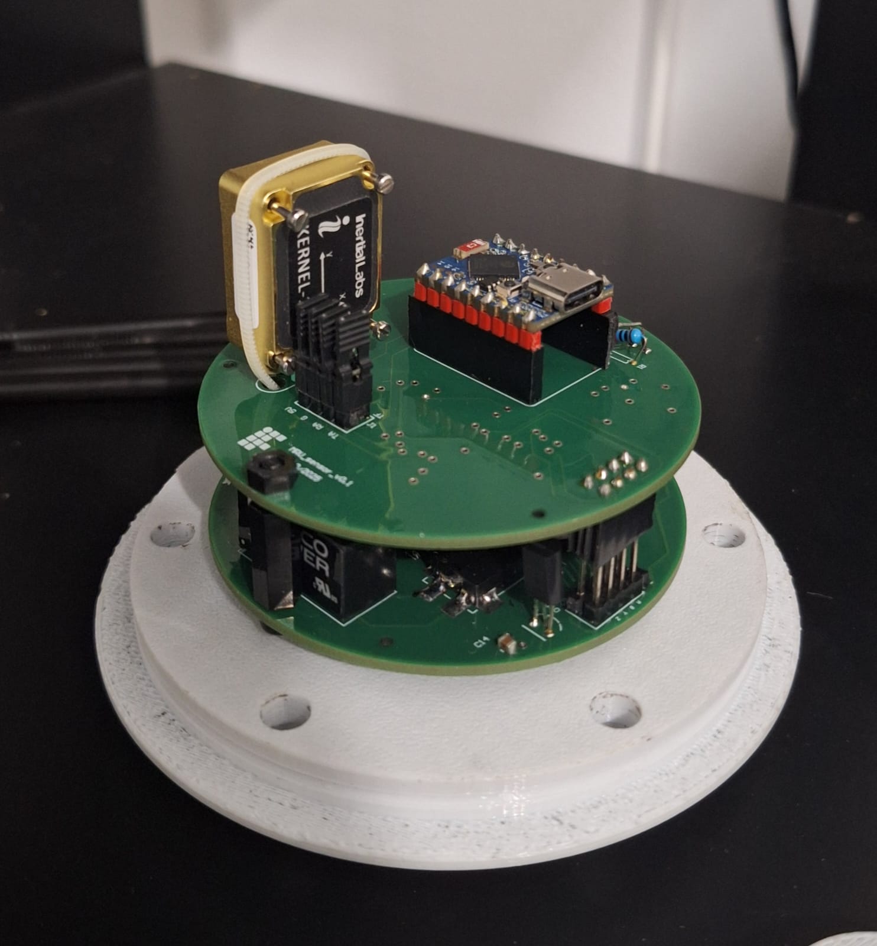
[picture p154: figure]

A segunda versão do compartimento, apresentada na Figura 13, foi manufaturada na cor preta para conferir maior sobriedade e acabamento profissional ao protótipo, além de apresentar as correções dimensionais necessárias identificadas na etapa anterior. O sistema embarcado foi acomodado integralmente no interior da estrutura e fixado com parafusos, sem intercorrências na montagem, o que valida as modificações geométricas realizadas. A conexão física ocorre através de um orifício cilíndrico na parte superior, destinado ao cabo de alimentação que também viabiliza a comunicação serial para configuração e extração de dados via computador, embora o dispositivo mantenha a funcionalidade de transmissão sem fio detalhada previamente.

Figura 11: Dispositivo na Embalagem 2.0

(a) | (b) | (c)

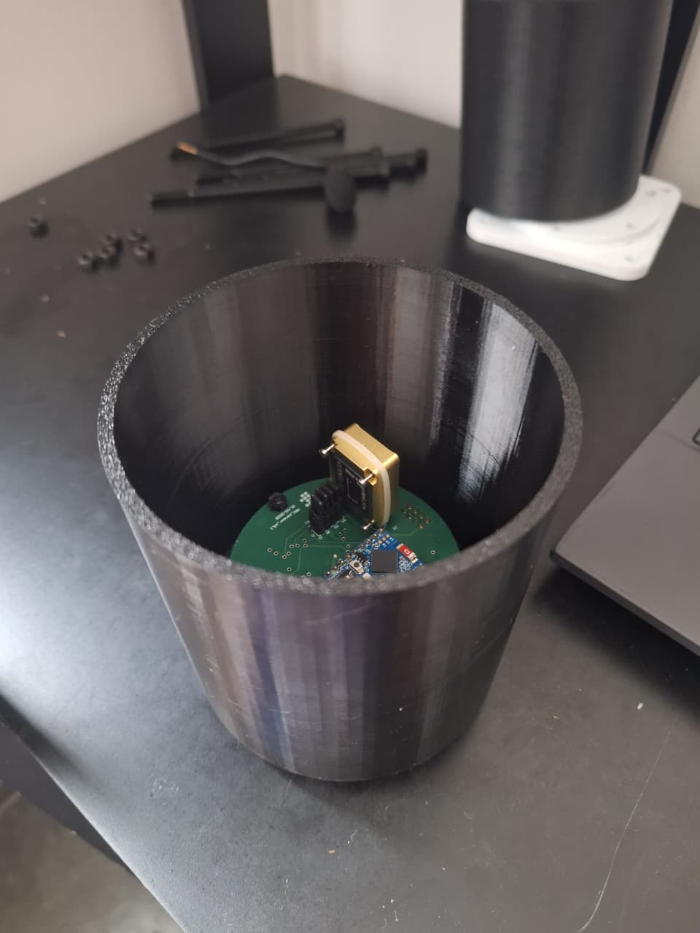
[picture p155: figure]

Fonte: Autoria Própria

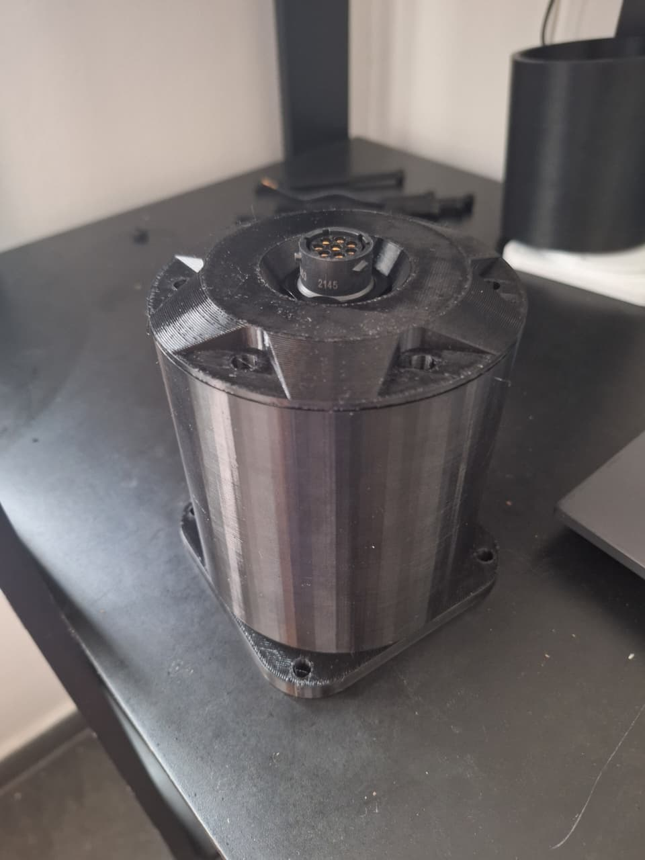
[picture p156: figure]
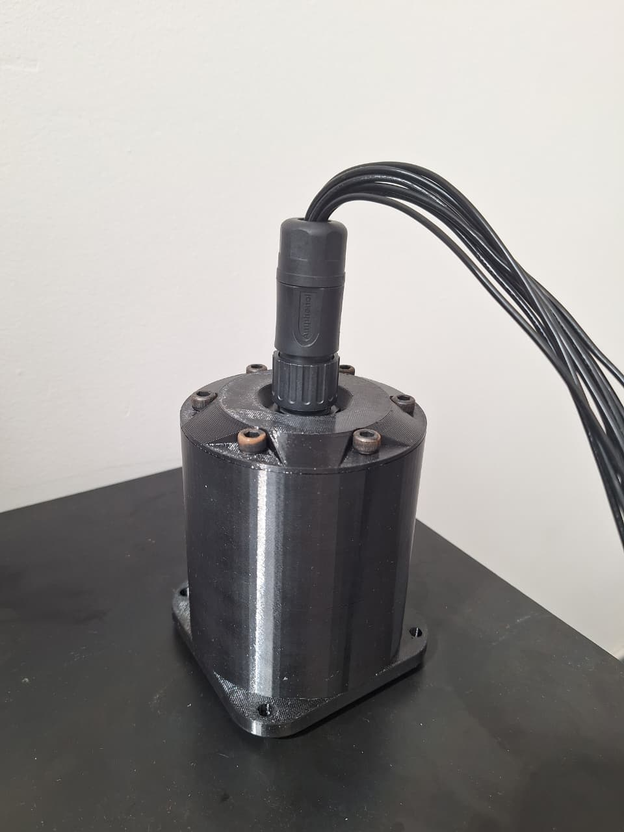
[picture p157: figure]

A aferição da massa do dispositivo, realizada com uma balança de precisão após o selamento no novo compartimento, resultou em um valor total de 451,6 g, conforme ilustrado na Figura 12. Tal medida apresenta-se inferior à dos equipamentos concorrentes, o que se justifica pela ausência, nesta etapa do projeto, de revestimentos metálicos baseados em ligas de cobre e chumbo, materiais comumente utilizados no mercado para blindagem. Este dado atual serve como um parâmetro inicial fundamental para futuras comparações e adequações estruturais.

Figura 12: Dispositivo Pesado em uma Balança de Precisão

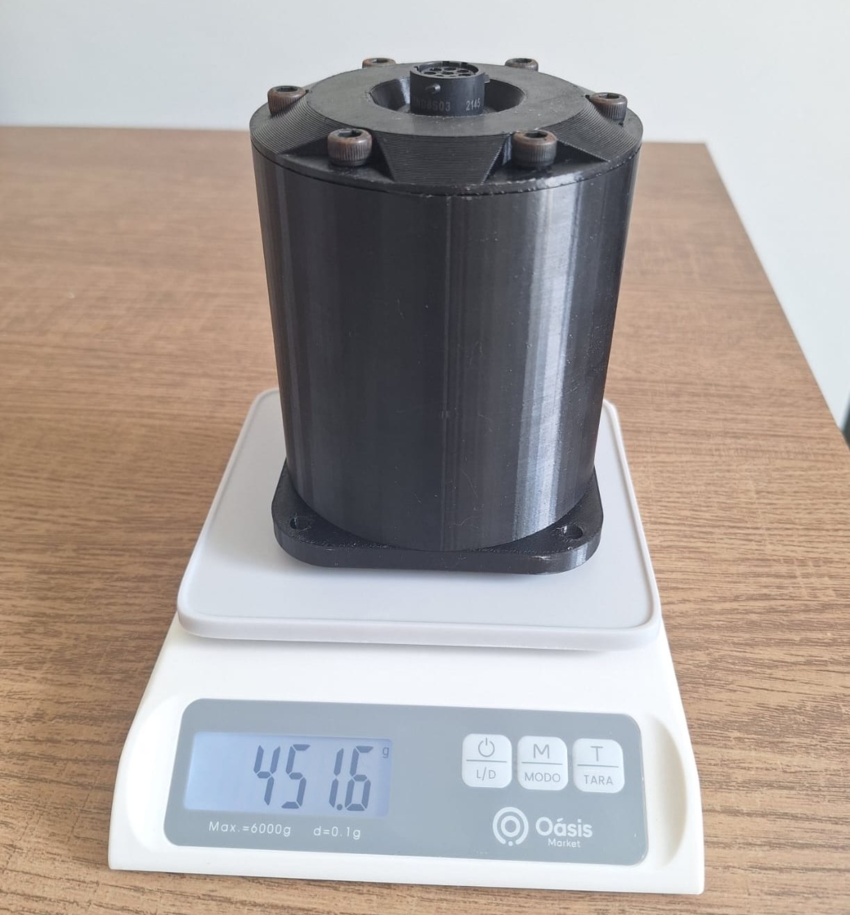
[picture p158: figure]

Fonte: Autoria Própria

### 3.2 Montagem do Pêndulo

O pêndulo simples, descrito na seção de metodologia, foi implementado conforme as especificações apresentadas e pode ser visualizado na figura subsequente. Ele foi montado e posicionado de forma adequada para possibilitar rotação contínua e fluida em um eixo específico. Inicialmente, posicionou-se o conjunto em uma escada, fixado na parte superior com apenas uma haste, permitindo oscilação livre para coleta de dados que capturassem o comportamento do pêndulo e iniciassem os algoritmos iniciais de calibração.

Figura 13: Pêndulo Montado em Testes de Bancada

(a) (b)

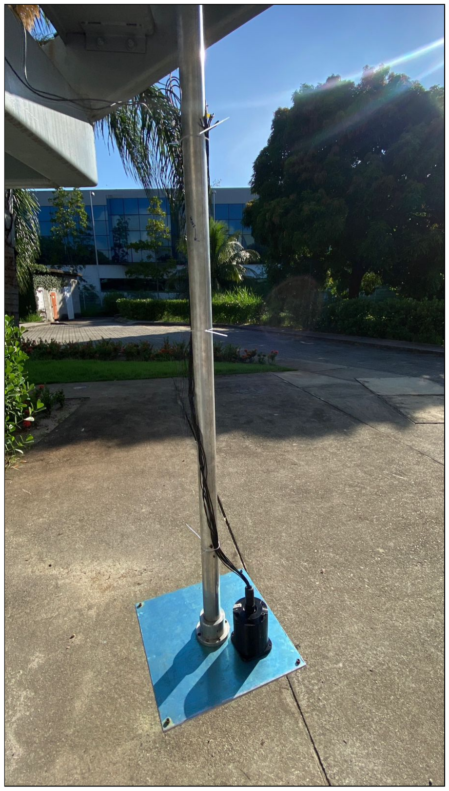
[picture p159: figure]
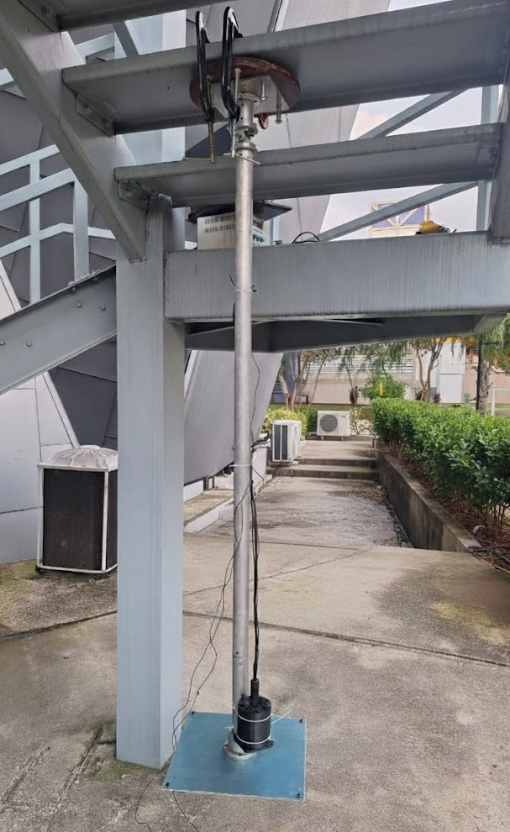
[picture p160: figure]

Fonte: Autoria Própria

O dispositivo de monitoramento foi fixado na extremidade inferior do pêndulo simples, com seus dados inicialmente transmitidos, juntamente com os obtidos pelo encoder, via streaming Protocol Buffers para um computador responsável pela coleta e armazenamento em arquivos CSV. Essas informações serão analisadas graficamente e matematicamente nas seções subsequentes.

### 3.3 Testes Estáticos e Dinâmicos com DRMM

Com o dispositivo configurado e validado, procedeu-se à execução de sua função primordial de monitoramento de movimento mediante a coleta das variáveis de interesse, nomeadamente a aceleração linear e a velocidade angular nos três eixos cartesianos, bem como as variáveis de orientação Pitch, Roll e Yaw. Os dados foram obtidos utilizando a estrutura previamente detalhada e o comportamento dinâmico do sistema é apresentado na Figura 14, na qual o eixo das abscissas representa o tempo e o eixo das ordenadas indica a magnitude da respectiva variável de movimento monitorada.

Figura 14: Orientação Gráfica de Todas as Variáveis do Sensor Kernel

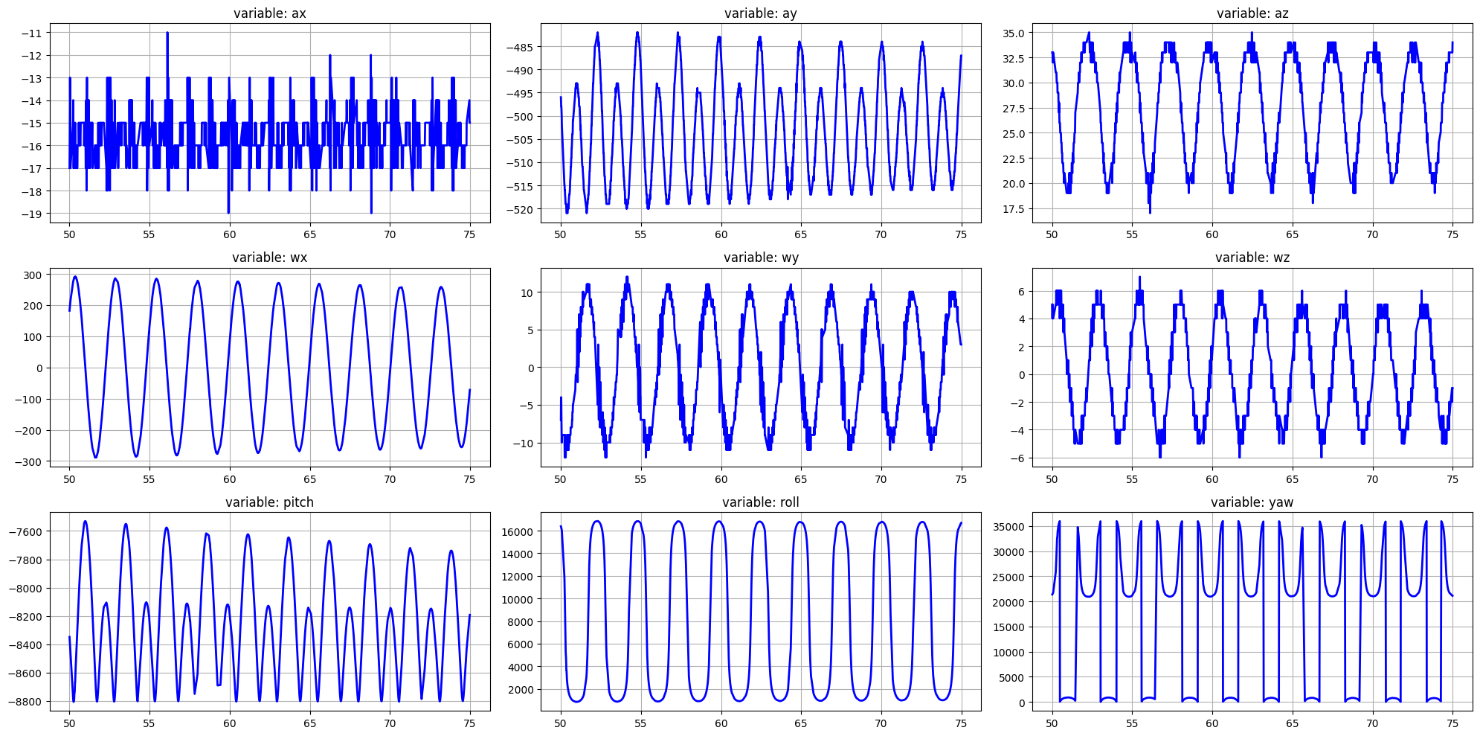
[picture p161: figure]

Fonte: Autoria Própria

Esses dados já passaram pelos principais filtros embutidos no próprio sensor Kernel, o que é válido, uma vez que, antes de implementar os algoritmos pesados no microcontrolador, é necessário verificar se, de fato, o sensor, sozinho e com os seus algoritmos de filtragem e fusão, é capaz de obter as variáveis de interesse com a devida precisão e acurácia.
Os primeiros gráficos brutos do sensor, em comparação com o encoder do pêndulo e ainda sem correções ou calibrações, podem ser evidenciados na figura subsequente, com os dados padronizados mostrando a variação angular no eixo x. A figura compara o pêndulo com o encoder, que de fato se mostram similares. Observa-se a similaridade das curvas e a confirmação de que esta medição obedece ao comportamento ideal do sistema.

Figura 15: Comparação do Encoder com o DRMM

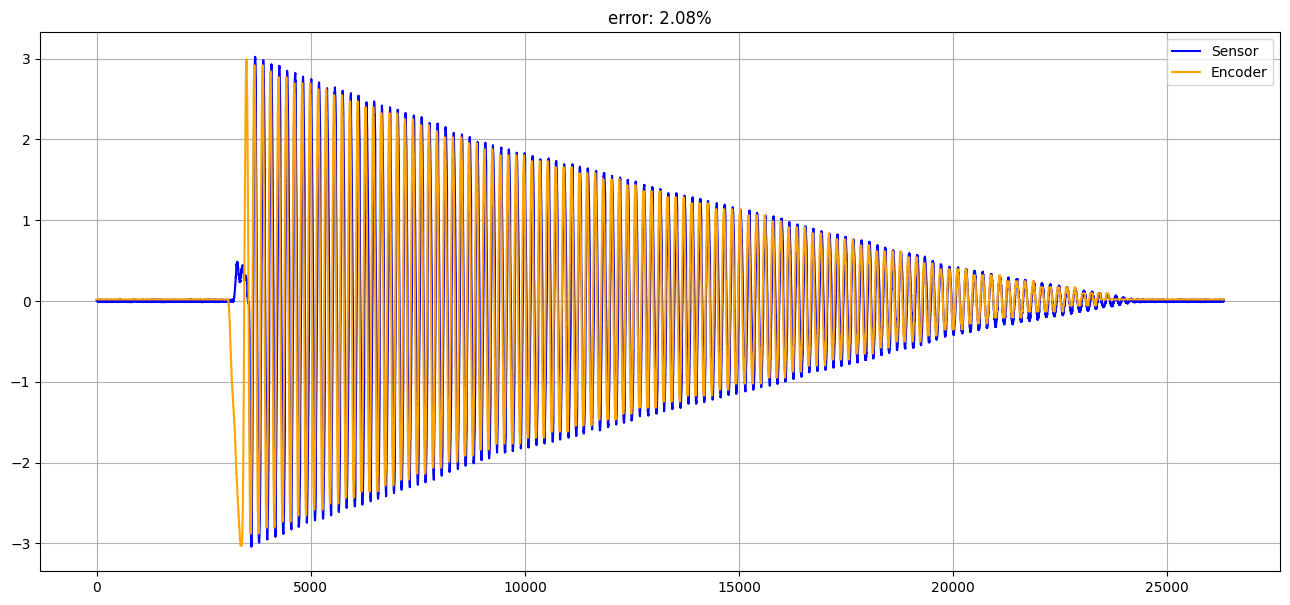
[picture p162: figure]

Fonte: Autoria Própria

O comportamento oscilatório é de fato capturado pelo sensor e pode ser corrigido para a mesma escala de acordo com o comprimento do pêndulo (regime estacionário). Observa-se que o atrito atua diretamente ao reduzir a amplitude da forma senoidal até estabilizar e se tornar estático (regime permanente) (PACALA; PILI, 2023). A Figura 16 já utiliza uma aproximação linear para o ajuste das variáveis em um encoder simples, onde já se observa avanço notável a partir da métrica R2 Score.

Figura 16: Comparação do Encoder com o DRMM (Ajuste Linear)

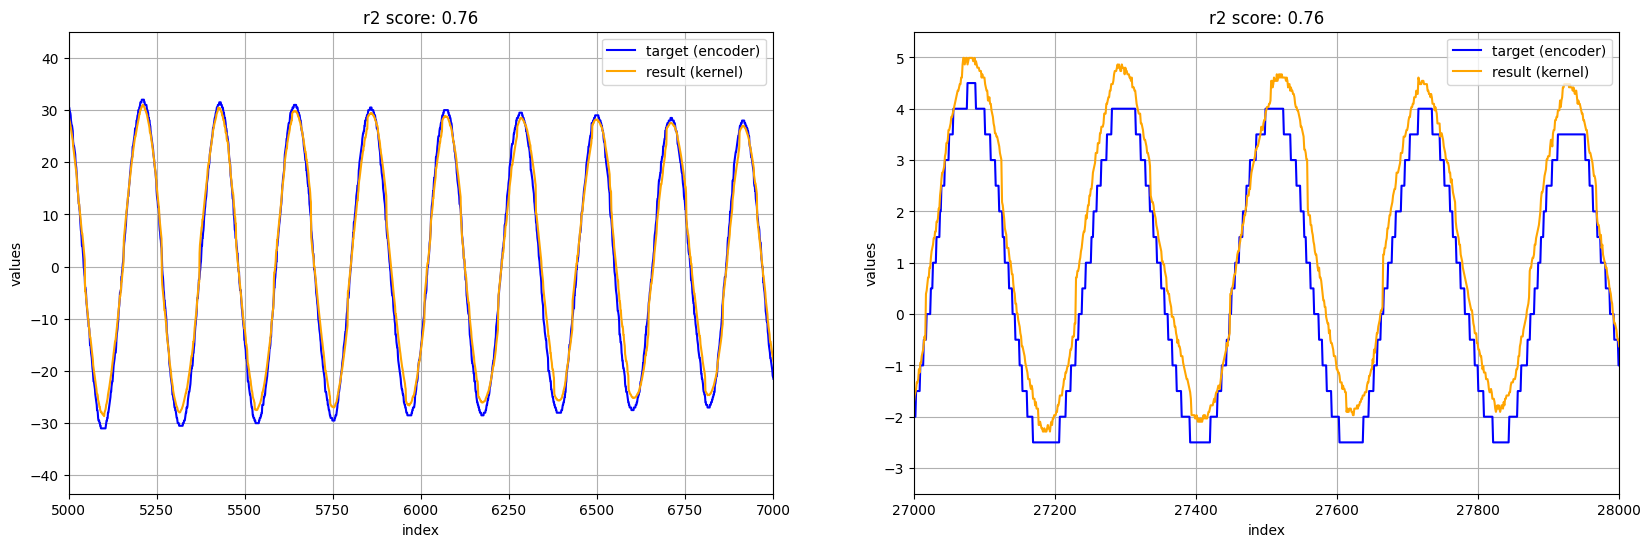
[picture p163: figure]

Fonte: Autoria Própria

Observa-se que, ao ampliar a visualização (zoom) a partir do momento em que a amplitude das oscilações começa a diminuir, percebe-se que o sensor Kernel apresenta um nível de suavização e precisão muito superior ao do encoder, o qual exibe degraus discretos característicos de sua resolução limitada e quantização. Essa limitação do encoder atual compromete sua função como referência confiável para calibração, evidenciando a necessidade imperativa de adquirir um modelo mais preciso (já adquirido e a ser testado), capaz de gerar dados de referência superiores aos do sensor para validar e otimizar os algoritmos de calibração de forma robusta.

## 4 Considerações Finais

Nesta macroentrega, foram alcançados avanços significativos no desenvolvimento do Dispositivo de Referência de Monitoramento dos Movimentos, incluindo a integração de um processador ESP32-S3 com sensor Kernel Motion Sensor AHRS em uma placa de circuito impresso personalizada e embalagem protetora impressa em 3D, com massa otimizada de 451,6 g. Os testes de bancada validaram a transmissão de dados em até 100 Hz via USB, RS422 ou Wi-Fi com Protocol Buffers para serialização eficiente, enquanto a montagem do pêndulo simples, inspirado em aparatos para comparação de IMUs, permitiu oscilações controladas em 2 eixos com encoder angular para referência.
Os testes estáticos e dinâmicos demonstraram a captura precisa do comportamento oscilatório pelo sensor, com curvas similares às do encoder, confirmando a eficácia inicial dos filtros embarcados antes de calibrações adicionais. No entanto, percebe-se pelos gráficos apresentados que o encoder do experimento não atingiu uma precisão superior a do sensor Kernel, impossibilitando uma calibração confiável e robusta e evidenciando a necessidade de se um adquirir um mais preciso que ja foi comprado e será testado assim que chegar. Por fim, é importante destacar que haverá o aluguel de um dispositivo de movimento concorrente, que servirá como padrão de referência para comparações após a calibração do protótipo. Dessa forma, será possível avaliar se a calibração atende aos requisitos de um concorrente e aos padrões gerais demandados pelo mercado para este tipo de aplicação, concluindo o ciclo de prototipagem do projeto e avançando para a fase comercial.

## Referências

CUI, C. et al. Tinygc-net: an extremely tiny network for calibrating mems gyroscopes. Measurement Science and Technology, IOP Publishing, v. 35, p. 115109–115109, 07 2024. ISSN 0957-0233, 1361-6501. Disponível em: <https://doi.org/10.1088/1361-6501/ad 67f8>. (https://doi.org/10.1088/1361-6501/ad67f8)

DAMASCENO, J. C.; COUTO, P. R. G. Methods for evaluation of measurement uncertainty. In: . [s.n.], 2018. Disponível em: <https://doi.org/10.5772/intechopen.74873>.

HOUSE, T. Testing apparatus for comparing the performance of inertial measurements units. 2010.

JACKSON, S.; CUMMINGS, N.; KHAN, S. Streaming technologies and serialization protocols: Empirical performance analysis. arXiv (Cornell University), Cornell University, 07 2024. Disponível em: <http://arxiv.org/abs/2407.13494>.

NALISKO, M. et al. Assessing safety conditions in underground excavations after a methane-air mixture explosion. E3S Web of Conferences, EDP Sciences, v. 123,
p. 1008–1008, 01 2019. ISSN 2267-1242, 2555-0403. Disponível em: <https: //doi.org/10.1051/e3sconf/201912301008>.

NEMEC, D. et al. Intelligent real-time mems sensor fusion and calibration. IEEE Sensors Journal, IEEE Sensors Council, v. 16, p. 7150–7160, 08 2016. ISSN 1530-437X, 1558-1748. Disponível em: <https://doi.org/10.1109/jsen.2016.2597292>.

PACALA, F. A.; PILI, U. Tracking the acceleration due to gravity and damping of a pendulum: A video analysis. Physics Education Research Journal, State Islamic University (UIN) Walisongo Semarang, v. 5, p. 83–90, 12 2023. ISSN 2685-6190, 2714-7746. Disponível em: <https://doi.org/10.21580/perj.2023.5.2.16614>.

STEWART, J. et al. Cálculo, volume 2. 2013.

TEPE, C.; YAVAN, L. Test experiment design for imu-based angle measurement systems. European Journal of Science and Technology, European Journal
of Science and Technology, 06 2021. ISSN 2148-2683. Disponível em: <https: //doi.org/10.31590/ejosat.955145>.

TRYON, W. W.; WILLIAMS, R. E. Fully proportional actigraphy: A new instrument. Behavior Research Methods Instruments &amp Computers, Springer Science+Business Media, v. 28, p. 392–403, 09 1996. ISSN 0743-3808, 1532-5970. Disponível em: <https://doi.org/10.3758/bf03200519>.

VERTZBERGER, E.; KLEIN, I. Adaptive attitude estimation using a hybrid model-learning approach. IEEE Transactions on Instrumentation and Measurement, Institute of Electrical and Electronics Engineers, v. 71, p. 1–9, 01 2022. ISSN 0018-9456, 1557-9662. Disponível em: <https://doi.org/10.1109/tim.2022.3205003>.

ŠOMPLáK, R. et al. Statistical evaluation of large-scale data logistics system. MENDEL, Brno University of Technology, v. 24, p. 9–16, 12 2018. ISSN 1803-3814, 1803-3822, 2571-3701. Disponível em: <https://doi.org/10.13164/mendel.2018.2.009>.
