KlaussMarchi/MRU/Documents/Compare/Kongsberg/Relatorio_Analise_Otimizacao.pdf

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

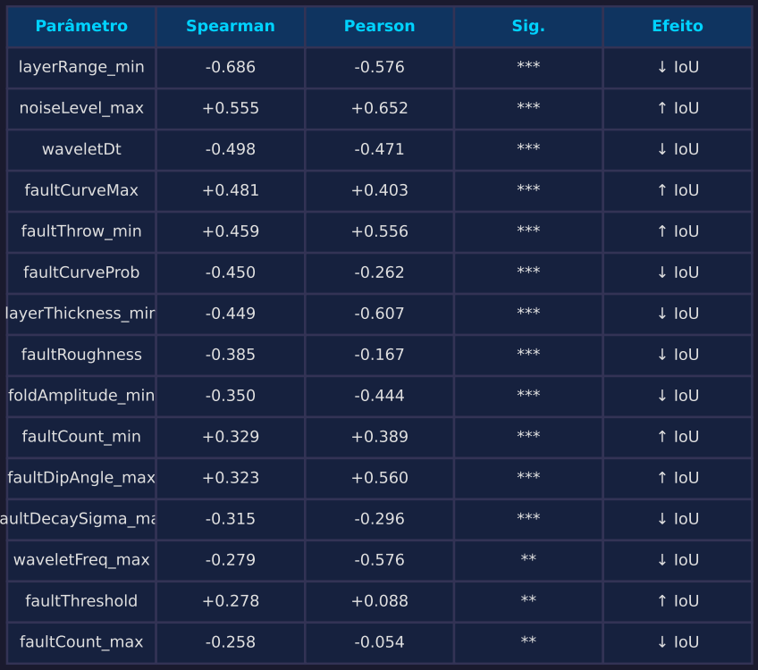
[picture p164: figure]

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

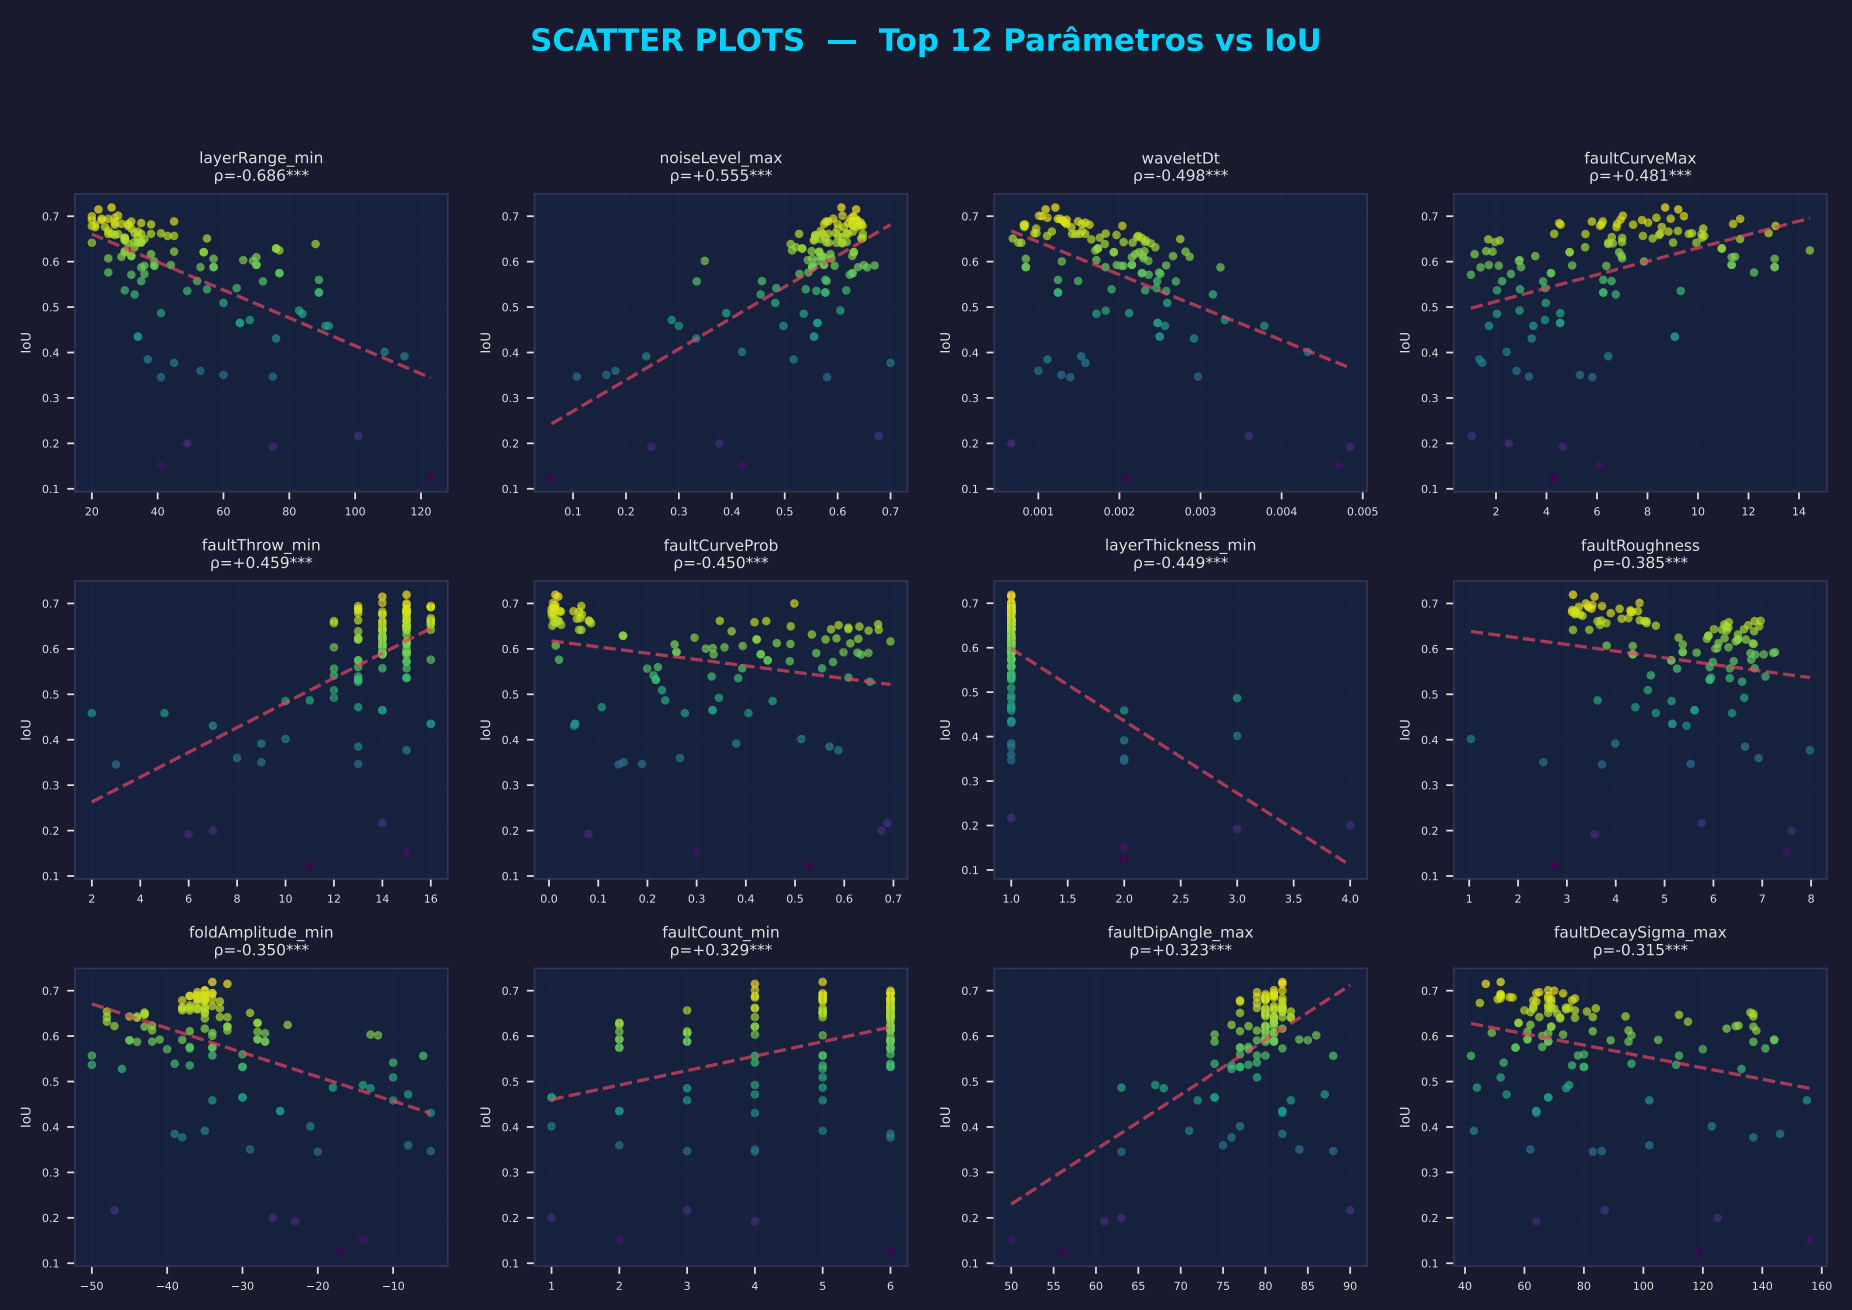
[picture p165: page 3]

max
min
layerThickness_max
layerThickness_min

1.0

0.5

0.0

0.5

1.0

1.5

Z-Score

**

*

### Camadas (Layer)

Top 10
Bottom 10

max
min

foldBaseShift_max
foldBaseShift_min

foldCount_max
foldCount_min
foldDamping
foldSigma_max
foldSigma_min

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
Z-Score

* | Dobras (Fold)

Top 10
Bottom 10

max
min
shearOffset_max
shearOffset_min

0.50

0.25

0.00

0.25

0.50

0.75

1.00

Z-Score

### Cisalhamento (Shear)

Top 10
Bottom 10

max
min
faultCurveMax

faultCurveProb
faultDecaySigma_max
faultDecaySigma_min

faultDipAngle_max
faultDipAngle_min

faultRoughSigma

faultRoughness
faultThreshold

faultThrow_max
faultThrow_min
faultZoneWidth

1.5

1.0

0.5

0.0

0.5

Z-Score

* ***

**

**

*
*
*

**

### Falhas (Fault)

Top 10
Bottom 10

letDt

letDuration
letFreq_max
letFreq_min

1.0

0.5

0.0

0.5

1.0

1.5

2.0

Z-Score

*

**

### Wavelet

Top 10
Bottom 10

max
min

1.5

1.0

0.5

0.0

0.5

Z-Score

**

### Ruído (Noise)

Top 10
Bottom 10

# ANÁLISE COMPARATIVA Top 10 vs Bottom 10 Modelos

## IoU por Trial Evolução da Busca Bayesiana

# EVOLUÇÃO DA OTIMIZAÇÃO

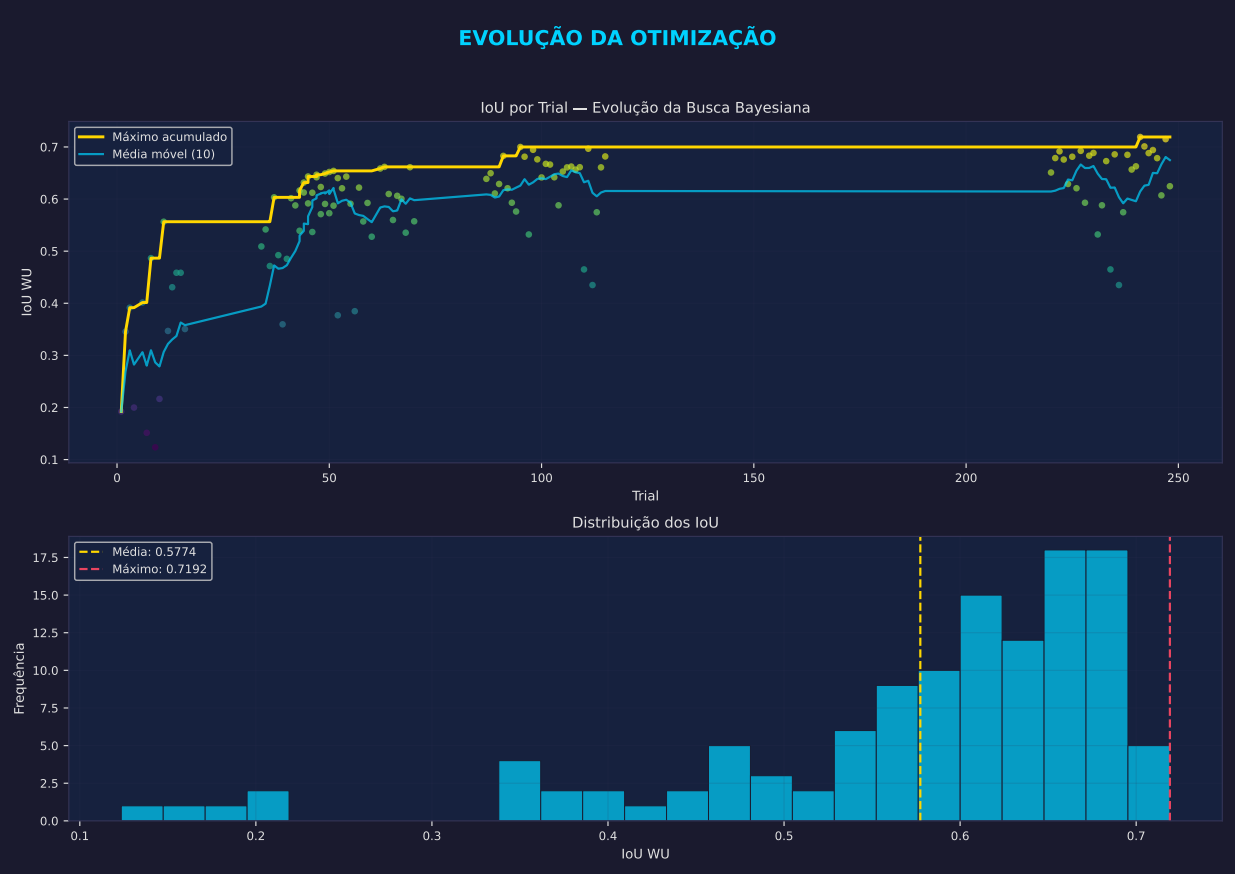
[picture p166: page 5]
Trial; IoU WU; Frequência

Máximo acumulado
Média móvel (10)

Distribuição dos IoU

Média: 0.5774
Máximo: 0.7192

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

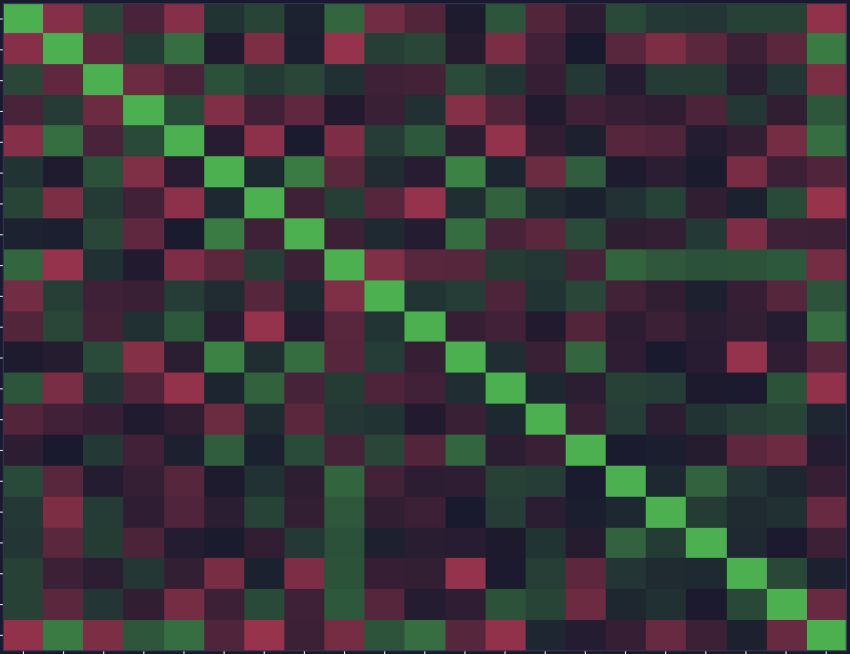
[picture p167: figure]

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

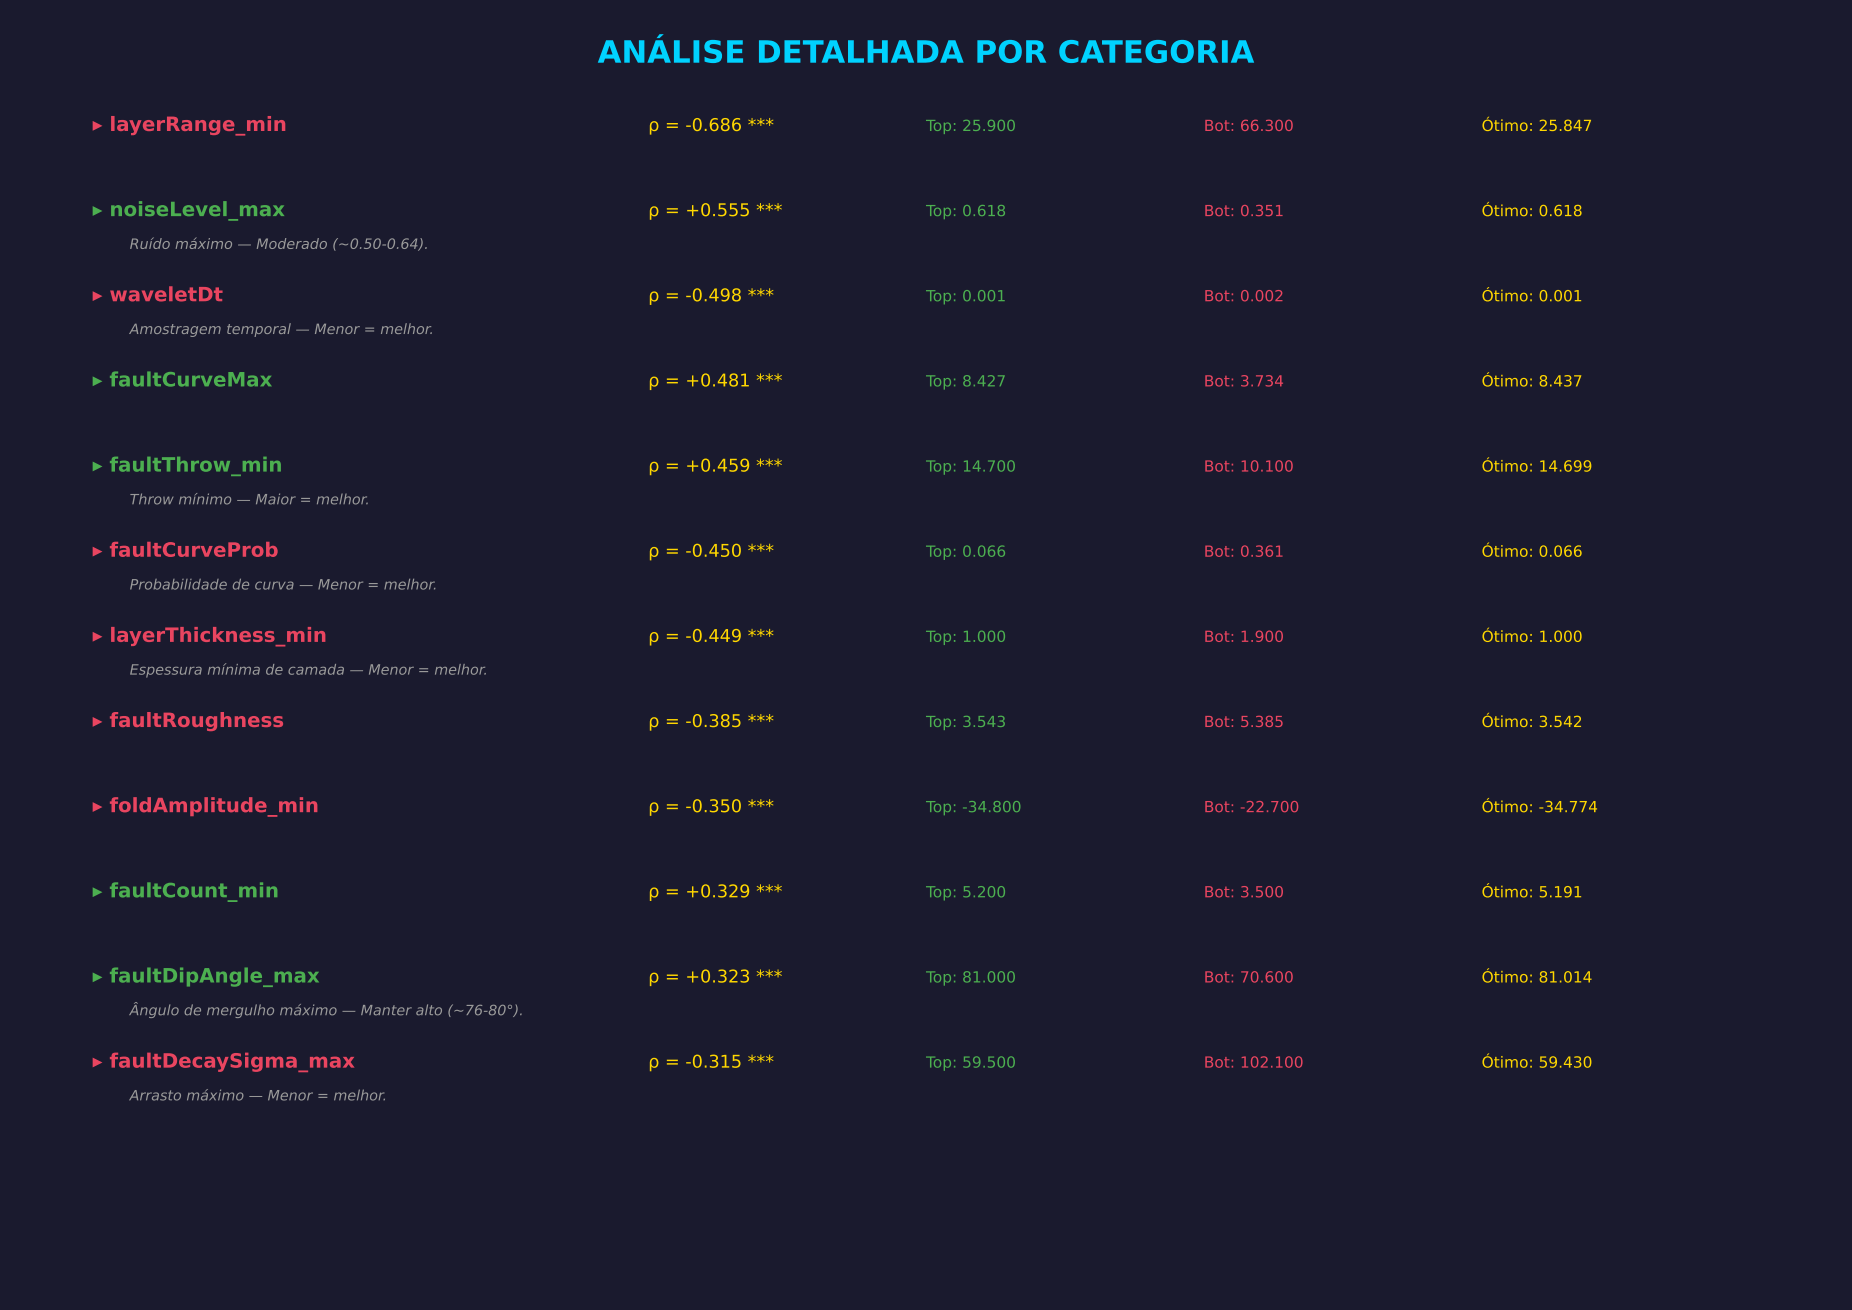
[picture p168: page 7]

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

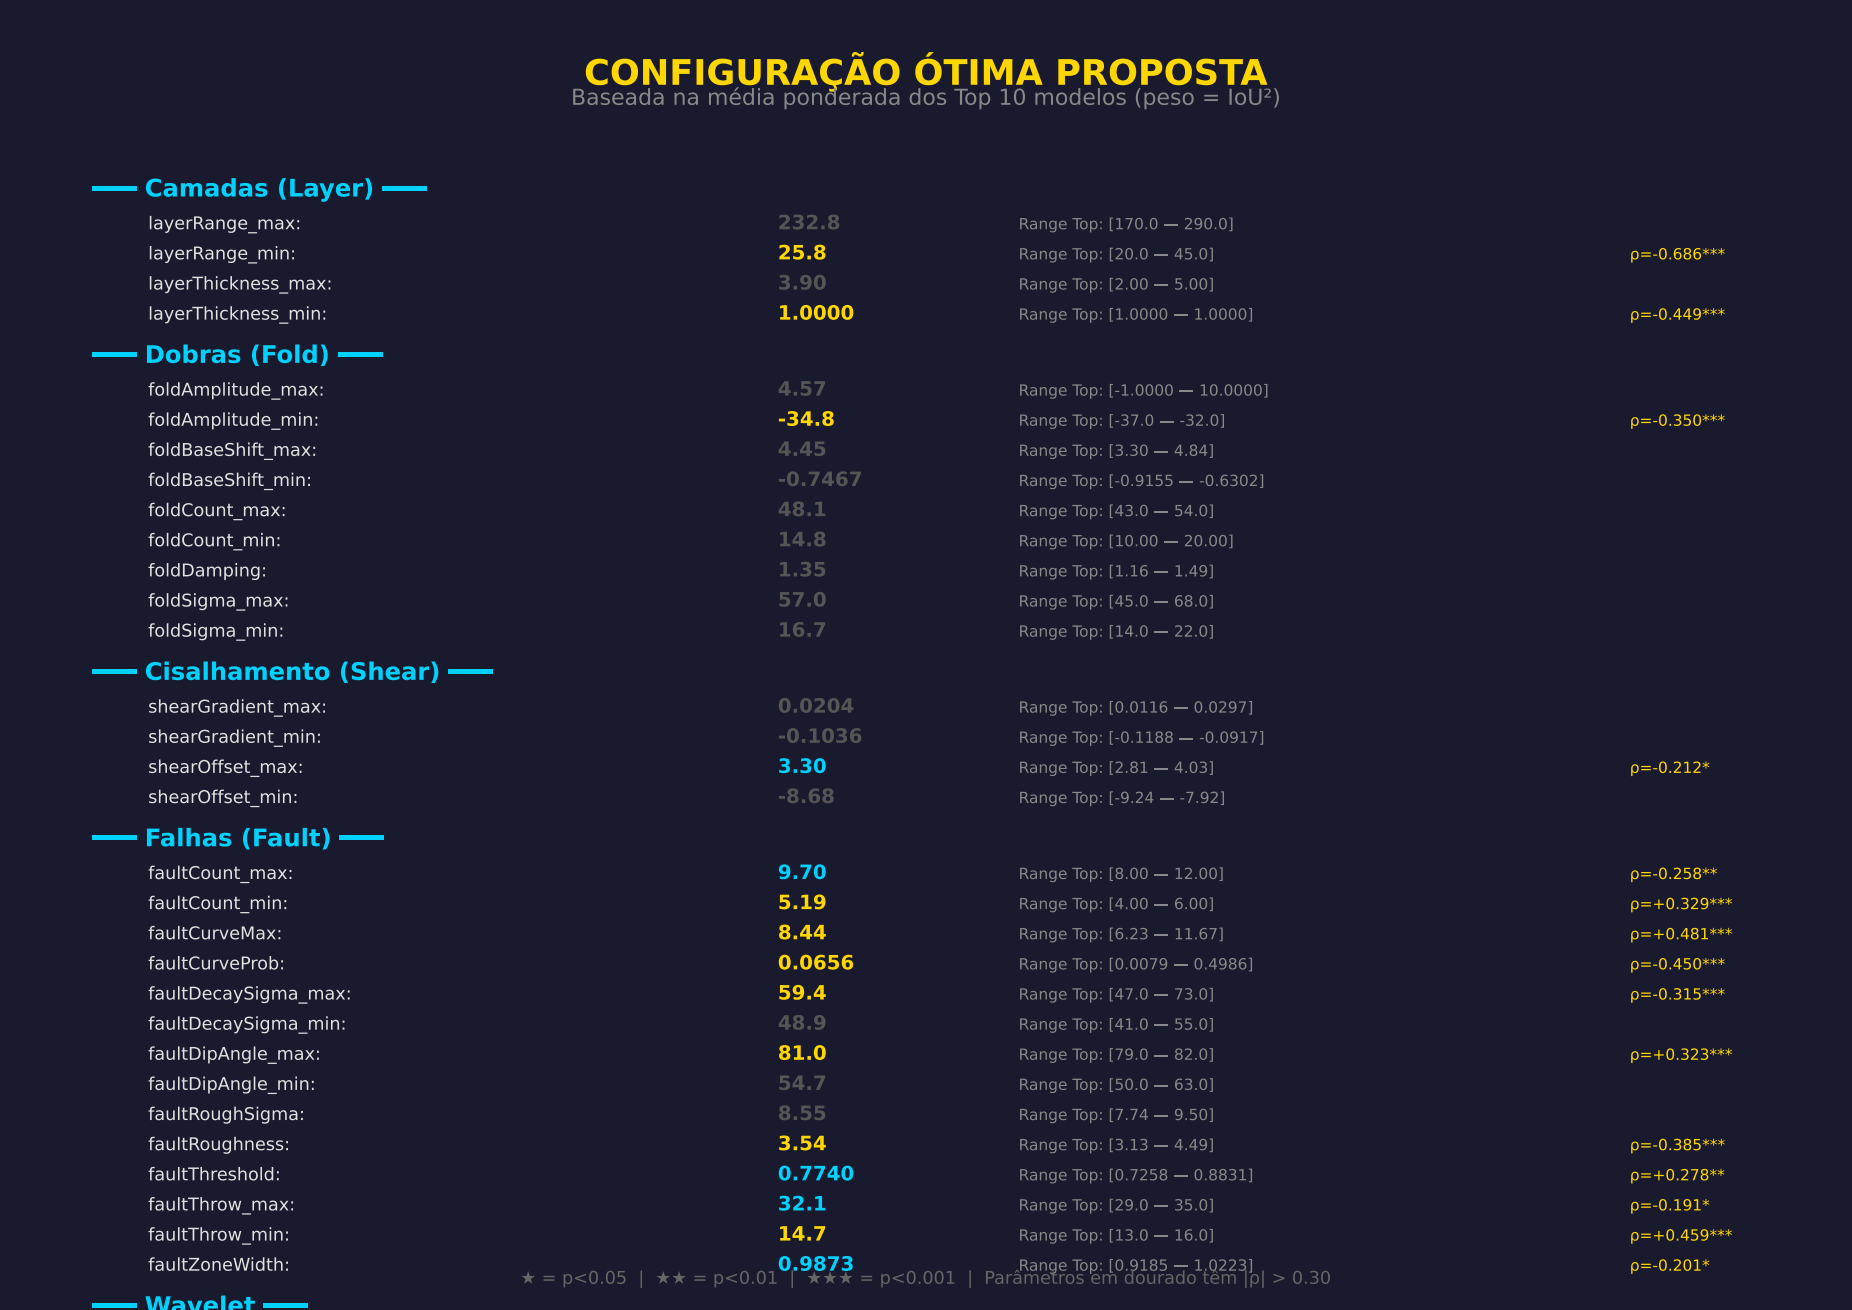
[picture p169: page 8]

# CONCLUSÕES E RECOMENDAÇÕES

## 1. PARÂMETROS QUE AUMENTAM O IoU (correlação positiva significativa):

noiseLevel_max ( = +0.555)
faultCurveMax ( = +0.481)
faultThrow_min ( = +0.459) faultCount_min ( = +0.329) faultDipAngle_max ( = +0.323)
faultThreshold ( = +0.278)

## 2. PARÂMETROS QUE DIMINUEM O IoU (correlação negativa significativa):

layerRange_min ( = -0.686)
waveletDt ( = -0.498)
faultCurveProb ( = -0.450) layerThickness_min ( = -0.449) faultRoughness ( = -0.385) foldAmplitude_min ( = -0.350) faultDecaySigma_max ( = -0.315) waveletFreq_max ( = -0.279) faultCount_max ( = -0.258) shearOffset_max ( = -0.212) faultZoneWidth ( = -0.201) faultThrow_max ( = -0.191)

## 3. JUSTIFICATIVAS FÍSICAS:

Falhas com ângulos íngremes (dip > 55°) geram descontinuidades verticais claras nos dados sísmicos, facilitando a detecção pelo modelo U-Net 3D que usa convoluções 3D.

Menor faultDecaySigma (arrasto) produz rupturas abruptas, criando bordas nítidas na máscara de segmentação, melhorando o contraste falha/não-falha.

Wavelet com frequências moderadas (~90-105 Hz) e duração adequada (~0.10s) replica melhor a assinatura sísmica real do dataset Wu, reduzindo domain gap.

Baixa probabilidade de curvatura (faultCurveProb < 0.03) favorece falhas planares simples, mais comuns no dataset real e mais fáceis de rotular corretamente.

Ruído moderado (noiseLevel_max ~0.50-0.64) age como data augmentation natural, tornando o modelo mais robusto sem degradar a qualidade da imagem.

Mais falhas (faultCount 5-10) e dobras moderadas aumentam a complexidade do volume, expondo o modelo a cenários mais variados durante o treinamento.

## 4. PRÓXIMOS PASSOS:
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
