KlaussMarchi/MRU/Documents/Compare/Norma/normam-223.pdf

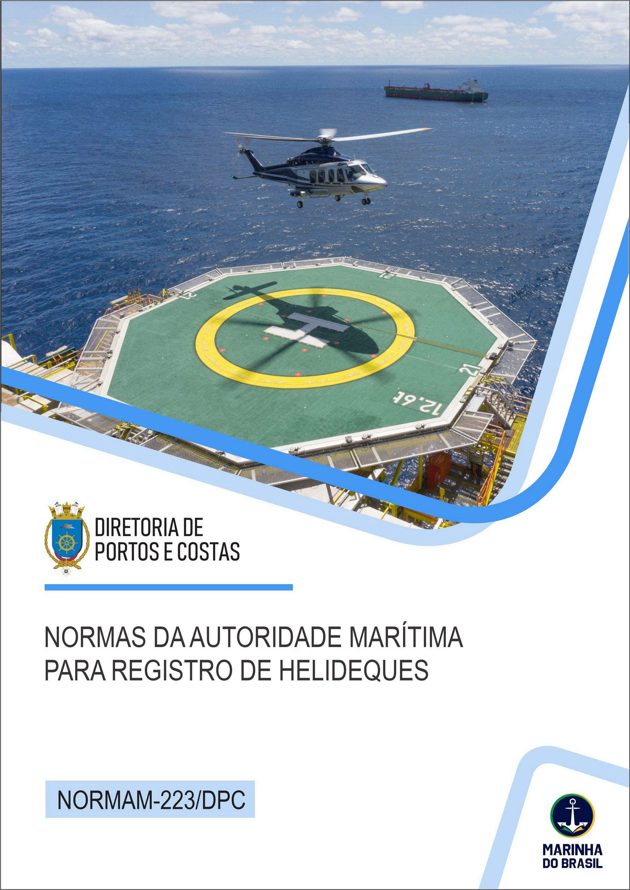
[picture p175: figure]

NORMAM-223/DPC

NORMAS DA AUTORIDADE MARÍTIMA PARA REGISTRO DE HELIDEQUES

MARINHA DO BRASIL

DIRETORIA DE PORTOS E COSTAS

2025

TIPO: NORMA

FINALIDADE: NORMATIVA

INTENCIONALMENTE EM BRANCO

FOLHA DE REGISTRO DE MODIFICAÇÕES

ANO DA
MODIFICAÇÃO

EXPEDIENTE QUE A

DETERMINOU E

RESPECTIVA DATA

PÁGINAS

AFETADAS

DATA DA
ALTERAÇÃO | RUBRICA
REV 1 | Portaria no
135 de 30 de
| julho de 2024.

V
IX
XVI
XVII
XIX
XX
XXI
1-6
1-9
1-10
1-12
1-13
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
6-10
6-11
6-12
6-13
6-14
7-3

⁻ III -

ANO DA MODIFICAÇÃO | EXPEDIENTE QUE A DETERMINOU E RESPECTIVA DATA | PÁGINAS AFETADAS | DATA DA ALTERAÇÃO | RUBRICA
| | 7-4 8-8 9-2 9-3 9-4 9-5 9-6 9-8 11-5 1-C-2 1-D-3 1-D-4 3-E-1
2025 | Portaria no
184 de 17 de
| julho de 2025.

VI

X

XX

XXI

XXII

1.5

1-7

1-9

1-11

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
6-10

6-12

7-2

7-3

7-4

7-5

7-6

7-7

⁻ IV -

ANO DA
MODIFICAÇÃO

EXPEDIENTE QUE A

DETERMINOU E

RESPECTIVA DATA

PÁGINAS

AFETADAS

DATA DA
ALTERAÇÃO

RUBRICA

9-2

10-5

10-9

11-5

11-6

12-2

12-3

13-6

13-7

1-B-2

1-D-4

1-H-1

1-I-1

2-D-1

2-E-1

3-B-1

3-C-1

3-E-1

13-D-1

⁻ V -

GLOSSÁRIO

AAFD - Área de Aproximação Final e Decolagem.

ACC - Centro de Controle de Área.

AFFF - Espuma de formação de película aquosa (Aqueous Film Foming Foam).

AHD - Assistente de helideque.

AHTS - Embarcação de Manuseio de Âncoras e Fornecimento de Rebocadores (Anchor Handling

and Tug Suppliy).

AIS - Sala de Tráfego do aeródromo.

AJB - Águas Jurisdicionais Brasileira.

ALPH (HLO) - Agente de Lançamento e Pouso de Helicóptero (Helicopter Landing Officer).

ANAC - Agência Nacional de Aviação Civil.

ART - Anotação de Responsabilidade Técnica.

ARFAGEM (Arf) - é o deslocamento vertical do centro do helideque.

BIRUTA - indicador de direção do vento.

BOMBAV - Bombeiros de Aviação.

CAA - Autoridade de Aviação Civil (Civil Aviation Authority, UK).

CATEGORIA DE HELIDEQUE - H1- D menor que 16 m; H2 - D entre 16 e 24 m e H3 - D maior que 24

m.

CBAer - Código Brasileiro de Aeronáutica.

CENIPA - Centro de Investigação e Prevenção de Acidentes Aeronáuticos.

CFD - Dinâmica dos Fluidos Computacional.

CHEVRON - figura geométrica pintada na cor preta, sobre a faixa que define o limite da AAFD, em

forma de V, onde seu vértice define a origem do SLO.

CHT - certificados de habilitação técnica.

CINDACTA - Centro Integrado de Defesa Aérea e Controle do Tráfego Aéreo.

CLASSE DE HELIDEQUE - Classe 1 - compreende os helideques de plataformas semi-submersíveis;

de FPSO e de outros navios de porte equivalente, com boas referências visuais; Classe 2 -

compreende os helideques de embarcações que oferecem boas referências visuais durante as

operações de pouso e decolagem, normalmente instalados na popa ou a meia-nau; e Classe 3 -

⁻ VI - | REV.1 MOD.1

compreende os helideques de embarcações que oferecem poucas referências visuais durante as

operações de pouso e decolagem, normalmente instalados na proa ou acima da superestrutura.

CMCTAP - Certificado de Manutenção das Condições Técnicas da Área de Pick-up.

CMCTH - Certificado de Manutenção das Condições Técnicas de Helideque.

CTV - Embarcação de Transferência de Carga (Cargo Transfer Vessel).

CREA - Conselho Regional de Engenharia e Agronomia.

D - comprimento máximo do helicóptero.

DECEA - Departamento de Controle do Espaço Aéreo.

DOE - Dano por Objeto Estranho.

DPC - Diretoria de Portos e Costas.

EMCIA - Equipe de Manobra e Combate a Incêndio de Aviação.

ENTRADA SOBRE O HELIDEQUE - É o deslocamento da aeronave do LDP para a área de toque do

helideque. Neste deslocamento, o helicóptero tem que estar inteiramente contido no SLO.

EPI - equipamento de proteção individual.

EPTA - Estação Prestadora de Serviço de Telecomunicação e de Tráfego Aéreo.

ETEX M – Estação de Telecomunicações Exclusivas. M se refere apenas às estações de plataformas

marítimas.

FPSO - Unidade Estacionária de Produção, Armazenagem e Transferência.

FRH - Ficha Registro do Helideque.

FSO - Unidade Estacionária de Armazenagem e Transferência.

GRO - Gerenciamento de Risco Operacional.

HATCH COVER - Tampa do porão de carga.

HCA - Helideck Certification Agency. É a agência de certificação que atua em nome dos operadores

de helicópteros offshore do Reino Unido que fiscaliza e inspeciona todos os helidecks e helipontos

a bordo de instalações e embarcações offshore que operam em águas do Reino Unido, segundo as

normas estabelecidas no CAP 437.

HELICÓPTERO CATEGORIA A - Aeronave de asa rotativa categoria transporte, multimotora,

projetada com as características de isolamento de motores e sistemas especificados no RBAC 29,

utiliza operações de decolagem e pouso pré-definidas que assegure uma área e capacidade de

desempenho adequado para prosseguir o voo seguro na eventualidade de uma falha de um motor.

⁻ VII -

HELICÓPTERO CATEGORIA B - Aeronave de asa rotativa categoria transporte, monomotora ou uma

aeronave de asa rotativa multimotora que não atende totalmente aos padrões de categoria A, não

possuindo capacidade assegurada de voar com falha de um motor e nas quais a probabilidade de

pouso em local não pré-programado e adequado deve ser considerada.

HLL - Lista de Limitações do Helideque (Helideck Limitations List), publicado e distribuído pela HCA

no UKCS ou outros organismos aceitos pela Autoridade Nacional em outros Estados europeus.

HELIDEQUE - é um heliponto situado em uma estrutura sobre água, fixa ou flutuante. É também

chamado de heliponto offshore.

HELIDEQUE ADAPTADO - é uma área de pouso adaptada, localizada a meia-nau, sobre a tampa do

porão de carga (hatch cover), de Navios de Carga Geral ou Graneleiros, ou na lateral do convés

principal de outros tipos de navios.

HMS - Sistema de Monitoramento de Helideque (Helideck Monitoring System).

HOVER - Voo pairado (librado) de helicóptero.

ICA - Instrução do Comando da Aeronáutica.

ICEA - Instituto de Controle do Espaço Aéreo.

OACI (ICAO) - Organização Internacional da Aviação Civil (International Civil Aviation Organization).

ICS - Câmara Internacional de Navegação (International Chamber of Shipping).

IMC - Condições Meteorológicas de Voo por Instrumento (Instrument Meteorological Conditions).

IMCO - Organização Marítima Consultiva Intergovernamental (Intergovernmental Maritime

Consultative Organization).

IMO - Organização Marítima Internacional (International Maritime Organization).

INMETRO - Instituto Nacional de Metrologia, Qualidade e Tecnologia.

INCLINATION - Inclinação (Inc).

JORNADA AÉREA - É o conjunto de operações aéreas que ocorrem do nascer ao por do sol.

L - Diâmetro do Helideque.

LDP - LANDING DECISION POINT - Ponto mais tardio em uma aproximação para pouso, no qual

uma decisão entre arremeter ou prosseguir para pouso deve ser tomada.

LGE - Líquido gerador de espuma.

LSA - Código Internacional de Dispositivos Salva-Vidas (International Life-Saving Appliance Code).

MCIA - Manobra e Combate a Incêndio de Aviação.

⁻ VIII -

MTOM - Carga Máxima de Decolagem (Maximum Take Off Mass).

NDB - Radiofarol não direcional (Non-Directional Beacon).

NS - Navio Sonda.

OFFLOADING - Operação de transferência de produto entre o navio armazenador e o navio

aliviador.

OR - Organização Reconhecida.

PITCH - Caturro (C).

PATRULHA DO DOE - é a inspeção diária realizada na AAFD, antes das operações aéreas, para

limpá-la de objetos e detritos que possam causar dano à aeronave.

PEA - Plano de Emergência Aeronáutica.

PLATAFORMA MARÍTIMA FIXA - construção instalada de forma permanente no mar ou em águas

interiores, destinada às atividades relacionadas à prospecção e extração de petróleo e gás. Não é

considerada uma embarcação.

PLATAFORMA MARÍTIMA MÓVEL - denominação genérica das embarcações empregadas

diretamente nas atividades de prospecção, extração, produção e/ou armazenagem de petróleo e

gás.

PLATAFORMA DESABITADA - é uma plataforma marítima fixa, operada remotamente, dotada de

helideque, com instalações habitáveis para pernoite de, no máximo, cinco pessoas.

PRE - Plano de Resposta a Emergência com Aeronaves.

PSV - Navio de abastecimento de plataforma (Platform Supply Vessel).

PPI - Plano Pré-Investigação.

PULL IN - manobra entre Unidades Marítimas para passagem de equipamentos ou fluidos.

QAV-1 - querosene de aviação.

RAR - Relatório de Análise de Risco.

RBAC - Regulamento Brasileiro da Aviação Civil.

RBC - Rede Brasileira de Calibração.

RF - Resistente ao fogo.

ROLL - Balanço (B).

RVH - Relatório de Vistoria de Helideque.

RPA - Aeronave Remotamente Pilotada.

⁻ IX -

RPM - Radioperador em Plataforma Marítima.

SALVAMAR - Serviço de Busca e Salvamento da Marinha do Brasil.

SALVAERO - Serviço de Busca e Salvamento da Força Aérea Brasileira.

SERIPA - Serviço Regional de Investigação e Prevenção de Acidentes Aeronáuticos.

SGSA - Sistema de Gerenciamento de Segurança de Aviação.

SGSO - Sistema de Gerenciamento de Segurança Operacional.

⁻ SIGNIFICATIVA VELOCIDADE DE ARFAGEM (SVArf) (Significant Heave Rate (SHR)) - é a média dos

três valores mais altos da velocidade de arfagem instantânea (VArf) registrada durante o período

de monitoramento anterior de 20 minutos.

SINAL DE IDENTIFICAÇÃO H - a letra H é o sinal de identificação de um helideque instalado em

embarcação/plataforma marítima. O alinhamento longitudinal com o H indica a trajetória para a

aeronave com maior separação dos obstáculos delimitados pelo SOAL, para um pouso dentro dos

limites da área de toque.

SISSAR – Sistema de Busca e Salvamento Aeronáutico.

SMA - Serviço Móvel Aeronáutico.

SLO (OFS) - Setor Livre de Obstáculos (Obstacle Free Sector).

SOAL (LOS) - Setor de Obstáculos com Alturas Limitadas (Limited Obstacle Sector).

SOLAS - Convenção Internacional para a Salvaguarda da Vida Humana no Mar.

SS - Unidade Semi-Submersível.

PAR - Unidades de Calado Profundo.

SWL - Carga de trabalho segura (safe working loads).

TO - Terminais Oceânicos.

TLWP - Unidades de Pernas Tensionadas (Tension Leg Wellhead Platform).

TRIAGEM DE FERIDOS - enquadramento das lesões; Categoria I - lesões na medula espinhal,

grandes hemorragias, inalação severa de fumaça e gases, asfixia torácica, lesões cervico-maxilo-

faciais, trauma craniano com coma e choque progressivo, fraturas expostas e múltiplas,

queimaduras extensas, lesões por impacto e qualquer tipo de choque; Categoria II - trauma

torácico não-asfixiante, fraturas simples, queimaduras limitadas, trauma craniano sem coma ou

choque e lesões das partes macias e Categoria III - lesões menores.

⁻ X - | REV.1 MOD.1

TRINCANIZ - cada uma das peças de madeira ou ferro que correm ao longo do navio, ao pé dos

embornais, e servem para escoar água. Embornal - abertura no costado do navio, junto ao convés,

para escoamento de água.

UNIDADES ESTACIONÁRIAS - são embarcações operando em local fixo e determinado, efetuando

perfuração, exploração, explotação, armazenamento e distribuição de petróleo e seus derivados.

VELOCIDADE DE ARFAGEM (VArf) - é a velocidade média do centro do helideque, quando este se

desloca entre o máximo e o mínimo da maior oscilação vertical.

VMC - Condições Meteorológicas Visuais (Visual Meteorological Condition).

WDL - Pouso em helideque errado (Wrong Deck Landing).

⁻ XI -

SUMÁRIO

FOLHA DE ROSTO | I
FOLHA DE REGISTRO DE MODIFICAÇÕES | III
GLOSSÁRIO | V
SUMÁRIO | XI
INTRODUÇÃO | XIX
CARACTERÍSTICAS DE HELICÓPTEROS UTILIZADOS EM OFFSHORE | XXI

CAPÍTULO 1 REGISTROS E CERTIFICAÇÕES DE HELIDEQUES

### 1.1. PROPÓSITO | 1-1

### 1.2. ATRIBUIÇÃO DE RESPONSABILIDADE | 1-1

### 1.3. DEFINIÇÕES | 1-1

### 1.4. AUTORIZAÇÃO PROVISÓRIA, VISTORIAS E INSPEÇÃO DE FISCALIZAÇÃO | 1-5

### 1.5. SAÍDA E REGRESSO DE AJB DE EMBARCAÇÃO COM HELIDEQUE REGISTRADO | 1-8

### 1.6. DESPESAS SOB A RESPONSABILIDADE DO REQUERENTE | 1-9

### 1.7. CONDIÇÕES DE REALIZAÇÃO DAS VISTORIAS | 1-9

### 1.8. PROCESSO DE REGISTRO | 1-10

### 1.9. CERTIFICADO DE MANUTENÇÃO DAS CONDIÇÕES TÉCNICAS (CMCTH) | 1-11

### 1.10. EMBARCAÇÕES DE ESPORTE E RECREIO COM HELIDEQUE | 1-12

### 1.11. COMUNICAÇÃO ENTRE EMBARCAÇÃO/PLATAFORMA X AERONAVE | 1-12

### 1.12. AERONAVE REMOTAMENTE PILOTADA (RPA) | 1-12

### 1.13. CUMPRIMENTO DE REQUISITOS | 1-13

1.14. TRANSPORTE DE ARTIGOS PERIGOSOS E INSPEÇÃO DE BAGAGENS E PASSAGEIROS........1-13

### 1.15. RISCO DE FAUNA | 1-14

1.16. EMBARCAÇÕES COM HELIDEQUE NÃO REGISTRADO OU SEM O REGISTRO VÁLIDO.........1-14

### 1.17. DOCUMENTOS | 1-14

### 1.18. OPERAÇÃO DOS HELIDEQUES | 1-14

### 1.19. CASOS NÃO PREVISTOS | 1-15

CAPÍTULO 2 PROJETO DO HELIDEQUE

⁻ XII -

### 2.1. REQUISITOS FUNDAMENTAIS | 2-1

### 2.2. LOCALIZAÇÃO | 2-1

### 2.3. DIMENSÕES | 2-2

### 2.4. SEGURANÇA | 2-2

### 2.5. PLANTAS DE ARRANJO GERAL E MARCAÇÕES DO HELIDEQUE | 2-6

CAPÍTULO 3 CARACTERÍSTICAS FÍSICAS

### 3.1. PROPÓSITO | 3-1

### 3.2. CATEGORIAS DE HELIDEQUES | 3-1

### 3.3. ÁREA DE APROXIMAÇÃO FINAL E DECOLAGEM | 3-1

### 3.4. DRENAGEM | 3-3

### 3.5. REDE ANTIDERRAPANTE | 3-4

### 3.6. BÚRICAS | 3-5

### 3.7. ÁREA DE ESTACIONAMENTO DE HELICÓPTEROS | 3-7

CAPÍTULO 4 SETORES E SUPERFÍCIES

### 4.1. DISPOSIÇÕES GERAIS | 4-1

### 4.2. SETOR LIVRE DE OBSTÁCULOS (SLO) | 4-1

### 4.3. GRADIENTE NEGATIVO | 4-3

### 4.4. SETOR DE OBSTÁCULOS COM ALTURAS LIMITADAS | 4-4

### 4.5. EXCEÇÕES | 4-6

### 4.6. EMBARCAÇÕES/PLATAFORMAS MARÍTIMAS ACOPLADAS | 4-6

### 4.7. OPERAÇÃO DE OFFLOADING | 4-6

4.8. OPERAÇÕES DE INSPEÇÃO E MANUTENÇÃO DA LINHA DE MANGOTE DE OFFLOADING.......4-6

CAPÍTULO 5 AUXÍLIOS VISUAIS

### 5.1. PROPÓSITO | 5-1

### 5.2. DISPOSIÇÕES GERAIS | 5-1

### 5.3. INDICADOR DE DIREÇÃO DE VENTO (BIRUTA), SENSOR DE VENTO (ANEMÔMETRO) E SEN-

SOR DE TEMPERATURA (TERMÔMETRO) | 5-1

⁻ XIII -

### 5.4. AUXÍLIOS DE SINALIZAÇÃO | 5-5

### 5.5. AUXÍLIOS DE ILUMINAÇÃO | 5-5

CAPÍTULO 6 PROCEDIMENTOS OPERACIONAIS

### 6.1. PROPÓSITO | 6-1

### 6.2. PESSOAL HABILITADO | 6-1

### 6.3. ATRIBUIÇÕES OPERACIONAIS E RESPONSABILIDADES | 6-2

### 6.4. SISTEMA DE GRAVAÇÃO DE VÍDEO E DE VOZ | 6-11

### 6.5. STATUS LIGHT | 6-12

### 6.6. DESCOMISSIONAMENTO DE EMBARCAÇÃO/PLATAFORMA | 6-12

### 6.7. SANÇÕES | 6-13

CAPÍTULO 7 PREVENÇÃO E COMBATE A INCÊNDIO E SALVAMENTO

### 7.1. PROPÓSITO | 7-1

### 7.2. GENERALIDADES | 7-1

### 7.3. COMBATE A INCÊNDIO | 7-1

### 7.4. BOTE DE RESGATE | 7-3

### 7.5. FERRAMENTAS, MATERIAL DE APOIO E SALVAMENTO | 7-4

### 7.6. PLATAFORMAS DESABITADAS | 7-5

CAPÍTULO 8 ABASTECIMENTO DE COMBUSTÍVEL

### 8.1. DISPOSIÇÕES GERAIS | 8-1

### 8.2. TANQUE DE ARMAZENAMENTO FIXO | 8-1

### 8.3. TANQUE DE ARMAZENAMENTO TRANSPORTÁVEL | 8-2

### 8.4. TANQUE DE DESCARTE | 8-2

### 8.5. SISTEMA DE DISTRIBUIÇÃO | 8-2

### 8.6. MANUTENÇÃO DO SISTEMA DE COMBUSTÍVEL | 8-3

### 8.7. PROCEDIMENTOS DE ABASTECIMENTO DE AERONAVE | 8-7

### 8.8. CERTIFICADO DO SISTEMA DE COMBUSTÍVEL DE AVIAÇÃO | 8-8

⁻ XIV -

CAPÍTULO 9 SISTEMAS DE COMUNICAÇÕES E DE NAVEGAÇÃO

### 9.1. PROPÓSITO | 9-1

### 9.2. CLASSIFICAÇÃO DO HELIDEQUE QUANTO À NAVEGAÇÃO | 9-1

### 9.3. COMUNICAÇÕES | 9-1

### 9.4. SISTEMA DE MONITORAMENTO DE HELIDEQUE | 9-2

CAPÍTULO 10 GERENCIAMENTO DA SEGURANÇA OPERACIONAL, RELATÓRIO DE ANÁLISE DE

RISCO E PLANO DE EMERGÊNCIA AERONÁUTICA

### 10.1. PROPÓSITO | 10-1

### 10.2. GENERALIDADES | 10-1

### 10.3. CRITÉRIOS PARA ELABORAÇÃO DO RAR | 10-3

### 10.4. CRITÉRIOS PARA ELABORAÇÃO DO PEA/PRE | 10-4

### 10.5. ESTABELECIMENTO DA FASE DE EMERGÊNCIA | 10-6

### 10.6. COMUNICAÇÃO DE ACIDENTE/INCIDENTE SOBRE O HELIDEQUE OU NA EMBARCAÇÃO/

PLATAFORMA QUE AFETE O HELIDEQUE | 10-11

### 10.7. PLANO PRÉ-INVESTIGAÇÃO (PPI) | 10-11

### 10.8. DESINTERDIÇÃO DO LOCAL DE POUSO | 10-12

### 10.9. ATUALIZAÇÃO | 10-12

CAPÍTULO 11 HELIDEQUE SOBRE BALSA

### 11.1. PROPÓSITO | 11-1

### 11.2. PESSOAL HABILITADO | 11-1

### 11.3. SEGURANÇA | 11-1

### 11.4. INDICADOR DE DIREÇÃO DE VENTO (BIRUTA) | 11-2

### 11.5. REDE ANTIDERRAPANTE | 11-3

### 11.6. AUXÍLIOS DE SINALIZAÇÃO | 11-3

### 11.7. COMBATE A INCÊNDIO | 11-4

### 11.8. EMBARCAÇÃO DE APOIO E BOTE DE RESGATE | 11-5

### 11.9. FERRAMENTAS, MATERIAL DE APOIO E SALVAMENTO | 11-5

### 11.10. ABASTECIMENTO DE COMBUSTÍVEL | 11-6

⁻ XV -

### 11.11. COMUNICAÇÕES | 11-7

### 11.12. PLANO DE EMERGÊNCIA AERONÁUTICA (PEA) ou PLANO DE RESPOSTA A EMERGÊNCIA

COM AERONAVES (PRE) | 11-7

### 11.13. GERENCIAMENTO DO RISCO OPERACIONAL (GRO) | 11-7

### 11.14. POUSO E DECOLAGEM | 11-7

### 11.15. COMUNICAÇÃO DE ACIDENTE/INCIDENTE SOBRE O HELIDEQUE | 11-8

CAPÍTULO 12 HELIDEQUE ADAPTADO À MEIA-NAU E NA LATERAL DE NAVIOS

### 12.1. PROPÓSITO | 12-1

### 12.2. GENERALIDADE | 12-1

### 12.3. PESSOAL HABILITADO | 12-1

### 12.4. SEGURANÇA | 12-1

### 12.5. AUXÍLIO DE ILUMINAÇÃO | 12-2

### 12.6. COMBATE A INCÊNDIO | 12-2

### 12.7. REDE ANTIDERRAPANTE | 12-2

### 12.8. BÚRICAS | 12-2

### 12.9. BOTE PARA RESGATE | 12-2

### 12.10. CATURRO, BALANÇO e INCLINAÇÃO | 12-2

### 12.11. COMUNICAÇÕES | 12-3

### 12.12. SETORES DE OBSTÁCULOS | 12-3

### 12.13. POUSO E DECOLAGEM | 12-3

CAPÍTULO 13 ÁREA DE PICK-UP DE HELICÓPTERO EM EMBARCAÇÃO

### 13.1. PROPÓSITO | 13-1

### 13.2. ÁREA DE PICK-UP | 13-1

### 13.3. PESSOAL HABILITADO | 13-1

### 13.4. SEGURANÇA DO PESSOAL | 13-1

### 13.5. PERFORMANCE DO HELICÓPTERO PARA PICK-UP | 13-2

### 13.6. BASTÃO DE DESCARREGAMENTO DE ELETRICIDADE ESTÁTICA | 13-2

### 13.7. CONFIGURAÇÃO DA ÁREA DE PICK-UP | 13-2

⁻ XVI -

### 13.8. COMBATE A INCÊNDIO | 13-3

### 13.9. BOTE DE RESGATE | 13-3

### 13.10. COMUNICAÇÕES | 13-3

### 13.11. TRANSFERÊNCIA DE MATERIAL (CARGA) OU PESSOAL (CARGA VIVA) | 13-3

### 13.12. CERTIFICADO DE MANUTENÇÃO DAS CONDIÇÕES TÉCNICAS DA ÁREA DE PICK-UP

(CMCTAP) | 13-6

### 13.13. GENERALIDADES | 13-7

ANEXOS

ANEXO 1-A REQUERIMENTO PARA AUTORIZAÇÃO PROVISÓRIA DE HELIDEQUE | 1-A-1
ANEXO 1-B FICHA REGISTRO DO HELIDEQUE | 1-B-1
ANEXO 1-C REQUERIMENTO DE VISTORIA DE HELIDEQUE | 1-C-1
ANEXO 1-D RELATÓRIO DE VISTORIA DE HELIDEQUE | 1-D-1
ANEXO 1-E INFORMAÇÃO DO CUMPRIMENTO DE EXIGÊNCIAS DO HELIDEQUE | 1-E-1
ANEXO 1-F EXIGÊNCIAS IMPEDITIVAS | 1-F-1
ANEXO 1-G REQUERIMENTO PARA ALTERAÇÃO DE PARÂMETROS DE HELIDEQUE | 1-G-1

ANEXO 1-H CERTIFICADO DE MANUTENÇÃO DAS CONDIÇÕES TÉCNICAS DO HELIDEQUE

(CMCTH) | 1-H-1
ANEXO 1- I CERTIFICAÇÃO DE HELIDEQUE | 1-J-1
ANEXO 1-J NOTIFICAÇÃO DE INTERDIÇÃO DE HELIDEQUE | 1-K-1
ANEXO 1-K COMUNICAÇÃO DE EXIGÊNCIA | 1-L-1
ANEXO 1-L DECLARAÇÃO | 1-M-1
ANEXO 2-A TELA DE PROTEÇÃO DO HELIDEQUE | 2-A-1
ANEXO 2-B VISTA DE TOPO DO HELIDEQUE | 2-B-1
ANEXO 2-C VISTA DE PERFIL DO HELIDEQUE | 2-C-1
ANEXO 2-D CERTIFICADO DE RESISTÊNCIA DA TELA DE PROTEÇÃO DO HELIDEQUE | 2-D-1
ANEXO 2-E CERTIFICADO DE RESISTÊNCIA DO HELIDEQUE | 2-E-1
ANEXO 3-A ESQUEMA DE DISTRIBUIÇÃO DE BÚRICAS | 3-A-1
ANEXO 3-B CERTIFICADO DO COEFICIENTE DE ATRITO | 3-B-1
ANEXO 3-C CERTIFICADO DE RESISTÊNCIA DAS BÚRICAS | 3-C-1

⁻ XVII -

ANEXO 3-D ÁREA DE ESTACIONAMENTO DE HELICÓPTEROS | 3-D-1
ANEXO 3-E CERTIFICADO DA REDE ANTIDERRAPANTE | 3-E-1
ANEXO 4-A HELIDEQUE NA POPA OU NA PROA DE NAVIO | 4-A-1
ANEXO 4-B HELIDEQUE À MEIA-NAU DE NAVIO | 4-B-1
ANEXO 4-C GRADIENTE NEGATIVO | 4-C-1
ANEXO 4-D SETOR DE OBSTÁCULOS COM ALTURA | 4-D-1
ANEXO 4-E SINALIZAÇÃO DE OBSTÁCULOS | 4-E-1
ANEXO 4-F EMBARCAÇÃO/PLATAFORMA MARÍTIMA ACOPLADA | 4-F-1
ANEXO 5-A MODELO DE INDICADOR DE DIREÇÃO DE VENTO | 5-A-1
ANEXO 5-B SINAL DE IDENTIFICAÇÃO | 5-B-1
ANEXO 5-C AUXÍLIO DE SINALIZAÇÃO | 5-C-1
ANEXO 5-D DIMENSÕES DA MARCAÇÃO DE CARGA MÁXIMA | 5-D-1
ANEXO 5-E DIMENSÕES DA ÁREA DE TOQUE | 5-E-1
ANEXO 5-F DIMENSÕES DAS LETRAS DO NOME DA PLATAFORMA/EMBARCAÇÃO | 5-F-1
ANEXO 5-G CHEVRON | 5-G-1
ANEXO 5-H SINALIZAÇÃO DE HELIDEQUE INTERDITADO E AVISOS DE SEGURANÇA | 5-H-1
ANEXO 5-I AUXÍLIOS DE ILUMINAÇÃO | 5-I-1

ANEXO 5-J CERTIFICADO DO SISTEMA DE ILUMINAÇÃO DE LED SOBRE A REDE ANTIDERRAPANTE

| 5-J-1

ANEXO 6-A ESQUEMA DO ENQUADRAMENTO DA CÂMERA PARA REGISTRO DE APROXIMAÇÃO,

POUSO E DECOLAGEM | 6-A-1
ANEXO 8-A FICHA DE INSPEÇÃO DIÁRIA | 8-A-1
ANEXO 8-B FICHA DE INSPEÇÃO SEMANAL | 8-B-1
ANEXO 8-C FICHA DE INSPEÇÃO TRIMESTRAL | 8-C-1
ANEXO 8-D FICHA DE INSPEÇÃO SEMESTRAL | 8-D-1
ANEXO 8-E CERTIFICADO DO SISTEMA DE COMBUSTÍVEL | 8-E-1
ANEXO 11-A DIMENSÕES DA PINTURA PARA HELIDEQUE EM BALSA 12 X 42 M | 11-A-1

ANEXO 12-A HELIDEQUE ADAPTADO À MEIA-NAU SOBRE A TAMPA DO PORÃO DE CARGA DE

NAVIOS | 12-A-1
ANEXO 12-B HELIDEQUE ADAPTADO NA LATERAL DO CONVÉS PRINCIPAL DE NAVIOS | 12-B-1

⁻ XVIII -

ANEXO 13-A BASTÃO DE DESCARREGAMENTO DE ELETRICIDADE ESTÁTICA | 13-A-1
ANEXO 13-B ÁREA DE PICK-UP | 13-B-1
ANEXO 13-C PICK-UP DE MACA | 13-C-1
ANEXO 13-D CERTIFICADO DAS CONDIÇÕES TÉCNICAS DA ÁREA DE PICK-UP | 13-D-1

REFERÊNCIAS

⁻ XIX -

INTRODUÇÃO

### 1. PROPÓSITO

Estabelecer instruções para certificação e registro de helideques localizados em

embarcações ou plataformas marítimas operando nas Águas Jurisdicionais Brasileiras (AJB).

### 2. DESCRIÇÃO

Esta publicação se divide em 13 (treze) capítulos e 50 (cinquenta) anexos. O Capítulo 1

informa os procedimentos para registro e certificações de helideques; o Capítulo 2 orienta o

projeto do helideque; o Capítulo 3 apresenta as características físicas do helideque; o Capítulo 4

aborda os setores e superfícies de um helideque; o Capítulo 5 apresenta os auxílios visuais; o

Capítulo 6 regula alguns procedimentos operacionais; o Capítulo 7 aborda a prevenção e combate

a incêndio e salvamento; o Capítulo 8 descreve procedimentos para teste e abastecimento de

combustível de aviação; o Capítulo 9 determina os sistemas de comunicação e navegação; o

Capítulo 10 apresenta como deve ser realizado o gerenciamento operacional, o relatório de análise

de risco e o plano de emergência aeronáutica; o Capítulo 11 descreve como deve ser um helideque

sobre balsa; o Capítulo 12 descreve como deve ser um helideque adaptado a meia-nau e na lateral

de navios;s e o Capítulo 13 apresenta a área de pick-up de helicóptero em embarcação. Os anexos

complementam os capítulos.

### 3. PRINCIPAIS MODIFICAÇÕES

a) o glossário incorporou novas definições.
b) incluído novos helicópteros utilizados em operação offshore.
c) em todos os certificados foi alterado a expressão “pelo setor de engenharia” por

“engenheiro”.

d) no capítulo 1, atualizamos os artigos 1.4, 1.7 e 1.8.
e) no capítulo 2, atualizamos os artigos 2.2, 2,4 e 2.5
f) no capítulo 3, atualizamos os artigos 3.3, 3.5 e 3.6.
g) no capítulo 4, atualizamos o artigo 4.2.
h) no capítulo 5, atualizamos os artigos 5.3, 5.4 e 5.5.
i) no capítulo 6, no item 6.3 foram incluídas novas atribuições.
j) no capítulo 7, atualizamos os artigos 7.3, 7.4, 7.5 e 7.6.

⁻ XX -k) no capítulo 9, atualizamos o artigo 9.3.

l) no capítulo 10, atualizamos os artigos 10.4 e 10.5.
m) no capítulo 11, atualizamos o artigo 11.9.
n) no capítulo 12, atualizamos os artigos 12.6 e 12.13.
o) no capítulo 13, atualizamos os artigos 13.12 e 13.13.

### 4. CLASSIFICAÇÃO

Esta publicação é classificada como: Publicação da Marinha do Brasil (PMB) não controlada,

ostensiva, normativa e norma.

### 5. SUBSTITUIÇÃO

Esta publicação substitui a NORMAM-223/DPC REV.1, aprovada pela Portaria no 135 de 30

de julho de 2024 e publicada no Diário Oficial da União n

o
150, seção 1, página 16, de 06 de agosto

de 2024.

⁻ XXI -

CARACTERÍSTICAS DE HELICÓPTEROS UTILIZADOS EM OFFSHORE

Tipo | comprimento D (m) | valor D | diâmetro rotor (m) | peso máx decolagem (kg) | Valor da carga máxima admissível (ton)
EC 135 T2+ | 12.20 | 12 | 10.20 | 2910 | 2.9
EC 145 | 13.03 | 13 | 11 | 3585 | 3.9
EC 155B1 | 14.30 | 14 | 12.60 | 4850 | 4.9
Sikorsky S76 | 16.00 | 16 | 13.40 | 5307 | 5.3
Agusta/ Westland AW 139 | 16.66 | 17 | 13.80 | 6800 | 6.8
Agusta/ Westland AW 189 | 17.60 | 18 | 14.60 | 8600 | 8.6
Airbus H175 | 18.06 | 18 | 14.80 | 7500 | 7.5
Super Puma AS332L | 18.70 | 19 | 15.60 | 8599 | 8.6
Super Puma AS332L2 | 19.50 | 20 | 16.20 | 9300 | 9.3
EC 225 (H225) | 19.50 | 20 | 16.20 | 11000 | 11.0
Sikorsky S92A | 20.88 | 21 | 17.17 | 12565 | 12.6
Sikorsky S61N | 22.20 | 22 | 18.90 | 9298 | 9.3
AW101 | 22.80 | 23 | 18.90 | 14600 | 14.6

Observação:

Todo transporte de passageiros/vistoriadores/inspetores, para e das embarcações/plataformas com helideques registrados na AJB, deverá ser realizado por helicóptero multimotor, com cinto de segurança de 4 (quatro) pontos, a ser composto por quatro tirantes independentes, não

sendo aceitável que dois desses tirantes tenham suas extremidades unidas, formando uma alça, que atenda aos requisitos de operação offshore, constantes nos regulamentos da ANAC, e a sua tripulação deverá estar apta a voar sob condições meteorológicas de voo por instrumento (IMC).

⁻ XXII -

REV.1 MOD.1

INTENCIONALMENTE EM BRANCO

CAPÍTULO 1

REGISTROS E CERTIFICAÇÕES DE HELIDEQUES

### 1.1. PROPÓSITO

Estabelecer instruções para certificação e registro de helideques localizados em

embarcações ou plataformas marítimas operando nas Águas Jurisdicionais Brasileiras (AJB).

### 1.2. ATRIBUIÇÃO DE RESPONSABILIDADE

A Portaria Normativa Interministerial (https://www.diariodasleis.com.br/legislacao/federal/227426-seguranca-as-operacoes-aereasaprova-a-diretriz-sobre-provisao-de-seguranca-as-operacoes-aereas-nos-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) n

o
1.422/MD/SAC-PR/2014, (https://www.diariodasleis.com.br/legislacao/federal/227426-seguranca-as-operacoes-aereasaprova-a-diretriz-sobre-provisao-de-seguranca-as-operacoes-aereas-nos-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) de 5 de junho de 2014,

atribui responsabilidades à Marinha do Brasil para elaborar normas para o registro e a certificação

de helideques em operação nas AJB.

### 1.3. DEFINIÇÕES

a) área de aproximação final e decolagem (AAFD) - é a área na qual a entrada sobre o

helideque, fase final da manobra para voo pairado ou pouso é completada e na qual a manobra de

decolagem é iniciada.

b) área de toque - é a parte da AAFD, com dimensões definidas por uma faixa circular na

cor amarela que contém o Sinal de Identificação H, na qual é recomendado o toque do helicóptero

ao pousar.

c) agente de lançamento e pouso de helicóptero (ALPH) - é o tripulante responsável pela

coordenação das operações aéreas, pela prontificação do helideque e pela condução da Equipe de

Manobra e Combate a Incêndio de Aviação (EMCIA).

d) águas jurisdicionais brasileiras (AJB) - compreendem as águas interiores e os espaços

marítimos, nos quais o Brasil exerce jurisdição, em algum grau,sobre atividades, pessoas,

instalações, embarcações e recursos naturais vivos ou não vivos, encontrados na massa líquida, no

leito ou no subsolo marinho, para os fins de controle e fiscalização, dentro dos limites da legislação

internacional e nacional. Esses espaços marítimos compreendem a faixa de 200 (duzentas) milhas

marítimas contadas a partir das linhas de base, acrescida das águas sobrejacentes à extensão da

Plataforma Continental além das 200 (duzentas) milhas marítimas, onde ela ocorrer.

e) certificação - é o ato oficial mediante o qual a Diretoria de Portos e Costas (DPC) atesta

que um helideque apresenta condições satisfatórias de segurança para realização de operações

com helicópteros nas AJB.

⁻ 1-1 -f) comprimento máximo do helicóptero (D) - D é o comprimento total do helicóptero,

considerando as projeções máximas à vante e à ré das pás dos rotores ou extremidade mais de ré

da estrutura.

g) DOE - é o acrônimo da expressão “Dano por Objeto Estranho”. Refere-se a danos

causados por objetos que possam ser aspirados pelos motores ou possam colidir com alguma

aeronave. Designa, de modo geral, esses objetos.

h) embarcação offshore - é qualquer construção, inclusive as plataformas marítimas

flutuantes e, quando rebocadas, as fixas, suscetível de se locomover na água, empregada

diretamente nas atividades de prospecção, extração, produção e/ou armazenagem de petróleo e

gás. Inclui as unidades Semi-Submersíveis, Auto-Eleváveis, Navios-Sonda, Unidades de Pernas

Tensionadas (Tension Legs), Unidades de Calado Profundo (Spar), Unidade Estacionária de

Produção, Armazenagem e Transferência (FPSO) e Unidade Estacionária de Armazenagem e

Transferência (FSO).

i) equipe de manobra e combate a incêndio de aviação (EMCIA) - é a equipe responsável

por guarnecer o helideque por ocasião de operações aéreas (embarque e desembarque de pessoal

e material, abastecimento de aeronaves, combate a incêndio, primeiros socorros e transporte de

feridos).

j) | exigência - | é o não cumprimento dos requisitos estabelecidos nesta Norma,

constatados durante uma Vistoria Inicial, de Renovação ou Inopinada.

k) exigência impeditiva - são as exigências que comprometem diretamente a segurança

das operações aéreas. Ocasionarão a interdição do helideque.

l) | exigência não impeditiva - | são exigências que não comprometem diretamente a

segurança das operações aéreas, mas que evidenciam algum descumprimento desta norma e

poderão resultar em restrição à realização das operações aéreas.

m) ficha-registro do helideque (FRH) - é o documento oficial no qual o Afretador/Armador

descreve as características gerais dos helideques das embarcações e plataformas marítimas.

n) helideque - é um heliponto situado em uma estrutura sobre água, fixa ou flutuante. É

também chamado de heliponto offshore.

o) helideque adaptado - é uma área de pouso adaptada, localizada a meia-nau, sobre a

tampa do porão de carga (hatch cover), de Navios de Carga Geral ou Graneleiros, ou na lateral do

⁻ 1-2 -convés principal de outros tipos de navios. Diferencia-se do helideque pela ausência de uma

estrutura construída para possibilitar os pousos e decolagens de helicópteros em situações

rotineiras, sendo a sua utilização limitada ao embarque e desembarque de agentes

públicos/práticos e remoção de pessoas feridas ou doentes para locais onde possam receber

assistência médica adequada.

p) registro - é o ato oficial mediante o qual a Agência Nacional de Aviação Civil (ANAC)

autoriza a abertura de um helideque privado ao tráfego aéreo, para a realização de operações com

helicópteros.

q) interdição - é o ato oficial mediante o qual a ANAC promulga a interrupção das

operações aéreas, definitiva ou temporariamente, em um determinado helideque.

r) diâmetro do helideque (L) - é o diâmetro do maior círculo imaginário que couber na

AAFD.

s) navio mercante - para fins desta norma é o navio de bandeira, nacional ou estrangeiro,

empregado no transporte de carga, atividades de prospecção, extração, produção, armazenagem

de petróleo e gás ou transporte de passageiro nas AJB, com finalidade comercial.

t) ponto de referência - é o ponto localizado na linha periférica da AAFD, escolhido

criteriosamente com base nas estruturas existentes nas proximidades do helideque, que serve de

referência para definir o Setor Livre de Obstáculos (SLO) e de Obstáculos com Alturas Limitadas

(SOAL).

u) requerente - é o Armador brasileiro, a Empresa Brasileira de Navegação, o afretador, o

operador ou o seu preposto, com representação no país, que solicita serviços de regularização de

helideque.

v) relatório de vistoria de helideque (RVH) - é o documento por intermédio do qual a

Diretoria de Portos e Costas (DPC) exara parecer técnico quanto às condições para realização de

operações aéreas em um determinado helideque, dando início ao processo de registro ou de

interdição definidos por esta norma, cujo modelo consta do anexo 1-D.

w) vistoria - é a ação oficial mediante a qual os peritos qualificados pela DPC inspecionam,

in loco, determinados helideques, verificando se suas instalações, equipamentos, pessoal e

material atendem aos requisitos mínimos estabelecidos nesta norma, de modo a assegurar a

⁻ 1-3 -existência de condições satisfatórias para a condução de operações com helicópteros nas AJB em

segurança.

x) aeronave remotamente pilotada (RPA) - aeronave projetada para operar sem piloto a

bordo e que não seja utilizada para fins meramente recreativos. Nesta definição, incluem-se todos

os aviões, helicópteros e dirigíveis controláveis nos três eixos, excluindo-se, portanto, os balões

tradicionais e os aeromodelos.

y) organização reconhecida (OR) - Entidade Especializada autorizada para atuar em nome

da Autoridade Marítima Brasileira na regularização e controle de embarcações nos aspectos

relativos à segurança da navegação, à salvaguarda da vida humana e à prevenção da poluição

ambiental. Atuam nas condições específicas de cada reconhecimento (NORMAM-331/DPC).

z) risco - é a avaliação das consequências de um perigo ou ameaça, expresso em termos

de probabilidade e severidade, tomando como referência a pior condição possível. Exemplo:

- Um vento cruzado de 45 nós no helideque é um perigo. Um piloto não controlar a

aeronave durante a decolagem ou o pouso é uma das consequências desse perigo.

- A avaliação das consequências da possibilidade de que o piloto não consiga

controlar a aeronave, em termos de probabilidade e severidade, é o risco.

aa) gerenciamento do risco - é a identificação, análise e eliminação, e/ou mitigação de um

perigo ou ameaça que afete a capacidade operacional de uma organização. O processo tem por

propósito reduzir a possibilidade da ocorrência e suas consequências a um nível aceitável,

contando com a alocação equilibrada de recursos para enfrentar, controlar e diminuir seus efeitos

a um nível aceitável, defensável e fácil de explicar.

bb) safety case - pode ser entendido como sendo um estudo de caso de segurança

composto de um ou mais Relatório de Análise de Risco (RAR), estruturados em argumentos

apoiados por evidências e destinados a justificar que um sistema é aceitável no que tange a

segurança das operações perpetradas em um determinado ambiente operacional.

Para efeito desta norma, Safety Case pode ser considerado como o documento

composto de um ou mais RAR, conforme a necessidade apresentada.

cc) plano de emergência aeronáutica (PEA) ou plano de resposta a emergência com

Aeronaves (PRE) - é o documento que estabelece os procedimentos a serem seguidos pelos

⁻ 1-4 -setores envolvidos e que define a participação da unidade nas diversas situações de emergências

aeronáuticas.

### 1.4. AUTORIZAÇÃO PROVISÓRIA, VISTORIAS E INSPEÇÃO DE FISCALIZAÇÃO

a) autorização provisória - tem a finalidade de atender às necessidades imediatas de

operação. A DPC poderá recomendar a emissão de uma Autorização Provisória para a realização de

operações aéreas em um determinado helideque que venha a ingressar nas AJB, desde que esteja

em operação no estrangeiro.

A solicitação de emissão de Autorização Provisória deverá ser requerida utilizando-se o

modelo do anexo 1-A, e anteceder de, no mínimo, 20 (vinte) dias da data desejada pelo

requerente para o início das operações aéreas. Ao requerimento de solicitação, deverão ser

anexados a FRH (anexo 1-B) e os demais documentos nela previstos, que correspondam à situação

atual do helideque.

A concessão de Autorização Provisória observará os seguintes aspectos:

I) será necessário que o helideque já possua homologação com prazo de validade

em vigor, emitida por órgão oficial de aviação civil estrangeiro ou por entidade que possua

delegação de competência de tal órgão;

II) caso a documentação apresentada seja avaliada como satisfatória, a DPC

solicitará à ANAC a abertura do helideque ao tráfego aéreo para a realização de operações de

pousos e decolagens por um período de até 30 (trinta) dias, corridos ou até o vencimento da

homologação estrangeira em vigor, o que ocorrer primeiro, prorrogáveis por um único período de

até 30 (trinta) dias, a critério da DPC. Somente poderá ser concedida uma Autorização Provisória,

para um mesmo helideque a cada período de 3 (três) anos; e

III) dentro do prazo de vigência da Autorização Provisória o helideque deverá ser

adequado à presente norma e ser realizado o processo de vistoria, certificação e homologação

aqui estabelecido.

IV) se a embarcação, mesmo com a homologação estrangeira válida, infringir alguma

exigência impeditiva desta norma, não será concedida a autorização provisória.

V) as embarcações que tiverem sua portaria de homologação cancelada por

descumprimento do artigo 1.5 ou do processo da Estação de Telecomunicações Exclusivas (ETEX)

não poderão solicitar nova autorização provisória.

⁻ 1-5 -b) vistoria inicial e de renovação - para iniciar a condução de operações aéreas nas AJB os

helideques deverão ser submetidos à Vistoria Inicial, para sua certificação e registro, os quais serão

válidos por 3 (três) anos, devendo ser renovados antes do término do prazo de registro.

I) os parâmetros técnicos estabelecidos para a autorização da realização de

operações aéreas nos helideques serão avaliados por uma Comitiva de Vistoriadores, cuja

constituição será determinada pela DPC;

II) ao requerente cabe solicitar a Vistoria por meio do anexo 1-C. A data do

protocolo de entrada do requerimento na Secretaria da DPC deverá anteceder de, no mínimo, 45

(quarenta e cinco) dias da data desejada pelo requerente para a realização da vistoria;

| Observação: para vistoria no exterior, os documentos do anexo 1-C deverão ser

encaminhados até 15 (quinze) dias antes da data da vistoria.

III) após o término da validade da portaria de registro inicial, os helideques deverão

ser submetidos às Vistorias de Renovação;

IV) as Vistorias de Renovação deverão ocorrer em até 30 (trinta) dias antes do

término do prazo de vigência da Portaria de Registro, a fim de que seja verificada a manutenção

das condições técnicas do helideque e renovadas a sua certificação e registro;

V) a solicitação de Vistoria de Renovação deverá ser feita por meio do anexo 1-C. O

requerente deverá apresentar sua solicitação com antecedência mínima de 50 (cinquenta) dias

em relação à data de vencimento da portaria;

VI) no caso de Vistoria Inicial ou de Renovação, os documentos previstos no anexo 1-

C deverão ser anexados ao requerimento. A FRH deverá ser preenchida com todos os dados atuais

do helideque. A partir do início do processo de registro, quando houver qualquer alteração das

informações contidas na última ficha entregue à DPC, o requerente deverá atualizá-la e

encaminhá-la corretamente preenchida;

VII) com o objetivo de atender às embarcações recém-construídas no Brasil ou no

exterior, poderá ser realizada uma Vistoria Inicial, fora de área de operação, caso seja considerado

aceitável e exequível pela DPC. Adicionalmente ao previsto no anexo 1-C, a embarcação deverá

dispor de uma aeronave para pouso no helideque, ou ser colocado um peso equivalente a metade

da tonelagem do mais pesado helicóptero que ele suportará, e deverão ser encaminhados à DPC,

caso não sejam apresentados “in loco”, cópia dos certificados de habilitação do ALPH, dos

⁻ 1-6 -

Bombeiros de Aviação (BOMBAV), dos Assistentes de helideque (AHD), do Radioperador de

Plataforma Marítima (RPM), do inspetor de bagagem e passageiros, da tripulação da embarcação

de resgate e o comprovante de recebimento do processo de homologação da ETEX no Centro

Integrado de Defesa Aérea e Controle do Tráfego Aéreo (CINDACTA) responsável pela área de

operação. Somente serão certificados os helideques aprovados nas verificações finais, se

necessário, realizadas durante o primeiro pouso de aeronave com os peritos da DPC, em AJB; e

VIII) após a Vistoria Inicial ou de Renovação será emitido o RVH (anexo 1-D), com

cópia para o requerente, no prazo de 5 (cinco) dias úteis.

Observação: a solicitação para vistoria no exterior deverão ser encaminhadas à DPC

com 90 (noventa) dias de antecedência.

c) vistoria para retirada de exigência – é utilizada para a verificação do cumprimento de

exigência constatada durante uma vistoria Inicial, de Renovação ou de Inspeção de Fiscalização.

Será agendada mediante solicitação do Armador/Operador ou seu representante legal. O

requerente deverá comunicar o cumprimento da exigência à DPC por meio do documento

“Informação do Cumprimento de Exigência” (anexo 1-E). A comunicação deverá ser feita com, no

mínimo, 10 (dez) dias de antecedência em relação ao vencimento do prazo estipulado para a

retirada da exigência. O não cumprimento deste prazo resultará no cancelamento da Portaria de

Registro. Será considerada como data da comunicação do cumprimento da exigência a do

protocolo de recebimento do documento “Informação do Cumprimento de Exigência” pela

Secretaria da DPC.

Estas Normas estabelecem uma lista de exigências impeditivas e as definem,

genericamente, como aquelas cuja gravidade comprometa, de imediato, as condições mínimas

para a realização de operações aéreas com segurança. A relação de Exigências Impeditivas, anexo

1-F, não é taxativa e será dinâmica, sofrendo atualizações constantemente, em função do acúmulo

de experiência dos vistoriadores, bem como da evolução dos recursos tecnológicos e dos

procedimentos operacionais.

Após a Vistoria para a Retirada de Exigência será emitido o RVH (anexo 1-D), com

cópia para o requerente, no prazo de 5 (cinco) dias úteis.

⁻ 1-7 -

REV.1 MOD.1 d) inspeção de fiscalização - a DPC poderá realizar perícias, sem aviso prévio, em qualquer

época, denominadas Inspeções de Fiscalização, para verificar a manutenção das condições técnicas

do helideque.

I) após a Inspeção de Fiscalização será emitido o RVH (anexo 1-D), com cópia para o

requerente;

II) para a retirada de exigências deverão ser adotados os procedimentos previstos

na alínea c anterior;

III) caso seja identificada exigência relativa ao projeto da plataforma ou do navio que

não tenha sido observada por ocasião da Vistoria Inicial ou da Vistoria de Renovação anterior, será

feita observação no RVH determinando o cumprimento da exigência até a próxima vistoria

programada para o helideque; e

IV) as Vistorias de Inspeções de Fiscalização não serão consideradas para extensão

do prazo de validade da Portaria de Registro do helideque.

e) vistoria de alteração de parâmetro - no caso de necessidade de alteração de

parâmetros, o requerente deverá solicitá-la à DPC, mediante o preenchimento do Requerimento

para Alteração de Parâmetro do Helideque (anexo 1-G), ao qual deverão ser anexados os

documentos nele citados, a solicitação deve anteceder de, no mínimo, 20 (vinte) dias da data

desejada pelo requerente para a alteração.

I) caso a DPC considere que as alterações não implicam em mudanças substanciais

nas características do helideque, solicitará à ANAC a emissão da Portaria de Registro contendo as

alterações solicitadas, cujo prazo de validade deverá ser o mesmo da Portaria de Registro anterior;

II) caso a DPC identifique que as alterações solicitadas implicam na necessidade de

realizar uma vistoria in loco, deverá notificar o requerente;

III) a realização da Vistoria para Verificação de Alteração de Parâmetro não implicará

alteração no prazo de validade da Portaria de Homologação anterior; e

IV) após a Vistoria de Alteração de Parâmetro será enviado o RVH ao requerente.

Observação: deverá ser cumprida a L (https://www.planalto.gov.br/ccivil_03/_ato2015-2018/2018/lei/l13726.htm)ei n (https://www.planalto.gov.br/ccivil_03/_ato2015-2018/2018/lei/l13726.htm)º (https://www.planalto.gov.br/ccivil_03/_ato2015-2018/2018/lei/l13726.htm) 13.726, de 8 de outubro de 2018. (https://www.planalto.gov.br/ccivil_03/_ato2015-2018/2018/lei/l13726.htm)

⁻ 1-8 -

### 1.5. SAÍDA E REGRESSO DE AJB DE EMBARCAÇÃO COM HELIDEQUE REGISTRADO

O Armador/Operador, ou seu representante legal, deverá informar à DPC a saída de toda

embarcação ou plataforma das AJB, caso contrário, a embarcação ou plataforma terá o seu registro

cancelado.

Caso a embarcação ou plataforma, que possua Portaria de Registro emitida pela ANAC,

ausente-se das AJB e regresse posteriormente com a mesma ainda dentro da validade, ela não

perderá a sua efetividade. Entretanto, o Armador/Operador deverá encaminhar à DPC, um

Certificado de Manutenção das Condições Técnicas de Helideque, conforme o modelo do anexo 1-

H.

### 1.6. DESPESAS SOB A RESPONSABILIDADE DO REQUERENTE

Compete ao requerente arcar com as despesas para registro e certificação do helideque,

inclusive as relacionadas a eventuais vistorias realizadas, no país ou no exterior, pela equipe de

Vistoriadores designada pela DPC.

Os valores das indenizações e a guia de pagamento constam da tabela no sítio eletrônico da

DPC, (www.marinha.mil.br/dpc/NORMAM).

### 1.7. CONDIÇÕES DE REALIZAÇÃO DAS VISTORIAS

Para efeito de planejamento deverão ser considerados os seguintes aspectos:

a) as vistorias serão realizadas no local de operação ou onde possam ser testados todos

os sistemas e equipamentos da plataforma ou da embarcação relacionados à operação do

helideque, nas condições de operação normais em que o mesmo será empregado.

b) as vistorias serão realizadas no período diurno. Por ocasião da solicitação da vistoria o

requerente receberá da DPC uma proposta de logística, com a programação, a fim de ser

apreciada. O requerente deverá colocar um representante para acompanhar, presencialmente, a

equipe de vistoria, desde o início do translado terrestre até o final da vistoria.

c) no decorrer da vistoria, o helicóptero cortará seus motores no helideque, que ficará

interditado e à disposição da Comissão de Vistoriadores, devendo a embarcação disponibilizar

todos os recursos necessários para atender a sua realização.

d) os vistoriadores deverão ser transportados ao helideque por helicóptero multimotor

que atenda aos requisitos de operação offshore, que possua os equipamentos Helicopters

Operation Monitoring Program (HOMP - sistema que, padroniza as operações e previamente

⁻ 1-9 -

REV.1 MOD.1 qualquer problema na qualidade das operações), Health and Usage Monitoring Systems (HUMS -

sistema de monitoramento que utiliza técnicas de coleta e análise de dados para ajudar a garantir

a disponibilidade, confiabilidade e segurança das aeronaves), Blue Sky (sistema via satélite que

monitora informações diversas da aeronave) e o Traffic Alert and Collision Avoidance System (TCAS

- sistema de prevenção de colisão e alerta de tráfego), ou similares, cinto de segurança de 4

(quatro) pontos, a ser composto por quatro tirantes independentes, não sendo aceitável que dois

desses tirantes tenham suas extremidades unidas, formando uma alça e a sua tripulação deverá

estar apta a voar sob condições meteorológicas de voo por instrumento (IMC). O helicóptero será

destinado exclusivamente para atender à realização da vistoria e ficará no helideque, cortado e à

disposição da Comitiva de Vistoriadores, durante a sua realização. Deverá ser disponibilizado um

ponto de comunicação (3º fone - rabicho) no helicóptero, para que um vistoriador possa verificar

as comunicações internas e externas, assim como os procedimentos de comunicação rádio dos

pilotos e da unidade a ser vistoriada.

### 1.8. PROCESSO DE REGISTRO

a) certificação - a Certificação de Helideque (anexo 1-J) será emitida pela DPC, com a

validade contando a partir da data de realização da Vistoria Inicial ou de Renovação.

Havendo Exigência Não Impeditiva por ocasião das Vistorias, a DPC solicitará à ANAC a

abertura do helideque para a realização de operações aéreas. Após a verificação do cumprimento

das exigências, a DPC emitirá o RVH final do Helideque, contando o prazo de certificação a partir

da data da vistoria. O helideque poderá operar pelo prazo de até 60 (sessenta) dias, prorrogáveis

por um único período de até 30 (trinta) dias, a critério da DPC. Terminado este prazo sem que a

exigência tenha sido cumprida pelo armador e verificada pela DPC, será solicitado à ANAC o

cancelamento da Portaria de Registro. Após o cancelamento da Portaria de Registro, deverá ser

realizada uma nova Vistoria Inicial para que a embarcação/plataforma seja novamente autorizada

a operar o helideque.

Havendo Exigência Impeditiva, a DPC solicitará à ANAC a interdição do helideque, em

conformidade com o procedimento previsto na alínea c abaixo.

A Certificação de Helideque terá validade de 3 (três) anos, podendo ser renovada

indefinidamente por iguais períodos mediante realização de Vistorias de Renovação com resultado

satisfatório.

⁻ 1-10 -

A DPC encaminhará a Certificação de Helideque para a ANAC, a fim de subsidiar a

emissão da Portaria de Registro. Será encaminhada cópia do RVH para o requerente.

A DPC poderá cancelar a Certificação, a qualquer momento, caso tome conhecimento

de que os parâmetros técnicos ou que as condições da plataforma ou da embarcação

comprometam a realização de operações aéreas de pouso e decolagem com segurança.

b) registro - ocorrerá mediante o encaminhamento, pela DPC, da Certificação de

Helideque juntamente com a respectiva FRH para ANAC.

A ANAC é responsável pela expedição da Portaria de Registro e a sua publicação no

Diário Oficial da União (DOU).

A Portaria de Registro terá validade de 3 (três) anos, devendo seu término coincidir

com a data de validade da Certificação de Helideque expedida pela DPC.

Obervação: - a ANAC sempre emitirá a Portaria de Registro com o seu prazo máximo.

Se o helideque da embarcação/plataforma contiver exigências não impeditivas, estas serão listadas

no RVH com os seus prazos de execução. Caso as mesmas não sejam cumpridas no respectivo

prazo, a DPC solicitará à ANAC o cancelamento da Portaria (anexo 1-J).

- constará na certificação e no RVH:

Sem Exigências: “O Helideque vistoriado APRESENTOU CONDIÇÕES

SATISFATÓRIAS DE SEGURANÇA para pousos e decolagens de helicópteros no período diurno e

para pouso e decolagens, em caráter de emergência, no período noturno, até a data de

___/___/___. As operações no período noturno estão condicionadas ao descrito no artigo 9.4.“

Com Exigências: “O helideque vistoriado apresentou exigências que

permitem a operação de pousos e decolagens de helicópteros no período diurno e pousos e

decolagens, em caráter de emergência, no período noturno, até a data de ___/___/___. As

operações no período noturno estão condicionadas ao descrito no artigo 9.4.”

O treinamento para o período noturno deverá seguir o constante no

RBAC da ANAC.

c) notificação de interdição e desinterdição de helideque - Caso seja verificado a

existência de Exigência Impeditiva, será emitida a Notificação de Interdição de Helideque para

pouso | de | helicópteros, sendo | assinada | pelos | Vistoriadores | e | pelo | responsável | pela

embarcação/helideque, conforme previsto no anexo 1-K. Após a Vistoria para Retirada de

⁻ 1-11 -

REV.1 MOD.1

REV.1MOD.1

Exigência, constatada a correção da(s) Exigência(s) Impeditiva(s), o representante da Autoridade

Marítima emitirá a Notificação de Desinterdição do Helideque, anexo 1-K, e solicitará à ANAC a

abertura/reabertura do helideque para o tráfego aéreo. As notificações serão emitidas em 2 (duas)

vias, ficando a original com o responsável da Embarcação/Plataforma, uma cópia com a equipe de

vistoria.

### 1.9. CERTIFICADO DE MANUTENÇÃO DAS CONDIÇÕES TÉCNICAS (CMCTH)

Se uma embarcação ou plataforma, que possua Portaria de Registro emitida pela ANAC, for

se ausentar da AJB, deverá informar à DPC. Caso a mesma regresse posteriormente, com a Portaria

de Registro em vigor, e tenha interesse de utilizar o helideque, deverá encaminhar à DPC o CMCTH,

conforme o anexo 1-H, em até 10 (dez) dias antes de reingressar em AJB. Deverá ser encaminhado

juntamente o Certificado de Coeficiente de Atrito, quando aplicável.

A | não | apresentação | desse | documento, | dentro | do | prazo | previsto, | cancelará

automaticamente a validade da Certificação do Helideque, acarretando a revogação da portaria de

registro.

Caberá à DPC solicitar à ANAC a interdição do helideque e o cancelamento da Portaria de

Registro, se a embarcação se ausentar de AJB, sem comunicar à DPC. Neste caso, para que o

helideque possa retomar à realização das operações aéreas, deverá ser submetido a uma nova

Vistoria Inicial.

### 1.10. EMBARCAÇÕES DE ESPORTE E RECREIO COM HELIDEQUE

A DPC não certifica helideques instalados em embarcação de esporte e recreio. Para esses

casos, devem ser cumpridos os procedimentos da ANAC.

### 1.11. COMUNICAÇÃO ENTRE EMBARCAÇÃO/PLATAFORMA X AERONAVE

Se não houver uma frequência aeronáutica alocada pelo Departamento de Controle do

Espaço Aéreo (DECEA), por questões de segurança, as comunicações essenciais entre o helicóptero

e a unidade marítima deverão trafegar pelo VHF marítimo, até a homologação da respectiva

Estação de Telecomunicações Exclusivas (ETEX).

A utilização de frequências não homologadas na faixa aeronáutica é crime, conforme

previsto no art. 183, da L (https://www.planalto.gov.br/ccivil_03/leis/l9472.htm)ei n (https://www.planalto.gov.br/ccivil_03/leis/l9472.htm)º (https://www.planalto.gov.br/ccivil_03/leis/l9472.htm) 9.472, de 16 de julho de 1997. (https://www.planalto.gov.br/ccivil_03/leis/l9472.htm)

A chamada fonia do Radioperador em Plataforma Marítima (RPM) é aquela designada pelo

DECEA na Portaria ou no Ofício de Homologação da ETEX.

⁻ 1-12 -

### 1.12. AERONAVE REMOTAMENTE PILOTADA (RPA)

As aeronaves remotamente pilotadas, que compreendem os sistemas de aeronaves

remotamente pilotadas e aeronaves totalmente autônomas, se enquadram na definição de

aeronave, presente no Código Brasileiro de Aeronáutica - CBAer (Lei n

o
7.565, de 19 de dezembro

de 1986) e, portanto, são objeto de regulação e fiscalização da ANAC, no caso de operações civis.

A autorização da ANAC é condição necessária, mas não suficiente para a operação de

sistemas de aeronaves civis remotamente pilotadas no Brasil. Também é preciso que o operador

obtenha autorização do DECEA e verifique junto à Agência Nacional de Telecomunicações (ANATEL)

se a sua frequência de controle é segura.

As competências da ANAC e do DECEA são complementares e, portanto, ambas as

autorizações são necessárias para a operação de aeronaves civis remotamente pilotadas no Brasil.

As embarcações/plataformas que desejam utilizar o RPA deverão seguir as normas e

regulamentos da ANAC, do DECEA e da ANATEL.

Não é permitida a sua utilização em embarcações/plataformas que tenham helideques,

simultaneamente com as operações de pouso e decolagem de helicópteros, exceção se daria nos

casos de emprego de RPA em área interna das embarcações/plataformas, como tanques,

reservatórios e espaços confinados, ou para inspeções estruturais, em caráter excepcional, que

envolvam aspectos de segurança das mesmas, quando deve haver uma coordenação com a

tripulação do helicóptero e sem possibilidade de interferência mútua.

O descumprimento dessa regra está passível de autuação por parte da Autoridade

competente.

### 1.13. CUMPRIMENTO DE REQUISITOS

A DPC manterá atualizada, no seu sítio eletrônico (www.marinha.mil.br/dpc/NORMAM),

uma tabela de prazos para o cumprimento de requisitos e de exceções; a Autoridade Marítima

recomenda a consulta e o conhecimento prévio, pelos operadores de helicópteros e das

embarcações, das exceções e prazos desta tabela, especialmente quando operando em áreas com

difícil acesso à internet.

Caso a embarcação/plataforma, após a homologação de seu helideque, infrinja algum

requisito dessa norma, receberá uma comunicação (anexo 1-L) e informará seu cumprimento à

DPC, caso contrário poderá ter as operações aéreas suspensas, definitiva ou temporariamente.

⁻ 1-13 -

### 1.14. TRANSPORTE DE ARTIGOS PERIGOSOS E INSPEÇÃO DE BAGAGENS E PASSAGEIROS

As empresas operadoras de embarcações/plataformas marítimas dotadas de helideque

devem possuir procedimentos formalmente estabelecidos a fim de garantir que nenhum artigo

perigoso seja embarcado nas aeronaves, salvo quando o transporte for realizado em conformidade

com os requisitos da ANAC e realizados por Cias Aéreas expressamente autorizadas pela mesma a

conduzi-los.

As embarcações/plataformas deverão possuir pessoal qualificado para realizar inspeção de

bagagens e passageiros antes do embarque por aeronave, podendo ser utilizado como referência,

a cargo das Operadoras de embarcações/plataformas, o curso básico AVSEC para a inspeção de

bagagens e passageiros e a Categoria 12 da Instrução Suplementar 175 002F da RBAC 175, (https://www.anac.gov.br/assuntos/legislacao/legislacao-1/boletim-de-pessoal/2021/30/anexo-ii-is-no-175-002-revisao-g) última

atualização, para a verificação de artigos perigosos.

Fica a critério das operadoras de embarcações/plataformas qualquer qualificação adicional

em demais Categorias referenciadas na instrução suplementar supracitada.

Observação: serão aceitos certificados de curso de segurança ministrados pelas empresas

operadoras das embarcações/plataformas, desde que tenham procedimentos formalmente

estabelecidos.

### 1.15. RISCO DE FAUNA

Deverá ser cumprido o R (https://pergamum.anac.gov.br/arquivos/RBAC153EMD06.PDF)egulamento (https://pergamum.anac.gov.br/arquivos/RBAC153EMD06.PDF) B (https://pergamum.anac.gov.br/arquivos/RBAC153EMD06.PDF)rasileiro da (https://pergamum.anac.gov.br/arquivos/RBAC153EMD06.PDF) A (https://pergamum.anac.gov.br/arquivos/RBAC153EMD06.PDF)viação (https://pergamum.anac.gov.br/arquivos/RBAC153EMD06.PDF) C (https://pergamum.anac.gov.br/arquivos/RBAC153EMD06.PDF)ivil (https://pergamum.anac.gov.br/arquivos/RBAC153EMD06.PDF) ( (https://pergamum.anac.gov.br/arquivos/RBAC153EMD06.PDF)RBAC (https://pergamum.anac.gov.br/arquivos/RBAC153EMD06.PDF)) (https://pergamum.anac.gov.br/arquivos/RBAC153EMD06.PDF) n (https://pergamum.anac.gov.br/arquivos/RBAC153EMD06.PDF)º (https://pergamum.anac.gov.br/arquivos/RBAC153EMD06.PDF) 153 (https://pergamum.anac.gov.br/arquivos/RBAC153EMD06.PDF) Emenda (https://pergamum.anac.gov.br/arquivos/RBAC153EMD06.PDF) n (https://pergamum.anac.gov.br/arquivos/RBAC153EMD06.PDF)º

06, (https://pergamum.anac.gov.br/arquivos/RBAC153EMD06.PDF) de (https://pergamum.anac.gov.br/arquivos/RBAC153EMD06.PDF) 15 de março de 2021, (https://pergamum.anac.gov.br/arquivos/RBAC153EMD06.PDF) ou a sua atualização, no que couber.

As Unidades Estacionárias devem ficar atentas quando houver uma rota migratória, devendo

informar às tripulações das aeronaves a existência de pássaros no entorno da embarcação quando

em operações aéreas.

### 1.16. EMBARCAÇÕES COM HELIDEQUE NÃO REGISTRADO OU SEM O REGISTRO VÁLIDO

As embarcações, que operarão em AJB, que possuem helideques, mas não desejam

registrá-lo ou com o registro vencido devem:

- nas perícias e inspeções, apresentar ao Inspetor Naval uma declaração que não

utilizarão seu helideque, anexo 1-M; e

- colocar a sinalização de helideque interditado, artigo 5.4, subitem g desta norma.

As embarcações/plataformas não registradas que necessitarem de resgate aeromédico

deverão solicitá-lo ao SALVAMAR ou SALVAERO da sua área de operação.

⁻ 1-14 -

### 1.17. DOCUMENTOS

Todos os documentos deverão ser encaminhados à DPC em meio eletrônico, utilizando o

formato PDF (Adobe Reader).

As plantas do helideque, na escala 1:100, além do formato eletrônico também deverão ser

encaminhadas por meio impresso.

Os documentos originais deverão ser mantidos arquivados pelo interessado até a

finalização do processo para possível consulta.

### 1.18. OPERAÇÃO DOS HELIDEQUES

Os helideques localizados em embarcações e plataformas marítimas poderão realizar as

operações aéreas no período diurno, do nascer ao por do sol local, e em caráter de emergência, no

período noturno.

### 1.19. CASOS NÃO PREVISTOS

Os casos não previstos na presente norma deverão ser encaminhados à DPC, a fim de

serem analisados.

⁻ 1-15 -

CAPÍTULO 2

PROJETO DO HELIDEQUE

### 2.1. REQUISITOS FUNDAMENTAIS

Para projetar a estrutura de um helideque, o engenheiro necessita como ponto de partida,

definir a sua localização, as dimensões e o peso do maior e mais pesado helicóptero que a

estrutura deverá ser capaz de suportar. Para definir esses requisitos fundamentais o engenheiro

poderá, como dado de projeto:

a) adotar as dimensões e o peso do maior e mais pesado helicóptero conhecido que

poderá operar naquele helideque; ou

b) assumir dimensões para a AAFD e resistência do piso que permitam a operação no

helideque de helicópteros, conhecidos ou não, com dimensões e peso inferiores ou, no máximo,

iguais às assumidas.
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
