KlaussMarchi/MRU/Documents/Compare/Norma/NORMAM-27_DPC - Rev2-Mod4_0_0.pdf

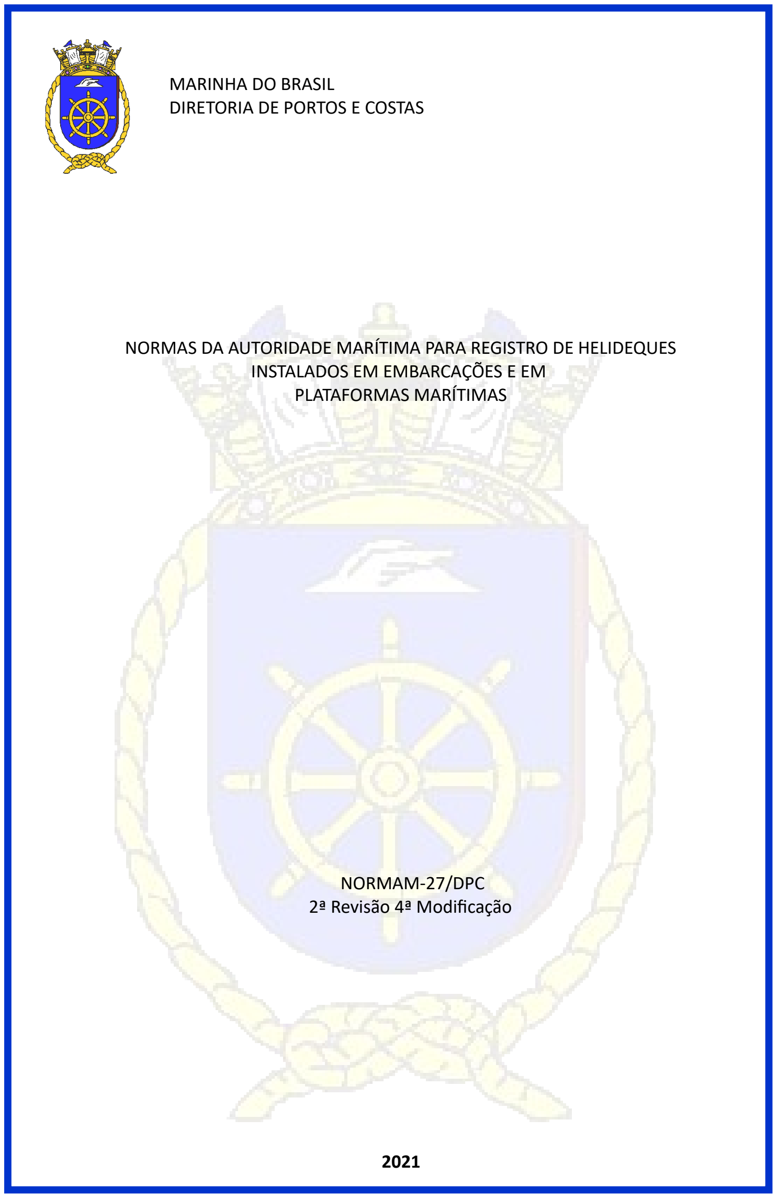
[picture p176: page 1]

- I -

NORMAS DA AUTORIDADE MARÍTIMA PARA REGISTRO DE HELIDEQUES INSTALADOS EM EMBARCAÇÕES E EM PLATAFORMAS MARÍTIMAS

NORMAM-27/DPC
2ª Revisão 4ª Modificação

2021

MARINHA DO BRASIL
DIRETORIA DE PORTOS E COSTAS

FOLHA DE REGISTRO DE MODIFICAÇÕES

NÚMERO
DA
MODIFICAÇÃO

EXPEDIENTE QUE A
DETERMINOU E
RESPECTIVA DATA

PÁGINAS
AFETADAS

DATA DA
ALTERAÇÃO | RUBRICA
Rev 2 | Portaria no
294/DPC, de 17
| de outubro de 2017

I
II
III
IV
V
VI
VII
VIII
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
- II - | NORMAM-27/DPC Rev 2

NÚMERO
DA
MODIFICAÇÃO

EXPEDIENTE QUE A
DETERMINOU E
RESPECTIVA DATA

PÁGINAS
AFETADAS

DATA DA
ALTERAÇÃO RUBRICA

9-2
9-3
9-5
10-1
10-2
10-3
10-4
10-5
10-6
10-7
10-8
10-9
11-1
11-2
11-3
11-5
Cap 12
Cap 13
1-A-1
1-B-1
1-C-1
1-E-1
1-G-1
1-H-1
1-I-1
1-I-2
2-D-1
2-E-1
3-B-1
3-C-1
4-A-1
4-B-1
4-C-1
5-A-1
5-H-1
5-H-2
12-A-1
12-B-1
13-A-1
13-B-1
13-C-1
13-D-1
- III - | NORMAM-27/DPC Rev 2

NÚMERO
DA
MODIFICAÇÃO

EXPEDIENTE QUE A
DETERMINOU E
RESPECTIVA DATA

PÁGINAS
AFETADAS

DATA DA
ALTERAÇÃO | RUBRICA
Rev 2 Mod 1 | Portaria no
394 , de 10 de
| dezembro de 2018

IV
V
VII
IX
X
XI
XII
XIII
XIV
XV
XVIII
1-1
1-3
1-4
1-5
1-7
1-8
1-9
1-10
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
- IV - | NORMAM-27/DPC Rev 2 Mod 1

NÚMERO
DA
MODIFICAÇÃO

EXPEDIENTE QUE A
DETERMINOU E
RESPECTIVA DATA

PÁGINAS
AFETADAS

DATA DA
ALTERAÇÃO RUBRICA

9-1
9-2
9-3
9-5
10-1
10-4
10-7
11-3
11-5
11-6
12-2
13-1
13-2
13-3
13-4
13-5
1-A-1
1-C-1
1-D-1
1-D-2
1-D-3
1-D-4
1-F-1
1-G-1
1-H-1
1-I-1
1-J-1
2-B-1
4-C-2
5-F-1
5-G-2
5-G-3
5-G-4
5-G-5
5-G-6
5-G-7
5-H-2
6-A-1
- V - | NORMAM-27/DPC Rev 2 Mod 1

NÚMERO
DA
MODIFICAÇÃO

EXPEDIENTE QUE A
DETERMINOU E
RESPECTIVA DATA

PÁGINAS
AFETADAS

DATA DA
ALTERAÇÃO | RUBRICA
Rev 2 Mod 2 | Portaria no
422 , de 02 de
| dezembro de 2019

Capa
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
1-10
1-11
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
- VI - | NORMAM-27/DPC Rev 2 Mod 2

NÚMERO
DA
MODIFICAÇÃO

EXPEDIENTE QUE A
DETERMINOU E
RESPECTIVA DATA

PÁGINAS
AFETADAS

DATA DA
ALTERAÇÃO RUBRICA

9-6
10-7
10-8
11-4
11-5
12-1
12-2
1-A-1
1-B-1
1-C-1
1-D-2
1-E-1
1-F-1
1-F-2
1-G-1
1-H-1
1-I-1
1-J-1
1-J-2
1-L-1
1-M-1
2-B-1
3-A-1
3-B-1
4-E-1
- VII - | NORMAM-27/DPC Rev 2 Mod 2

NÚMERO
DA
MODIFICAÇÃO

EXPEDIENTE QUE A
DETERMINOU E
RESPECTIVA DATA
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
