KlaussMarchi/MRU/Documents/Management/Project/Plano de Trabalho.pdf

PIFF-2411.0049

ANEXO I

PLANO DE TRABALHO

### 1. Título

Dispositivo Referência de Monitoramento dos Movimentos em Helidecks e Guindastes Offshore.

### 2. Objetivos

### 2.1. Objetivo Geral

Desenvolver um protótipo funcional com tecnologia nacional de um Dispositivo de Referência de Monitoramento dos Movimentos em Helidecks e Guindastes Offshore para aplicação em helidecks e guindastes offshore, capaz de garantir
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
