KlaussMarchi/MRU/Analysis/Optimizer/Heave/docs/orient.png

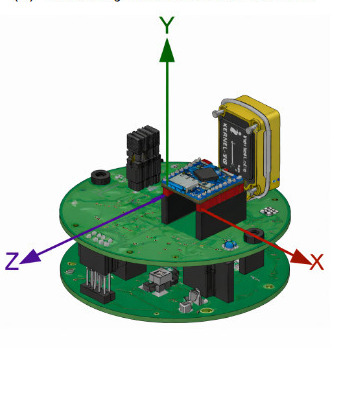
Analysis/Optimizer/Heave/docs/orient.png
