KlaussMarchi/MRU/Analysis/Optimizer/Heave/docs/pendul.png

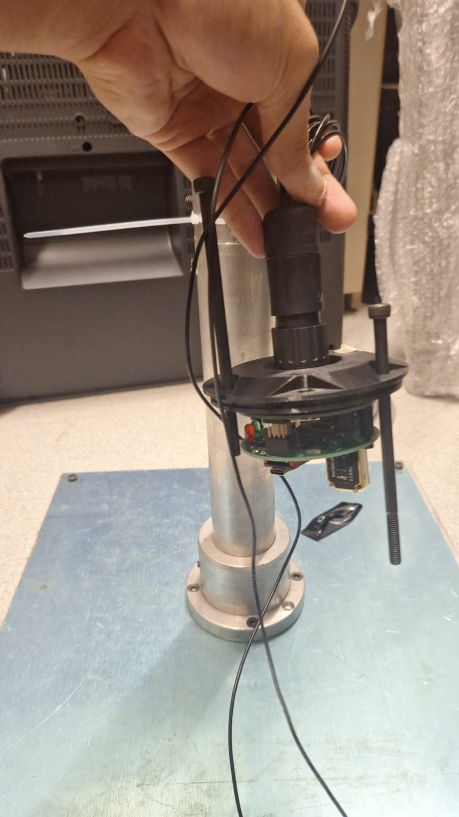
Analysis/Optimizer/Heave/docs/pendul.png
