KlaussMarchi/MRU/Documents/Align.png

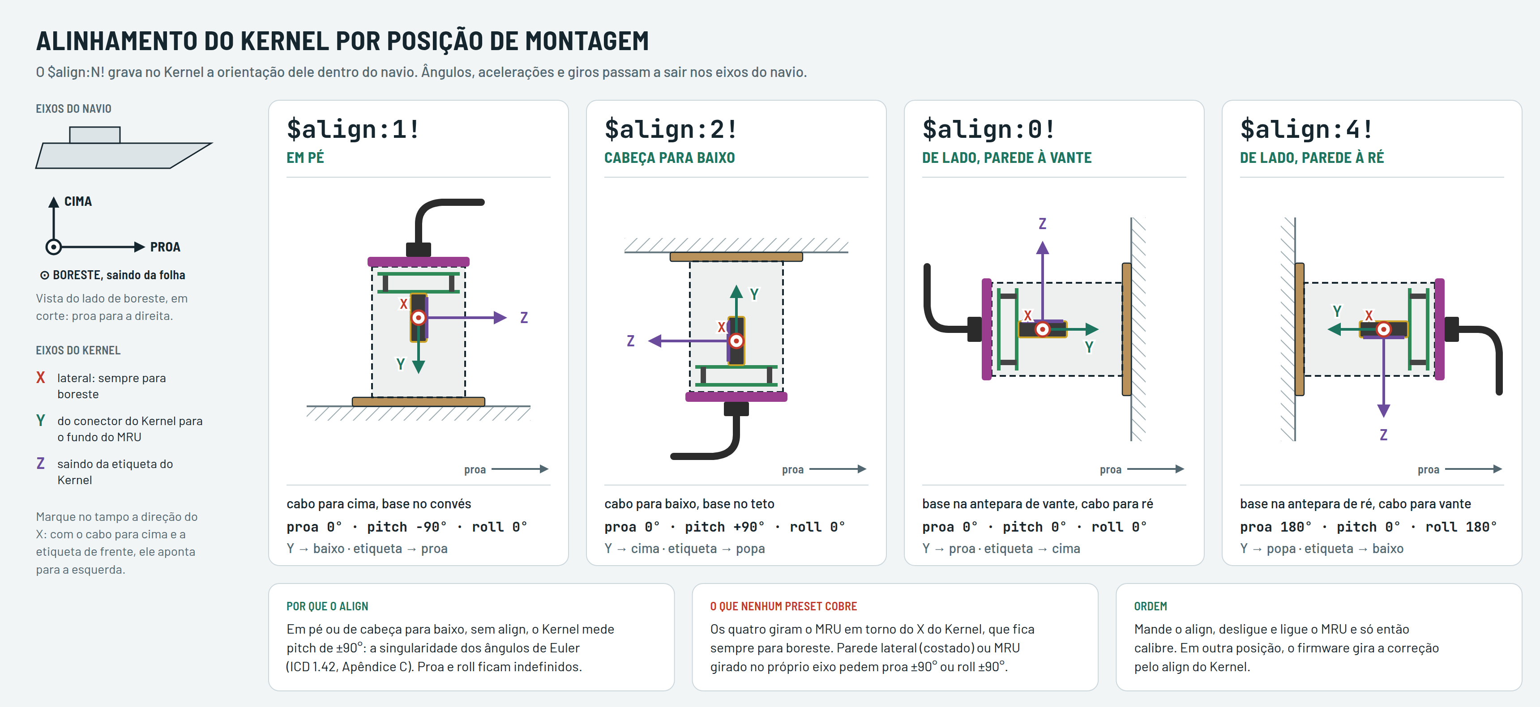
Documents/Align.png
