KlaussMarchi/MRU/Documents/Datasheet/assets/embrapii.png

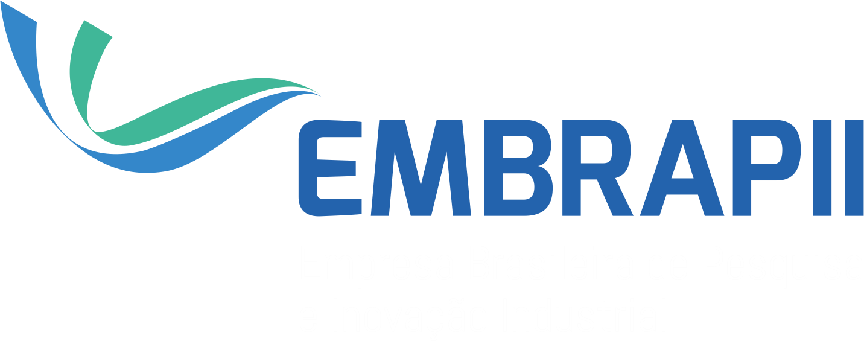
Documents/Datasheet/assets/embrapii.png
