KlaussMarchi/MRU/Documents/Datasheet/assets/iff.png

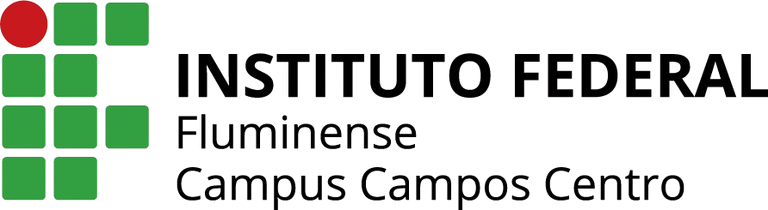
Documents/Datasheet/assets/iff.png
