KlaussMarchi/MRU/Documents/Datasheet/assets/image copy 2.png

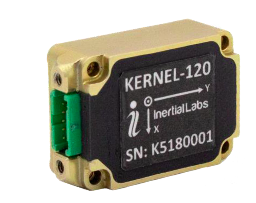
Documents/Datasheet/assets/image copy 2.png
