KlaussMarchi/MRU/Documents/Datasheet/assets/image copy 3.png

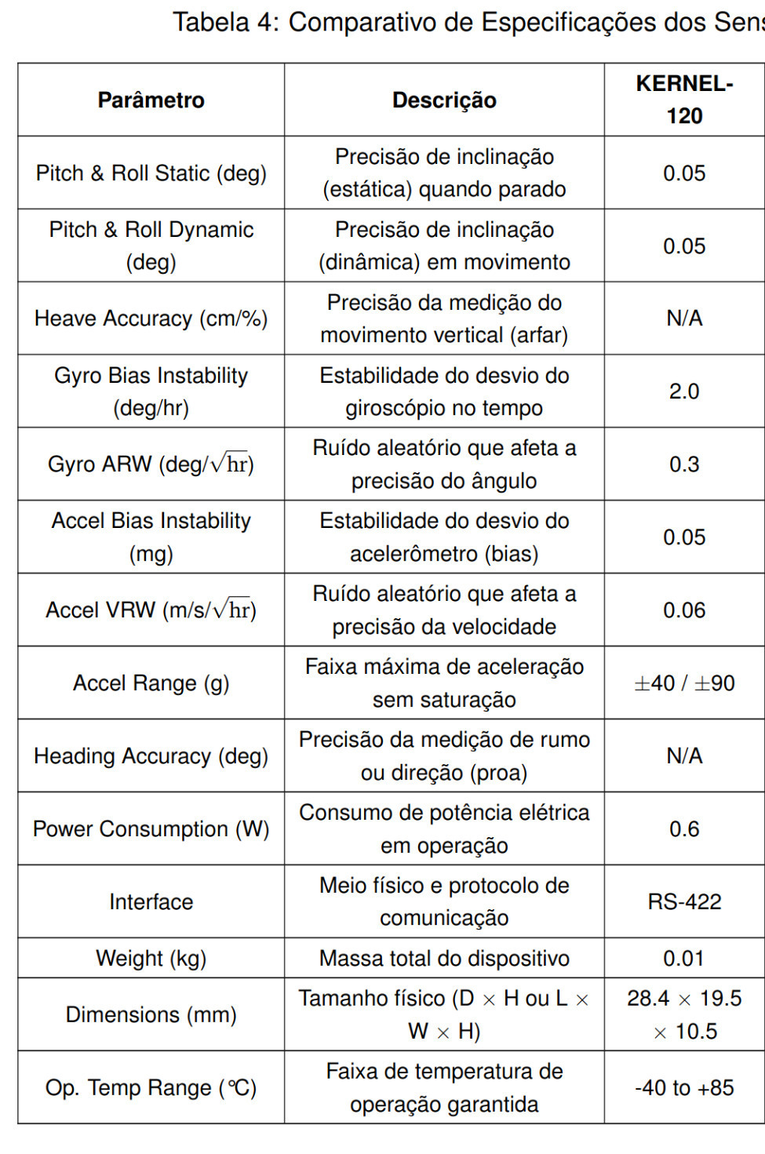
Documents/Datasheet/assets/image copy 3.png
