KlaussMarchi/MRU/Documents/Datasheet/assets/kernel_img-000.png

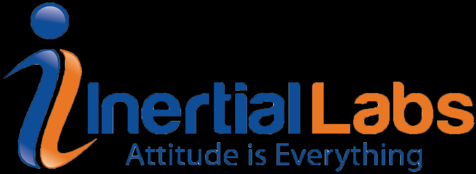
Documents/Datasheet/assets/kernel_img-000.png
