KlaussMarchi/MRU/Documents/Datasheet/assets/kernel_img-001.png

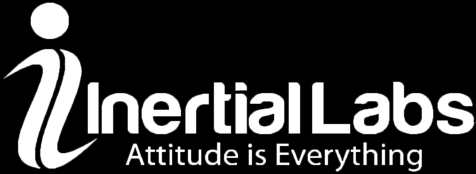
Documents/Datasheet/assets/kernel_img-001.png
