KlaussMarchi/MRU/Documents/Datasheet/assets/kernel_img-004.png

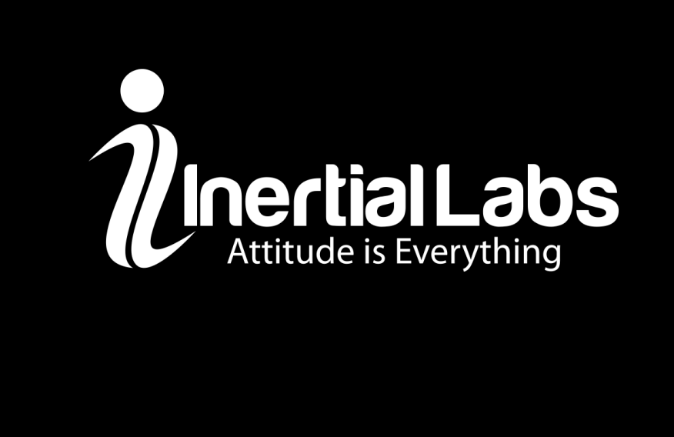
Documents/Datasheet/assets/kernel_img-004.png
