KlaussMarchi/MRU/Documents/Datasheet/assets/kernel_img-006.png

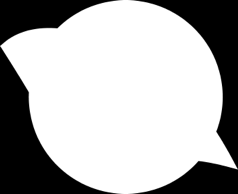
Documents/Datasheet/assets/kernel_img-006.png
