KlaussMarchi/MRU/Documents/Datasheet/assets/kernel_img-009.png

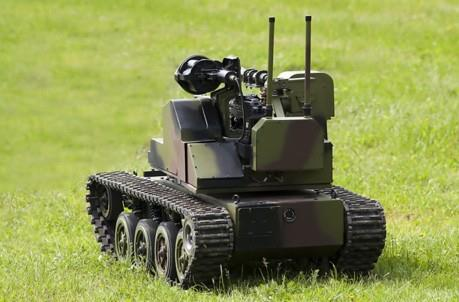
Documents/Datasheet/assets/kernel_img-009.png
