KlaussMarchi/MRU/Documents/Datasheet/assets/kernel_img-010.png

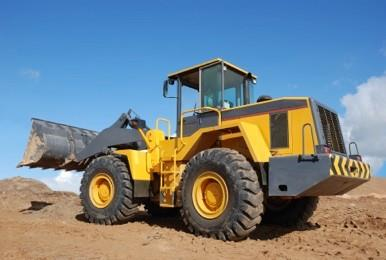
Documents/Datasheet/assets/kernel_img-010.png
