KlaussMarchi/MRU/Documents/Datasheet/assets/kernel_img-011.png

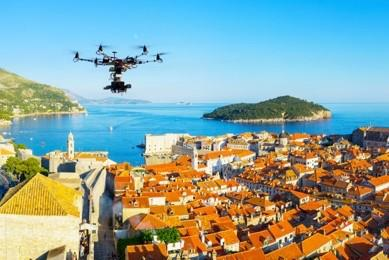
Documents/Datasheet/assets/kernel_img-011.png
