KlaussMarchi/MRU/Documents/Datasheet/assets/kernel_img-012.png

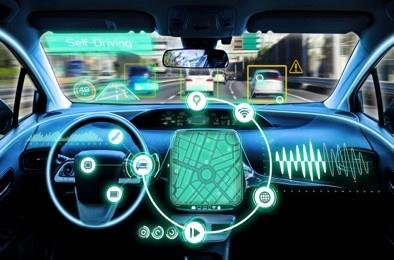
Documents/Datasheet/assets/kernel_img-012.png
