KlaussMarchi/MRU/Documents/Datasheet/assets/kernel_img-013.png

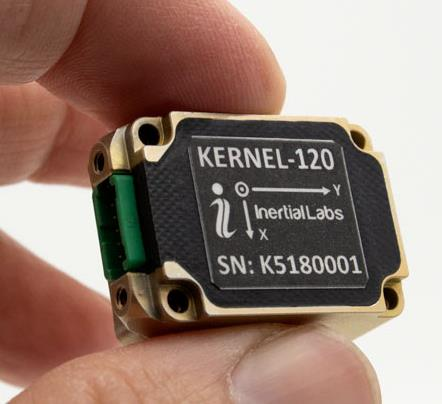
Documents/Datasheet/assets/kernel_img-013.png
