KlaussMarchi/MRU/Documents/Datasheet/assets/kernel_img-014.png

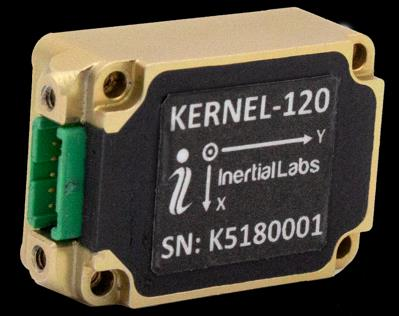
Documents/Datasheet/assets/kernel_img-014.png
