KlaussMarchi/MRU/Documents/Datasheet/assets/kernel_img-015.png

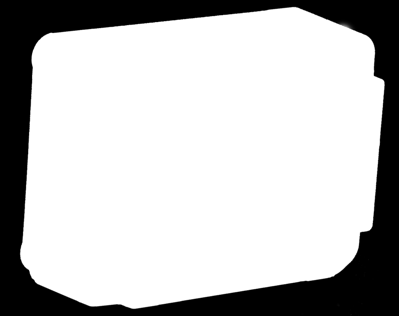
Documents/Datasheet/assets/kernel_img-015.png
