KlaussMarchi/MRU/Documents/Datasheet/assets/kernel_img-020.png

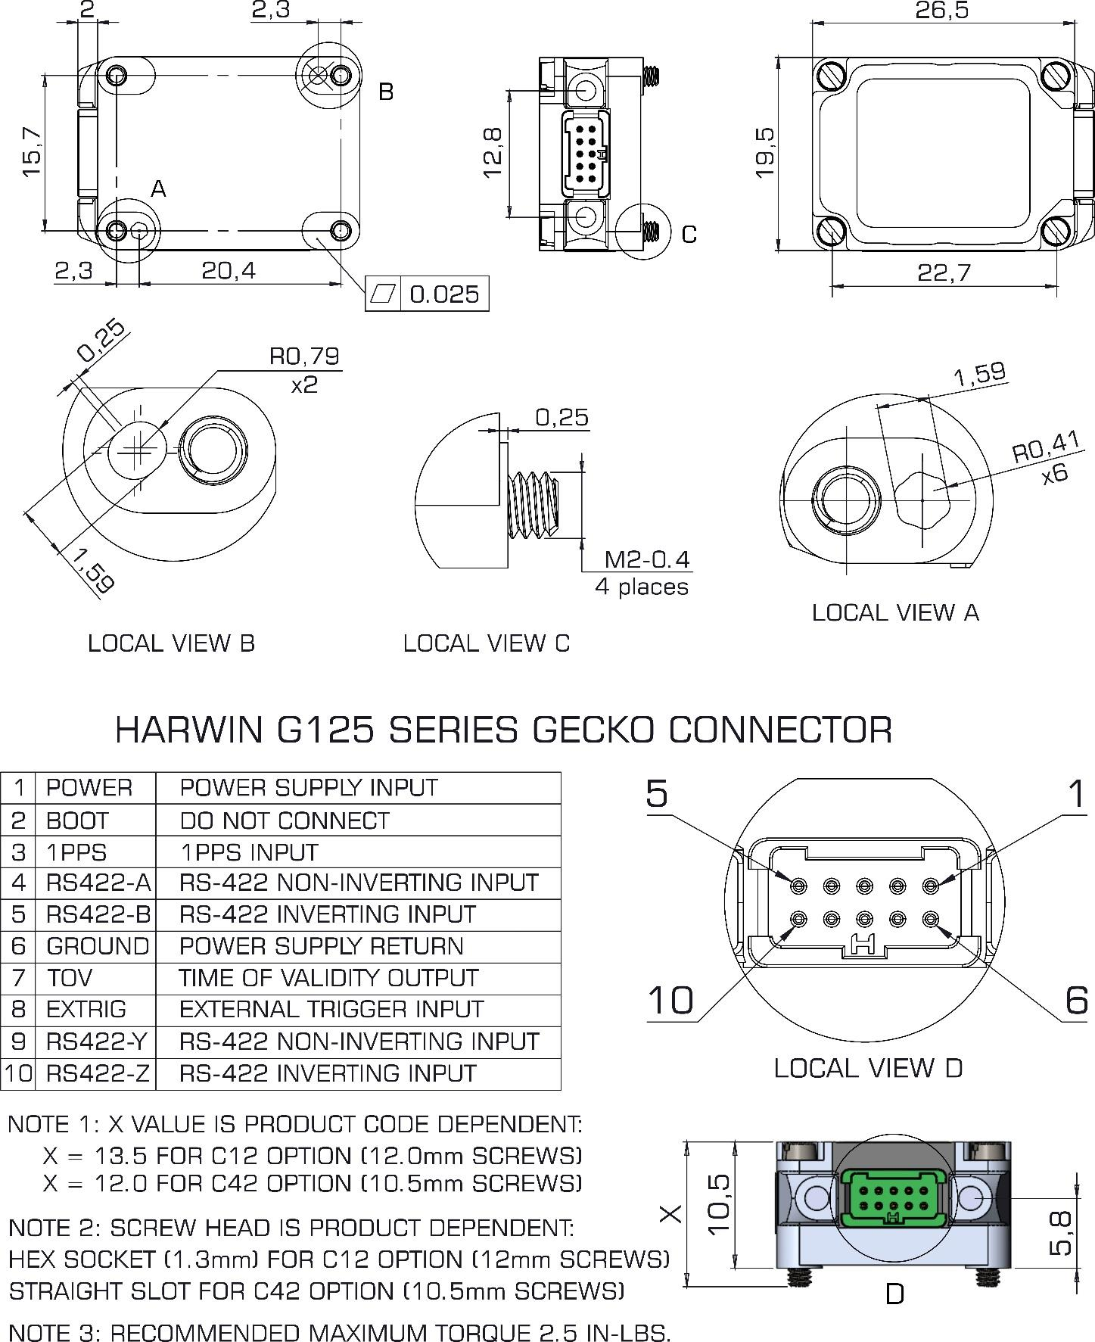
Documents/Datasheet/assets/kernel_img-020.png
