KlaussMarchi/MRU/Documents/Datasheet/assets/lamce.png

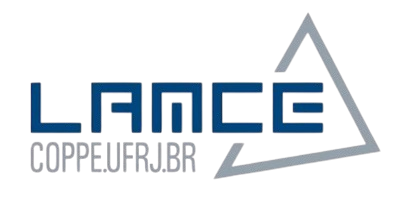
Documents/Datasheet/assets/lamce.png
