KlaussMarchi/MRU/Documents/Datasheet/assets/Screenshot from 2026-05-26 12-46-20.png

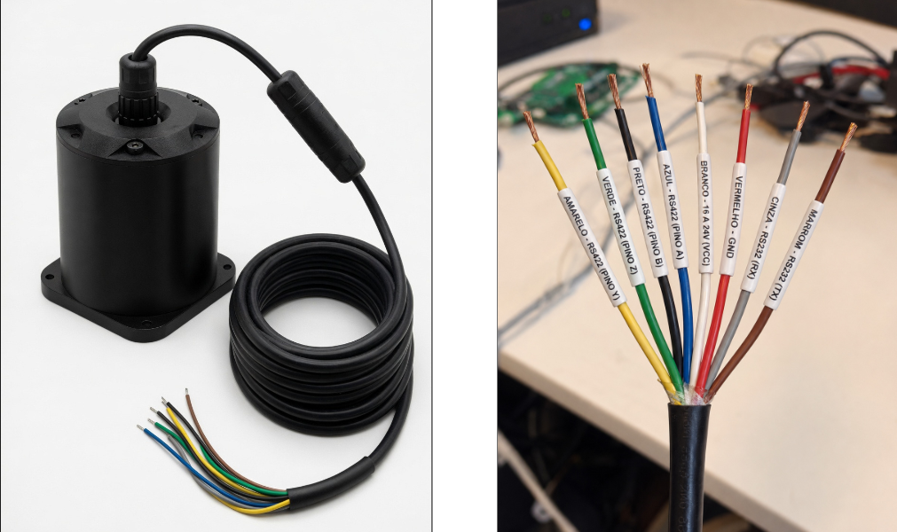
Documents/Datasheet/assets/Screenshot from 2026-05-26 12-46-20.png
