KlaussMarchi/MRU/Katia/Imagem_1.jpeg

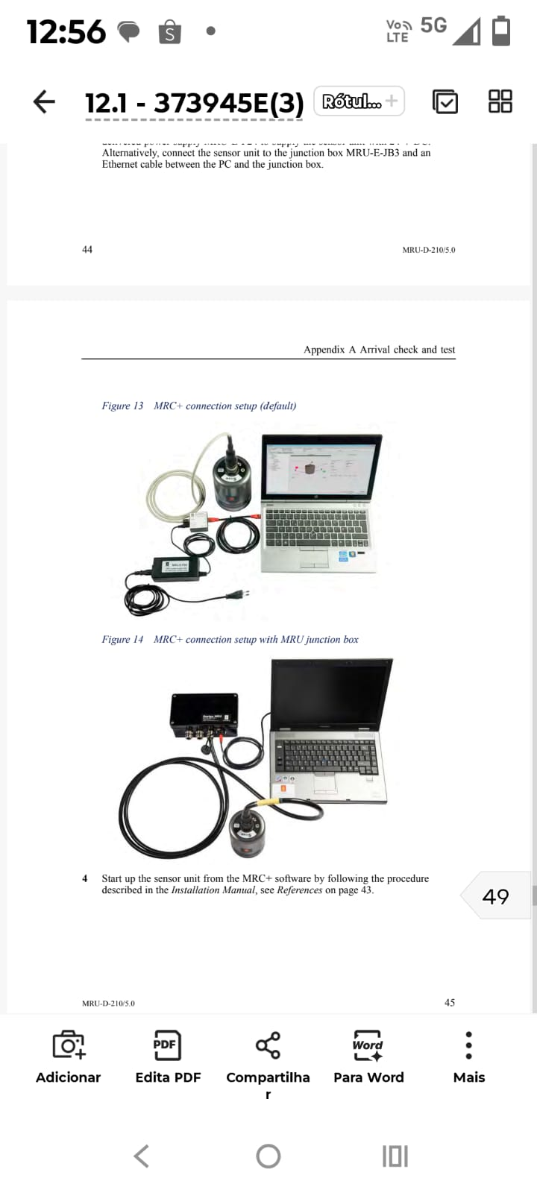
Katia/Imagem_1.jpeg
