KlaussMarchi/MRU/Documents/Management/Patents/DataBase.xlsx

name | label | source | link
BR-102023017079-A2 | Dispositivo de restrição de movimento e sistema de carregamento offshore | Apl Norway As | https://patents.google.com/patent/BR102023017079A2/pt
BR-202023008628-U2 | Disposição construtiva aplicada a barco catamarã desmontável | Lucas Ferreira Da Silva | https://patents.google.com/patent/BR202023008628U2/pt
BR-202023002902-U2 | Disposição construtiva aplicada a barco dobrável | Lucas Ferreira Da Silva | https://patents.google.com/patent/BR202023002902U2/pt
BR-102022026879-A2 | Sistema e dispositivo de guincho, e método para movimentação horizontal de um equipamento submarino | Petróleo Brasileiro S.A. - Petrobras | https://patents.google.com/patent/BR102022026879A2/pt
BR-102022018488-A2 | Armação de filtro para drenagem de convés, e, dispositivo filtrante | Vale S.A. | https://patents.google.com/patent/BR102022018488A2/pt
BR-202022016946-U2 | Disposição construtiva aplicada em búrica para uso em convés de navios e embarcações | Ronaldo Bastos Nascimento | https://patents.google.com/patent/BR202022016946U2/pt
BR-102022008578-A2 | Sistema e métodos de absorção de movimento, sistema de amortecimento de massa sintonizado em combinação com ou configurado para uso em uma plataforma de turbina eólica em alto mar flutuante | University Of Maine System Board Of Trustees | https://patents.google.com/patent/BR102022008578A2/pt
BR-112023018007-A2 | Monitoração da limpeza de uma superfície subaquática de um objeto estacionário | Jotun As | https://patents.google.com/patent/BR112023018007A2/pt
BR-202022004651-Y1 | Disposição aplicada em âncora com bordas de ataque e encaixe cônico | Gustavo Giudice Mardegam | https://patents.google.com/patent/BR202022004651Y1/pt
BR-112023018254-A2 | Método e sistema para controlar uma posição e/ou orientação de uma estrutura alongada | Delta Laboratories Holding B V | https://patents.google.com/patent/BR112023018254A2/pt
BR-102022001500-A2 | Unidade de controle e medição de ondas e método de amostragem e processamento dos dados obtidos | Messenocean Tecnologia Em Meteoceanografia Ltda | https://patents.google.com/patent/BR102022001500A2/pt
BR-102022001122-A2 | Dispositivo de fixação e conexão com ventosas para estabilização de embarcações | Roberto Assis Lo Sardo Filho | https://patents.google.com/patent/BR102022001122A2/pt
BR-202021013482-U2 | Disposição construtiva proporcionada em flutuador modular multiuso | Sinapse Industrial Ltda | https://patents.google.com/patent/BR202021013482U2/pt
BR-202021011519-Y1 | Disposição aplicada em defensa para embarcações e jet skis | Ancora Alfa Industria E Comercio De Artigos Nauticos Ltda | https://patents.google.com/patent/BR202021011519Y1/pt
BR-202021011519-U2 | Disposição aplicada em defensa para embarcações e jet skis | Ramonn Thyago Pinto Machado | https://patents.google.com/patent/BR202021011519U2/pt
BR-202021005092-U2 | Disposição aplicada em capas térmicas para pranchas de surf | Momentum Surf Brasil Artigos Esportivos Ltda | https://patents.google.com/patent/BR202021005092U2/pt
BR-102021001445-A2 | Sistema para o manuseio de uma válvula de segurança anti-erupção e método para a movimentação desta válvula | Innovo Engineering And Construction Limited | https://patents.google.com/patent/BR102021001445A2/pt
BR-112022014068-A2 | Embarcação militar com sensores | Thyssenkrupp Marine Sys Gmbh, Thyssenkrupp Ag | https://patents.google.com/patent/BR112022014068A2/pt
BR-112022010797-A2 | Disposição de instalação de produção offshore | Single Buoy Moorings | https://patents.google.com/patent/BR112022010797A2/pt
BR-102020022563-A2 | Bujão para cascos de embarcações com sensor de abertura/fechamento | Gabriel Gonçalves Silveira Fontes | https://patents.google.com/patent/BR102020022563A2/pt
BR-112022007565-A2 | Estabilizador de giroscópio | Sleipner Motor As | https://patents.google.com/patent/BR112022007565A2/pt
BR-112021022323-A2 | Monitoramento da pressão de compressão de tensores de esteira | Subsea 7 Do Brasil Servicos Ltda | https://patents.google.com/patent/BR112021022323A2/pt
BR-112021022113-A2 | Método e dispositivo de determinação da oscilação | Gaztransport Et Technigaz | https://patents.google.com/patent/BR112021022113A2/pt
BR-112021022217-A2 | Robô, sistema e método para monitoramento e manutenção subaquáticos de um casco de navio | Shipshave As | https://patents.google.com/patent/BR112021022217A2/pt
BR-112021015583-A2 | Método para determinação de um perfil de velocidade de corrente de água em uma coluna de água, e uso do método | Idrop As | https://patents.google.com/patent/BR112021015583A2/pt
BR-112021013852-A2 | Disposição antibioincrustração, unidade antibioincrustação, conjunto de unidades antibioincrustação configuradas para serem usadas em uma disposição antibioincrustação, e método para projetar uma disposição antibioincrustação | Koninklijke Philips N.V. | https://patents.google.com/patent/BR112021013852A2/pt
BR-202019024327-U2 | disposição aplicada em bicicleta aquática | Cibele Grillo Alves, Regiane Cristine Salmoiraghi | https://patents.google.com/patent/BR202019024327U2/pt
BR-202019022932-Y1 | Disposição aplicada em lona retrátil automática para costado de navios | Ademilson Alvares | https://patents.google.com/patent/BR202019022932Y1/pt
BR-202019022932-U2 | disposição aplicada em lona retrátil automática para costado de navios | Ademilson Alvares | https://patents.google.com/patent/BR202019022932U2/pt
BR-112021007354-A2 | método e sistema para monitorar mudanças em um sistema de ancoragem, sistema de processamento de dados, software de computador, e, métodos para monitorar a troca de rigidez da linha de ancoragem, fluência de material e do sistema de tubo ascendente/exportação | Technip France | https://patents.google.com/patent/BR112021007354A2/pt
BR-112021005782-A8 | Sistema para restrição de movimento de amarras em uma ancoragem e carregamento em tandem | Apl Tech As, Apl Norway As | https://patents.google.com/patent/BR112021005782A8/pt
BR-112021003439-A2 | método e dispositivo para a transmissão de dados a bordo de uma embarcação | Thyssenkrupp Marine Systems Gmbh, Thyssenkrupp Ag | https://patents.google.com/patent/BR112021003439A2/pt
BR-112021003519-A2 | disposição de tensionamento de amarração e método para a tensão transversal longitudinal de um sistema de amarração | Kongsberg Maritime CM AS | https://patents.google.com/patent/BR112021003519A2/pt
BR-112020025021-A2 | veículo para o transporte de nós sísmicos, nó sísmico para obter dados sísmicos no leito oceânico e método de carregamento de nós sísmicos no veículo | Magseis Fairfield ASA | https://patents.google.com/patent/BR112020025021A2/pt
BR-112021000236-A2 | Dispositivo e método para levantar um objeto de um convés de um navio sujeito a movimentos | Deme Offshore Be N.V. | https://patents.google.com/patent/BR112021000236A2/pt
BR-112021000244-A2 | Dispositivo e método para levantar um objeto de um convés de um navio sujeito a movimentos | Deme Offshore Be N.V. | https://patents.google.com/patent/BR112021000244A2/pt
BR-102019013799-A2 | Método de medição de posição e sistema para o uso em uma instalação flutuante | Mhwirth As | https://patents.google.com/patent/BR102019013799A2/pt
BR-202019009530-Y1 | Disposição construtiva introduzida em âncora náutica | Rocaankora Brasil Ltda.Me | https://patents.google.com/patent/BR202019009530Y1/pt
BR-112020012420-A2 | sistema e método para transmissão de dados e de energia para veículos subaquáticos em um corpo de água | Saipem S.P.A. | https://patents.google.com/patent/BR112020012420A2/pt
BR-102018071677-A2 | Aquisição sísmica de fonte quádrupla e profundidade tripla | Pgs Geophysical As | https://patents.google.com/patent/BR102018071677A2/pt
BR-202018016601-U8 | Disposição construtiva introduzida em defensa marítima | Maria Zelia Gomes Porto, Jose Francisco Porto Neto | https://patents.google.com/patent/BR202018016601U8/pt
BR-112019021214-A2 | método de aquisição sísmica e sistema de aquisição sísmico | Erik Godoey, Polarcus Dmcc | https://patents.google.com/patent/BR112019021214A2/pt
BR-102018003451-B1 | Sistema de reboque de fonte e método de fabricação de um produto de dados geofísicos | Pgs Geophysical As | https://patents.google.com/patent/BR102018003451B1/pt
BR-202018002254-U2 | Disposição aplicada em equipamento de som para moto aquática | Bruno Vinicius Correa Dantas - Me | https://patents.google.com/patent/BR202018002254U2/pt
BR-112019013191-A2 | disposição para anti-incrustação de uma superfície, estrutura marinha, método para instalar a disposição, e método para operar a disposição | Koninklijke Philips Nv | https://patents.google.com/patent/BR112019013191A2/pt
BR-112019012376-A2 | Sistema para proteção catódica de corrente impressa, disposição de carga, estrutura marinha, método para proteção catódica de corrente impressa de uma estrutura marinha em contato com água, e método de instalação de um sistema | Koninklijke Philips N.V. | https://patents.google.com/patent/BR112019012376A2/pt
BR-112019012362-A2 | Disposição de carga para fornecer energia a cargas sobre uma superfície, estrutura marítima que tem uma superfície a ser exposta a um líquido e método para instalar uma disposição de carga | Koninklijke Philips N.V. | https://patents.google.com/patent/BR112019012362A2/pt
BR-202017023321-U2 | Disposição construtiva em boia com braço de alavanca telescópico | Geraldino Manoel Da Silva, Victor Lacerda Da Silva, Andre Joao Lacerda Da Silva | https://patents.google.com/patent/BR202017023321U2/pt
BR-112019002420-A2 | disposição de emissão de luz, estrutura marítima que tem uma superfície externa, método para instalar uma disposição de emissão de luz, e uso de uma disposição de emissão de luz | Koninklijke Philips Nv | https://patents.google.com/patent/BR112019002420A2/pt
BR-112019008129-A2 | método para atualizar um guindaste articulado e um guindaste de compensação por elevação | Nat Oilwell Varco Norway As | https://patents.google.com/patent/BR112019008129A2/pt
BR-102017018004-A2 | Simulador robótico de perturbações e controle aplicado ao seguimento de trajetórias virtuais de veículos flutuantes e embarcações | Universidade Estadual Do Oeste Do Paraná | https://patents.google.com/patent/BR102017018004A2/pt
BR-112019003683-A2 | método implantado por computador para fazer com que um dispositivo de usuário forneça uma notificação, método implantado por computador para analisar dados de onda, dispositivo eletrônico portátil, sistema configurado para permitir análise de dados de onda e sistema para permitir incorporação de dados de onda em um fluxo de mídia | Surf Sense Devices Pty Ltd | https://patents.google.com/patent/BR112019003683A2/pt
BR-112019001263-B1 | Disposição de emissão de luz, e embarcação | Koninklijke Philips N.V. | https://patents.google.com/patent/BR112019001263B1/pt
BR-112018073537-B1 | Dispositivo para controlar o movimento de uma das extremidades de um braço de carregamento de fluido articulado, dispositivo de aquisição e cálculo de dados, método de cálculo para o dispositivo de cálculo e aquisição de dados e braço de carregamento articulado | Fmc Technologies | https://patents.google.com/patent/BR112018073537B1/pt
BR-202017007150-U2 | disposição introduzida em roda removível para encalhe e desencalhe de barco e afins | José De Fátima Mota | https://patents.google.com/patent/BR202017007150U2/pt
BR-112018070554-A2 | disposição para sistema de amarração de torre | Single Buoy Moorings Inc. | https://patents.google.com/patent/BR112018070554A2/pt
BR-112018017196-A2 | sistema de controle e recuperação de flutuabilida-de variável para aquisição de dados sísmicos | Ion Geophysical Corp | https://patents.google.com/patent/BR112018017196A2/pt
BR-102017002613-A2 | Method and system for simulating maritime activities, as well as a provision that includes the system | Fugro N.V. | https://patents.google.com/patent/BR102017002613A2/pt
BR-112018015847-A2 | sistema de monitoramento do estado de mangueira marinha | The Yokohama Rubber Co., Ltd. | https://patents.google.com/patent/BR112018015847A2/pt
BR-202016030478-U2 | Disposição aplicada em inflável rebocado por embarcação motorizada que permite giro no próprio eixo | Edison Borsatti | https://patents.google.com/patent/BR202016030478U2/pt
BR-112018012650-A2 | disposição de carga, disposição de potência elétrica, sistema, estrutura marinha e uso de uma disposição de carga | Koninklijke Philips Nv | https://patents.google.com/patent/BR112018012650A2/pt
BR-112018013926-A2 | método para atenuar a oscilação de um navio | Psc Engineering S.R.L. | https://patents.google.com/patent/BR112018013926A2/pt
BR-102016029472-A2 | disposição construtiva em esqui aquático e subaquático | Jose Chaves Neto | https://patents.google.com/patent/BR102016029472A2/pt
BR-112018012661-A2 | disposição de carga, disposição de potência elétrica, estrutura marinha e uso de uma disposição de carga | Koninklijke Philips N.V. | https://patents.google.com/patent/BR112018012661A2/pt
BR-202016028896-U2 | Disposição construtiva introduzida em colchão multiuso para pesca | Joga Industria E Comercio De Artigos De Pesca E Lazer Ltda | https://patents.google.com/patent/BR202016028896U2/pt
BR-112018008683-A2 | ?âncora com provisão de ajuste de ângulo? | Stevlos Bv | https://patents.google.com/patent/BR112018008683A2/pt
BR-112018005457-A2 | peptídeo cíclico, composição cosmética ou dermatológica, e, loção para os olhos. | Assistance Publique - Hopitaux De Paris, Universite Paris Descartes, Inserm Paris, Centre National De La Recherche Scientifique | https://patents.google.com/patent/BR112018005457A2/pt
BR-112017019321-A2 | composição de revestimento anticorrosivo e método para formar filme de revestimento seco | Nippon Paint Marine Coatings Co Ltd | https://patents.google.com/patent/BR112017019321A2/pt
BR-112017019517-B1 | Composição de tinta anticorrosiva, película de revestimento obtida a partir da mesma e navio ou estrutura marítima provido(a) de tal revestimento | Nippon Paint Marine Coatings Co., Ltd | https://patents.google.com/patent/BR112017019517B1/pt
BR-112018001167-B1 | Sistema de monitoramento e método para amarração de embarcação | Technip France | https://patents.google.com/patent/BR112018001167B1/pt
BR-112017028258-B1 | Disposição de mancal para uma roda de rolamento em uma torre, sistema de rolamento para uma torre, torre, embarcação e método para montar uma disposição de mancal | National Oilwell Varco Norway As | https://patents.google.com/patent/BR112017028258B1/pt
BR-102016014831-A8 | compensação de movimento para o movimento relativo entre um objeto conectado a um navio e um objeto na água | Pgs Geophysical As | https://patents.google.com/patent/BR102016014831A8/pt
BR-112017018078-A2 | monitoramento e previsão de desempenho em tempo real de guincho de perfuração compensado por movimento marítimo | Transocean Sedco Forex Ventures Ltd | https://patents.google.com/patent/BR112017018078A2/pt
BR-112017011149-A2 | disposição de apoio de ancoragem | Cefront Tech As | https://patents.google.com/patent/BR112017011149A2/pt
BR-102015028909-A2 | sistema e dispositivo de impulsão e estabilidade de veleiro | Francisco Cortes Chaves Manoel | https://patents.google.com/patent/BR102015028909A2/pt
BR-112017003827-A2 | sistema de compensação de sustentação para um elemento encaixado em uma instalação móvel | Ifp Energies Now | https://patents.google.com/patent/BR112017003827A2/pt
BR-112017003987-B1 | Sistema e método de notificação de posição de carregamento de produto de placa, e meio de armazenamento legível por computador não transitório | Jfe Steel Corporation | https://patents.google.com/patent/BR112017003987B1/pt
BR-102015018863-A2 | dispositivo para compensar movimentos de balouço entre um dispositivo de elevação e uma carga elevada pelo dispositivo de elevação | Ernst B Johansen As | https://patents.google.com/patent/BR102015018863A2/pt
BR-102015018862-A2 | dispositivo de compensação de hasteamento, e, método para regular o comprimento de curso disponível | Ernst B Johansen As | https://patents.google.com/patent/BR102015018862A2/pt
BR-102015012834-A2 | Remote control and vessel monitoring system via cell phone and congenie | Nogueira Novaes Decio | https://patents.google.com/patent/BR102015012834A2/pt
BR-112016025021-A2 | ?embarcação de instalação de tubulação, e, método de disposição de carretel marinho? | Itrec Bv | https://patents.google.com/patent/BR112016025021A2/pt
BR-112015023911-A2 | método de integração de bloco estrutural recém-construído e apêndices com portador lng existente | Keppel Offshore & Marine Tech Ct Pte Ltd | https://patents.google.com/patent/BR112015023911A2/pt
BR-112017018609-A2 | método de movimentação de carga | Shibakai Co Ltd | https://patents.google.com/patent/BR112017018609A2/pt
BR-102014029836-A2 | banco para passageiro com estrutura com parte e posição ajustável | Eads Sogerma | https://patents.google.com/patent/BR102014029836A2/pt
BR-202014025167-U2 | disposição introduzida em prancha flutuante bi-partida | Thiago Garcia | https://patents.google.com/patent/BR202014025167U2/pt
BR-112016006510-B1 | Sistema para monitoramento de uma localização submarina remota | Saab Seaeye Limited | https://patents.google.com/patent/BR112016006510B1/pt
BR-112016002576-A2 | estabilização de um tubo de coluna ascendente | Propocean As | https://patents.google.com/patent/BR112016002576A2/pt
BR-202014018054-U2 | disposição construtiva aplicada a capa para pranchas de surf com tamanho ajustável por elasticidade | Lucio Alberto De Carvalho Baptista Neto | https://patents.google.com/patent/BR202014018054U2/pt
BR-112015029951-A2 | disposição a ser usada para recuperar uma cabeça de assentamento, sistema e método para recuperar uma cabeça de assentamento | Vetco Gray Scandinavia As | https://patents.google.com/patent/BR112015029951A2/pt
BR-112015026683-B1 | Método e sistema para manter de modo dinâmico uma distância d entre uma embarcação flutuante e uma embarcação flutuante ancorada a uma torre, e embarcação flutuante para seguir movimentos de guinada de uma embarcação flutuante ancorada a uma torre | Keppel Offshore & Marine Technology Centre Pte Ltd | https://patents.google.com/patent/BR112015026683B1/pt
BR-112015026577-A2 | composição de revestimento anti-incrustante, película de revestimento anti-incrustante, substrato anti-incrustante e método para produzir substrato anti-incrustante | Chugoku Marine Paints | https://patents.google.com/patent/BR112015026577A2/pt
BR-102014009380-A2 | Interruptor de sensor ativado por profundidade e método | Sercel Inc | https://patents.google.com/patent/BR102014009380A2/pt
BR-112015022756-A2 | flutuador, veículos acionado por onda e aéreo não tripulado, e, método para monitorar uma embarcação que está flutuando na água | Liquid Robotics Inc | https://patents.google.com/patent/BR112015022756A2/pt
BR-112015017644-B1 | Compensador passivo submarino de efeito de onda e método de fornecer compensação variável para tal compensador | Technip N-Power | https://patents.google.com/patent/BR112015017644B1/pt
BR-112015016675-A2 | uma embarcação, uma plataforma de movimento, um sistema de controle, um método para compensar movimentos de uma embarcação e um produto de programa de computador | Ampelmann Operations B V | https://patents.google.com/patent/BR112015016675A2/pt
BR-112015016782-A2 | unidade flutuante e método para reduzir movimentos de suspiro e a inclinação / rotação de uma unidade flutuante | Moss Maritime As | https://patents.google.com/patent/BR112015016782A2/pt
BR-202013028855-U2 | disposição introduzida em prancha de stand up | Work Station Comércio De Peças Ltda Me | https://patents.google.com/patent/BR202013028855U2/pt
BR-202013028106-U2 | disposição introduzida em marina seca flutuante com comporta frontal | Rafael Luis Molon | https://patents.google.com/patent/BR202013028106U2/pt
BR-112015011483-A2 | aparelho para montar ou desmontar um sensor de cápsula, método para a fixação de cápsulas de sensores para um cabo sísmico de correr numa embarcação e método para separar as cápsulas do sensor de um cabo sísmico de correr sobre uma embarcação durante a recuperação do cabo sísmico do mar numa bobina | Magseis As | https://patents.google.com/patent/BR112015011483A2/pt
BR-202013026522-U2 | Disposição aplicada em quilha para prancha de surf | Pedro Luiz Ribeiro Mazzei | https://patents.google.com/patent/BR202013026522U2/pt
BR-112015003640-B1 | Método e disposição para obter ancoragem de navio | Stena Rederi Ab | https://patents.google.com/patent/BR112015003640B1/pt
BR-112014032799-A2 | plataforma semi-submersível com viga de contraventamento estabilizadora, e central de energia a partir de ondas em alto mar, integrando essa plataforma | Jose antonio ruiz diez | https://patents.google.com/patent/BR112014032799A2/pt
BR-202013016050-U2 | disposição introduzida em engate articulado para reboque de embarcação | Alexandre Gonçalves Mello, Romeu Filho Bruno, Victor Marsaioli Doneux | https://patents.google.com/patent/BR202013016050U2/pt
BR-202013016049-U2 | disposição introduzida em embarcação rebocada para remediação de acidentes ecológicos | Alexandre Gonçalves Mello, Romeu Filho Bruno, Victor Marsaioli Doneux | https://patents.google.com/patent/BR202013016049U2/pt
BR-102013013689-A2 | aparelho de tensionamento e compensação de movimento e método de uso do mesmo | Icon Engineering Pty Ltd | https://patents.google.com/patent/BR102013013689A2/pt
BR-112014031667-B1 | Plataforma offshore flutuante, e, método de estabilizar uma plataforma offshore flutuante | Technip France | https://patents.google.com/patent/BR112014031667B1/pt
BR-102013011921-B1 | Método e sistema de recuperação para cordões de sensores de pesquisa geofísica marinha | Pgs Geophysical As | https://patents.google.com/patent/BR102013011921B1/pt
BR-202013011386-U2 | Disposição construtiva aplicada em bolha inflável para recreação aquática | Lucas Stegmann | https://patents.google.com/patent/BR202013011386U2/pt
BR-112015026171-A2 | aleta estabilizadora, e, sistema estabilizador de aleta ativo | Skauen Ronny | https://patents.google.com/patent/BR112015026171A2/pt
BR-112014024824-A2 | Aparelho, disposição e método para bloquear uma escotilha submersa ou outra estrutura removível | Beacon Finland Ltd Oy | https://patents.google.com/patent/BR112014024824A2/pt
BR-112014024095-A8 | Bobina de cabrestante para transportar um artigo alongado, método de controlar o movimento de um artigo alongado e embarcação para assentamento e recuperação de um artigo alongado | Kongsberg Oil & Gas Tech As, Parkburn Whistleberry Ind Estate, Parkburn Prec Handling Systems Limited | https://patents.google.com/patent/BR112014024095A8/pt
BR-102013006421-A2 | Defletor para sistema de aquisição de dados marinhos | Cggveritas Services Ag | https://patents.google.com/patent/BR102013006421A2/pt
BR-112014008144-B1 | Disposição de propulsão retrátil, embarcação que compreende a disposição de propulsão retrátil, e método para manutenção de um acionador de hélice disposto em um receptáculo de propulsão de uma disposição de propulsão retrátil em uma embarcação | Beacon Finland Ltd Oy | https://patents.google.com/patent/BR112014008144B1/pt
BR-112014020276-A8 | Cabeça de suspiro compreendendo uma primeira abertura em comunicação fluida com o ar aberto envolvendo a cabeça de suspiro, uma segunda abertura em comunicação fluida com um tanque fechado, em que uma cavidade dentro da cabeça de suspiro está provendo comunicação fluida controlada entre a primeira abertura e a segunda abertura dependendo de uma posição dentro da cavidade de um corpo flutuante, e corpo flutuante para uso em uma cabeça de suspiro | John Gjerde As | https://patents.google.com/patent/BR112014020276A8/pt
BR-102013003607-A2 | Dispositivo de controle para controlar a posição de um cabo instrumentado rebocado em água | Kongsberg Seatex As | https://patents.google.com/patent/BR102013003607A2/pt
BR-112014017319-A8 | método para conduzir um levantamento sísmico marinho usando uma técnica de fonte simultânea tendo sequências de disparo nss, sistema de levantamento sísmico marinho, sistema de processamento para processar | Geco Technology Bv | https://patents.google.com/patent/BR112014017319A8/pt
BR-112014011527-A2 | composição de revestimento anti-incrustante, filme de revestimento anti-incrustante e substrato anti-incrustante, e método para produzir substrato anti-incrustante | Chugoku Marine Paints | https://patents.google.com/patent/BR112014011527A2/pt
BR-112014011177-A2 | disposição de fonte sísmica marinha orientável e rebocável | Fugro Geoteam As | https://patents.google.com/patent/BR112014011177A2/pt
BR-112014010167-B1 | Método para amortecimento de movimentos de balanço de um navio no mar e dispositivo para um tanque de amortecimento de balanço em um navio | Eirik Hellesvik | https://patents.google.com/patent/BR112014010167B1/pt
BR-202012025412-U2 | Disposição aplicada em bicicleta flutuadora aquática | Clemente Martinez | https://patents.google.com/patent/BR202012025412U2/pt
BR-112014004439-A2 | aparelhos para prover uma indicação da adequação de condições da águia e para prover dados representando uma previsão da adequação de condições da água, e, método para determinar ou prever a adequadação das condições da água | Bae Systems Plc | https://patents.google.com/patent/BR112014004439A2/pt
BR-112013033719-B1 | Navio de perfuração tendo bloco de supressão de vórtice com uma seção de estabilização de fluxo fendida em uma piscina | Hyundai Heavy Industries Co., Ltd. | https://patents.google.com/patent/BR112013033719B1/pt
BR-112014000562-B1 | Navio, montagem de um navio e uma massa, dispositivo de amortecimento, método de estabilizar uma massa ou um navio | Heerema Marine Contractors Nederland Se | https://patents.google.com/patent/BR112014000562B1/pt
BR-112014003938-A2 | sistema, dispositivo e método para rastrear posição e orientação de veículo, dispositivo de carregamento e carga em operações de dispositivo de carregamento | Optilift As | https://patents.google.com/patent/BR112014003938A2/pt
BR-112013024762-A2 | embarcação, sistema e método para deposição de uma tubulação, e, uso de uma embarcação para deposição de uma tubulação | Heerema Marine Contractors Nederland S E | https://patents.google.com/patent/BR112013024762A2/pt
BR-112013020888-A2 | sistema e método de compensação de balouço ativo, e, embarcação | Itrec Bv | https://patents.google.com/patent/BR112013020888A2/pt
BR-102012002375-B1 | Disposição construtiva introduzida em bicicleta aquática com meio de propulsão híbrido | Antonio José De Oliveira Costa | https://patents.google.com/patent/BR102012002375B1/pt
BR-112013018704-A2 | corpo flutuante anular, e, processo de extinção pelo menos parcial de um movimento de balouço de um corpo flutuante na água | Ideol | https://patents.google.com/patent/BR112013018704A2/pt
BR-MU9102587-U2 | disposição construtiva aplicada na fabricação, transporte e montagem da estrutura de draga de sucção de areia e outros minerais | Pauluci Com De Ferragens Ltda Epp | https://patents.google.com/patent/BRMU9102587U2/pt
BR-112013011061-B1 | Estrutura fora da costa flutuante semissubmersível com movimento induzido por vórtice (vim) melhorado, e, método de melhorar o movimento induzido por vórtice de uma estrutura fora da costa semissubmersível flutuante | Technip France | https://patents.google.com/patent/BR112013011061B1/pt
BR-112013010752-A2 | sistema de comunicação de dados de âncora | Brupat Ltd | https://patents.google.com/patent/BR112013010752A2/pt
BR-112012033454-A2 | aparelho de redução de oscilação, e, estrutura flutuante | Mitsubishi Heavy Ind Ltd | https://patents.google.com/patent/BR112012033454A2/pt
BR-112013003365-A2 | embarcação, plataforma de movimento, sistema de controle, método para compesação de movimentos de uma embarcação e produto de programa de computador | Ampelmann Operations B V | https://patents.google.com/patent/BR112013003365A2/pt
BR-112012033781-A2 | refletor acústico, montagem de barra para um refletor acústico, e, método para monitorar o alcance efetivo de um sistema de detecção de sonar | Subsea Asset Location Tech Ltd | https://patents.google.com/patent/BR112012033781A2/pt
BR-112012028739-A2 | método de deposição de tubulação de um navio de deposição sobre o leito de um corpo d'água e navio de deposição | Saipem Spa | https://patents.google.com/patent/BR112012028739A2/pt
BR-PI1101694-A2 | sistema e método para gerenciar a pressão de oscilação de uma plataforma flutuante | Weatherford Lamb | https://patents.google.com/patent/BRPI1101694A2/pt
BR-112012024447-A2 | supressão de ruído por regulagem de velocidade adaptativo de streamer geofísico marinho rebocado | Pgs Geophysical As | https://patents.google.com/patent/BR112012024447A2/pt
BR-112012023993-A2 | composição de revestimento anti-incrustante e usos da mesma | Chugoku Marine Paints | https://patents.google.com/patent/BR112012023993A2/pt
BR-PI1100247-A2 | Dispositivo de interrupção de movimento de corrente | Aker Pusnes As | https://patents.google.com/patent/BRPI1100247A2/pt
BR-112012009277-A2 | método para determinar correção sob direção de um ponto em um objeto rebocado em direção a uma posição alvo | Geograf As | https://patents.google.com/patent/BR112012009277A2/pt
BR-112012008867-A2 | aparato para movimentação de contêineres | Australian Mobile Mining Equipment Systems And Accessories Pty Ltd | https://patents.google.com/patent/BR112012008867A2/pt
BR-PI1007176-A2 | método e sistema para modelar acelerações angulares de uma embarcação | Kongsberg Seatex As | https://patents.google.com/patent/BRPI1007176A2/pt
BR-112012004130-B1 | sistema de catamarã para instalar topsides sobre uma estrutura fora da costa, e, método para estabilizar um sistema de catamarã tendo pelo menos duas barcaças flutuantes | Technip France | https://patents.google.com/patent/BR112012004130B1/pt
BR-112012001019-A2 | sistema ecológico dinâmico e autônomo de angulação e deslizamento do barco por meio de alteração do fluxo de água no casco | Triantafyllis Ltd N | https://patents.google.com/patent/BR112012001019A2/pt
BR-PI1010834-A2 | navio ou suporte flutuante equipado com um dispositivo de detecção dos movimentos de carenas líquidas | Saipem Sa | https://patents.google.com/patent/BRPI1010834A2/pt
BR-PI1001329-A2 | estrutura naval com dispositivos de propulsão azimutal | Daewoo Shipbuilding & Marine | https://patents.google.com/patent/BRPI1001329A2/pt
BR-112012018510-A2 | prevenção de dados em cabos submarinos e elementos similares durante instalação ou recuperação | Octio Geophysical As | https://patents.google.com/patent/BR112012018510A2/pt
BR-PI0921030-A2 | navio ou suporte flutuante equipado com um dispositivo de atenuação dos movimentos de carenas líquidas | Gaztransport Et Technigaz | https://patents.google.com/patent/BRPI0921030A2/pt
BR-MU8901209-U2 | disposição construtiva introduzida em prancha de surf | Gualton Remo Sousa Leca | https://patents.google.com/patent/BRMU8901209U2/pt
BR-PI0911567-A8 | plataforma marítima estabilizada por colunas, com placas para aprisionamento de água e sistéma de amarração assimétrica para suporte de turbina eólicas offshore | Principle Power Inc | https://patents.google.com/patent/BRPI0911567A8/pt
BR-PI0924943-B1 | Dispositivo de compensação de movimento, conjunto, e, método para compensar a estrutura de suporte em uma embarcação para movimento de água local | Barge Master Ip B.V. | https://patents.google.com/patent/BRPI0924943B1/pt
BR-PI0909200-B1 | sistema e método de compensação ativa de balouço. | Itrec Bv | https://patents.google.com/patent/BRPI0909200B1/pt
BR-PI0907373-A2 | Disposição para fixação de um leme de navio a um eixo de leme, um de leme, um leme de navio e um método para desmontagem de um leme de navio de um eixo de leme | Rolls Royce Marine As | https://patents.google.com/patent/BRPI0907373A2/pt
BR-PI0821888-B1 | Dispositivo de controle para controlar a posição de um cabo instrumentalizado rebocado na água | Kongsberg Seatex As | https://patents.google.com/patent/BRPI0821888B1/pt
BR-PI0821169-A2 | Sistema para estabilização ativa e passiva de uma embarcação, e, métodos para estabilização ativa de uma embarcação e para estabilização passiva de uma embarcação | Marine Roll & Pitch Control As | https://patents.google.com/patent/BRPI0821169A2/pt
BR-PI0818768-A2 | Âncora para amarrar uma embarcação, sistema de amarração para prender uma embarcação em posição pelo fundo do mar, e, método para amarrar uma embarcação pelo fundo do mar. | Horton Deepwater Dev Systems Inc | https://patents.google.com/patent/BRPI0818768A2/pt
BR-PI0803619-A2 | sistema de execução simultánea de operações em sonda marìtima e método | Petroleo Brasileiro Sa | https://patents.google.com/patent/BRPI0803619A2/pt
BR-PI0816914-A2 | Método de compensação de elevação | Nat Oilwell Varco Norway As | https://patents.google.com/patent/BRPI0816914A2/pt
BR-PI0810706-A2 | Produtos rotacionalmente moldados e moldes. | Charles Caulder Bree | https://patents.google.com/patent/BRPI0810706A2/pt
BR-PI0716356-A2 | """dispositivo de acionamento flutuante, sistema para a conversço da energia das ondas, mÉtodo para extrair energia a partir do movimento de ondas, mÉtodo para variar uma propriedade hidrodinÂmica de um dispositivo de acionamento flutuante, mÉtodo para operar um dispositivo de conversço de energia de ondas"" " | Seapower Pacific Pty Ltd | https://patents.google.com/patent/BRPI0716356A2/pt
BR-PI0716939-B1 | Sistema e método para supressão de movimento de estrutura flutuante | Shell Internationale Research Maatschappij B.V. | https://patents.google.com/patent/BRPI0716939B1/pt
BR-PI0705685-A2 | sistema de monitoração e controle remoto de embarcações | Silva Leonardo Senna Da | https://patents.google.com/patent/BRPI0705685A2/pt
BR-PI0716661-B1 | Aparelho e método para prover compensação de levantamento para uma carga suspensa de uma extremidade de um cabo em um ambiente marinho, com a outra extremidade do cabo. | Hydralift Amclyde, Inc. | https://patents.google.com/patent/BRPI0716661B1/pt
BR-PI0721894-A2 | submarino de finalidade geral tendo elevada capacidade de velocidade em superfÍcie | Marion Hyper Submersible Powerboat Design Llc | https://patents.google.com/patent/BRPI0721894A2/pt
BR-PI0712434-A2 | sistema para compensação de levantamento ativo e uso do mesmo | Nat Oilwell Norway As | https://patents.google.com/patent/BRPI0712434A2/pt
BR-PI0711897-A2 | trava de movimento para carrinho de compras | Horst Sonnendorfer, Franz Wieth | https://patents.google.com/patent/BRPI0711897A2/pt
BR-PI0708432-A2 | navio com uma plataforma de compensação de movimento, plataforma de movimento, métodos para compensar movimentos de um navio e para movimentar uma plataforma de stewart e uso de uma plataforma de stewart | Technische Universiteit Delft | https://patents.google.com/patent/BRPI0708432A2/pt
BR-PI0707129-B1 | Estabilizador de rolo giroscópico e aparelho de resfriamento para transferir calor de e resfriar um ou mais componentes de geração de calor | Seakeeper, Inc. | https://patents.google.com/patent/BRPI0707129B1/pt
BR-PI0605497-A | disposição construtiva aplicada a áncora marìtima ou fluvial para embarcações, máquinas, equipamentos ou elementos flutuantes | Poiraud Alain Auguste Jean Leo | https://patents.google.com/patent/BRPI0605497A/pt
BR-MU8602716-U | disposição construtiva em acessório para permitir manobras radicais com equipamentos esportivos | Eduardo Maynart Wisniewski | https://patents.google.com/patent/BRMU8602716U/pt
BR-PI0620016-A2 | embarcação marìtima processo para distribuir uma composição anti-incrustação a uma superfìcie subaquática de uma embarcação marìtma, e, sistema para distribuir uma composição anti - incrustação | Conocophillips Co | https://patents.google.com/patent/BRPI0620016A2/pt
BR-PI0621747-A2 | compensador de movimento de arfagem, compensador para coluna de perfuraÇço flutuante, sistemas de compensaÇço de arfagem, de movimentaÇço de carga a bordo de navio, de perfuraÇço flutuante e de diagrafia a cabo, navio e mÉtodo para compensaÇço de movimento de arfagem | Itrec Bv | https://patents.google.com/patent/BRPI0621747A2/pt
BR-PI0607193-A2 | disposição de alojamentos, navio, edifìcio e método para construir a disposição de alojamentos em um local de instalação | Shippax Ltd Oy | https://patents.google.com/patent/BRPI0607193A2/pt
BR-PI0606452-A2 | suporte flutuante estabilizado | D2M Consultants S A | https://patents.google.com/patent/BRPI0606452A2/pt
BR-PI0520763-A2 | embarcação de alta velocidade adequada para condições de água turbulenta | Thomas Wilmot Meyer | https://patents.google.com/patent/BRPI0520763A2/pt
BR-PI0520496-A2 | embarcação para manipular equipamento submarino, conjunto de trilhos, equipamento submarino para uso com uma embarcação, sistema de limitação e guiamento de movimento de equipamento submarino, e, método para abaixar e recuperar equipamento submarino | Itrec Bv | https://patents.google.com/patent/BRPI0520496A2/pt
BR-MU8503126-U | pequeno barco hidrociclo de alta velocidade com dois assentos | Zakrytoe Aktsionernoe Obshestv | https://patents.google.com/patent/BRMU8503126U/pt
BR-PI0514142-A | sistema de ancoragem para uma instalação marinha de superfìcie suscetìvel de ser arrastada em movimento segundo uma freqüência elevada em relação ao fundo do mar, e, bóia marinha de carregamento | Technip France | https://patents.google.com/patent/BRPI0514142A/pt
BR-PI0405808-A | medição de velocidade de prancha de surf por extensÈmetros | Salvador Francisco Tirloni, Avelino Arantes Bastos | https://patents.google.com/patent/BRPI0405808A/pt
BR-PI0405292-A | sistema hìbrido de manutenção de posição de unidades flutuantes | Projemar Estudos E Projetos De | https://patents.google.com/patent/BRPI0405292A/pt
BR-PI0418958-A8 | "Sistema de supressão de oscilação, aparelho ""offshore"" de águas profundas para utilização em perfuração e produção de petróleo e aparelho para minimizar movimentos de cabeceio, arfagem e balanço de uma estrutura ""offshore"" flutuante " | Seahorse Equip Corp, Single Buoy Moorings | https://patents.google.com/patent/BRPI0418958A8/pt
BR-PI0415128-A | aparelho e método para reduzir o movimento de um vaso flutuante | Saipem U K Ltd | https://patents.google.com/patent/BRPI0415128A/pt
BR-PI0408057-A | método para ancorar um perfurador flutuante de hidrocarboneto ou uma embarcação flutuante a uma pluralidade de tendões, método para instalação de uma embarcação costeira flutuante, disposição para instalação de uma embarcação costeira flutuante e método de instalação de tendão | Modec International L L C | https://patents.google.com/patent/BRPI0408057A/pt
BR-0300620-A | Dispositivo de aquisição de dados para medição de parâmetros em prancha de surf | Salvador Francisco Tirloni, Avelino Arantes Bastos | https://patents.google.com/patent/BR0300620A/pt
BR-0307770-A | Traçado de linhas e disposição de propulsão para um navio de alto-mar, de curso estável, com propulsão por hélices-lemes | Siemens Ag, Ct Techniki Okretowej Ship Des, Seatrade As | https://patents.google.com/patent/BR0307770A/pt
BR-0106598-A | Sistema telemétrico para aquisição, transmissão, armazenamento e informação de dados de pranchas de surfe e/ou windsurf, kitesurf, wakeboard ou bodyboard | Avelino Arantes Bastos, Salvador Francisco Tirloni | https://patents.google.com/patent/BR0106598A/pt
BR-0114429-B1 | aparelhos para suportar as extremidades superiores dos tubos ascendentes do casco de vergÈntea, para suportar os tubos ascendentes do casco de vergÈntea, para suspender e tracionar um tubo ascendente de uma superfìcie associada ao casco de vergÈntea e para permitir movimentação rotativa limitada entre o tubo ascendente e a superfìcie, e, método para suportar um tubo ascendente em um casco de vergÈntea flutuante. |  | https://patents.google.com/patent/BR0114429B1/pt
BR-8101826-U | Sistema de quilha de encaixe com quilhas removìveis com multiplas opções de regulagens com diversos angulos | Garcia Antonio | https://patents.google.com/patent/BR8101826U/pt
BR-0109897-A | Veìculo submarino autÈnomo e método para lançar um conjunto de cabos e sensores no fundo do oceano usando um veìculo submarino autÈnomo | Westerngeco Seismic Holdings | https://patents.google.com/patent/BR0109897A/pt
BR-0100653-A | Embarcação semi-submersìvel de movimento de curso de elevação suave | Gva Consultants Ab | https://patents.google.com/patent/BR0100653A/pt
BR-0016824-A | Método e dispositivo para transportar o carretel, convés, e, disposição do convés no espaço de carga do navio | Oy Langh Ship Ab | https://patents.google.com/patent/BR0016824A/pt
BR-0017171-A | Aparelho para lançar um objeto a uma posição alvo subquática, arranjo de processamento, navio, sistema subaquático, método de acionar um aparelho para lançar um objeto a uma posição alvo subaquática, produto de programa de computador, e, portador de dados | Francois Bernard | https://patents.google.com/patent/BR0017171A/pt
BR-0001002-A | Processo para dimensionamento de uma estrutura elástica submetida a um fluido em movimento | Inst Francais Du Petrole | https://patents.google.com/patent/BR0001002A/pt
BR-9912323-A | Embarcações e métodos de deposição de tubos submarinos | Saipem Spa | https://patents.google.com/patent/BR9912323A/pt
BR-9908216-A | Disposição para transferência de carga, especialmente para fluidos de petróleo, entre duas embarcações no mar | Navion As | https://patents.google.com/patent/BR9908216A/pt
BR-9813593-A | Dispositivo para movimentação de um objeto alongado, e, embarcação de perfuração ou plataforma de perfuração | Huisman Spec Lifting Equip Bv | https://patents.google.com/patent/BR9813593A/pt
BR-9804508-A | Método de simulação e aparelho para envolvimento de bolha de navio e meio de memória legível por computador com programa de simulação | Ishikawajima Harima Heavy Ind, Hiroharu Kato | https://patents.google.com/patent/BR9804508A/pt
BR-9810166-A | Sistema de transferência com absorção de movimento | Pevatec As | https://patents.google.com/patent/BR9810166A/pt
BR-9815558-A | Aparelho para estabilização de embarcação | Benny Gaber | https://patents.google.com/patent/BR9815558A/pt
BR-9801424-A | Sistema de orientação elasticamente ativa entre corpos estruturais em movimento relativo | Tecnomare Spa | https://patents.google.com/patent/BR9801424A/pt
BR-9808948-A | Composição de confeitaria | Procter & Gamble | https://patents.google.com/patent/BR9808948A/pt
BR-9714697-A | Disposição para montagem de expurgador para um sistema de ancoragem | Fmc Corp | https://patents.google.com/patent/BR9714697A/pt
BR-9705431-A | Estabilizador passivo para sistemas flutuantes de produção de petróleo | Petroleo Brasileiro Sa | https://patents.google.com/patent/BR9705431A/pt
BR-9703420-A | Método e aparelho para transporte de fluidos entre dois corpos sujeitos a um movimento rotativo relativo | Tcnomare S P A | https://patents.google.com/patent/BR9703420A/pt
BR-9707447-A | Elevadores flexíveis com armação estabilizadora | Petroleum Geo Services As | https://patents.google.com/patent/BR9707447A/pt
BR-9611680-A | Rebocadortendo unidades propulsoras azimutais | Sacar Holding Nv | https://patents.google.com/patent/BR9611680A/pt
BR-9612117-A | Dispositivo amortecedor para amortecer a componente de movimento vertical de um estrutura flutuante | Fred Olsen | https://patents.google.com/patent/BR9612117A/pt
BR-9608089-A | Aparelhos para produção de dados de medição suscetíveis de caracterizar uma trajetória de enterramento traçada em um solo no fundo do mar para estabelecimento e caracterização de uma trajetória de enterramento no solo do fundo do mar e para avaliação de leito de atracação e processo para produção de dados para avaliação da ancorabilidade de um solo no fundo do mar em um leito de atracação marítimo | Brupat Ltd | https://patents.google.com/patent/BR9608089A/pt
BR-9607010-A | Deslizador para movimentos de pessoas animais ou objetos | Peder Bergh, Geir Kroken | https://patents.google.com/patent/BR9607010A/pt
BR-9509584-A | Disposição em uma bóia de carregamento/descarregamento para uso em mar raso | Den Norske Stats Oljeselskap S | https://patents.google.com/patent/BR9509584A/pt
BR-9509380-A | Sistema de transporte e movimentação de carga baseado no mar | Dag O Aavitsland | https://patents.google.com/patent/BR9509380A/pt
BR-9501527-A | Processo e dispositivo para reduzir a um pequeno valor um movimento alternativo de acavalamento entre duas estruturas marinhas | Etpm Sa | https://patents.google.com/patent/BR9501527A/pt
BR-9400570-A | Disposição de ancoragem para embarcações em alto-mar | I P Huse A S | https://patents.google.com/patent/BR9400570A/pt
BR-9304020-A | Aperfeiçoamentos na composição estrutural de pranchas para surf de peito | Bernd Martin Reidl, Inducel Espumas Ind Ltda | https://patents.google.com/patent/BR9304020A/pt
BR-9205393-A | Plataforma de petróleo flutuante com movimento vertical controlável | Elf Aquitaine | https://patents.google.com/patent/BR9205393A/pt
BR-8904137-A | Plataforma flutuante estabilizada com colunas para utilizacao em aguas profundas,sistema estabilizador de massa adicionada para uso na retencao de uma plataforma flutuante estabilizada com colunas | Conoco Inc | https://patents.google.com/patent/BR8904137A/pt
BR-8800210-A | Aparelho para,em condicao operacional,aumentar a estabilidade e amortecer o movimento de uma embarcacao semi-submersivel | Goetaverken Arendal Ab | https://patents.google.com/patent/BR8800210A/pt
BR-8606854-A | Determinacao da estabilidade de estruturas flutuantes | British Petroleum Co Plc | https://patents.google.com/patent/BR8606854A/pt
BR-8603885-A | Estrutura flutuante,processo para manter a tracao constante e distancia selecionada constante e construcao de boia vergontea estabilizada para operacoes de alto mar | Fluor Corp | https://patents.google.com/patent/BR8603885A/pt
BR-8403513-A | Navio possuindo uma configuracao em secao geralmente quadrangular | Hitachi Shipbuilding Eng Co | https://patents.google.com/patent/BR8403513A/pt
BR-8307517-A | Dispositivo de hidroptero estabilizado por empenagem e veiculo nautico munido desse dispositivo | Daniel Elie Chaumette | https://patents.google.com/patent/BR8307517A/pt
BR-8301077-A | Barco de alta velocidade com exaustao pelo fundo do mesmo | Akira Ikeda | https://patents.google.com/patent/BR8301077A/pt
BR-8107757-A | Dispositivo destinado a ser colocado em um fluido em movimento | Cousteau Fond | https://patents.google.com/patent/BR8107757A/pt
BR-8008988-A | Sistema movimentador de tampa da escotilha | Kvarener Brug A S | https://patents.google.com/patent/BR8008988A/pt
BR-8001316-A | Dispositivo para compensar movimentos de inclinacoes em uma estrutura flutuante | Navire Cargo Gear Int Ab | https://patents.google.com/patent/BR8001316A/pt
BR-8001121-A | Boia aerotransportada largavel com desengatamento inercial | Thomson Csf | https://patents.google.com/patent/BR8001121A/pt
BR-7907866-A | Sistema estabilizador para uma embarcacao com cascos de navio | Varitrac Ag | https://patents.google.com/patent/BR7907866A/pt
BR-7905857-A | Processo de produzir corpos moldados de plastico espuma de uma densidade predeterminada | Bakelittfab As | https://patents.google.com/patent/BR7905857A/pt
BR-7802358-A | Sistema e processo para estabilizar uma embarcacao flutuante | Seatek Corp | https://patents.google.com/patent/BR7802358A/pt
BR-7801040-A | Dispositivos estabilizadores para um navio de superficie | Blehr & Tenvig As | https://patents.google.com/patent/BR7801040A/pt
BR-7600426-A | Sensor de cargas em amarracao | Imodco | https://patents.google.com/patent/BR7600426A/pt
BR-7503912-A | Dispositivo aperfeicoado para a limpeza de paredes de embarcacoes,paredes de recipientes ou superficies similares de material ferromagnetico | W Maasberg | https://patents.google.com/patent/BR7503912A/pt
