KlaussMarchi/MRU/Calibration/README.html

Ir para o conteúdo

M MRU Documentação técnica

Navegar pelas seções

Neste documento

Continue a leituraFirmware · ESP32-S3 ↗

Calibração · processamento offline

# Calibração do MRU

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

Imprimir / salvar PDF Abrir Markdown Firmware · ESP32-S3 ↗

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

## Visão geral

PREPARAR          TRATAR OS SENSORES          CALCULAR O MOVIMENTO          AVALIAR

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

## Onde ficam os arquivos

O campo test do info.json seleciona o ensaio. Para "test": 1, a estrutura de dados fica assim após executar o pipeline:

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

## O que executar, o que muda e para onde vai

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

Etapa e notebook | O que lê | O que faz com os dados | O que entrega → próximo uso
0 · Preparação Dataset/Format.ipynb | files/data.csv | Organiza os eixos e os instantes de amostragem, sem preencher falhas da gravação. Compensa o atraso entre MRU e referência para comparar o mesmo movimento no mesmo instante. Calcula também a velocidade de rotação da referência a partir de seus ângulos. | dataset.csv: ensaio preparado para os cálculos → Filters.
1 · Filtragem 1 - Filters/1 - Model.ipynb | dataset.csv | Escolhe um filtro por eixo do acelerômetro e giroscópio para reduzir pequenas oscilações de ruído. Considera também o atraso e a deformação que o filtro pode causar no movimento medido. | filtered.csv: sensores filtrados, com a versão sem filtro preservada em _raw → Correction.
2 · Correção 2 - Correction/1 - Model.ipynb | filtered.csv | Corrige erros persistentes de leitura: desvio de zero, escala e desalinhamento dos eixos. Ajusta o efeito da temperatura quando o ensaio permite. Calcula o ajuste sobre os sensores sem filtro e aplica às versões filtrada e sem filtro. | corrected.csv: aceleração e giro corrigidos nos eixos do navio → Attitude, Heave, Lever e Analysis.
3 · Atitude 3 - Attitude/<estratégia>/ | corrected.csv | Calcula ou calibra a orientação: roll é a inclinação lateral; pitch, a inclinação de proa/popa; yaw, a direção da proa. As estratégias disponíveis estão na tabela seguinte. | attitude.csv: ângulos estimados e referência, conforme as saídas da estratégia → Heave e Analysis.
4 · Heave 4 - Heave/1 - Model.ipynb | corrected.csv + attitude.csv | Usa a orientação para encontrar a aceleração vertical e descontar a gravidade. Transforma aceleração em velocidade e depois em deslocamento, com filtros para limitar o acúmulo de erro. Ajusta o cálculo contra a referência geométrica do ensaio. | heave.csv: subida/descida no local do MRU, em metros, com referência e termos auxiliares band_x/y/z → Lever.
5 · Braço de alavanca 5 - Lever/1 - Model.ipynb | heave.csv + ângulos da referência em corrected.csv | Calcula o movimento vertical em outro local, como o centro do helideque, usando a distância desse ponto ao MRU. Calcula também hr, a velocidade vertical no ponto, em m/s. | lever.csv: heave e hr no ponto escolhido, com suas referências → Analysis.
6 · Avaliação Analysis.ipynb | corrected.csv + attitude.csv + lever.csv | Reúne os resultados pelo tempo e mede o erro dos ângulos e do movimento vertical contra a referência, em repouso e em movimento. Para aceleração e giro, calcula métricas de ruído. | Certificate/results/<variável>/metrics.json e gráficos dos ângulos → Certificate.
7 · Certificado Certificate/1 - Certificate.ipynb | Métricas, gráficos e identificação do ensaio | Compara os resultados com os limites definidos no notebook e monta o documento com aprovação/reprovação. Atualmente, o PDF avalia roll/pitch e ruído dos sensores. | Certificate/release/certificate.pdf → documento final. As métricas de heave e hr ficam nos JSON.

## Como cada etapa funciona por dentro

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

### 0 · Format — preparar uma comparação válida

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

### 1 · Filters — quais filtros existem e como são escolhidos

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

Papel do “genético”. O notebook chama NatureSelector('genetic', ...). No seletor atual, esse nome aponta para a classe CMA-ES, implementada em Models/Genetic/index.py. Trata-se de uma estratégia evolutiva: gera uma população de parâmetros candidatos, avalia os resultados e adapta a distribuição dos próximos candidatos em direção às melhores regiões. Quando a busca estagna, pode reiniciar com uma população maior.

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

A escolha segue este processo:

1. Estimar movimento e ruído: o método de Welch mede como a energia do sinal se distribui pelas frequências no trecho em movimento. O código assume que o balanço ocupa poucas frequências; usa a mediana do espectro como piso de ruído e o excedente como estimativa do movimento.
2. Avaliar cada candidato: calcula ε, o erro RMS estimado após filtrar, dividido pelo erro estimado do sinal sem filtro. A conta penaliza tanto o ruído que sobrou quanto a parte do movimento que o filtro atenuou ou atrasou. É um critério espectral baseado nessa estimativa, não uma comparação direta com a mesa.
3. Buscar a frequência: a CMA-ES varia log10(fc), permitindo explorar frequências pequenas e grandes. A configuração atual usa população inicial de 30, generations = 150 — orçamento de até 4.500 avaliações por execução — e 5 execuções, com sementes 42 a 46, para cada combinação de filtro e eixo.
4. Escolher por eixo: entre os três filtros ajustados, fica o de menor ε. São 18 buscas, cada uma repetida cinco vezes. ε < 1 indica melhora estimada; próximo de 1, pouco ganho; acima de 1, piora estimada. A média exponencial pode chegar a α ≈ 1, praticamente deixando o sinal passar.

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

### 2 · Correction — montagem, escala, viés e temperatura

Uma leitura pode estar suave e continuar errada. Esta etapa procura corrigir esse erro persistente:

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

### 3 · Attitude — três maneiras de obter a orientação

Escolha uma estratégia dentro de 3 - Attitude/:

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

MachineLearning — aprender a partir de uma janela de sensores.

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

### 4 · Heave — integrar sem deixar o erro crescer indefinidamente

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

### 5 · Lever — calcular o movimento no helideque

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

heave_no_ponto = heave_no_MRU + dx·band_x + dy·band_y + dz·band_z

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

### 6 · Analysis — transformar diferenças em métricas

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

### 7 · Certificate — comparar com os requisitos e montar o PDF

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

## Como iniciar um ensaio

1. Grave MRU e mesa com Monitor/index.py, usando o MRU em aquisição (CF:device_mode$1!). Inclua repouso e movimento. O Monitor salva Monitor/output/<data_hora>/data.csv, com tempo, indicação de repouso (static), MRU (target_*) e referência (ref_*).
2. Copie data.csv para Dataset/testN/files/ e selecione esse número em Calibration/info.json. Confira também id, a identificação do MRU, e gravity, a gravidade local em m/s².
3. Em Dataset/testN/info.json, registre align: os ângulos configurados no Kernel durante o ensaio, em graus, na ordem [proa, pitch, roll]. O campo opcional axes remapeia dados de formatos antigos.
4. Execute os notebooks na ordem da tabela, com as células de cima para baixo e o diretório de trabalho na pasta de cada notebook.

## Como o ajuste chega ao equipamento

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

O diagrama geral do MRU contextualiza o sistema. O certificado usa os requisitos definidos no próprio notebook.

MRU / Calibration Voltar ao início ↑
