KlaussMarchi/MRU/Calibration/Certificate/release/certificate.pdf

# CERTIFICADO DE CALIBRAÇÃO

# MRU

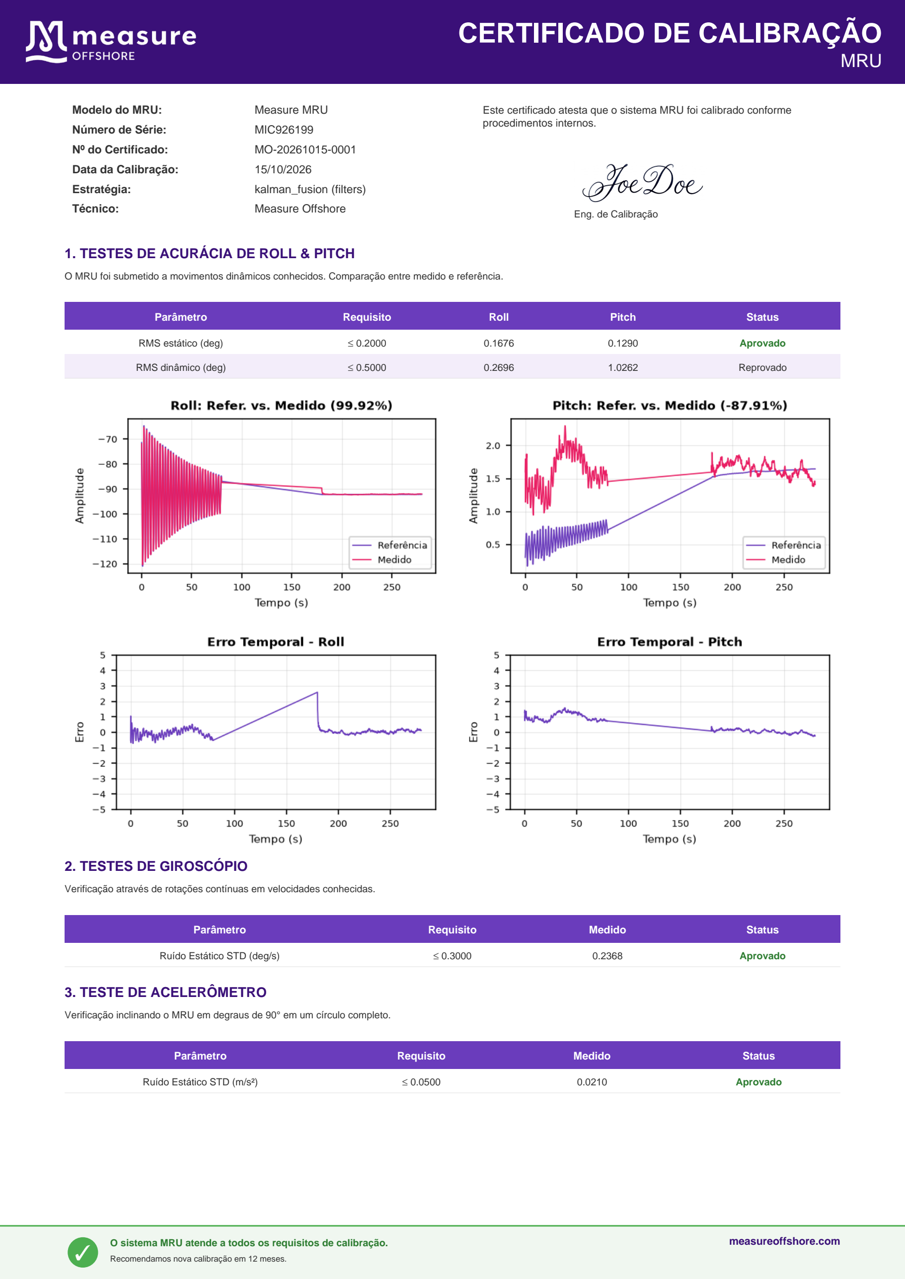
[picture p200: page 1]

Modelo do MRU: | Measure MRU
Número de Série: | MIC926199
Nº do Certificado: | MO-20261015-0001
Data da Calibração: | 15/10/2026
Estratégia: | kalman_fusion (filters)
Técnico: | Measure Offshore

Este certificado atesta que o sistema MRU foi calibrado conforme procedimentos internos.

Eng. de Calibração

## 1. TESTES DE ACURÁCIA DE ROLL & PITCH

O MRU foi submetido a movimentos dinâmicos conhecidos. Comparação entre medido e referência.

Parâmetro | Requisito | Roll | Pitch | Status
RMS estático (deg) | ≤ 0.2000 | 0.1676 | 0.1290 | Aprovado
RMS dinâmico (deg) | ≤ 0.5000 | 0.2696 | 1.0262 | Reprovado

## 2. TESTES DE GIROSCÓPIO

Verificação através de rotações contínuas em velocidades conhecidas.

Parâmetro | Requisito | Medido | Status
Ruído Estático STD (deg/s) | ≤ 0.3000 | 0.2368 | Aprovado

## 3. TESTE DE ACELERÔMETRO

Verificação inclinando o MRU em degraus de 90° em um círculo completo.

Parâmetro | Requisito | Medido | Status
Ruído Estático STD (m/s²) | ≤ 0.0500 | 0.0210 | Aprovado

✓

O sistema MRU atende a todos os requisitos de calibração.
Recomendamos nova calibração em 12 meses.

measureoffshore.com
