KlaussMarchi/MRU/Calibration/Documents/calibrations/certificate_Pendulum_Encoder_Kernel.pdf

# CERTIFICADO DE CALIBRAÇÃO

# MRU

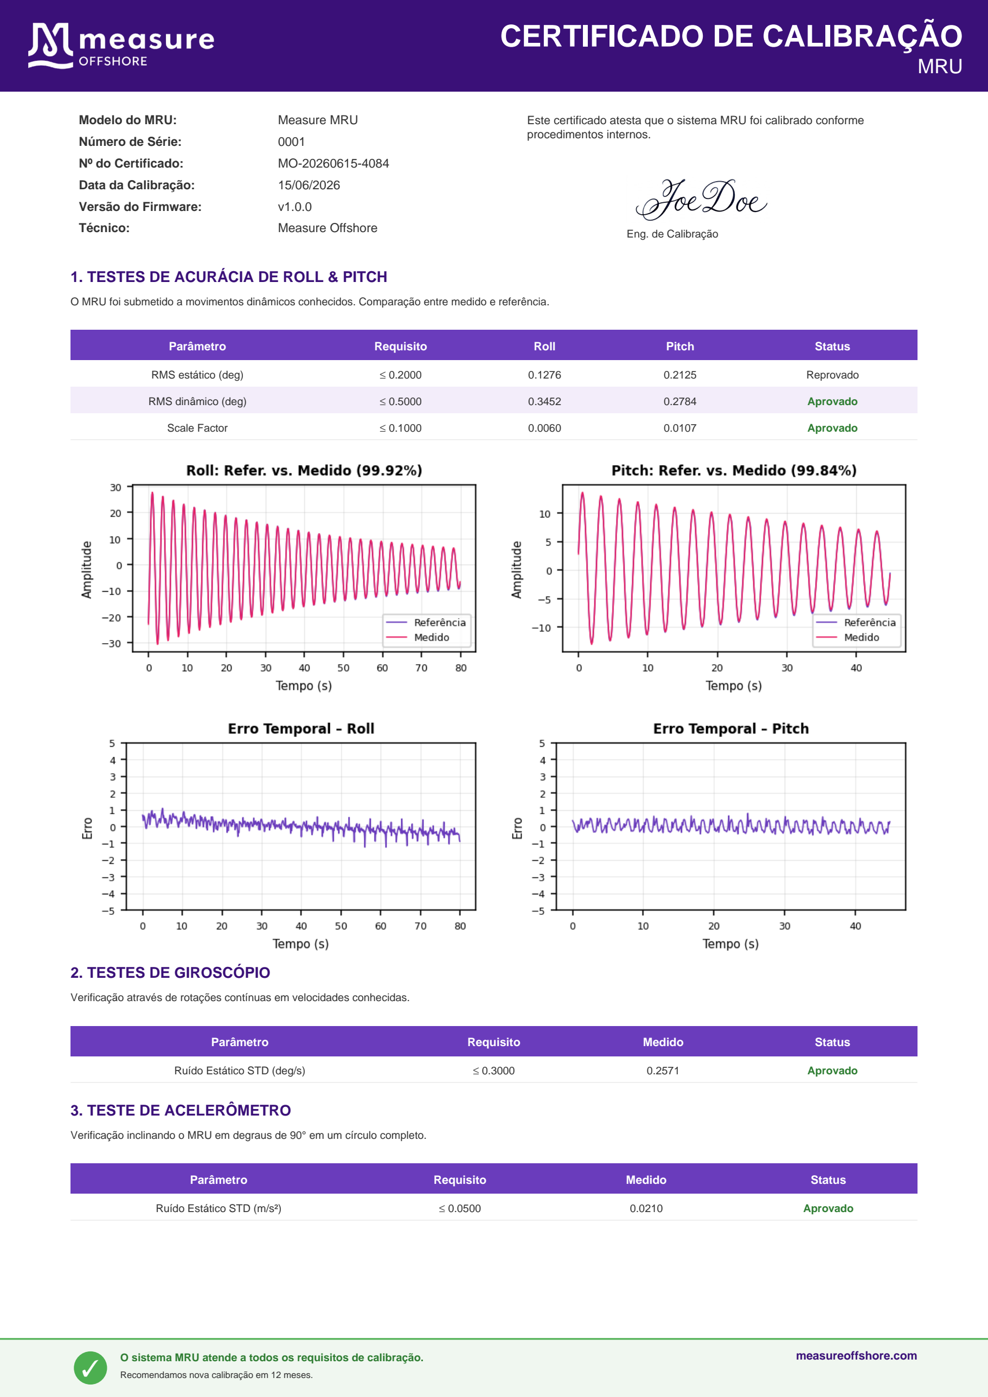
[picture p201: page 1]

Modelo do MRU: | Measure MRU
Número de Série: | 0001
Nº do Certificado: | MO-20260615-4084
Data da Calibração: | 15/06/2026
Versão do Firmware: | v1.0.0
Técnico: | Measure Offshore

Este certificado atesta que o sistema MRU foi calibrado conforme procedimentos internos.

Eng. de Calibração

## 1. TESTES DE ACURÁCIA DE ROLL & PITCH

O MRU foi submetido a movimentos dinâmicos conhecidos. Comparação entre medido e referência.

Parâmetro | Requisito | Roll | Pitch | Status
RMS estático (deg) | ≤ 0.2000 | 0.1276 | 0.2125 | Reprovado
RMS dinâmico (deg) | ≤ 0.5000 | 0.3452 | 0.2784 | Aprovado
Scale Factor | ≤ 0.1000 | 0.0060 | 0.0107 | Aprovado

## 2. TESTES DE GIROSCÓPIO

Verificação através de rotações contínuas em velocidades conhecidas.

Parâmetro | Requisito | Medido | Status
Ruído Estático STD (deg/s) | ≤ 0.3000 | 0.2571 | Aprovado

## 3. TESTE DE ACELERÔMETRO

Verificação inclinando o MRU em degraus de 90° em um círculo completo.

Parâmetro | Requisito | Medido | Status
Ruído Estático STD (m/s²) | ≤ 0.0500 | 0.0210 | Aprovado

✓

O sistema MRU atende a todos os requisitos de calibração.
Recomendamos nova calibração em 12 meses.

measureoffshore.com
