KlaussMarchi/MRU/Calibration/Documents/calibrations/certificate_Pendulum_Encoder_Kongsberg.pdf

# CERTIFICADO DE CALIBRAÇÃO

# MRU

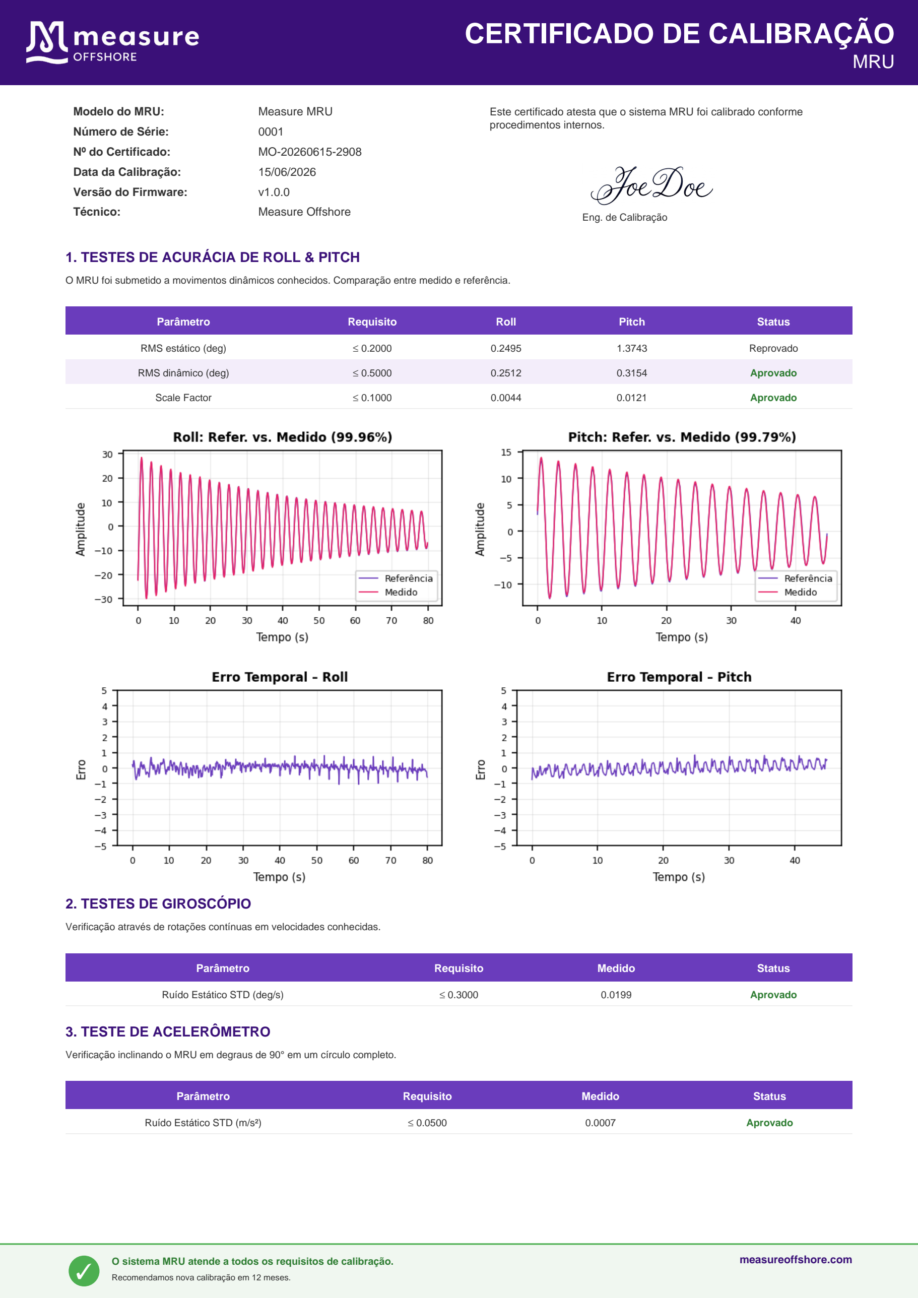
[picture p202: page 1]

Modelo do MRU: | Measure MRU
Número de Série: | 0001
Nº do Certificado: | MO-20260615-2908
Data da Calibração: | 15/06/2026
Versão do Firmware: | v1.0.0
Técnico: | Measure Offshore

Este certificado atesta que o sistema MRU foi calibrado conforme procedimentos internos.

Eng. de Calibração

## 1. TESTES DE ACURÁCIA DE ROLL & PITCH

O MRU foi submetido a movimentos dinâmicos conhecidos. Comparação entre medido e referência.

Parâmetro | Requisito | Roll | Pitch | Status
RMS estático (deg) | ≤ 0.2000 | 0.2495 | 1.3743 | Reprovado
RMS dinâmico (deg) | ≤ 0.5000 | 0.2512 | 0.3154 | Aprovado
Scale Factor | ≤ 0.1000 | 0.0044 | 0.0121 | Aprovado

## 2. TESTES DE GIROSCÓPIO

Verificação através de rotações contínuas em velocidades conhecidas.

Parâmetro | Requisito | Medido | Status
Ruído Estático STD (deg/s) | ≤ 0.3000 | 0.0199 | Aprovado

## 3. TESTE DE ACELERÔMETRO

Verificação inclinando o MRU em degraus de 90° em um círculo completo.

Parâmetro | Requisito | Medido | Status
Ruído Estático STD (m/s²) | ≤ 0.0500 | 0.0007 | Aprovado

✓

O sistema MRU atende a todos os requisitos de calibração.
Recomendamos nova calibração em 12 meses.

measureoffshore.com
