KlaussMarchi/MRU/Calibration/Certificate/images/image.png

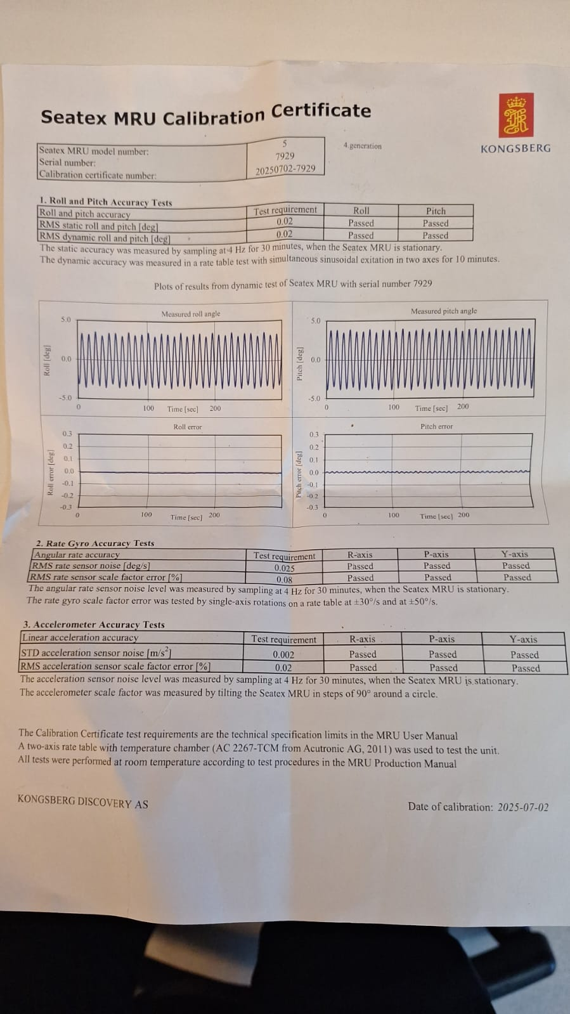
Calibration/Certificate/images/image.png
