KlaussMarchi/MRU/Calibration/Certificate/images/measure.png

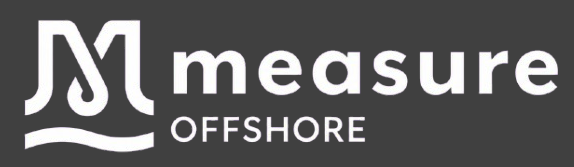
Calibration/Certificate/images/measure.png
