KlaussMarchi/MRU/Calibration/Certificate/images/signature.png

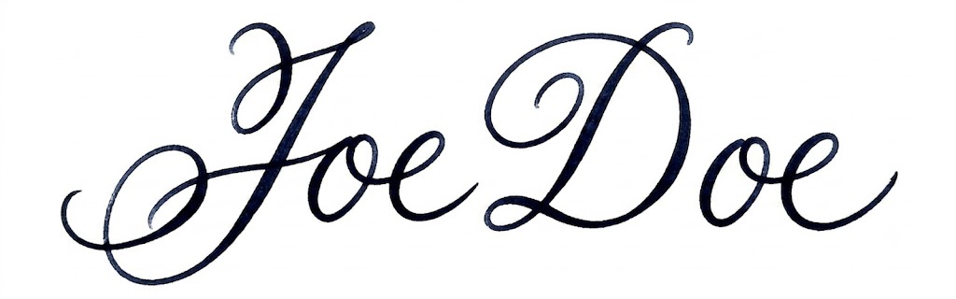
Calibration/Certificate/images/signature.png
