KlaussMarchi/MRU/Calibration/Certificate/results/pitch/error.png

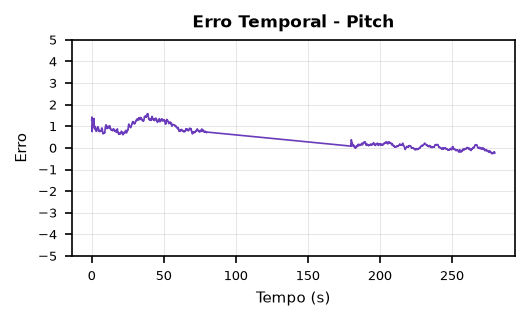
Calibration/Certificate/results/pitch/error.png
