KlaussMarchi/MRU/Calibration/Certificate/results/pitch/ref_vs_model.png

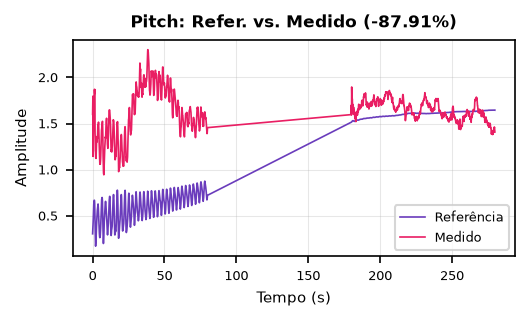
Calibration/Certificate/results/pitch/ref_vs_model.png
