KlaussMarchi/MRU/Calibration/Certificate/results/roll/error.png

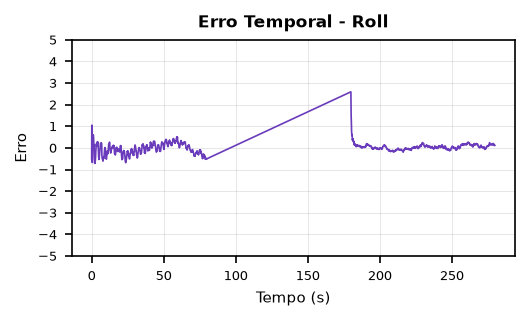
Calibration/Certificate/results/roll/error.png
