KlaussMarchi/MRU/Calibration/Certificate/results/roll/ref_vs_model.png

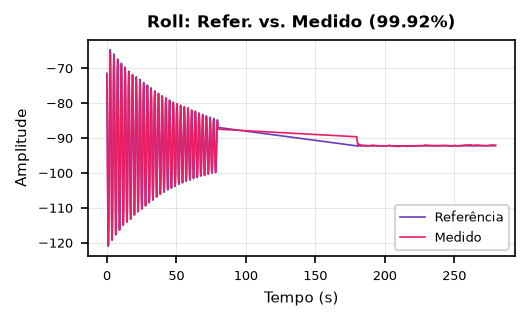
Calibration/Certificate/results/roll/ref_vs_model.png
