KlaussMarchi/MRU/Calibration/Certificate/results/yaw/error.png

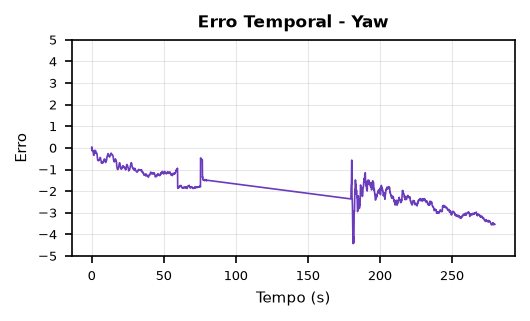
Calibration/Certificate/results/yaw/error.png
