KlaussMarchi/MRU/Calibration/Certificate/results/yaw/ref_vs_model.png

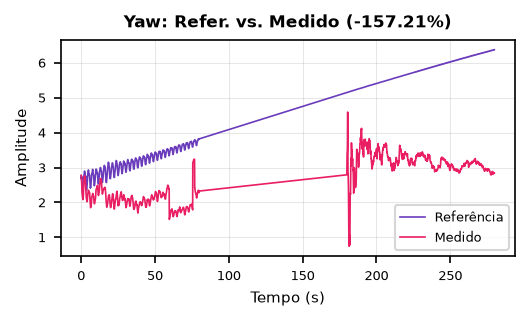
Calibration/Certificate/results/yaw/ref_vs_model.png
