KlaussMarchi/MRU/Calibration/Pendulum_Compare_MRU/Certificate/results/ax/error.png

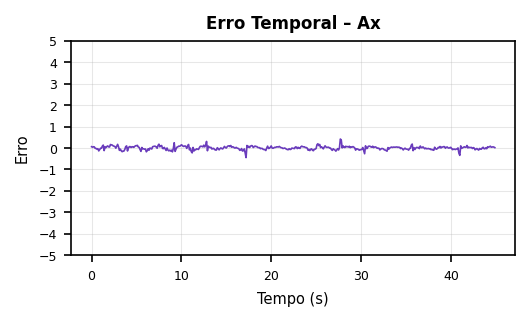
Calibration/Pendulum_Compare_MRU/Certificate/results/ax/error.png
