KlaussMarchi/MRU/Calibration/Pendulum_Compare_MRU/Certificate/results/az/error.png

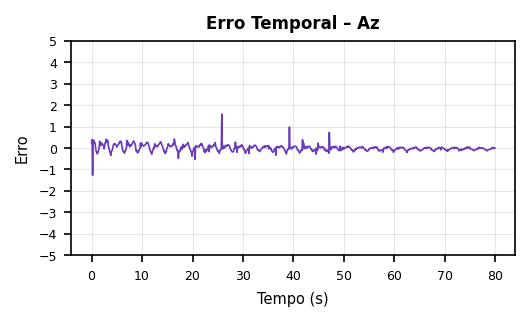
Calibration/Pendulum_Compare_MRU/Certificate/results/az/error.png
