KlaussMarchi/MRU/Calibration/Pendulum_Compare_MRU/Certificate/results/pitch/ref_vs_model.png

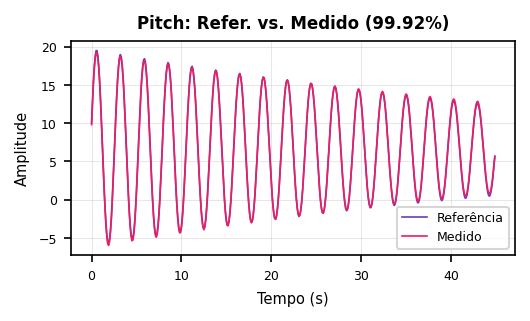
Calibration/Pendulum_Compare_MRU/Certificate/results/pitch/ref_vs_model.png
