KlaussMarchi/MRU/Calibration/Pendulum_Compare_MRU/Certificate/results/roll/error.png

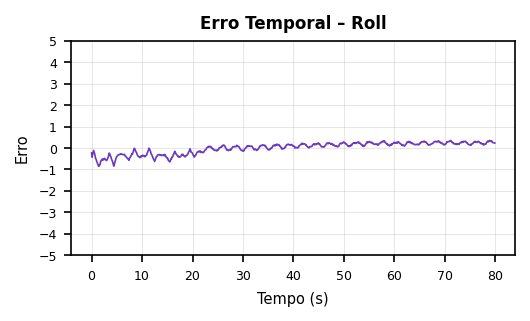
Calibration/Pendulum_Compare_MRU/Certificate/results/roll/error.png
