KlaussMarchi/MRU/Calibration/Pendulum_Compare_MRU/Certificate/results/roll/ref_vs_model.png

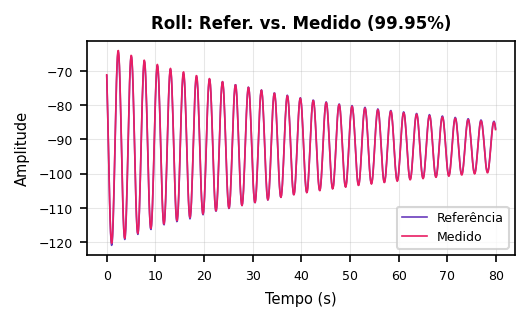
Calibration/Pendulum_Compare_MRU/Certificate/results/roll/ref_vs_model.png
