KlaussMarchi/MRU/Calibration/Pendulum_Compare_MRU/Certificate/results/wx/error.png

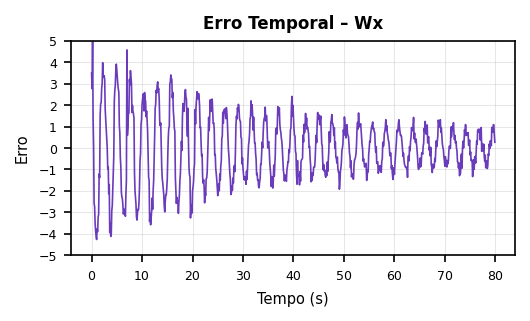
Calibration/Pendulum_Compare_MRU/Certificate/results/wx/error.png
