KlaussMarchi/MRU/Calibration/Pendulum_Compare_MRU/Certificate/results/wz/error.png

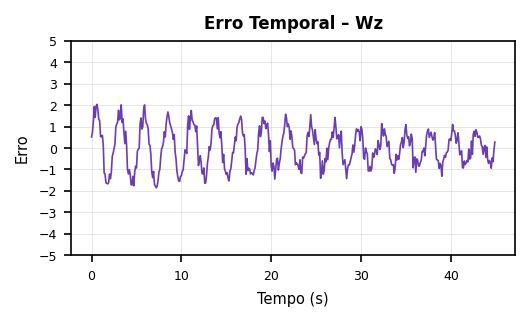
Calibration/Pendulum_Compare_MRU/Certificate/results/wz/error.png
