KlaussMarchi/MRU/Calibration/Pendulum_Encoder_Kernel/Certificate/results/ax/ref_vs_model.png

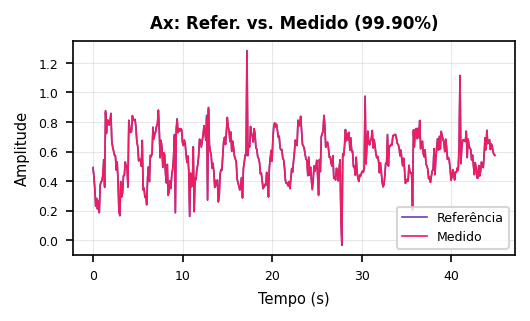
Calibration/Pendulum_Encoder_Kernel/Certificate/results/ax/ref_vs_model.png
