KlaussMarchi/MRU/Calibration/Pendulum_Encoder_Kernel/Certificate/results/pitch/error.png

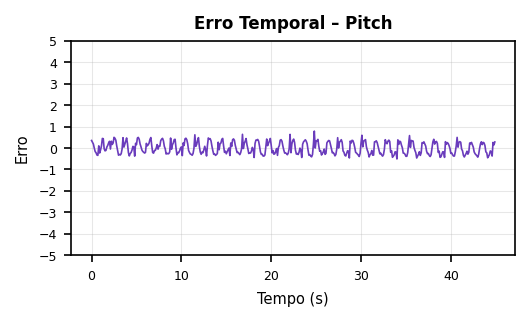
Calibration/Pendulum_Encoder_Kernel/Certificate/results/pitch/error.png
