KlaussMarchi/MRU/Calibration/Pendulum_Encoder_Kernel/Certificate/results/roll/error.png

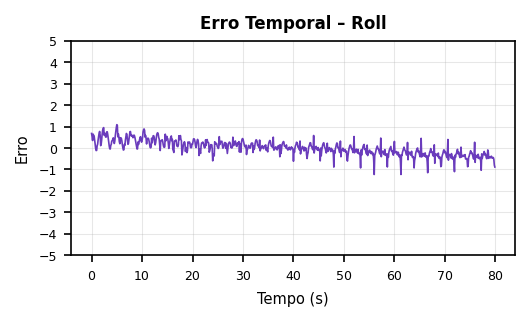
Calibration/Pendulum_Encoder_Kernel/Certificate/results/roll/error.png
