KlaussMarchi/MRU/Calibration/Pendulum_Encoder_Kernel/Certificate/results/roll/ref_vs_model.png

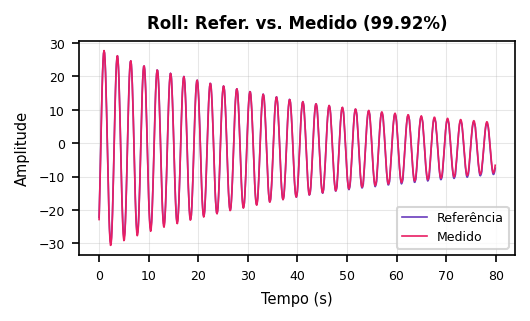
Calibration/Pendulum_Encoder_Kernel/Certificate/results/roll/ref_vs_model.png
