KlaussMarchi/MRU/Calibration/Pendulum_Encoder_Kernel/Certificate/results/wx/error.png

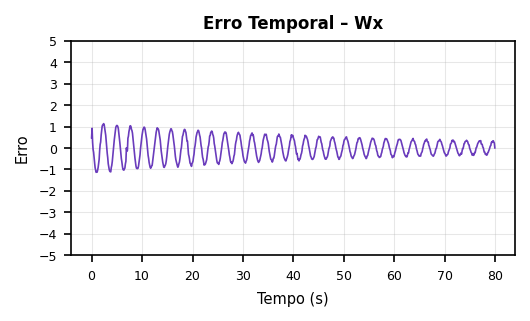
Calibration/Pendulum_Encoder_Kernel/Certificate/results/wx/error.png
