KlaussMarchi/MRU/Calibration/Pendulum_Encoder_Kernel/Certificate/results/wz/ref_vs_model.png

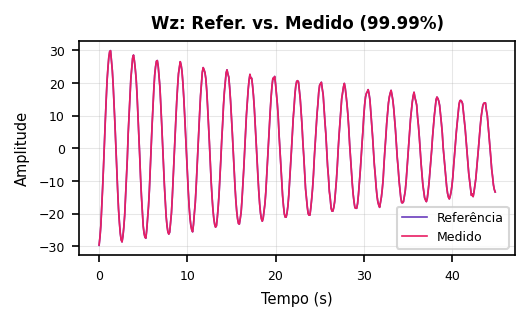
Calibration/Pendulum_Encoder_Kernel/Certificate/results/wz/ref_vs_model.png
