KlaussMarchi/MRU/Calibration/Pendulum_Encoder_Kongsberg/Certificate/results/pitch/ref_vs_model.png

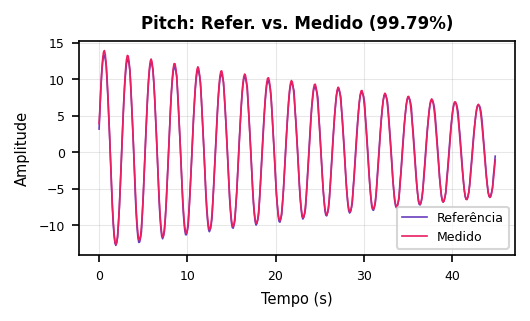
Calibration/Pendulum_Encoder_Kongsberg/Certificate/results/pitch/ref_vs_model.png
