KlaussMarchi/MRU/Calibration/Pendulum_Encoder_Kongsberg/Certificate/results/wz/error.png

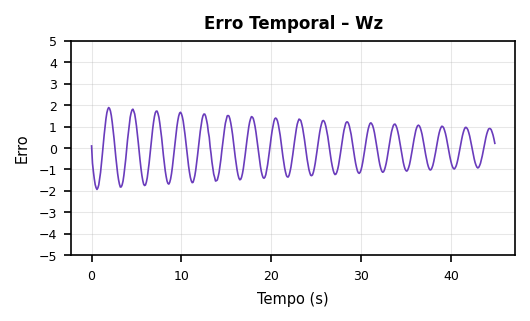
Calibration/Pendulum_Encoder_Kongsberg/Certificate/results/wz/error.png
