KlaussMarchi/MRU/Calibration/Table/Certificate/results/ax/ref_vs_model.png

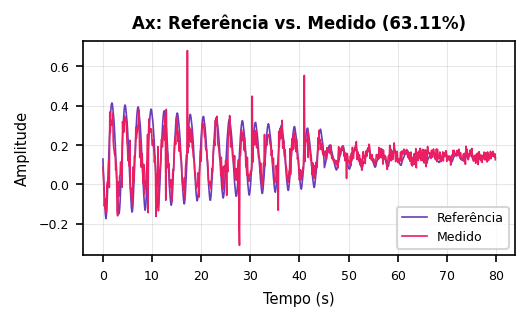
Calibration/Table/Certificate/results/ax/ref_vs_model.png
