KlaussMarchi/MRU/Calibration/Table/Certificate/results/az/error.png

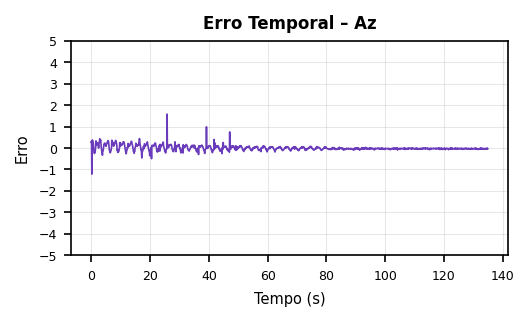
Calibration/Table/Certificate/results/az/error.png
