KlaussMarchi/MRU/Calibration/Table/Certificate/results/az/ref_vs_model.png

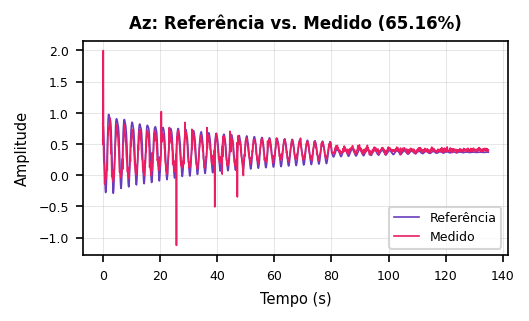
Calibration/Table/Certificate/results/az/ref_vs_model.png
