KlaussMarchi/MRU/Calibration/Table/Certificate/results/pitch/error.png

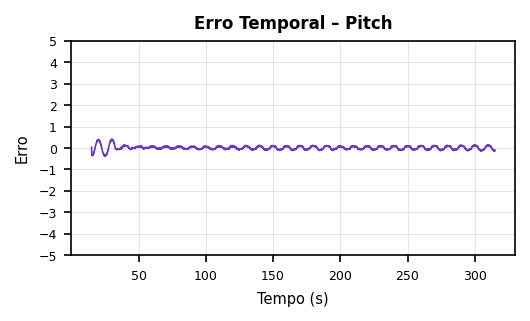
Calibration/Table/Certificate/results/pitch/error.png
