KlaussMarchi/MRU/Calibration/Table/Certificate/results/pitch/ref_vs_model.png

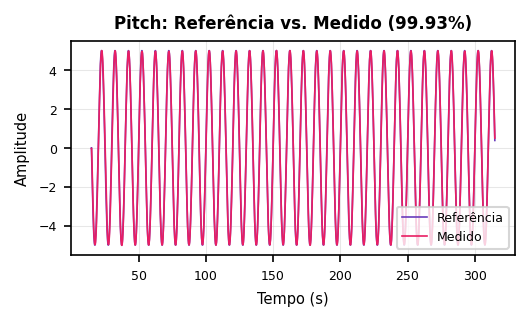
Calibration/Table/Certificate/results/pitch/ref_vs_model.png
