KlaussMarchi/MRU/Calibration/Table/Certificate/results/roll/error.png

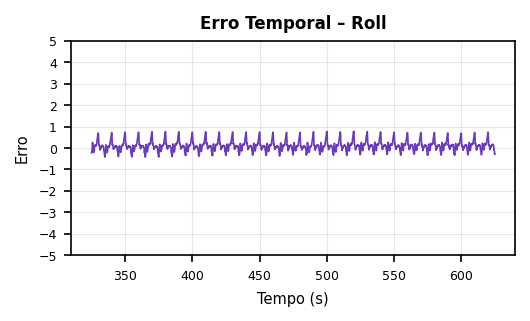
Calibration/Table/Certificate/results/roll/error.png
