KlaussMarchi/MRU/Calibration/Table/Certificate/results/roll/ref_vs_model.png

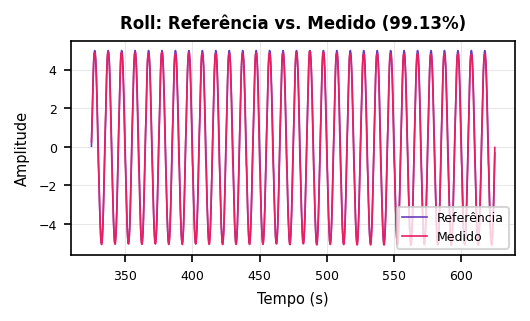
Calibration/Table/Certificate/results/roll/ref_vs_model.png
