KlaussMarchi/MRU/Calibration/Table/Certificate/results/wx/error.png

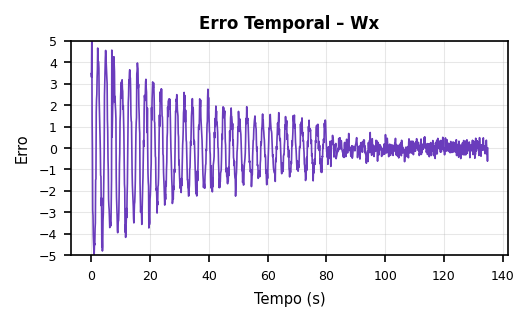
Calibration/Table/Certificate/results/wx/error.png
