KlaussMarchi/MRU/Calibration/Table/Certificate/results/wx/ref_vs_model.png

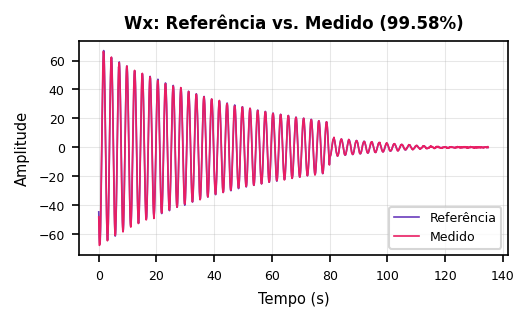
Calibration/Table/Certificate/results/wx/ref_vs_model.png
