KlaussMarchi/MRU/Calibration/Table/Certificate/results/wz/ref_vs_model.png

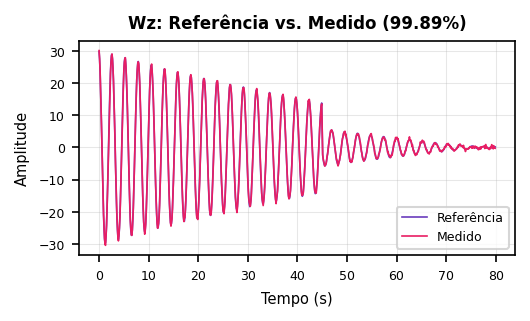
Calibration/Table/Certificate/results/wz/ref_vs_model.png
