KlaussMarchi/MRU/Hardware/Embedded/Main/objects/processing/attitude/machine/config.h

#ifndef MACHINE_CONFIG_H
#define MACHINE_CONFIG_H

// GERADO POR Calibration/3 - Attitude/MachineLearning/3 - Compare.ipynb EM 15/10/2026
#define MACHINE_NAME    "machine_learning (linear_regression)"
#define MACHINE_INPUTS  6
#define MACHINE_STATES  30
#define MACHINE_OUTPUTS 2
#define MACHINE_PERIOD  0.100000f

static const int MACHINE_SENSOR[6] = {0, 1, 2, 3, 4, 5};    // de onde cada bloco le em ['ax', 'ay', 'az', 'wx', 'wy', 'wz']
static const int MACHINE_TARGET[3] = {0, 1, -1};    // saida de pitch, roll e yaw (-1 fica com o angulo do sensor)

static const float MACHINE_MEAN[180] = {2.76829691e-01f, 2.76835711e-01f, 2.76832797e-01f, 2.76821262e-01f, 2.76813412e-01f, 2.76797015e-01f, 2.76790346e-01f, 2.76781439e-01f, 2.76784563e-01f, 2.76782283e-01f, 2.76772726e-01f, 2.76740390e-01f, 2.76713763e-01f, 2.76692280e-01f, 2.76692822e-01f, 2.76682193e-01f, 2.76689676e-01f, 2.76696145e-01f, 2.76715471e-01f, 2.76750970e-01f, 2.76776646e-01f, 2.76807045e-01f, 2.76844838e-01f, 2.76870756e-01f, 2.76888943e-01f, 2.76900392e-01f, 2.76884549e-01f, 2.76805472e-01f, 2.76791877e-01f, 2.76764195e-01f, 9.87833328e+00f, 9.87928445e+00f, 9.87973419e+00f, 9.87983006e+00f, 9.87960064e+00f, 9.87917128e+00f, 9.87877691e+00f, 9.87853728e+00f, 9.87867789e+00f, 9.87930837e+00f, 9.88028055e+00f, 9.88160525e+00f, 9.88302673e+00f, 9.88429986e+00f, 9.88526391e+00f, 9.88578238e+00f, 9.88583311e+00f, 9.88544169e+00f, 9.88478286e+00f, 9.88393748e+00f, 9.88333307e+00f, 9.88299578e+00f, 9.88320005e+00f, 9.88385885e+00f, 9.88490601e+00f, 9.88627912e+00f, 9.88770674e+00f, 9.88933890e+00f, 9.89029514e+00f, 9.89086865e+00f, 3.54812873e-01f, 3.54888658e-01f, 3.55013163e-01f, 3.55210287e-01f, 3.55455489e-01f, 3.55659939e-01f, 3.55843035e-01f, 3.56021035e-01f, 3.56168330e-01f, 3.56330468e-01f, 3.56408650e-01f, 3.56444963e-01f, 3.56375795e-01f, 3.56213982e-01f, 3.56093905e-01f, 3.55937349e-01f, 3.55733460e-01f, 3.55510354e-01f, 3.55297368e-01f, 3.55046196e-01f, 3.54807372e-01f, 3.54560210e-01f, 3.54316439e-01f, 3.54152123e-01f, 3.54093992e-01f, 3.54134903e-01f, 3.54391627e-01f, 3.54948279e-01f, 3.54969080e-01f, 3.55020644e-01f, -3.66034214e-02f, -6.15756255e-02f, -8.27697650e-02f, -9.97884272e-02f, -1.11213776e-01f, -1.17250546e-01f, -1.16439384e-01f, -1.09626324e-01f, -9.69453713e-02f, -7.82497979e-02f, -5.50167134e-02f, -2.89041300e-02f, -1.22783968e-03f, 2.79773710e-02f, 5.54493750e-02f, 7.97745556e-02f, 9.95715446e-02f, 1.14994404e-01f, 1.24370565e-01f, 1.26969137e-01f, 1.23296311e-01f, 1.12945062e-01f, 9.69444276e-02f, 7.55643666e-02f, 5.02017127e-02f, 2.18630519e-02f, -8.01681553e-03f, -3.91745896e-02f, -6.62089588e-02f, -8.95621964e-02f, -1.20180285e-02f, -1.15307049e-02f, -1.09315479e-02f, -1.04041945e-02f, -1.02788722e-02f, -9.98840881e-03f, -9.97887081e-03f, -1.00979199e-02f, -1.01135056e-02f, -1.01641618e-02f, -1.02803494e-02f, -1.04503234e-02f, -1.11065458e-02f, -1.17503775e-02f, -1.20525634e-02f, -1.23472459e-02f, -1.24877397e-02f, -1.25645615e-02f, -1.26244941e-02f, -1.26606048e-02f, -1.27385010e-02f, -1.28866255e-02f, -1.28338812e-02f, -1.25837130e-02f, -1.20830318e-02f, -1.16062456e-02f, -1.12085287e-02f, -1.08626885e-02f, -1.07795205e-02f, -1.06239242e-02f, 1.01483383e-04f, -2.16313118e-04f, -2.85131216e-04f, 1.47859165e-04f, 2.63446111e-04f, 1.49734893e-04f, 2.32609710e-04f, 5.13026778e-04f, 4.81755392e-04f, -1.28325366e-04f, -2.02479072e-04f, -6.01782997e-04f, -8.80228358e-04f, -2.74723134e-03f, -3.10946285e-03f, -3.33627292e-03f, -3.36946719e-03f, -3.27462523e-03f, -2.83926361e-03f, -2.37031143e-03f, -1.98243495e-03f, -1.75866520e-03f, -1.70500665e-03f, -1.31687082e-03f, -1.14274243e-03f, -1.07029198e-03f, -7.82537063e-04f, -8.12141054e-04f, -2.58095064e-04f, 3.67566156e-04f};

static const float MACHINE_SCALE[180] = {2.10468301e-02f, 2.10573228e-02f, 2.10590521e-02f, 2.10605141e-02f, 2.10584766e-02f, 2.10637693e-02f, 2.10651603e-02f, 2.10668520e-02f, 2.10666767e-02f, 2.10670519e-02f, 2.10702621e-02f, 2.11093619e-02f, 2.11348609e-02f, 2.11459920e-02f, 2.11456339e-02f, 2.11461034e-02f, 2.11438269e-02f, 2.11455190e-02f, 2.11532887e-02f, 2.11784372e-02f, 2.12021939e-02f, 2.12414800e-02f, 2.12943965e-02f, 2.13114379e-02f, 2.13168487e-02f, 2.13203565e-02f, 2.13482068e-02f, 2.16713645e-02f, 2.16943259e-02f, 2.17512790e-02f, 4.07388408e-01f, 4.09217052e-01f, 4.09617735e-01f, 4.09615358e-01f, 4.09804265e-01f, 4.10300502e-01f, 4.10758455e-01f, 4.10860888e-01f, 4.10919540e-01f, 4.11806014e-01f, 4.13943354e-01f, 4.17682501e-01f, 4.21872049e-01f, 4.25149249e-01f, 4.26866882e-01f, 4.27250518e-01f, 4.27228273e-01f, 4.27795349e-01f, 4.29188429e-01f, 4.30991877e-01f, 4.32037279e-01f, 4.32360947e-01f, 4.32408369e-01f, 4.33365994e-01f, 4.35723469e-01f, 4.39765983e-01f, 4.44017654e-01f, 4.49147423e-01f, 4.50793327e-01f, 4.51233294e-01f, 1.38158206e-01f, 1.38258231e-01f, 1.38495792e-01f, 1.38945187e-01f, 1.39545098e-01f, 1.39968160e-01f, 1.40351753e-01f, 1.40683101e-01f, 1.40937547e-01f, 1.41132605e-01f, 1.41193630e-01f, 1.41199278e-01f, 1.41260067e-01f, 1.41517325e-01f, 1.41702924e-01f, 1.41994434e-01f, 1.42384768e-01f, 1.42879595e-01f, 1.43345506e-01f, 1.43864666e-01f, 1.44390685e-01f, 1.44899593e-01f, 1.45336062e-01f, 1.45510568e-01f, 1.45528892e-01f, 1.45549565e-01f, 1.46039095e-01f, 1.48236366e-01f, 1.48247921e-01f, 1.48286299e-01f, 1.76627609e+01f, 1.77106936e+01f, 1.77441715e+01f, 1.77641026e+01f, 1.77718334e+01f, 1.77725850e+01f, 1.77729047e+01f, 1.77790677e+01f, 1.77972475e+01f, 1.78304022e+01f, 1.78786959e+01f, 1.79375649e+01f, 1.80011691e+01f, 1.80678955e+01f, 1.81237788e+01f, 1.81662101e+01f, 1.81926710e+01f, 1.82055463e+01f, 1.82084423e+01f, 1.82079504e+01f, 1.82106353e+01f, 1.82230696e+01f, 1.82494808e+01f, 1.82918483e+01f, 1.83471097e+01f, 1.84122323e+01f, 1.84793905e+01f, 1.85473698e+01f, 1.85977811e+01f, 1.86324661e+01f, 2.08412019e-01f, 2.08955703e-01f, 2.09191559e-01f, 2.09462361e-01f, 2.09515243e-01f, 2.09682499e-01f, 2.09750136e-01f, 2.09991670e-01f, 2.10121151e-01f, 2.10361306e-01f, 2.10616035e-01f, 2.11176195e-01f, 2.13304673e-01f, 2.16136651e-01f, 2.16399992e-01f, 2.16708989e-01f, 2.16838481e-01f, 2.16702728e-01f, 2.16704214e-01f, 2.16719744e-01f, 2.16633511e-01f, 2.16604318e-01f, 2.16838609e-01f, 2.17246941e-01f, 2.18246249e-01f, 2.19528650e-01f, 2.20116236e-01f, 2.21097785e-01f, 2.21219341e-01f, 2.21619001e-01f, 3.14760179e-01f, 3.14772438e-01f, 3.14725565e-01f, 3.14651319e-01f, 3.14653786e-01f, 3.14910410e-01f, 3.14872720e-01f, 3.14662053e-01f, 3.14678550e-01f, 3.14728321e-01f, 3.14720563e-01f, 3.15658967e-01f, 3.15779544e-01f, 3.23403838e-01f, 3.23862423e-01f, 3.23997522e-01f, 3.23978399e-01f, 3.23886361e-01f, 3.24065290e-01f, 3.24314407e-01f, 3.24664226e-01f, 3.24614751e-01f, 3.24654129e-01f, 3.25315993e-01f, 3.25666339e-01f, 3.26011328e-01f, 3.26467285e-01f, 3.26438916e-01f, 3.26457085e-01f, 3.26856041e-01f};

static const float MACHINE_COEF[2][180] = {
	{-3.05770683e-02f, -1.47146298e-03f, -4.44095417e-03f, -2.16651083e-03f, -6.36058719e-03f, -4.62560472e-03f, -6.92027630e-03f, -3.83369392e-03f, -9.15030697e-03f, -3.34399774e-03f, -6.25151961e-03f, -7.72612695e-03f, -6.57010375e-03f, -4.39061645e-03f, -3.17098057e-03f, -6.68529891e-03f, -6.37972952e-03f, -8.10136981e-03f, -7.57557731e-03f, -7.47561026e-03f, -6.54303133e-03f, -3.39537455e-03f, -4.74163273e-03f, -4.10596270e-03f, -5.07496529e-03f, -3.80599635e-03f, 3.42585033e-03f, -1.53540372e-03f, -6.39410343e-03f, -1.02623859e-02f, -5.14262139e-02f, -4.86257152e-02f, -4.79146320e-02f, -3.61838380e-02f, -3.11751516e-02f, -2.43587074e-02f, -2.51867285e-02f, -2.58919576e-02f, -1.51761706e-02f, -1.08804964e-02f, -2.01145919e-02f, -2.37915865e-02f, -1.73837363e-02f, -2.03097404e-02f, -5.38217598e-03f, -4.87284228e-03f, 1.27130567e-04f, -3.64839839e-03f, -1.61507410e-02f, -1.96655061e-02f, -1.98302803e-02f, -2.14174836e-02f, -1.54475765e-02f, -2.72793096e-02f, -3.53572320e-02f, -1.95728544e-02f, 8.13863580e-04f, 1.68290104e-02f, 9.78726268e-03f, 8.38855084e-03f, 2.52003545e-02f, 1.94725608e-02f, 1.86331983e-02f, 1.41659047e-02f, 3.08509129e-02f, 2.36500635e-02f, 2.77145001e-02f, 2.94091086e-02f, 2.53589102e-02f, 3.86570691e-02f, 3.24519055e-02f, 3.41359274e-02f, 3.41273794e-02f, 2.60392012e-02f, 3.15113907e-02f, 3.08326332e-02f, 2.82290726e-02f, 3.30275553e-02f, 3.87432579e-02f, 3.82730552e-02f, 3.97720151e-02f, 4.12364952e-02f, 3.41112339e-02f, 4.14957513e-02f, 3.36942575e-02f, 3.81427401e-02f, 2.44604095e-02f, 4.80267005e-02f, 2.92561601e-02f, 6.66449344e-02f, -1.77654338e-01f, -6.27523088e-02f, 9.02543008e-02f, 1.89746732e-01f, 3.65947439e-02f, -5.10279413e-02f, 1.44071350e-02f, -1.37891520e-01f, -5.56393966e-02f, -1.69912975e-03f, -1.29377211e-01f, -1.67607968e-01f, -1.26852864e-01f, -8.27884343e-02f, 3.79221759e-02f, -3.26537474e-02f, 3.02280079e-02f, 6.97520932e-02f, 1.29739676e-02f, 1.57366118e-02f, 4.28522543e-02f, -2.19759367e-02f, -3.96500060e-02f, -1.90733958e-01f, -1.56566155e-01f, -5.50299113e-02f, 2.07314646e-02f, -8.25183922e-02f, -2.00615150e-02f, -4.22580679e-03f, 5.96351504e-03f, 2.44162021e-03f, 2.50392158e-03f, -3.70387052e-04f, 1.86868690e-03f, 4.55705517e-03f, 8.19078689e-04f, 1.81876357e-03f, 6.29820270e-03f, 4.68427520e-03f, 2.56346903e-03f, 3.95556380e-03f, 3.39959218e-03f, 2.29054397e-03f, 4.91179224e-03f, 2.01992566e-03f, -2.93944238e-04f, -4.07956711e-03f, -1.07945738e-03f, -3.39440773e-03f, -5.00668551e-05f, -2.53724501e-03f, -6.54551585e-04f, -3.12453747e-03f, -1.45526113e-03f, 9.74036991e-04f, -3.39256305e-03f, -3.44160545e-03f, -2.56551051e-03f, -1.13066222e-03f, 1.11796502e-02f, 1.06868647e-02f, 1.25425178e-02f, 1.15555036e-02f, 1.01876524e-02f, 7.52640500e-03f, 6.27080464e-03f, 3.70755654e-03f, 2.54635554e-03f, 1.12488665e-03f, 1.98903030e-03f, 4.64914963e-03f, 3.89098366e-03f, 4.42319821e-03f, 4.88930992e-03f, 8.21897085e-03f, 5.05204018e-03f, 4.10494476e-03f, 3.91676629e-03f, 4.02141863e-03f, 2.63747306e-03f, 3.68709846e-03f, 2.72753615e-03f, 1.77018690e-03f, 2.40627321e-03f, 1.63639360e-03f, 2.28192540e-03f, 2.07353541e-03f, 4.94635112e-03f, 6.70119461e-03f},
	{2.26510178e-02f, -1.70376207e-03f, 1.12029510e-03f, 6.03661618e-04f, 2.38010499e-03f, 9.82335812e-04f, 1.00042895e-03f, 2.15768867e-03f, 1.38247737e-03f, 1.73027670e-03f, -3.60134315e-04f, 1.09775662e-03f, 4.44701918e-04f, 2.48147748e-03f, 1.01268851e-03f, 3.96183624e-03f, 3.32201622e-03f, 4.60829406e-03f, 2.17469732e-03f, -1.54519048e-03f, 5.71153316e-03f, -3.35264440e-03f, 1.47486146e-03f, 3.68335603e-03f, 2.43708620e-03f, 3.54139500e-03f, -7.64674592e-04f, 2.92293311e-03f, 4.70793203e-03f, 1.13018050e-02f, -1.30285449e-02f, 4.39421173e-03f, 1.31271809e-02f, 6.59847264e-03f, -4.99937729e-03f, 2.87148913e-03f, 1.19633134e-02f, 9.81467214e-03f, -3.13901773e-03f, 3.57780816e-04f, 1.59343526e-02f, 1.70072622e-02f, 1.00014399e-02f, 1.12813650e-02f, 6.88487095e-03f, 1.18890234e-03f, -4.59817277e-04f, -2.06586576e-03f, 8.96014515e-03f, 5.28173190e-03f, 2.72086599e-03f, -1.15172078e-02f, -2.02991442e-02f, -1.38510077e-02f, -2.00430925e-03f, -4.54440781e-03f, -7.61012756e-03f, -1.33029892e-02f, -1.79786379e-02f, -4.33961317e-02f, -1.69283229e-02f, -1.76777584e-02f, -1.37864125e-02f, -9.38913222e-03f, -1.63028396e-02f, -9.37315665e-03f, -1.09530860e-02f, -8.78246264e-03f, -1.02140094e-02f, -1.12694506e-02f, -8.80508336e-03f, -1.22075620e-02f, -1.72280249e-02f, -9.39426717e-03f, -1.58758927e-02f, -1.17187360e-02f, 3.79399590e-04f, -8.85886963e-03f, -6.79217300e-03f, -1.04155823e-02f, -4.28193682e-03f, -1.58752971e-02f, -6.33801725e-04f, -1.07529819e-02f, -5.70217866e-03f, -1.37196753e-02f, -1.51282791e-02f, -1.45191715e-02f, -1.05389317e-02f, -2.19871382e-02f, -6.47233970e-02f, 4.82307824e-01f, 9.60179157e-01f, 1.20284257e+00f, 1.48234851e+00f, 1.59807371e+00f, 1.56206128e+00f, 1.58989474e+00f, 1.38621660e+00f, 1.17251419e+00f, 1.07730684e+00f, 9.09758282e-01f, 6.41731738e-01f, 4.18720698e-01f, 1.67655274e-01f, 1.38209695e-01f, 1.39560162e-01f, 1.56595722e-01f, 3.26256437e-01f, 4.25365807e-01f, 4.27653335e-01f, 4.21899734e-01f, 4.17999623e-01f, 4.32431536e-01f, 3.81986496e-01f, 3.14596569e-01f, 1.84224556e-01f, 4.19847488e-02f, -3.19523534e-01f, -7.35523641e-01f, -3.57235953e-03f, -3.79978079e-03f, -4.96632277e-03f, -5.14938016e-03f, -6.04695902e-03f, -7.09949341e-03f, -3.54763497e-03f, -2.49068046e-03f, -5.41361248e-03f, -3.59227458e-03f, -5.46969905e-04f, -9.79858748e-04f, -2.10139811e-03f, 5.37251248e-04f, -3.10648318e-03f, -2.95402835e-03f, -4.21848396e-03f, -1.92779254e-03f, -1.77811275e-03f, -1.09585062e-03f, 1.79007801e-03f, 2.83861414e-03f, 1.33752216e-03f, 2.40657891e-03f, 5.70193248e-03f, 3.24047210e-03f, 5.39606824e-03f, 6.10992983e-03f, 4.54120852e-03f, 1.00311948e-02f, -6.85613439e-03f, -5.21484362e-03f, -4.38461143e-03f, -2.18979014e-03f, -7.14899406e-04f, -8.27836883e-05f, 1.96013332e-03f, 6.48782419e-04f, 6.25910633e-04f, 6.88335923e-04f, 1.00959261e-03f, -2.50071331e-04f, 5.56296485e-04f, 6.42084508e-04f, -2.96571121e-04f, -9.14439979e-04f, -7.01552066e-04f, 6.08720922e-04f, 8.26308336e-05f, 4.74193500e-04f, 9.57635488e-04f, 1.25597186e-03f, 9.62899194e-05f, 6.06957701e-05f, 9.61322821e-05f, -2.55061565e-03f, -9.33490644e-04f, -2.66170435e-03f, -2.35097711e-03f, -2.44155458e-03f}
};

static const float MACHINE_BIAS[2] = {1.16667400e+00f, -9.21287191e+01f};

#endif
