KlaussMarchi/MRU/Hardware/Embedded/Main/objects/processing/config.h

#ifndef PROCESSING_CONFIG_H
#define PROCESSING_CONFIG_H
#include "models/kalman/index.h"

// GERADO POR Calibration/Model/KalmanFusion/1 - Model.ipynb EM 23/09/2026
using ProcessingModel = KalmanModel;

#endif
