KlaussMarchi/MRU/(commit log)

2025-02-10 adicionado patentes
    [DataBase.xlsx]
2025-02-10 adição do codigo corrigido do MPU6050
    [DataBase.csv]
2025-02-13 adicao de README
2025-02-23 reestruturação das pastas
    [DataBase.csv, DataBase.xlsx, Esquematico.xlsx]
2025-02-24 adicionado filtro de laplace
2025-02-25 correção de pyenv
2025-02-25 melhorias no código de hardware
2025-04-11 fusão de filtros implementada
    [DataBase.csv, DataBasee.csv, Filters.xlsx]
2025-04-24 adicionado melhorias significativas no fusion de sensores
    [DataBase.csv]
2025-05-14 análise amplamente melhorada, muitas melhorias
    [DataBase.csv, DataBasee.csv, Filters.xlsx]
2025-05-21 reorganização de pastas
    [DataBase.csv, Filters.xlsx]
2025-05-31 push before esp32 changes
2025-06-09 raspberry pi pico adicionado
2025-06-13 adicionado PICO 2
    [DataBase.csv]
2025-06-16 pico2 threading complete
2025-06-23 bugs de raspberry pico travando corrigido
    [DataBase.csv]
2025-06-25 escalas convertidas
    [DataBase.csv]
2025-06-25 filtro de covariance intersection adicionado
    [DataBase.csv]
2025-06-26 mru melhorado com pitch roll e yaw
    [DataBase.csv]
2025-06-26 pitch, roll e yaw corretos agora
2025-07-01 implementado kernel sensor
    [DataBase.csv]
2025-07-23 push conflict resolved
    [DataBase.csv]
2025-08-05 correção de bugs
2025-08-28 adicionado ESP32S3
2025-08-28 esp32s3 adicionado
2026-02-13 adicionado motion e tudo fechado com bugs resolvidos
    [Encoder.ino, Main.ino, constants.h, index.h, index.py]
2026-03-05 atualizações gerais de funcionamento
2026-04-07 melhorias antes de colocar kernel em classes
2026-04-27 adicionado melhorias de processamento para interoplação linear no pitch roll e yaw
2026-05-05 relatorio de calibracao adicioonado
2026-05-11 codigo parou de funcionar
2026-05-14 melhorado calibration new
2026-05-14 melhorias simples encoder
2026-05-29 melhorias substanciais no que concerne aos calculos de pitch roll e yaw
2026-06-07 testando mru com plate do ray
2026-06-09 calibration2 melhorado
2026-06-09 melhorias calibration2
2026-06-11 push antes de pedir ao claude para melhorar
2026-06-15 melhorias organização pasta calibration
2026-06-15 Fix cubic extrapolation bugs in temporal synchronization (Phaser)
    [NMEA.py, index.h, index.py]
2026-06-26 tentando comitar antes de usar o RS232 da leticia
2026-06-26 fix(serial): move RS232 to UART0 to resolve UART1 conflict with Kernel sensor
    RS232 (NextSerial::rs232) and the Kernel IMU sensor both instantiated
    HardwareSerial(1), i.e. the SAME UART1 peripheral. In device.setup()
    sensors.setup() runs after telemetry.setup(), so the Kernel's
    begin(115200, rx=3, tx=4) re-mapped UART1 on top of the RS232 config
    (9600, rx=10, tx=11), leaving GPIO10/11 dead in both directions.
    ESP32-S3 exposes 3 UARTs and `Serial` is USB-CDC (HWCDC), so UART0 is
    free. Assign RS232->UART0, keep RS422->UART2, leave Kernel on UART1.
    Each serial device now owns a distinct peripheral. This is why the
    isolated testes.ino (which only ever opened UART1) worked while Main
    did not.
    C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
    [index.h]
2026-06-26 fix(serial): make initial port match default uart (&rs232 -> port 3)
    The constructor set uart=&rs232 but port=1 (USB). Since the USB branch in
    listen() is guarded by `port != 1`, it could never latch USB input while
    port stayed 1, and the first RS232 command always triggered a redundant
    "port changed to 3" switch. Default port=3 so the boot state is internally
    consistent and every source can be selected from the first command.
    [index.h]
2026-06-26 fix(serial): compile-time guard tying RS232/UART0 to USB-CDC-on-boot
    RS232 sits on UART0, which is only free because `Serial` is the USB-CDC
    (HWCDC) console on the ESP32-S3. If someone sets "USB CDC On Boot" to
    Disabled, `Serial` becomes UART0 and silently collides with RS232. Add a
    preprocessor guard that fails the build with a clear message in that case,
    turning a silent runtime failure into an explicit compile-time error.
    [index.h]
2026-07-07 antes de usar fable
2026-09-22 reestruturação com novo calibration
    [DataBase.xlsx, Esquematico.xlsx]
2026-09-29 tentativa de melhorar table motor.ino
2026-10-16 melhorias no pipeline de calibração e reestruturação
2026-10-20 pipeline de calibração
2026-11-07 melhorias no software de monitoramento
